baumann06/Diplomarbeit_Sicherung_Privat/Diplomarbeit/4_KiCad/Diplomarbeit/Diplomarbeit/report.txt

Aktualisiere Symbol BAT1 von "BATTERIE_AGM_Super_Cycle_100Ah:Battery_AGM_100Ah" nach "BATTERIE_AGM_Super_Cycle_100Ah:Battery_AGM_100Ah": OK
