baumann06/Diplomarbeit_Sicherung_Privat/Diplomarbeit/11_Praesentation/Energiesystem_Praesentation.pptx

☀

🔋

Energiesystem

Hybrides 12-V-PV-Energiesystem
für einen Gewächshausprototyp

Kapitel 2

Diplomarbeit · HTL Anichstraße · 5. Jahrgang

Notes: Begrüßung: Mein Name ist [Name]. Ich präsentiere Kapitel 2 meiner Diplomarbeit: das hybride 12-V-Energiesystem für unseren Gewächshausprototyp. In den nächsten 7 Minuten erkläre ich: Warum PV-Hybrid? Wie haben wir dimensioniert? Welche Komponenten und Batterietechnologien wurden gewählt? Und lohnt sich das wirtschaftlich?

## Slide 2

Systemüberblick & Energiequellenwahl

Kap. 2.1 · 2.2 · 2.2.3

Energiesystem · Kap. 2

☀ PV-Modul
180 W · 12 V

Warum PV-Hybrid?

Wärmepumpe / Biomasse / Fernwärme

Kein Strom – ungeeignet

✗

Netz-
Backup

⚡ Victron MultiPlus
12/800 (WR + Ladegerät)

MPPT

🔋 AGM Batterie
100 Ah · 12 V

~

Kleinwindanlage

Genehmigungspflichtig, standortabhängig

✗

🌿 Gewächshaus
Sensorik · Pumpen · LEDs

📡 Cerbo GX
Monitoring · MQTT

Reiner Netzbezug

Höhere Betriebskosten, keine Eigenproduktion

≈

PV-Hybridsystem ✓

Direktstrom, skalierbar, Netz-Backup im Winter

✓

Notes: Erklärung: Das System versorgt einen 0,7-m²-Gewächshausprototyp. Das PV-Modul speist über den MPPT-Laderegler in die Batterie, der MultiPlus ist Wechselrichter + Ladegerät + Netzumschalter in einem. Der Cerbo GX sammelt alle Daten via MQTT.

Warum PV-Hybrid? Alle Alternativen wurden bewertet: Wärmequellen liefern keinen Strom, Kleinwind ist genehmigungspflichtig, reiner Netzbezug ist teurer. PV erzeugt direkt Strom, ist wartungsarm und skalierbar – mit Netz-Backup für den Winter.

## Slide 3

Systemauslegung & Dimensionierung

Kap. 2.3 – Energiebedarf · PV · Batterie · Worst-Case

Energiesystem · Kap. 2

Energiebedarf

Cerbo GX + MultiPlus Standby

PV-Ertrag (saisonal)

Sommer (sonnig)

288 Wh

1350 Wh

ESP32 + Sensoren

96 Wh

Winter (sonnig)

LED-Beleuchtung (2 h)

Winter (bewölkt)

450 Wh

Heizlüfter (1 h)

120 Wh

180 Wh

Sicherheitspuffer 20 %

100 Wh

Batterie & Autonomie

1.200 Wh (100 Ah · 12 V)

176 Wh

Nennkapazität:

Gesamt: ~780 Wh/Tag (inkl. 20 % Puffer)

600 Wh

Nutzbar (50 % DoD):

~1,5 Tage (380 Wh/Tag)

Autonomie Notbetrieb:

~20 % Ladezustand (Tag 3)

Netz-Backup ab:

Notes: Der Energiebedarf von ~780 Wh/Tag inkl. 20% Puffer bildet die Dimensionierungsgrundlage.
Das 180-W-PV-Modul liefert im Sommer das 1,7-fache des Bedarfs – Batterie wird täglich vollgeladen. Im Winter (bewölkt) nur 180 Wh – Differenz aus Batterie oder Netz.
Batterie: 1.200 Wh Nennkapazität, aber max. 50% Entladetiefe → 600 Wh nutzbar. Worst-Case: 3 bewölkte Tage → Tag 3 greift Netz-Backup.

## Slide 4

Systemkomponenten & Batterietechnologien

Kap. 2.4 · 2.5 – Victron-Ökosystem · AGM vs. LiFePO₄

Energiesystem · Kap. 2

Victron-Ökosystem

MultiPlus 12/800

WR 700 W · Ladegerät 35 A · Netz-Backup

Batterietechnologie im Vergleich

⚡

Kriterium

Zyklen

AGM

500–600

Gel

700–800

LiFePO₄

≥ 4.000 ✓

MPPT 100/20

Wirkungsgrad 98 % · 30 % Mehrertrag vs. PWM

☀

Nutzb. Kap.

55 %

65 %

100 % ✓

Lebensdauer

~5 Jahre

~5 Jahre

>10 Jahre ✓

SmartShunt 500 A

SoC-Berechnung · ±0,4 % Genauigkeit

📊

Laden <0 °C

Ja ✓

Ja ✓

Nein ✗

Cerbo GX + GX Touch 50

MQTT · VRM-Portal · VE.Bus/VE.Direct

Outdoor

Ja ✓

Ja ✓

LT-Serie nötig

📡

BMS nötig

Kosten

Nein ✓

Niedrig ✓

Nein ✓

Mittel

Ja (integr.)

Hoch

Orion 12/12-9 DC/DC

Galv. Trennung · Sensorikversorgung

🔄

→ AGM gewählt: ganzjährig outdoor-tauglich, ladbar bei Frost,
hochstromfähig, kein BMS – optimal für Schaltschrank im Freien.

Notes: Alle Kernkomponenten wurden vom Projektsponsor bereitgestellt – daher Victron-Ökosystem. Alle kommunizieren über VE.Direct/VE.Bus mit dem Cerbo GX → MQTT an die App.

Batterieentscheidung: LiFePO4 wäre langfristig wirtschaftlicher (4000+ Zyklen, 100% nutzbar), aber darf unter 0°C nicht geladen werden – ohne Heizlösung nicht outdoor-tauglich. AGM funktioniert bis -20°C, ist hochstromfähig für MultiPlus-Anlauf, wartungsfrei und ohne BMS.

## Slide 5

Wirtschaftliche Analyse

Kap. 2.6 – ROI · Amortisation · Systemvergleich

Energiesystem · Kap. 2

~21,5 %

ROI
(Return on Investment)

~4,6 J.

Amortisationszeit
(Hybridsystem)

4.800 €

Investition
(2 kWp · 10 m² Dach)

1.033 €

Jährl. Einsparung
(0,25 €/kWh · 4.132 kWh)

Systemvergleich: Insellösung vs. Hybrid vs. Netzeinspeisung

Kriterium

Insellösung

Hybridsystem ✓

Netzeinspeisung

Investition

Jährl. Einsparung

4.000–5.600 €

~1.033 €

4.000–5.600 €

~1.033 €

2.000–3.600 €

250–455 €

Amortisationszeit

~4,6 Jahre

~4,6 Jahre

11–19 Jahre

Winterbetrieb

Eingeschränkt ✗

Gesichert ✓

Gesichert ✓

LCOE (Erzeugungskosten)

—

0,08–0,12 €/kWh

Einspeisung 6 ct/kWh

Notes: Fallbeispiel: 10 m² Dach, 2 kWp, Tirol.
4.800 € Investition → 4.132 kWh/Jahr → 1.033 € Einsparung bei 0,25 €/kWh → ROI 21,5 %, Amortisation 4,6 Jahre.
LCOE 0,08–0,12 €/kWh vs. 0,25 €/kWh Netzbezug – klarer Vorteil.
Hybridsystem ist optimal: gleiche Amortisation wie Insellösung, aber gesicherter Winterbetrieb. Netzeinspeisung lohnt sich kaum (6 ct/kWh Vergütung vs. 25 ct/kWh Eigenverbrauch).

## Slide 6

Elektrische Planung & Ausblick

Kap. 2.7 · 2.8 – Systemaufbau · Energiepfad · Optimierungspotenzial

Energiesystem · Kap. 2

Energiepfad & Systemstruktur

Erreichte Ziele

PV-Panel
180 W · MC4

Netz 230V AC
(Backup)

✓

Systemauslegung & Dimensionierung vollständig

✓

✓

Alle Komponenten ausgewählt & begründet

Wirtschaftlichkeitsanalyse: ROI 21,5 %, Amor. 4,6 J.

Verteilerschrank
(MultiPlus · AGM · MPPT · SmartShunt · Cerbo GX · Orion)

✓

Verteilerschrank fertiggestellt & betriebsbereit

✓

Elektrische Planung (Schaltplan mit KiCad 9.0)

Gewächshaus 12V DC
(Sensoren · Pumpen · LEDs · Heizlüfter)

MQTT
VRM-Portal

⚠ Testbetrieb nicht möglich (Lieferverzögerungen bis 14.03.2025) → Werte auf Basis von Berechnungen & Datenblättern.

Optimierungspotenzial & Ausblick

── DC/PV ╌╌ Netz/Daten

Verkabelung: 6 mm² (Hochstrom) · 1,5 mm² (230V) · Sicherung 30 A

→ Inbetriebnahme & Messung unter realen Bedingungen

→ Skalierung auf 24 V / 48 V-System bei größeren Anlagen

→ Kombination mit Kleinwind an windreichen Standorten

→ MQTT-gestützte intelligente Lastpriorisierung (App)

Notes: Systemaufbau: PV über MPPT in Schrank, Netz als Backup über MultiPlus. Cerbo GX sendet Daten per MQTT. Hochstrom: 6mm², 230V: 1,5mm², abgesichert mit 30A.

Erreichte Ziele: Planung, Auslegung, Wirtschaftlichkeit vollständig. Schaltschrank betriebsbereit. Leider kein Testbetrieb möglich – Lieferverzögerungen (Batterie beschädigt, Sponsorkomponenten verzögert).

Ausblick: Validierung unter realen Bedingungen, Skalierung, optional Kleinwind, intelligente Laststeuerung via MQTT.
