baumann06/Diplomarbeit_Sicherung_Privat/Diplomarbeit/8_Zeichnungen/Verkabelung.docx

Verbindung | Querschnitt | Von | Nach | Max. Spannung | Max. Strom
Batterie Plus → Sicherung | 16 mm² | Batterie BAT_PLUS | Hauptsicherung | 12V DC | 66A (35A MultiPlus + 20A MPPT + 11A Orion + 0,3A Cerbo)
Sicherung → Sammelschiene | 16 mm² | Hauptsicherung | Plus-Sammelschiene | 12V DC | 66A
Batterie Minus → Shunt | 16 mm² | Batterie BAT_MINUS | SmartShunt BAT_MINUS_IN | 12V DC | 66A
Shunt → Sammelschiene | 16 mm² | SmartShunt BAT_MINUS_OUT | Minus-Sammelschiene | 12V DC | 66A
Sammelschiene → MultiPlus Plus | 16 mm² | Plus-Sammelschiene | MultiPlus BAT_PLUS | 12V DC | 35A (max. Ladestrom MultiPlus 12/800)
Sammelschiene → MultiPlus Minus | 16 mm² | Minus-Sammelschiene | MultiPlus GND | 12V DC | 35A
PV-Panel → MPPT | 6 mm² | PV-Panel | MPPT PV_PLUS / PV_MINUS | 22V DC (Voc) | 9,43A (Isc)
MPPT → Sammelschiene Plus | 6 mm² | MPPT BAT_PLUS | Plus-Sammelschiene | 14,6V DC | 20A (max. Ladestrom MPPT 100/20)
MPPT → Sammelschiene Minus | 6 mm² | MPPT GND | Minus-Sammelschiene | 14,6V DC | 20A
Sammelschiene → Orion Eingang Plus | 6 mm² | Plus-Sammelschiene | Orion 12V_IN | 12V DC | 11A
Sammelschiene → Orion Eingang Minus | 6 mm² | Minus-Sammelschiene | Orion GND_IN | 12V DC | 11A
Orion Ausgang → Verbraucher | 2,5 mm² | Orion 12V_OUT | Verbraucher / ESP32 | 12V DC galv. getrennt | 9A
Sammelschiene → Cerbo Plus | 2,5 mm² | Plus-Sammelschiene | Cerbo GX 12V_IN | 12V DC | 0,3A
Sammelschiene → Cerbo Minus | 2,5 mm² | Minus-Sammelschiene | Cerbo GX GND_IN | 12V DC | 0,3A
Netz → MultiPlus AC_IN | 1,5 mm² 3-adrig | Netzanschluss | MultiPlus AC_IN | 230V AC | 16A

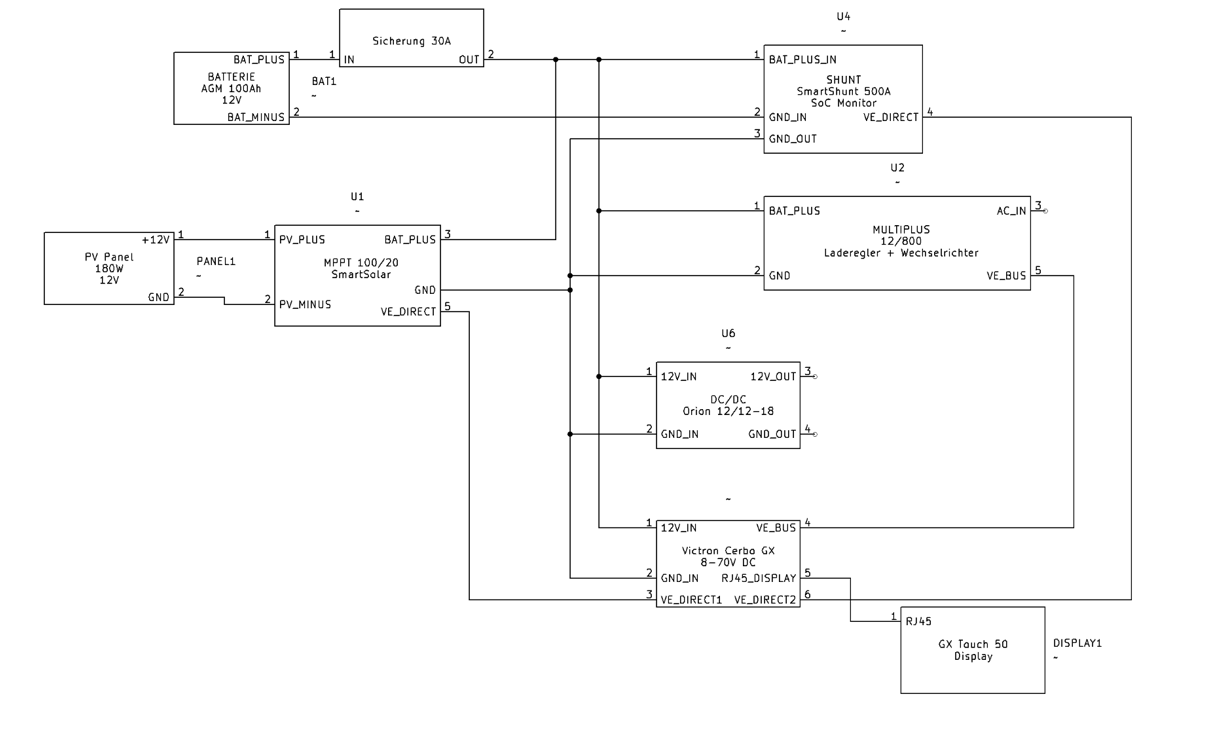
[picture p29: figure]
