baumann06/Diplomarbeit_Sicherung_Privat/Diplomarbeit/5_Schreiben/0.0.0.0.0.0_Inhaltsverzeichnis_passt_DiplomarbeitKomplett.docx

# Diplomarbeitsteil

Klima- und Bodenüberwachung, KI-Bildauswertung & Pflanzenkompatibilitätsberechnung

# Eidesstattliche Erklärung

Ich erkläre hiermit an Eides statt durch meine eigenhändige Unterschrift, dass ich die vorliegende Diplomarbeit selbständig verfasst und keine anderen als die angegebenen Quellen und Hilfsmittel verwendet habe. Alle Stellen, die wörtlich oder inhaltlich den angegebenen Quellen entnommen wurden, sind als solche kenntlich gemacht.

Die vorliegende Arbeit wurde bisher in gleicher oder ähnlicher Form noch nicht als Diplomarbeit eingereicht.

Innsbruck, am xx.xx.2026

# Gender-Erklärung

Aus Gründen der besseren Lesbarkeit wird in dieser Diplomarbeit die Sprachform des generischen Maskulinums angewandt und auf die zusätzliche Formulierung der weiblichen Form verzichtet. Es wird an dieser Stelle darauf hingewiesen, dass die ausschließliche Verwendung der männlichen Form explizit als geschlechtsunabhängig verstanden werden soll.

# Projektteam

# Betreuungspersonen

# Danksagung

An dieser Stelle möchten wir uns bei den Personen und Institutionen bedanken, ohne deren Hilfe diese Diplomarbeit nicht in dieser Zeit realisierbar gewesen wäre.

So gilt die größte Dankbarkeit unseren beiden Betreuungspersonen, …………………., welche uns stets bei offenen Fragen und Problemen hilfreich zur Seite standen. Diese Unterstützung war ein wesentlicher Erfolgsfaktor dieses Projektes. …….

# Kurzbeschreibung

# Abstract

# Inhaltsverzeichnis

# 4.1 Zielsetzung und Abgrenzung

Ziel dieser Arbeit ist der Aufbau und die Konfiguration eines Energie-Management-Systems für automatisierte Gewächshäuser. Der praktische Teil umfasst den Aufbau und die Inbetriebnahme eines 12 V Hybrid-Energiesystems zur elektrischen Versorgung eines 0,7 m² Prototyps. Die Auslegung und Integration der angeschlossenen Verbraucher liegt außerhalb des Untersuchungsumfangs.

Der entwickelte Prototyp dient als Demonstrations- und Testsystem für ein hybrides Energie-Management-Konzept im kleinen Maßstab. Er ermöglicht die Untersuchung von Energieflüssen, Speicherverhalten und Netzinteraktion unter realistischen Bedingungen. Der Prototyp ist bewusst als Hybridsystem ausgelegt, das bei Bedarf über den integrierten Netzanschluss des MultiPlus mit externer Energie versorgt werden kann. Dadurch wird eine ganzjährige Versorgungssicherheit auch bei ungünstigen Wetterbedingungen gewährleistet, während gleichzeitig das Zusammenspiel von Photovoltaik, Batterie und Netz demonstriert wird.

Parallel dazu erfolgt die Betrachtung der Skalierbarkeit des Konzepts auf größere landwirtschaftliche Anwendungen. Die Arbeit untersucht, welche Komponenten und Systemparameter bei der Übertragung auf größere Gewächshäuser angepasst werden müssen und vergleicht unterschiedliche Systemarchitekturen hinsichtlich ihrer Wirtschaftlichkeit. Die Wirtschaftsanalyse umfasst den Vergleich von Inselsystemen, Hybridsystemen und reinem Netzbezug sowie die Bewertung verschiedener Batterietechnologien über deren Lebensdauer.

Der Fokus liegt auf folgenden Bereichen:

- Dimensionierung und Auswahl der energiebezogenen Komponenten für den Prototyp
- Integration und Konfiguration eines Energie-Monitoringsystems mit hardwareseitigem Lastmanagement
- Wirtschaftsanalyse verschiedener Energieversorgungskonzepte
- Bewertung verschiedener Batterietechnologien hinsichtlich Lebensdauer und Wirtschaftlichkeit
- Betrachtung der Skalierbarkeit auf größere Anwendungen

Abgrenzung: Die Entwicklung der einzelnen Verbraucher (Sensoren, Bewässerung, Klimasteuerung) und der Aufbau des Gewächshauses sowie die Entwicklung von Benutzeroberflächen und Anwendungen sind nicht Bestandteil dieser Arbeit. Die Arbeit beschränkt sich auf die Bereitstellung elektrischer Energie sowie auf die Konfiguration des Energie-Monitorings. Der Cerbo GX erfasst energierelevante Messdaten und stellt diese über eine MQTT-Schnittstelle zur Verfügung. Die Weiterverarbeitung dieser Daten zur softwareseitigen Laststeuerung liegt außerhalb des Untersuchungsumfangs. Der Prototyp dient in erster Linie der Erprobung des Energie-Management-Konzepts und ist nicht auf vollständige energetische Autarkie aller angeschlossenen Verbraucher im Dauerbetrieb ausgelegt.

Im Vergleich zur ursprünglich eingereichten Aufgabenstellung, die eine rein autarke Insellösung vorsah, wurde im Zuge der Planung ein Hybridsystem mit Netzanschluss gewählt. Der Grund dafür war, dass eine reine Insellösung bei mehreren aufeinanderfolgenden bewölkten Tagen im Winter nicht ausreichend Energie liefern kann, wie die Worst-Case-Betrachtung in Kapitel 4.3.3 zeigt. Das Hybridsystem stellt daher keine Abkehr vom ursprünglichen Ziel dar, sondern eine sinnvolle Anpassung auf Basis der Erkenntnisse aus der Systemplanung.

## 4.1.1 Anforderungen an das Energiesystem

Das Energiesystem muss mehrere zentrale Anforderungen erfüllen, die sich aus dem Einsatzzweck und den Betriebsbedingungen ergeben.

Versorgungssicherheit: Das System muss ganzjährig zuverlässig arbeiten, auch bei schlechten Wetterbedingungen im Winter. Ein Ausfall kann zu Datenverlust, eingeschränkter Systemfunktionalität und im Extremfall zu Schäden an den Pflanzen führen. Die Versorgungssicherheit wird durch die hybride Systemarchitektur mit Netzanschluss als Backup gewährleistet.

Skalierbarkeit: Die Lösung muss vom Prototyp auf größere Anwendungen übertragbar sein. Dabei sind sowohl technische Aspekte wie Systemspannung und Komponenten als auch wirtschaftliche Faktoren zu berücksichtigen.

Hardwareseitiges Lastmanagement: Der Victron MultiPlus verfügt über ein integriertes Lastmanagement, das bei niedrigem Batteriestand nicht priorisierte Verbraucher automatisch abschaltet, während kritische Systemfunktionen weiterhin versorgt werden. Dies verhindert Tiefentladung und verlängert die Laufzeit wichtiger Systeme. Die Konfiguration der Abschaltschwellen erfolgt im Rahmen dieser Arbeit.

Monitoring und Fernüberwachung: Der Zustand des Energiesystems (Batterieladung, PV-Leistung, Verbrauch) muss jederzeit erfasst werden können. Historische Daten ermöglichen die Analyse und Optimierung des Systems.

Wirtschaftlichkeit: Die Systemarchitektur muss wirtschaftlich vertretbar sein. Dabei spielen Investitionskosten, Betriebskosten, Amortisationszeit und bei Hybridsystemen auch Einspeisevergütungen eine Rolle. Ein überdimensioniertes System ist technisch sicher, aber unwirtschaftlich.

# 4.2 Grundlagen photovoltaischer Energieversorgung

In diesem Kapitel werden die Grundlagen der photovoltaischen Energieversorgung erläutert. Der Fokus liegt dabei auf dem Betriebsverhalten von PV-Modulen sowie auf äußeren Einflüssen wie Wetter und Jahreszeit.

## 4.2.1 Kennlinien und Maximum Power Point Tracking

Hier sehen Sie ein Strom-Spannungsdiagramm und Darstellung des Solarmoduls als Diodenkennlinie

Zur Beschreibung des elektrischen Betriebsverhaltens von Photovoltaik-Modulen werden Strom-Spannungs-Kennlinien (I-U-Kennlinien) herangezogen. Sie stellen den Zusammenhang zwischen Spannung, Strom und der daraus resultierenden Leistung dar.

Abbildung 1: I-U- und P-U-Kennlinie mit Kurzschlussstrom I_(SC) , Leerlaufspannung U_(OC) und Maximum Power Point (MPP).
Grafik: Uwezi, via Wikimedia Commons, keine Änderungen, Lizenz: CC BY-SA 3.0.

Dabei zeigt sich, dass es einen optimalen Arbeitspunkt gibt, an dem die erzeugte elektrische Leistung maximal ist, wie in Abbildung 1 dargestellt. Dieser Punkt wird als Maximum Power Point (MPP) bezeichnet [1].

Der MPP verändert sich kontinuierlich in Abhängigkeit von äußeren Einflüssen wie Sonneneinstrahlung, Modultemperatur und Verschattung [1]. Ein MPPT-Regler überwacht kontinuierlich die aktuelle Modulspannung und den Modulstrom und hält den Betriebspunkt des PV-Moduls stets in der Nähe des MPP [2]. Für den entwickelten Prototyp wurde auf einen separaten MPPT-Regler verzichtet, da der Fokus auf der Demonstration des Energie-Management-Konzepts liegt und der Mehrertrag im kleinen Maßstab wirtschaftlich nicht ins Gewicht fällt. Bei einer Skalierung auf größere Anlagen wäre der Einsatz eines MPPT-Reglers jedoch klar empfehlenswert, um den Solarertrag – insbesondere in den ertragsarmen Wintermonaten – zu maximieren.

## 4.2.2 Einfluss von Wetter und Jahreszeit

Die Energieerzeugung einer Photovoltaikanlage ist stark von der Jahreszeit und den lokalen Wetterbedingungen abhängig. Im Sommer sind die Sonnenscheindauer und die Einstrahlungsintensität höher, während im Winter die Tage kürzer sind und die Sonnenstrahlung flacher auf die Module trifft. So beträgt die mittlere Globalstrahlung in Deutschland im Juni 200 kWh/m², im Dezember hingegen nur 16 kWh/m², was etwa 8 % der Sommerstrahlung entspricht [3][4]. Die Werte für Österreich sind vergleichbar und bestätigen die saisonale Schwankung.

Wetterbedingungen wirken sich zusätzlich auf die Leistung aus. Bei bedecktem Himmel sinkt die Einstrahlungsstärke erheblich. Das verwendete enjoysolar 180 W-Modul erreicht bei Standard-Testbedingungen (1.000 W/m², 25 °C) seine Nennleistung, bei geringerer Einstrahlung reduziert sich die Ausgangsleistung proportional. Unter starker Bewölkung mit etwa 200 W/m² Globalstrahlung liefert das Modul nur noch 20–40 W. Schnee auf den Modulen kann die Leistung weiter reduzieren, wobei geringe Schneemengen aufgrund der selbstreinigenden Eigenschaft der Module meist keine große Beeinträchtigung darstellen [5][6].

Ein weiterer Einflussfaktor ist die Modultemperatur. Kristalline Siliziumzellen weisen einen negativen Temperaturkoeffizienten auf. Das enjoysolar 180 W-Modul hat einen Temperaturkoeffizienten von -0,45 %/°C. Hohe Sommertemperaturen über 60 °C können die Leistung um 10–15 % gegenüber den Standard-Testbedingungen reduzieren, während kalte Wintertemperaturen die Effizienz leicht erhöhen [5][6].

Für die Auslegung einer Photovoltaikanlage ist daher insbesondere der Winter-Worst-Case entscheidend. Die Planung muss kurze Tage, geringe Einstrahlung und mehrere bewölkte Tage berücksichtigen, um eine zuverlässige Energieversorgung sicherzustellen.

# 4.3 Systemauslegung und Dimensionierung

Die Systemauslegung und Dimensionierung erfolgt auf Basis des ermittelten Energiebedarfs, der verfügbaren Solarleistung sowie der Batteriekapazität. Der Prototyp dient in erster Linie der Demonstration des Energie-Management-Konzepts und ist als Hybridsystem ausgelegt, das bei Bedarf über den integrierten Netzanschluss des MultiPlus mit externer Energie versorgt werden kann.

## 4.3.1 Ermittlung des Energiebedarfs

Die Dimensionierung des Energiesystems basiert auf der Erfassung aller angeschlossenen Verbraucher und deren Leistungsaufnahme. Da der Prototyp als Demonstrationssystem konzipiert ist, werden nicht alle Verbraucher dauerhaft betrieben. Stattdessen erfolgt eine Unterscheidung zwischen kontinuierlich aktiven Komponenten und variablen Verbrauchern, die nur zeitweise in Betrieb sind.

Kontinuierlich aktive Komponenten:

- Victron Cerbo GX mit GX Touch 50: 3–5 W [7]
- Victron SmartShunt 500 A: < 0,1 W [8]
- Victron MultiPlus Standby: 8 W [9]
- ESP32 Mikrocontroller und Sensoren: ca. 3–5 W

Der kontinuierliche Grundverbrauch beträgt somit etwa 14–18 W, was einem Tagesverbrauch von ca. 336–432 Wh entspricht.

Variable Verbraucher:

- Bewässerungspumpen: 3× ca. 0,6 W, jeweils 10–15 Minuten täglich
- Heizlüfter: 100 W, nur bei Bedarf (ca. 1–2 h/Tag im Winter)
- LEDs: 60 W, nur während aktiver Nutzung (ca. 2–4 h/Tag)
- Linearmotor (Lüftungssteuerung): 1,5 W, temperaturabhängig

Bei einem typischen Betrieb mit 2 Stunden LED-Beleuchtung und 1 Stunde Heizlüfter ergibt sich ein zusätzlicher Verbrauch von ca. 220 Wh pro Tag. Der Gesamtenergiebedarf liegt somit bei etwa 556–652 Wh/Tag.

Für die Auslegung wird mit einem Sicherheitspuffer von 20 % gerechnet, was einem Energiebedarf von ca. 780 Wh/Tag ergibt.

## 4.3.2 Berechnung der PV-Leistung und Batteriekapazität

PV-Dimensionierung:

Die Auslegung des PV-Moduls berücksichtigt insbesondere die Winterbedingungen in Innsbruck, mit einer durchschnittlichen Sonneneinstrahlung von 1–1,5 kWh/m²/Tag im Dezember. Unter Berücksichtigung des Modulwirkungsgrads von 22 % und Verlusten durch Laderegler, Kabel und suboptimale Ausrichtung werden im Winter 2–3 Volllaststunden angenommen [5].

Das 180 W enjoysolar-Modul liefert unter diesen Bedingungen:

- Sommer (beste Bedingungen): 180 W × 6 h = 1080 Wh/Tag
- Winter sonnig: 180 W × 2,5 h = 450 Wh/Tag
- Winter bewölkt: 180 W × 1 h = 180 Wh/Tag

Im Sommer wird deutlich mehr Energie produziert als verbraucht, was die Batterie vollständig lädt. Im Winter reicht die Energieerzeugung an sonnigen Tagen für den kontinuierlichen Grundverbrauch, während bei bewölktem Wetter die Differenz aus der Batterie entnommen werden muss oder über den Netzanschluss ausgeglichen wird.

Batterie-Dimensionierung:

Die 12 V AGM Super Cycle Batterie mit 100 Ah verfügt über eine Nennkapazität von 1200 Wh (100 Ah × 12 V) [10]. Zur Verlängerung der Lebensdauer wird die Entladung auf maximal 50 % begrenzt, wodurch eine nutzbare Kapazität von 600 Wh verbleibt [11]. Bei einem Tagesbedarf von 780 Wh kann die Batterie theoretisch etwa 0,75 Tage ohne PV-Ertrag überbrücken. In der Praxis greift bei kritischem Ladezustand das Lastmanagement, das nicht essenzielle Verbraucher automatisch abschaltet.

## 4.3.3 Autonomiezeit und Worst-Case-Betrachtung

Die Autonomiezeit beschreibt, wie lange das System ohne PV-Ertrag und ohne Netzanschluss weiterlaufen kann. Bei voller Batterie und reduziertem Betrieb nur der kritischen Komponenten (ca. 380 Wh/Tag) ergibt sich eine Autonomiezeit von ca. 1,5 Tagen.

Worst-Case-Szenario Winter:

Drei aufeinanderfolgende bewölkte Tage im Dezember mit je 180 Wh PV-Ertrag bei 650 Wh (ohne Sicherheitspuffer) Verbrauch führen zu einem täglichen Defizit von 470 Wh. Das Lastmanagement greift:

- Tag 1: Batterie 100 % → 60 % (normaler Betrieb)
- Tag 2: Batterie 60 % → 20 % (nur Monitoring und Steuerung)
- Tag 3: Netzanschluss erforderlich

Im reduzierten Notbetrieb übersteht das System also etwa 1,5 Tage ohne PV-Ertrag, bevor bei weiterem Entladen der Netzanschluss als Backup aktiviert wird. Mehrere aufeinanderfolgende bewölkte Tage im Winter stellen das größte Risiko für die Versorgungssicherheit dar, sind jedoch statistisch selten. Bei kritischem Ladezustand kann über den integrierten Netzanschluss des MultiPlus externe Energie zugeführt werden [9]. Dadurch bleibt die Funktionsfähigkeit auch bei ungünstigen Wetterbedingungen erhalten, während gleichzeitig das Zusammenspiel von Photovoltaik, Batterie und Netz demonstriert wird.

# 4.4 Auswahl der Systemkomponenten

Die Auswahl der Komponenten erfolgte unter Berücksichtigung von Leistungsanforderungen, Systemspannung, Zuverlässigkeit im Praxisbetrieb sowie Kompatibilität innerhalb des Victron-Ökosystems. Ziel war ein wartungsarmes Energiesystem, das den Energiebedarf des Prototyps aus der Photovoltaikanlage deckt und bei Bedarf zusätzlich über einen Netzanschluss geladen werden kann. Dadurch wird auch bei geringer Energieerzeugung, insbesondere in den Wintermonaten, eine zuverlässige Versorgung gewährleistet. Bei der Skalierung auf größere Systeme müssen Modulanzahl, Batteriekapazität, Wechselrichterleistung und Systemspannung entsprechend angepasst werden.

## 4.4.1 PV-Modul enjoysolar 180 W 12 V

Das enjoysolar 180 W Modul wurde aufgrund seines günstigen Preis-Leistungs-Verhältnisses und der Kompatibilität mit 12 V-Systemen gewählt. Mit einer Nennleistung von 180 Wp bei einer maximalen Spannung von 19,1 V und einem maximalen Strom von 9,43 A liefert es ausreichend Energie für den Prototyp [5]. Monokristalline Zellen erreichen einen Wirkungsgrad von 22 %, was eine stabile Leistung auch bei suboptimalen Bedingungen gewährleistet. Die Abmessungen von 1480 × 670 × 35 mm und ein Gewicht von 10,9 kg ermöglichen eine sichere Montage. Der Temperaturkoeffizient von −0,44 %/K zeigt eine moderate Leistungsminderung bei hohen Temperaturen [5]. Bei der Skalierung auf größere Systeme muss die Anzahl der Module entsprechend dem Energiebedarf und der verfügbaren Montagefläche angepasst werden.

## 4.4.2 AGM Super Cycle Batterie 100 Ah

Die AGM Super Cycle Batterie kombiniert wartungsfreie, lageunabhängige AGM-Technologie mit erhöhter Zyklenfestigkeit. Mit 100 Ah bei 12 V entspricht die Gesamtkapazität 1200 Wh [10]. Zur Verlängerung der Lebensdauer wird die Entladung auf maximal 50 % begrenzt, wodurch eine nutzbare Kapazität von 600 Wh verbleibt. Die Batterie verträgt mindestens 300 Zyklen bei 100 % Entladung und mindestens 700 Zyklen bei 60 % Entladung [10]. AGM-Batterien arbeiten zuverlässig bei niedrigen Temperaturen und produzieren keine Ausgasungen. Die empfohlene Ladespannung beträgt 14,2–14,6 V für Konstantspannung und 13,5–13,8 V für Ladeerhaltung [10]. Bei größeren Systemen kann die Speicherkapazität durch Parallelschaltung zusätzlicher Batterien oder durch den Einsatz von Batterien mit höherer Kapazität erweitert werden.

## 4.4.3 Victron MultiPlus 12/800

Der MultiPlus vereint Wechselrichter und Ladegerät in einem Gerät. Mit 800 VA Dauerleistung (700 W) bei 12 V deckt er die geplanten Verbraucher des Prototyps ab [9]. Bei 40 °C sinkt die kontinuierliche Ausgangsleistung auf 650 W [9]. Der integrierte Laderegler lädt die Batterie mit bis zu 35 A [9]. Die automatische Netzumschaltung ermöglicht Versorgungssicherheit bei niedriger Batterieladung. Der Standby-Verbrauch liegt bei 8–10 W [9]. Die VE.Bus-Schnittstelle erlaubt die Kommunikation mit weiteren Victron-Geräten. Der Eingangsspannungsbereich von 9,5–17 V ermöglicht einen flexiblen Betrieb auch bei schwankenden Batteriespannungen [9]. Bei der Skalierung auf größere Systeme sollte die Wechselrichterleistung an die kombinierte Last aller Verbraucher angepasst werden, wobei bei höheren Leistungen auch eine Umstellung auf 48 V-Systeme sinnvoll sein kann, um Leitungsverluste zu minimieren.

## 4.4.4 Victron SmartShunt 500 A

Der SmartShunt misst den Batteriestrom mit ±0,4 % Genauigkeit und berechnet daraus den State of Charge (SoC) [8]. Mit einer Kapazität von bis zu 500 A erfasst er alle Ströme im System zuverlässig. Der Offset liegt bei weniger als 10 mA [8]. Über Bluetooth erfolgt die Überwachung per Smartphone, über VE.Direct werden Daten an den Cerbo GX übertragen. Die kontinuierliche SoC-Berechnung ist entscheidend für das Lastmanagement, da Steuergeräte wie der ESP32 auf diese Daten zugreifen können. Der Eigenverbrauch liegt bei unter 1 mA [8]. Die Versorgungsspannung reicht von 6,5–70 VDC, wodurch der SmartShunt auch bei der Skalierung auf 48 V-Systeme einsetzbar bleibt [8].

## 4.4.5 Victron Orion 12/12-18

Der Orion ist ein DC/DC-Wandler mit galvanischer Trennung, der das Sensorsystem mit stabilen 12 V versorgt. Die galvanische Trennung verhindert Masseschleifen und elektromagnetische Störungen. Mit 18 A Ausgangsleistung bei 40 °C steht ausreichende Reserve für die Sensorik zur Verfügung [12]. Der Eingangsspannungsbereich von 8–17 V ermöglicht einen flexiblen Betrieb [12]. Der Wirkungsgrad liegt bei 87 % [12]. Bei der Skalierung auf größere Systeme bleibt diese Komponente weitgehend unverändert, da der Strombedarf der Sensorik unabhängig von der PV-Anlagenleistung ist.

## 4.4.6 Victron Cerbo GX und GX Touch 50

Der Cerbo GX ist die zentrale Überwachungs- und Steuereinheit des Systems. Er sammelt Daten von allen Victron-Komponenten über VE.Bus und VE.Direct und stellt sie im VRM-Portal bereit [7]. Externe Geräte können über Modbus TCP auf die Systemdaten zugreifen. Der Verbrauch liegt bei 2,8 W ohne Display, mit GX Touch 50 bei 3,8 W bei 12 V [7]. Die Betriebsspannung reicht von 8–70 V DC, wodurch der Cerbo GX auch bei 48 V-Systemen einsetzbar ist [7]. Das GX Touch 50 Display (5 Zoll, 800 × 480 Pixel, IP54) zeigt Batteriespannung, SoC, PV-Leistung, Verbrauch und Warnungen an [7]. Die Bedienung erfolgt über Touch, das 2 m Kabel ermöglicht flexible Montage im Schaltschrank.

## 4.4.7 Verkabelung und Absicherung

Für Hochstromverbindungen zwischen Batterie und MultiPlus werden 6 mm² Kabel verwendet, um Leitungsverluste unter 1 % zu halten. 230 V-Verkabelung erfolgt mit dreiadrigem 1,5 mm² Kabel. MC4-Stecker am PV-Anschluss gewährleisten wetterfeste Verbindungen. Blade-Sicherungen (30 A) schützen vor Kurzschlüssen. Ringkabelschuhe M8 sichern die Verschraubung an Batterie und Victron-Geräten zuverlässig. Bei größeren Systemen müssen Kabelquerschnitte entsprechend der höheren Ströme angepasst werden, um Leitungsverluste zu minimieren.

# 4.5 Batterietechnologien im Vergleich

Die Auswahl der geeigneten Batterietechnologie hängt von verschiedenen Faktoren ab, darunter Anschaffungskosten, Lebensdauer, Gewicht, Betriebstemperaturbereich und nutzbare Kapazität. Für stationäre Anwendungen wie Gewächshäuser sind insbesondere Zyklenfestigkeit, Wartungsfreiheit und Wirtschaftlichkeit über die Lebensdauer entscheidende Kriterien. Im Folgenden werden die gängigen Batterietechnologien AGM, Gel, Lithium-Ionen und LiFePO4 hinsichtlich ihrer technischen Eigenschaften und Eignung für Energiespeichersysteme verglichen.

## 4.5.1 Technische Eigenschaften der Batterietechnologien

AGM (Absorbent Glass Mat): Bei AGM-Batterien ist der Elektrolyt in einem Glasfaservlies gebunden, wodurch sie wartungsfrei, auslaufsicher und lageunabhängig betrieben werden können [13]. Sie verfügen über einen niedrigen Innenwiderstand und sind für leistungsstarke Verbraucher geeignet. Die Zyklenfestigkeit liegt bei 500–600 Zyklen, die nutzbare Kapazität beträgt etwa 55 % der Nennkapazität [13]. AGM-Batterien arbeiten zuverlässig im Temperaturbereich von -20 bis +40 °C [13]. Das Gewicht beträgt 25–35 kg pro nutzbarer Kilowattstunde [14]. AGM Super Cycle Varianten erreichen durch spezielle Bleilegierungen mindestens 300 Zyklen bei 100 % Entladetiefe und mindestens 700 Zyklen bei 60 % Entladetiefe [10].

Gel-Batterien: Bei Gel-Batterien ist der Elektrolyt durch Zugabe von Kieselerde gelartig verdickt [13]. Sie bieten eine höhere Tiefentladefestigkeit als AGM-Batterien und erreichen 700–800 Zyklen bei 65 % nutzbarer Kapazität [13]. Gel-Batterien eignen sich besonders für moderate, kontinuierliche Lasten über längere Zeiträume und zeichnen sich durch geringe Selbstentladung aus [13]. Der Betriebstemperaturbereich liegt ebenfalls bei -20 bis +40 °C [13]. Sie sind empfindlicher gegenüber hohen Ladeströmen und erfordern präzise Ladespannungen, um irreversible Schädigungen zu vermeiden.

Lithium-Ionen: Lithium-Ionen-Batterien bieten eine hohe Energiedichte und erreichen deutlich mehr Ladezyklen als Blei-Batterien. Sie sind jedoch empfindlich gegenüber Tiefentladung und Überladung, weshalb ein Battery Management System (BMS) zwingend erforderlich ist. Verschiedene chemische Zusammensetzungen innerhalb der Lithium-Technologie führen zu unterschiedlichen Sicherheitseigenschaften. Die hier betrachtete LiFePO4-Technologie ist eine spezielle Variante mit erhöhter Sicherheit.

LiFePO4 (Lithium-Eisenphosphat): LiFePO4-Batterien sind eine spezielle Form der Lithium-Technologie mit erhöhter thermischer Stabilität und Sicherheit. Im Gegensatz zu anderen Lithium-Batterien können LiFePO4-Zellen weder brennen noch explodieren [13]. Sie erreichen mindestens 4000 Zyklen bei 80 % Entladetiefe und bieten eine nahezu hundertprozentig nutzbare Kapazität [13][14]. Das Gewicht liegt bei 8–10 kg pro nutzbarer Kilowattstunde und damit bei etwa 30 % des Gewichts von Blei-Batterien [13][14]. Der Betriebstemperaturbereich reicht von -20 bis +60 °C [13]. Ein integriertes BMS überwacht Ladung, Entladung und Sicherheitsfunktionen [13]. Die Lebensdauer liegt deutlich über 10 Jahren [14].

## 4.5.2 Vergleich und Auswahlbegründung

Technischer Vergleich:

Kriterium | AGM | Gel | LiFePO4
Nutzbare Kapazität | 55 % | 65 % | 100 %
Zyklenzahl | 500-600 | 700-800 | mind. 4000 (80 % DoD)
Gewicht (kg/kWh) | 25-35 | 25-35 | 8-10
Temperaturbereich | -20 bis +40 °C | -20 bis +40 °C | -20 bis +60 °C
BMS erforderlich | Nein | Nein | Ja (integriert)
Lebensdauer | ca. 5 Jahre | ca. 5 Jahre | über 10 Jahre
Laden bei Frost (<0 °C) | Ja (-20 bis +40 °C) | Ja (-20 bis +40 °C) | Nein (max. 0 °C)
Ganzjähriger Outdoor-Betrieb ohne Heizung | Möglich | Möglich | LT-Serie erforderlich
Betrieb mit leistungsstarken Verbrauchern | Ja | Nein (verkürzt Lebensdauer) | Ja

Tabelle 1: Technischer Vergleich von AGM, Gel und LiFePO4 Batterien

[13][14]

Die AGM Super Cycle Batterie 100 Ah wurde für den Prototyp aufgrund projektspezifischer Anforderungen ausgewählt, insbesondere für den ganzjährigen Outdoor-Betrieb ohne zusätzliche Temperaturregelung. Der im Freien montierte Schaltschrank ist Temperaturschwankungen, Feuchtigkeit und Frostperioden ausgesetzt, weshalb eine robuste und wartungsfreie Batterie erforderlich ist. AGM-Batterien können zwischen −20 °C und +40 °C betrieben werden [13]. Im Gegensatz dazu dürfen LiFePO4-Batterien unter 0 °C nicht geladen werden und erfordern für niedrigere Temperaturen spezielle Low-Temperature-Serien, die zusätzliche Kosten verursachen und die Systemkomplexität erhöhen [13]. AGM-Batterien sind auslaufsicher, gasungsfrei und rüttelfest; das in einem Glasfaservlies gebundene Elektrolyt ermöglicht zudem den Betrieb in Schräglage, was besonders bei Outdoor-Installationen mit gelegentlichen Erschütterungen durch Wartungsarbeiten von Vorteil ist [13]. Die Batterien liefern kurzfristig hohe Ströme, etwa beim Einschalten des MultiPlus oder bei gleichzeitiger Nutzung mehrerer Verbraucher, während Gel-Batterien eher für kontinuierliche moderate Lasten geeignet sind und bei hohen Spitzenströmen schneller altern [13]. AGM-Batterien benötigen kein Battery Management System (BMS), wodurch die Systemintegration vereinfacht wird, und tolerieren gelegentliche Tiefentladungen besser als Standard-AGM-Batterien [10][13]. Das höhere Gewicht von 25–35 kg/kWh gegenüber 8–10 kg/kWh bei LiFePO4 spielt im stationären Schaltschrank keine Rolle, ist jedoch bei mobilen Anwendungen oder Dachlast-Beschränkungen relevant [13][14]. Für Systeme mit geplanter Betriebsdauer über 10 Jahre und täglicher Nutzung wäre LiFePO4 aufgrund höherer Zyklenfestigkeit, 100 % nutzbarer Kapazität und längerer Lebensdauer wirtschaftlich vorteilhafter [13][14]. Zusammenfassend vereint die AGM Super Cycle Batterie die erforderliche Robustheit, Kälteresistenz, Hochstromfähigkeit und Wirtschaftlichkeit, wodurch sie für den Prototyp optimal geeignet ist und gleichzeitig die Systemkomplexität reduziert.

4.6 Integration und Konfiguration des Victron-Energy-Monitoring-Systems

Für die Überwachung des hybriden 12-V-Energiesystems wurde der Cerbo GX von Victron Energy als zentrale Monitoring-Einheit gewählt. Er verbindet den SmartShunt 500 A und den MultiPlus 12/800 über gerätespezifische Schnittstellen und stellt die erfassten Messdaten lokal sowie über das Netzwerk bereit.

## 4.6.1 Systemarchitektur und Kommunikationsschnittstellen

Die Anbindung der Systemkomponenten erfolgt über zwei gerätespezifische Schnittstellen: VE.Direct und VE.Bus.

Der SmartShunt 500 A ist über VE.Direct angebunden. Über diese Punkt-zu-Punkt-Schnittstelle werden ausschließlich Batteriedaten wie Spannung, Strom und Ladezustand an den Cerbo GX übertragen [7][15]. Der Cerbo GX verfügt über drei galvanisch isolierte VE.Direct-Anschlüsse, wobei die galvanische Isolation der störungsarmen Signalübertragung dient [7].

Der MultiPlus 12/800 ist über VE.Bus angebunden. VE.Bus ist das Protokoll, über das Wechselrichter und Ladegeräte ihre AC-Ausgänge synchronisieren und mit der Monitoring-Einheit kommunizieren [15]. Im Unterschied zu VE.Direct überträgt VE.Bus keine Batterierohwerte, sondern Gerätezustände: Wechselrichter- und Ladebetrieb, Netzstatus sowie Eingangsstrombegrenzung. Der VE.Bus-Anschluss des Cerbo GX besteht aus zwei parallel geschalteten, galvanisch isolierten RJ45-Buchsen [7].

Für die externe Datenkommunikation verfügt der Cerbo GX über einen 10/100-RJ45-Ethernet-Anschluss sowie integriertes WLAN [7]. Zur Datenbereitstellung wird MQTT genutzt, da dieses Protokoll eine einfachere Integration in die vorhandene Flutter-App ermöglicht als Modbus-TCP. Der Cerbo GX unterstützt Modbus-TCP zwar ebenfalls als standardisiertes Industrieprotokoll mit definierten Registeradressen [16], jedoch wurde es für dieses System nicht aktiviert.

## 4.6.2 Cerbo GX als zentrale Monitoring-Einheit

Der Cerbo GX erfasst kontinuierlich alle energierelevanten Messgrößen des Systems: Batteriespannung, -strom, Ladezustand, PV-Leistung, Netzbezug sowie den Betriebszustand des MultiPlus. Die Versorgungsspannung liegt im Bereich von 8 bis 70 V DC, wodurch eine direkte Einspeisung aus dem 12-V-Systembus möglich ist. Die Leistungsaufnahme beträgt 2,8 W bei 12 V ohne Display, mit dem GX Touch 50 steigt sie auf 3,8 W bzw. bis zu 4,8 W bei maximaler Helligkeit [7]. Die lokale Visualisierung erfolgt über den GX Touch 50.

## 4.6.3 Hardwareseitiges Lastmanagement im MultiPlus

Das Lastmanagement wird hardwareseitig durch den MultiPlus 12/800 realisiert. Konfiguriert wurde er mit den von Victron Energy vorgesehenen Tools VictronConnect und VE.Configure. Eingestellt wurden Unterspannungsabschaltung zum Schutz der AGM-Batterie, die batteriespezifische Ladekennlinie sowie die Eingangsstrombegrenzung des Netzanschlusses. Eine externe Steuereinheit ist für diese Schutzfunktionen nicht erforderlich.

## 4.6.4 Remote-Monitoring über das VRM-Portal

Über Ethernet oder WLAN ist der Cerbo GX mit dem VRM-Portal von Victron Energy verbunden. Das Portal speichert historische Systemdaten und ermöglicht die Fernüberwachung.

# 4.7 Wirtschaftliche Analyse

In diesem Kapitel wird untersucht, ob und wie schnell sich eine Investition in ein PV-basiertes Energiesystem für Gewächshausanwendungen wirtschaftlich rechnet. Da der entwickelte Prototyp primär als Test- und Demonstrationssystem konzipiert wurde, ist er nicht auf wirtschaftliche Optimierung ausgelegt. Komponenten wurden nach Verfügbarkeit und Eignung für Testzwecke ausgewählt, nicht nach Kosteneffizienz. Zudem entspricht das Verhältnis von PV-Leistung zu Verbrauch nicht einem realen Anwendungsfall, wodurch Kennzahlen wie Amortisationszeit oder Return on Investment keine aussagekräftigen Ergebnisse liefern würden. Aus diesem Grund wird im Folgenden ein Fallbeispiel auf Basis eines praxisnahen Gewächshauses mit 10 m² Dachfläche verwendet, das realistische Investitions- und Betriebskosten abbildet.

## 4.7.1 ROI-Berechnung des PV-Systems

Grundlage der ROI-Berechnung (Return on Investment) sind die Investitionskosten für das Energie-Management-Modul, die jährliche Energieerzeugung sowie der aktuelle Endkundenpreis für Strom in Österreich. Die Berechnungen beziehen sich ausschließlich auf das Energie-Management-Modul, das Photovoltaikmodule, Batteriespeicher, Wechselrichter, Stromsensorik und Steuerungselektronik umfasst. Alle weiteren Systemkomponenten wie Klimaüberwachung, Bewässerung oder KI-gestützte Analyse werden separat bilanziert.

Gemäß aktuellen Branchenwerten werden für die Installation von 1 kWp Photovoltaikleistung rund 5 m² Dachfläche benötigt [17]. Für das Fallbeispiel wird vereinfachend eine nutzbare Dachfläche von 10 m² angenommen. Daraus ergibt sich eine installierbare Leistung von etwa 2 kWp [17]. Die Investitionskosten für PV-Anlagen inklusive Batteriespeicher liegen in Österreich im Jahr 2025 bei rund 2.000 bis 2.800 Euro/kWp [17], was für 2 kWp Gesamtkosten von 4.000 bis 5.600 Euro ergibt. Für die weitere Berechnung wird der Mittelwert von 4.800 Euro verwendet.

Für die Berechnung der Energieerzeugung werden die monatlichen Durchschnittswerte der Sonnenstunden pro Tag für Tirol herangezogen. Der Jahresdurchschnitt über alle Monate beträgt ca. 5,66 Sonnenstunden pro Tag [18]. Bei 2 kWp installierter Leistung ergibt sich damit eine tägliche Energieerzeugung von rund 11,3 kWh (2.000 W × 5,66 h), hochgerechnet auf ein Jahr eine Gesamtenergie von ca. 4.132 kWh (11,32 kWh × 365 Tage).

Allerdings schwankt die tatsächliche Tageserzeugung je nach Jahreszeit deutlich. Im Sommer (Juni bis August) stehen durchschnittlich rund 7,3 bis 8,0 Sonnenstunden pro Tag zur Verfügung, was einer täglichen Erzeugung von ca. 14,6 bis 16,0 kWh entspricht. Im Winter hingegen – insbesondere im Dezember – reduziert sich der Wert auf ca. 3 Sonnenstunden pro Tag [18], was einer täglichen Erzeugung von lediglich ca. 6,0 kWh entspricht. Diese saisonale Schwankung hat direkte Auswirkungen auf die Dimensionierung des Batteriespeichers und unterstreicht die Bedeutung eines Hybrid-Backups für den ganzjährigen Betrieb.

Der österreichische Endkundenstrompreis liegt bei rund 0,20 bis 0,30 Euro/kWh inklusive Netzkosten, Abgaben und Steuern [19]. Als Mittelwert wird für die Berechnung ein Preis von 0,25 Euro/kWh angesetzt. Dabei ist zu berücksichtigen, dass nicht die gesamte erzeugte Energie direkt eingespart wird – ein Teil des Stroms wird unmittelbar beim Entstehen verbraucht (Direktverbrauch), der Rest wird im Batteriespeicher zwischengespeichert. Laut Branchenerfahrungen liegt der direkte Eigenverbrauchsanteil bei typischen Anlagen bei rund 30 % [17]. Bei Gewächshausanwendungen ist dieser Anteil tendenziell höher, da der Stromverbrauch durch Sensoren, Pumpen und Steuerungssysteme überwiegend tagsüber anfällt und damit zeitlich gut mit der PV-Erzeugung übereinstimmt. Für die Berechnung wird vereinfachend angenommen, dass die gesamte erzeugte Energie entweder direkt verbraucht oder über den Batteriespeicher genutzt wird, was bei einem gut dimensionierten Inselsystem realistisch ist. Daraus ergibt sich eine jährliche Kosteneinsparung von rund 1.033 Euro (4.132 kWh × 0,25 Euro/kWh).

Der ROI berechnet sich aus dem Verhältnis zwischen dem jährlichen Nutzen und der Gesamtinvestition:

ROI = (jährlicher Nutzen / Investition) × 100 = (1.033 / 4.800) × 100 ≈ 21,5 %

Die durchschnittliche jährliche Kapitalrendite liegt damit bei ca. 21,5 %.

## 4.7.2 Amortisationsrechnung und Vergleich: Insellösung versus Netzanbindung

Die einfache Amortisationszeit ohne Berücksichtigung von Preissteigerungen beträgt:

Amortisationszeit = Investition / jährliche Einsparung = 4.800 Euro / 1.033 Euro ≈ 4,6 Jahre

Berücksichtigt man, dass die österreichischen Großhandelspreise für Strom laut Austrian Energy Agency im Februar 2026 gegenüber dem Vorjahr um rund 3,7 % gestiegen sind [19], ist davon auszugehen, dass auch die Endkundenpreise mittelfristig weiter steigen werden – wenn auch gedämpft durch stabile Netzgebühr- und Steueranteile. Steigende Endkundenpreise würden die jährliche Einsparung erhöhen und die effektive Amortisationszeit gegenüber dem berechneten Wert von 4,6 Jahren weiter verkürzen.

Kriterium | Insellösung | Hybridsystem | Netzeinspeisung
Investition (2 kWp) | 4.000–5.600 € | 4.000–5.600 € | 2.000–3.600 €
Jährl. Einsparung | ~1.033 € | ~1.033 € | 250–455 €
Amortisation | ~4,6 Jahre | ~4,6 Jahre | 11–19 Jahre
Versorgungssicherheit | Batterieabhängig | Hoch (Netz als Backup) | Vollständig
Netzgebühren | Keine | Reduziert | Ja
Winterbetrieb | Eingeschränkt | Gesichert | Gesichert
Vergütung | Eigenverbrauch | Eigenverbrauch | 2–11 ct/kWh [20]

Tabelle 2: Gegenüberstellung von Insellösung, Hybridsystem und Netzeinspeisung

Für die Wahl der geeigneten Systemarchitektur bieten sich grundsätzlich drei Varianten an: die reine Insellösung, das Hybridsystem mit Netzanschluss sowie die reine Netzanbindung mit Einspeisung. Die folgende Tabelle stellt die wesentlichen Merkmale gegenüber:

Die reine Insellösung bietet die höchste Unabhängigkeit vom Stromnetz und vermeidet Netzgebühren vollständig. Ihre Schwachstelle liegt im Winterbetrieb: Mit durchschnittlich nur 3 Sonnenstunden pro Tag im Dezember [18] und entsprechend geringer Energieerzeugung von ca. 6,0 kWh täglich kann ein nicht ausreichend dimensionierter Batteriespeicher rasch erschöpft sein. Bei einem kontinuierlichen Grundverbrauch durch Sensoren, Steuerung und Beleuchtung im Gewächshaus ist eine unterbrechungsfreie Versorgung ohne Netz-Backup nicht garantiert.

Das Hybridsystem – wie es im Rahmen dieser Arbeit entwickelt wurde – kombiniert die Vorteile beider Ansätze. Im Sommer wird der Energiebedarf vollständig durch PV und Batteriespeicher gedeckt, während im Winter der Netzanschluss des Victron MultiPlus als automatisches Backup aktiviert werden kann. Dadurch wird ganzjährige Versorgungssicherheit gewährleistet, ohne auf die wirtschaftlichen Vorteile des Eigenverbrauchs verzichten zu müssen. Die Amortisationszeit entspricht dabei jener der reinen Insellösung, da die Investitionskosten identisch sind und der Netzanschluss nur ergänzend genutzt wird.

Ein weiterer wirtschaftlicher Vorteil des Hybridsystems ergibt sich aus der Möglichkeit der Netzeinspeisung bei vollem Batteriespeicher. Besonders im Sommer – mit bis zu 8 Sonnenstunden pro Tag [18] – kann die erzeugte Energiemenge den unmittelbaren Verbrauch und die Speicherkapazität übersteigen. Energie, die weder direkt verbraucht noch gespeichert werden kann, würde in einem reinen Inselsystem verloren gehen. Im Hybridsystem hingegen kann dieser Überschuss ins öffentliche Netz eingespeist und vergütet werden. Zwar liegt die Einspeisevergütung mit durchschnittlich rund 6,05 Cent/kWh [20] deutlich unter dem angesetzten Eigenverbrauchswert von 0,25 Euro/kWh, dennoch stellt sie einen zusätzlichen Ertrag dar, der ohne Hybridsystem nicht realisierbar wäre. Die Grundlage der Amortisationsberechnung bleibt der Eigenverbrauch zu 0,25 Euro/kWh – die Einspeisung von Überschussenergie ist dabei nicht eingerechnet und würde die tatsächliche Amortisationszeit gegenüber dem berechneten Wert von 4,6 Jahren weiter verkürzen.

Die reine Netzanbindung mit Einspeisung ist wirtschaftlich am wenigsten attraktiv. Der ÖMAG-Einspeisetarif lag zuletzt bei rund 5,9 Cent/kWh, während private Anbieter zwischen 2,0 und 11,0 Cent/kWh vergüten – im Durchschnitt rund 6,05 Cent/kWh [20]. Das liegt deutlich unter dem Eigenverbrauchswert von 0,25 Euro/kWh [20]. Bei vollständiger Einspeisung würde die jährliche Vergütung lediglich 80 € (4.132 kWh × 0,02 Euro/kWh) bis 455 Euro betragen (4.132 kWh × 0,11 Euro/kWh), was die Amortisationszeit auf 11 bis 19 Jahre verlängern würde. Der Teil der erzeugten Energie, der nicht unmittelbar verbraucht werden kann, wird dabei lediglich zu den deutlich niedrigeren Einspeisesätzen vergütet und trägt damit wesentlich weniger zur Wirtschaftlichkeit bei als bei einem Eigenverbrauch zum vollen Endkundenpreis.

Für Gewächshausanwendungen ist das Hybridsystem daher die empfehlenswerteste Lösung: Es vereint die wirtschaftlichen Vorteile des Eigenverbrauchs mit der Versorgungssicherheit eines Netzanschlusses und ist damit sowohl für den Sommer- als auch für den Winterbetrieb optimal geeignet.

## 4.7.3 Betriebskosten und Wirtschaftlichkeitsbewertung

Die laufenden Betriebskosten des PV-Systems sind gering. Da PV-Anlagen grundsätzlich wartungsfrei sind und eine regelmäßige Reinigung in der Regel nicht erforderlich ist [17], beschränken sich die jährlichen Betriebskosten auf gelegentliche Sichtprüfungen sowie das Monitoring des Batteriezustands. Die Lebensdauer der PV-Module beträgt mindestens 25 Jahre, wobei Qualitätsmodelle nach dieser Zeit noch mindestens 85 % ihrer ursprünglichen Leistung erbringen [17]. Der Wechselrichter hat eine kürzere Lebensdauer von rund 10 bis 15 Jahren, weshalb ein einmaliger Austausch über die Systemlaufzeit einzuplanen ist.

Die Stromerzeugungskosten (Levelized Cost of Electricity, LCOE) liegen auf Basis der Investitionskosten von 4.800 Euro, einer angenommenen Systemlebensdauer von 10 bis 15 Jahren und einer jährlichen Energieerzeugung von 4.132 kWh bei rund 0,08 bis 0,12 Euro/kWh – deutlich unter dem aktuellen Endkundenpreis von 0,25 Euro/kWh [20]. Selbst unter Berücksichtigung eines Wechselrichtertauschs nach etwa 12 Jahren bleiben die LCOE weit unter dem Netzbezugspreis.

Zusammenfassend zeigt die Analyse, dass das Energie-Management-Modul für ein Gewächshaus mit 10 m² Dachfläche mit einer Investition von rund 4.800 Euro [17], einer jährlichen Einsparung von ca. 1.033 Euro und einer Amortisationszeit von etwa 4,6 Jahren eine wirtschaftlich solide Lösung darstellt. Das entwickelte Hybridsystem stellt dabei die optimale Systemarchitektur dar, da es Wirtschaftlichkeit und Versorgungssicherheit gleichermaßen gewährleistet. Der niedrige LCOE von 0,08 bis 0,12 Euro/kWh sowie die Unabhängigkeit von schwankenden Netzstrompreisen [19] sprechen langfristig klar für die gewählte Lösung.

# 4.8 Elektrische Planung

Zur elektrischen Planung wurden ein Systemschema (Abbildung 3) sowie ein Schaltplan (Abbildung 2) erstellt. Das Systemschema stellt den übergeordneten Energiefluss und die logische Systemstruktur dar, während der mit KiCad (Version 9.0) erstellte Schaltplan die elektrischen Verbindungen aller Komponenten dokumentiert.

## 4.8.1 Systemaufbau und Energiepfad

Abbildung 3 zeigt den Systemaufbau und die logische Struktur des Gesamtsystems. Das PV-Panel (enjoysolar 180 W, 12 V) speist über ein MC4-Kabel mit 9,43 A in den Verteilerschrank ein. Dieser bildet das Zentrum der Energieversorgung und enthält den Victron MultiPlus 12/800 als kombinierten Laderegler und Wechselrichter, die AGM-Batterie mit 100 Ah (600 Wh nutzbar), den SmartShunt 500 A zur Strommessung und SoC-Berechnung, den Victron Cerbo GX für Monitoring und Datenkommunikation, den Orion 12/12-18 DC/DC-Wandler mit galvanischer Trennung für die Sensorikversorgung sowie eine 30 A-Sicherung zum Schutz des Systems. Als Backup-Energiequelle ist ein Netzanschluss (230 V AC) integriert. Vom Verteilerschrank führt eine 12 V-Leitung mit 18 A zum Gewächshaus. Der Cerbo GX überträgt Energiedaten über MQTT an das Victron VRM-Portal (Internet).

## 4.8.2 Schaltplan

Abbildung 2 zeigt die elektrischen Verbindungen aller Komponenten. Die AGM-Batterie (BAT1) ist über eine 30 A-Sicherung (F2) mit dem MultiPlus 12/800 (U2) verbunden, der gleichzeitig das PV-Panel (PANEL1) und den Netzanschluss verarbeitet. Der SmartShunt 500 A (U4) ist im Batteriepfad angeordnet und überträgt Messdaten über VE.Direct an den Cerbo GX. Der MultiPlus kommuniziert mit dem Cerbo GX über VE.Bus. Der Orion DC/DC-Wandler (U6) versorgt die angeschlossenen Verbraucher mit einer galvanisch getrennten 12-V-Spannung. Das GX Touch 50 Display (DISPLAY1) ist über RJ45 direkt am Cerbo GX angeschlossen.


Schaltplan Verteilerschrank

Abbildung 2: Schaltplan des hybriden 12-V-Energiesystems (KiCad, eigene Darstellung)

Systemschema – Hybrides 12-V-Energiesystem


Abbildung 3: Systemschema des hybriden 12-V-Energiesystems (eigene Darstellung)

# 4.9 Zusammenfassung und Ausblick

Das Ziel dieses Teils der Diplomarbeit war der Aufbau und die Inbetriebnahme eines hybriden Energie-Management-Systems für ein automatisiertes Gewächshaus sowie die wirtschaftliche Bewertung des Konzepts. Im Folgenden werden die erreichten Ergebnisse bewertet und Potenziale für eine Weiterentwicklung aufgezeigt.

## 4.9.1 Erreichte Ziele und Erfahrungen

Die beiden zentralen Ziele dieses Projektteils konnten erfolgreich umgesetzt werden. Der Prototyp wurde vollständig aufgebaut und in Betrieb genommen. Das hybride Energiesystem bestehend aus einem 180 W Photovoltaikmodul, einem 12 V 100 Ah AGM-Akkusystem und dem Victron MultiPlus 12/800 arbeitet stabil und demonstriert das Zusammenspiel von PV-Energieerzeugung, Batteriespeicherung und Netz-Backup. Auch eine umfassende Wirtschaftlichkeitsanalyse wurde durchgeführt, die zeigt, dass das Konzept bei einer Skalierung auf 10 m² mit einer Amortisationszeit von rund 4,6 Jahren und einem ROI von etwa 21,5 % wirtschaftlich attraktiv ist.

Eine reale Umsetzung eines 10 m² Gewächshauses würde weitere Erkenntnisse liefern, insbesondere hinsichtlich der tatsächlichen Lastverteilung, des saisonalen Speicherverhaltens und Kombinationsmöglichkeiten mit anderen erneuerbaren Energieversorgungsarten. Zudem führten Kommunikationsmissverständnisse mit dem Projektsponsor im Verlauf der Arbeit zu Verzögerungen und einer notwendigen Neuausrichtung einzelner Anforderungen. Diese Erfahrung unterstreicht, wie wichtig eine frühzeitige und präzise Abstimmung der Erwartungen, Systemgrenzen und Fähigkeiten aller Projektbeteiligten ist – insbesondere bei technischen Projekten mit externen Partnern.

## 4.9.2 Optimierungspotenzial und Ausblick

Sollte ein solches System in einer realen Gewächshausanlage umgesetzt werden, ist die Standortanalyse ein entscheidender Planungsschritt. Die verfügbaren Energiequellen hängen stark von der geografischen Lage und den natürlichen Gegebenheiten ab. An windreichen Standorten kann eine Kleinwindanlage die saisonal geringere PV-Erzeugung im Winter sinnvoll ergänzen und damit die Schwachstelle der PV-Anlage ausgleichen. Bei Gewächshäusern in der Nähe von Bächen oder Flüssen könnte ein Kleinwasserkraftwerk als kontinuierliche Grundlastquelle geprüft werden, da Wasserkraft im Gegensatz zu PV- und Windenergie weitgehend wetterunabhängig ist. Ziel der Standortplanung sollte es sein, die vorhandenen natürlichen Ressourcen so zu kombinieren, dass eine möglichst hohe Versorgungssicherheit bei gleichzeitig niedrigen Erzeugungskosten erreicht wird.

Ein weiterer naheliegender Schritt ist die Skalierung des Konzepts auf größere Gewächshausanlagen. Die in dieser Arbeit durchgeführte Wirtschaftlichkeitsanalyse zeigt, dass größere Anlagen aufgrund niedrigerer spezifischer Kosten pro kWp tendenziell wirtschaftlicher sind. Bei einer Skalierung wäre jedoch nicht nur die Komponentendimensionierung anzupassen, sondern auch die Systemarchitektur neu zu bewerten – etwa hinsichtlich der Wahl zwischen 12 V, 24 V oder 48 V Systemspannung, der Anzahl der Batteriemodule sowie der Leistungsklasse des Wechselrichters. Zudem würde eine größere Anlage die softwareseitige Laststeuerung deutlich relevanter machen, da bei mehreren parallel betriebenen Verbrauchern eine intelligente Priorisierung auf Basis von Echtzeitdaten – etwa über die MQTT-Schnittstelle des Cerbo GX – erhebliches Einsparpotenzial bietet.

# 5.1 Motivation und Zielsetzung meines Moduls

Um ein optimales Pflanzenwachstum zu erreichen, sind vor allem Umweltfaktoren wie Temperatur, Luftfeuchtigkeit, Lichtintensität und Bodenfeuchtigkeit entscheidend. Bereits geringe Abweichungen können das Pflanzenwachstum hemmen oder Krankheiten begünstigen. Deshalb ist eine präzise Klima- und Bodenüberwachung ein essenzieller Bestandteil eines funktionierenden Gewächshauses - manuell ist das in der Praxis oft nur schwer zuverlässig möglich. Die Automatisierung durch Sensoren ermöglicht es hingegen, Umweltbedingungen kontinuierlich zu erfassen, auszuwerten und optimal zu regulieren.

Zusätzlich eröffnet künstliche Intelligenz völlig neue Möglichkeiten in der Pflanzenanalyse. Durch immer besser werdende Bildanalysemodelle kann die Gesundheit von Pflanzen automatisch bewertet und potenzielle Krankheiten frühzeitig erkannt werden. Solche Technologien können in Zukunft dazu beitragen, Ernteausfälle durch prädiktive Analysen frühzeitig zu verhindern und somit die Effizienz sowie Nachhaltigkeit im Pflanzenanbau deutlich zu steigern.

Ein weiterer Bestandteil meines Moduls ist der Pflanzenkompatibilitätsgenerator. Auf Basis einer eigenen Pflanzendatenbank werden Umweltanforderungen wie Licht-, Wasser- und Nährstoffbedarf miteinander verglichen und zu einem Kompatibilitätswert zusammengeführt, der die Symbiose der Pflanzen im Gewächshaus bewertet und zugleich als Datengrundlage für die Steuerungslogik der Hardware dient. Eine Technologie wie diese ist deshalb sinnvoll, da sich Pflanzen in ihren Umweltansprüchen stark unterscheiden und sich gegenseitig positiv oder negativ beeinflussen können.

## 5.1.1 Aufgabenstellung

Mein Modul konzentriert sich auf die Entwicklung des Hardwaresystems für ein intelligentes Gewächshaus sowie auf die Bereitstellung der Backend-Systeme für die KI-gestützte Pflanzenanalyse und den Pflanzenkompatibilitätsgenerator.

Die Hardware umfasst die Klima- und Bodenüberwachung mittels Sensoren wie DHT22 und kapazitiven Bodenfeuchtesensoren, die Steuerung der Mehrzonenbewässerung, adaptiver Beleuchtung, Heizlüfter und automatischer Belüftung. Die Sensordaten werden über MQTT ausgetauscht; ich verarbeite diese Daten ausschließlich zur Steuerung der Hardware und dokumentiere sie nicht direkt in der Diplomarbeit. Zusätzlich verarbeitet das System Nachrichten bei manuellen Eingriffen über MQTT, sodass die Hardware flexibel auf Nutzeraktionen reagieren kann.

Für die KI-gestützte Pflanzenanalyse stelle ich ein Backend bereit, das über ein GitHub-Repository funktioniert. Nutzer:innen laden Bilder der Pflanzen hoch, die dann automatisch von einem Workflow an GPT-4-Vision zur Auswertung weitergeleitet werden. Die Analyseergebnisse werden als JSON-Dateien gespeichert und stehen der App zur weiteren Nutzung zur Verfügung.

Der Pflanzenkompatibilitätsgenerator ist als API umgesetzt, die auf eine im Hintergrund laufende Pflanzendatenbank zugreift. Sie berechnet die optimalen Pflanzenkombinationen und liefert die entsprechenden Umweltparameter als Datengrundlage für die Steuerungslogik der Hardware. Durch diese Trennung zwischen Backend-Systemen und Hardware wird eine modulare, skalierbare Architektur geschaffen, die sowohl die Automatisierung des Gewächshauses als auch die datengestützte Entscheidungsfindung für Nutzer:innen ermöglicht.

# 5.2. Theoretische Grundlagen

## 5.2.1 Grundlagen der Pflanzenphysiologie

Das Pflanzenwachstum beruht auf komplexen physiologischen Prozessen, die stark von Umweltparametern beeinflusst werden.

Licht ist ein entscheidender Faktor, da es der Pflanze Energie liefert. Pflanzen wandeln in chemischen Reaktionen die Lichtenergie in Zuckern um [21]. Licht spaltet Wassermoleküle und bringt die Photosynthese in Gang. Erreicht die Pflanze zu wenig Licht, wird besonders das Wurzelwachstum beeinträchtigt, sodass nicht genügend Nährstoffe aufgenommen werden können [22].

Wasser sorgt für Zelldruck und ermöglicht das Lösen von Nährstoffen aus dem Boden sowie deren Transport innerhalb der Pflanze [21]. Die Wasseraufnahme über die Wurzeln ist für maximales Wachstum entscheidend. Durch Überwässerung wird Sauerstoff ausgespült, was zu Wurzelfäule führt [22].

Die Temperatur ist ein Schlüsselfaktor beim Wachstum und bei der Entwicklung einer Pflanze und mitausschlaggebend für die Ernteerträge. Die meisten biologischen Prozesse werden bei höheren Temperaturen beschleunigt. Ein schnelleres Wachstum gilt meist als Vorteil, jedoch führt die dabei auftretende übermäßige Pflanzenatmung dazu, dass weniger Energie für die Fruchtentwicklung zur Verfügung steht und die Früchte kleiner werden [23]. Die Temperatur hat einen großen Einfluss auf die Wachstumsgeschwindigkeit: Bei zu hohen Temperaturen über 30°C nimmt die Photosynthese ab, während zu niedrige Temperaturen Wachstum, Fruchtbildung und Blüte verlangsamen [22].

Die Luftfeuchtigkeit wirkt direkt auf die Transpiration: Niedrige Luftfeuchte erhöht den Wasserverlust über die Blätter, während hohe Luftfeuchte den Gasaustausch und damit den CO₂-Eintritt hemmt [21].

Abweichungen von den idealen Bedingungen führen zu reduziertem Wachstum, eingeschränkter Photosynthese, gestörtem Wasser- und Nährstofftransport oder Stressreaktionen wie der Bildung von Hitzeschockproteinen. Durch kontinuierliche Messung und gezielte Anpassung dieser Faktoren lassen sich Ertragsverluste vermeiden, Wasser- und Energieverbrauch effizient steuern und stabile Wachstumsbedingungen sicherstellen. Insbesondere in geschlossenen Anbausystemen ermöglicht die Überwachung dieser Parameter ein gleichmäßiges, gesundes Wachstum der Pflanzen unter reproduzierbaren Bedingungen.

## 5.2.2 Verwendete Sensoren

- DHT22 [24]:
  - zuverlässiger Sensor zur Ermittlung von Temperatur und Luftfeuchtigkeit
  - Temperaturbereich: -40 ℃ + 80 ℃
  - Luftfeuchtigkeitsmessbereich: 0 – 99 % RH
- BH1750 FVI [25]:
  - hochpräzise Beleuchtungsmessungen (Messbereich: 1–65535 Lux)
  - kommuniziert über eine I²C-Schnittstelle
- Kapazitives Bodenfeuchtigkeitssensor V1.2 [26]:
  - misst die Bodenfeuchtigkeit über Änderungen der elektrischen Kapazität

## 5.2.3 Aktorik in Gewächshaussystemen

- Linearmotor [27]:
  - Hub 100 mm – 15 mm/s – 50 N
  - Treiber: Motor Drive Controller Board L298N (Umpolen der Spannung zum Aus- und Einfahren)
- Heizlüfter [28]:
  - 12 V, 100 W
  - Konstantes Heizungselement mit integriertem Lüfter
- Pflanzenwachstums-LEDs [29]:
  - 12 V, 5 A
  - Rot : Blau = 5 : 1
  - Wellenlängen: Rot (625 – 660 nm), Blau (440 – 460 nm)
- 5V Tauchpumpe [30]:
  - Durchfluss: 80-120 l/h
  - Leistung: 0,4-1,5 W

## 5.2.4 Grundlagen der KI-Bildanalyse

Moderne KI-Sprachmodelle beschränken sich längst nicht mehr auf die Verarbeitung von Text. Sogenannte multimodale Modelle sind in der Lage, gleichzeitig Bild- und Textinformationen zu verarbeiten und daraus inhaltliche Schlüsse zu ziehen. Das Modell GPT-4o von OpenAI ist ein solches multimodales System: Es nimmt sowohl Text als auch Bilder als Eingabe entgegen und erzeugt darauf basierend eine textuelle Antwort. [31] [32]

Die Bildverarbeitung erfolgt dabei durch visuelle Kodierung: Das Eingabebild wird in interne Merkmalsbeschreibungen (sogenannte Feature Embeddings) überführt, die Objekte, Farben, Strukturen und räumliche Beziehungen im Bild erfassen. Diese Bildrepräsentation wird gemeinsam mit dem Textprompt in das Sprachmodell eingespeist, das anschließend eine kontextbezogene Antwort generiert. [33]

Für die Analyse von Pflanzenbildern bietet dieser Ansatz entscheidende Vorteile gegenüber klassischen Computer-Vision-Systemen: Während spezialisierte Bildklassifikationsmodelle auf das Erkennen vorab definierter Kategorien beschränkt sind und für jede neue Krankheit oder Pflanzenart eigens trainiert werden müssen, kann ein multimodales Sprachmodell flexibel auf eine breite Vielfalt an Erscheinungsbildern reagieren – ohne zusätzliches Training. Es kann Symptome wie Verfärbungen, Fleckenbildung oder Turgordruck visuell bewerten und diese Beobachtungen in strukturierte, lesbare Diagnosen übersetzen. [31]

KI-gestützte Pflanzenanalyse ist kein rein akademisches Konzept mehr. In der Praxis werden Sprachmodelle wie ChatGPT bereits eingesetzt, um Gärtnern und Hobbypflanzenhaltern Diagnosen zu Pflanzenzustand, Schädlingsbefall oder Pflegebedarf zu liefern – basierend auf einem einfachen Foto und einer kurzen Beschreibung der Situation. [31]

Ein wesentlicher praktischer Vorteil der Implementierung über die OpenAI API liegt in der serverlosen Architektur: Es muss keine eigene Modell-Infrastruktur betrieben und keine dauerhafte Rechenkapazität vorgehalten werden. Stattdessen wird pro Anfrage eine tokenbasierte Abrechnung vorgenommen, was die Lösung für ein Schulprojekt wie dieses sowohl kostengünstig als auch wartungsarm macht. [32]

Da Bilder vor der Übertragung an die API tokenisiert werden – das heißt, in diskrete Einheiten zerlegt, die das Modell verarbeiten kann – beeinflusst die Bildgröße direkt die Verarbeitungskosten und -dauer. Aus diesem Grund werden die Pflanzenbilder im System vor dem API-Aufruf auf eine maximale Auflösung von 1280 × 1280 Pixel skaliert und mit 85 % JPEG-Qualität komprimiert, um die Übertragungszeit gering zu halten, ohne dabei wesentliche visuelle Information zu verlieren. [32]

## 5.2.5 Pflanzenkompatibilität

Die Pflanzenkompatibilität beschreibt die Fähigkeit verschiedener Arten, gemeinsam in einem Anbausystem zu wachsen, ohne sich gegenseitig in Wachstum oder Vitalität zu beeinträchtigen. Sie basiert auf ähnlichen physiologischen Anforderungen sowie auf bekannten Wechselwirkungen zwischen Pflanzen.

Unterschiedliche Lichtansprüche sind problematisch, da die Lichtintensität in einem Gewächshaus meist einheitlich geregelt wird. Ein auf lichtliebende Pflanzen abgestimmtes Beleuchtungsniveau kann lichtempfindliche Arten stressen, während zu wenig Licht das Wachstum lichtbedürftiger Pflanzen einschränkt.

Auch beim Wasserbedarf kommt es zu Konkurrenz: Pflanzen mit hohem Bedarf können andere benachteiligen, während empfindliche Arten bei zu hoher Bodenfeuchte Wurzelschäden erleiden.
Abweichende Temperaturansprüche führen dazu, dass nicht alle Pflanzen gleichzeitig optimale Stoffwechselbedingungen vorfinden, was sich negativ auf Wachstum und Ertrag auswirkt.
Die Luftfeuchtigkeit beeinflusst Transpiration und Gasaustausch; ungeeignete Werte erhöhen den Wasserverlust oder hemmen die CO₂-Aufnahme.

Neben diesen physiologischen Faktoren existieren auch positive Wechselwirkungen zwischen Pflanzen. So kann Basilikum Tomaten oder Paprika vor Schädlingen schützen und deren Aroma beeinflussen, während stickstoffbindende Pflanzen wie Buschbohnen das Wachstum benachbarter Kulturen fördern. Die systematische Berücksichtigung solcher Beziehungen ermöglicht die Bildung kompatibler Pflanzengruppen, die Ressourcen effizient nutzen und stabile Erträge erzielen. In Smart-Gardening-Systemen lassen sich diese Zusammenhänge in Datenbanken abbilden und für automatisierte Pflanzempfehlungen nutzen.

# 5.3 Systemkonzept und Architektur

## 5.3.1 Hardwarearchitektur meines Moduls

Das Hardwaresystem besteht aus zwei eigenständig arbeitenden ESP32-Mikrocontrollern, die über MQTT miteinander kommunizieren. Diese Aufteilung wurde bewusst gewählt, um die Komplexität der Steuerlogik auf zwei spezialisierte Einheiten zu verteilen und gleichzeitig die Ausfallsicherheit zu erhöhen: Fällt eine Komponente aus, arbeitet die andere weiter.

ESP32 #1 – Klimasteuerung

Der erste Mikrocontroller übernimmt die Regelung der Klimaparameter Temperatur, Luftfeuchtigkeit und Licht. Er liest den DHT22-Sensor alle 30 Sekunden aus und vergleicht die Messwerte mit den hinterlegten Sollbereichen. Die Regelausgaben steuern den Linearmotor (über L298N H-Brücke, GPIO 18/19/23), den Heizlüfter (Relais, GPIO 25/26) sowie die Wachstums-LEDs (Relais, GPIO 27). Zusätzlich liest er den BH1750FVI-Lichtsensor über I²C aus (SDA/SCL).

ESP32 #2 – Bewässerungssteuerung

Der zweite Mikrocontroller ist für die Mehrzonenbewässerung zuständig. Er liest alle zehn Minuten drei kapazitive Bodenfeuchtigkeitssensoren aus (ADC-Eingänge GPIO 35/32/33) und aktiviert bei Bedarf die entsprechende Tauchpumpe (GPIO 25/26/27) für jeweils 10 Sekunden.

Beide ESP32-Einheiten sind über WLAN mit einem lokalen MQTT-Broker verbunden.

Über den Topic greenhouse/commands können manuelle Steuerbefehle aus der App (z. B. pump1, pump2, pump3) empfangen werden. Parameter wie Feuchtigkeitsgrenzen werden über greenhouse/parameters/irrigation aktualisiert. Die gemessenen Sensorwerte werden über greenhouse/sensors/... publiziert und stehen der App in Echtzeit zur Verfügung.

Die folgende Tabelle zeigt die GPIO-Zuordnung des Klimasteuerungs-ESP32:

GPIO | Bauteil | Funktion
GPIO 4 | DHT22 | Temperatur & Luftfeuchtigkeit
GPIO 18/19/23 | L298N H-Brücke | Linearmotor (Fenster)
GPIO 25 | Relais | Heizlüfter – Lüfter
GPIO 26 | Relais | Heizlüfter – Heizelement
GPIO 27 | Relais | Wachstums-LEDs
SDA/SCL | BH1750FVI | Lichtsensor (I²C)

Tabelle 3: GPIO-Zuordnung Klimasteuerung

Die folgende Tabelle zeigt die GPIO-Zuordnung des Bewässerungs-ESP32:

GPIO | Bauteil | Funktion
GPIO 35 | Bodenfeuchte-Sensor 1 | Zone 1 – Messung
GPIO 32 | Bodenfeuchte-Sensor 2 | Zone 2 – Messung
GPIO 33 | Bodenfeuchte-Sensor 3 | Zone 3 – Messung
GPIO 25 | Tauchpumpe 1 | Zone 1 – Bewässerung
GPIO 26 | Tauchpumpe 2 | Zone 2 – Bewässerung
GPIO 27 | Tauchpumpe 3 | Zone 3 – Bewässerung

Tabelle 4: GPIO-Zuordnung Bewässerungssystem

5.3.2 KI-Analysearchitektur (Cloud-basiert)

Die KI-Bildanalyse ist als vollständig cloudbasierte, serverlose Lösung umgesetzt. Sie läuft nicht auf dem ESP32 oder einem lokalen Server, sondern wird durch GitHub Actions getriggert und nutzt die OpenAI API zur eigentlichen Analyse.

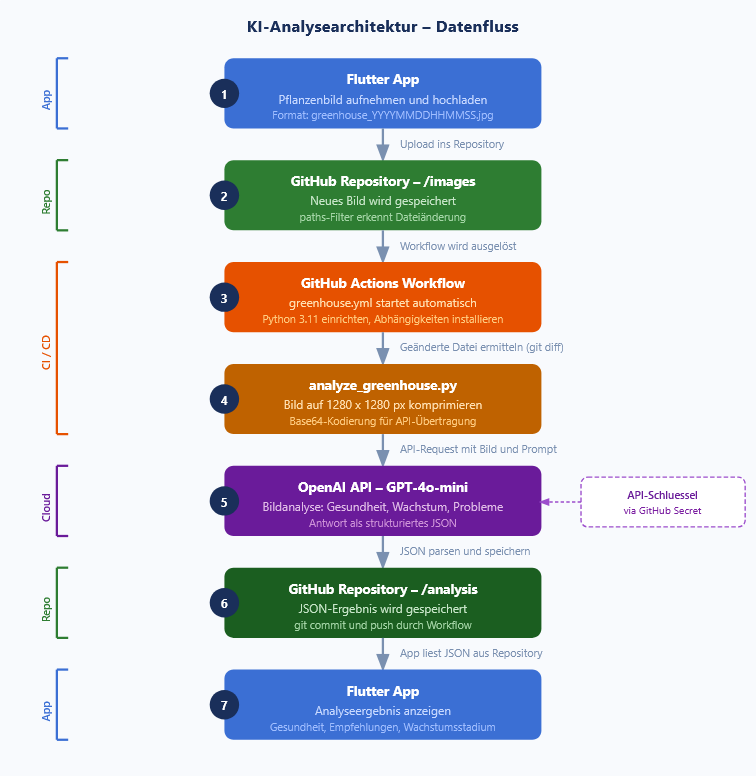
[picture p35: figure]

Abbildung 4: Datenfluss der KI-Analysearchitektur

Der Datenfluss gliedert sich in vier Schritte:

1. Die Flutter-App fotografiert eine Pflanze und lädt das Bild im Format greenhouse_YYYYMMDDHHMMSS.jpg in das GitHub-Repository (Verzeichnis /images) hoch.
2. Der GitHub Actions Workflow erkennt das neue Bild über einen paths-Filter und startet automatisch einen Runner auf Ubuntu.
3. Das Python-Skript analyze_greenhouse.py liest das Bild, komprimiert es, kodiert es Base64 und sendet es gemeinsam mit einem strukturierten Analyseauftrag an die OpenAI API (GPT-4o-mini).
4. Die Antwort der API wird als JSON-Datei (greenhouse_YYYYMMDDHHMMSS_analysis.json) im Verzeichnis /analysis gespeichert und automatisch in das Repository committed. Die App liest dieses JSON aus und zeigt die Ergebnisse an.

Der OpenAI API-Schlüssel wird ausschließlich als GitHub Secret gespeichert und ist zu keinem Zeitpunkt im Code oder im Repository sichtbar.

5.3.3 Architektur Pflanzenkompatibilitätsgenerator

Der Pflanzenkompatibilitätsgenerator ist als REST-API implementiert, die lokal auf einem Python-Backend (FastAPI) läuft und von der Flutter-App aufgerufen wird.

Die Architektur besteht aus drei Schichten:

- Datenbankschicht:

Eine SQLite-Datenbank enthält 47 Pflanzeneinträge mit ihren jeweiligen Umweltanforderungen (Temperaturbereich, Luftfeuchtigkeit, Bodenfeuchtigkeit, Lichtbedarf) sowie eine zweite Tabelle plant_compatibility, die bekannte Wechselwirkungen zwischen Pflanzenpaaren hinterlegt.

- Berechnungsschicht:

Der Kompatibilitäts-Algorithmus läuft im Backend. Er empfängt eine Liste von Pflanzen-IDs, berechnet die Überlappungsbereiche aller Umweltparameter und gibt einen gewichteten Gesamtscore samt Einzelbewertungen und konkreten Empfehlungswerten zurück.

- API-Schicht:

Die FastAPI-Endpunkte /plants (GET, liefert alle verfügbaren Pflanzen) und /analyze (POST, berechnet Kompatibilität) stellen die Schnittstelle zur Flutter-App dar.

Die berechneten Umweltparameter aus der Kompatibilitätsanalyse dienen gleichzeitig als Sollwerte für die Hardware-Steuerung: Der empfohlene Temperaturbereich, die Soll-Luftfeuchtigkeit und der Bewässerungsbereich werden über MQTT an die ESP32-Einheiten übermittelt und dort als Regelparameter verwendet.

# 5.4 Umsetzung

## 5.4.1 Hardware & Steuerung

5.4.1.1 Aufbau und Verkabelung

5.4.1.2 Stromversorgung und Relaissteuerung

5.4.1.3 MQTT-Kommunikation und Datenübertragung

## 5.4.2 KI-Analyse

#### 5.4.2.1 Grundkonzept

Die KI-gestützte Pflanzenanalyse ermöglicht eine automatisierte Bewertung des Pflanzenzustands durch visuelle Auswertung. Im Gegensatz zur rein sensorbasierten Überwachung erlaubt die Bildanalyse die direkte Beurteilung von Pflanzengesundheit, Wachstumsstadium und potenziellen Krankheiten.

Die Implementierung erfolgt vollständig serverless über GitHub Actions, wodurch keine eigene Server-Infrastruktur erforderlich ist. Das System nutzt OpenAI GPT-4o-mini – ein multimodales Sprachmodell, das sowohl Bild- als auch Textinformationen verarbeiten kann.

#### 5.4.2.2 GitHub-Workflow und Trigger

Der Analyseprozess wird durch einen GitHub Workflow (analyze_greenhouse.yml) gesteuert, der automatisch bei neuen Bilddateien im Verzeichnis /images mit dem Muster greenhouse_*.jpg ausgelöst wird.

Zeitstempel-basierte Zuordnung:

Die Flutter-App lädt Bilder im Format greenhouse_YYYYMMDDHHMMSS.jpg hoch. Der im Dateinamen eingebettete Zeitstempel dient als zentrale Verknüpfung zwischen Originalbild und Analyseergebnis. Diese Konvention ermöglicht sowohl das automatische Triggern des Workflows als auch die spätere eindeutige Zuordnung durch die App.

Ablauf:

1. Die Flutter-App lädt Pflanzenbilder direkt in das Repository-Verzeichnis „/images“ hoch (Format: greenhouse_YYYYMMDDHHMMSS.jpg)
2. Der Workflow startet automatisch durch den paths-Filter
3. Repository-Checkout mit den letzten zwei Commits (fetch-depth: 2)
4. Einrichtung der Python 3.11-Umgebung und Installation der Abhängigkeiten
5. Git-Diff-Vergleich identifiziert die neu hochgeladene Datei
6. Der OpenAI API-Schlüssel wird über GitHub Secrets bereitgestellt
7. Ausführung des Python-Skripts „analyze_greenhouse.py“

#### 5.4.2.3 OpenAI GPT-4 Vision-Analyse

Das Python-Skript „analyze_greenhouse.py“ führt die Bildanalyse durch. Um die API-Limits, wird das Bild vor der Übertragung komprimiert. Die OpenAI API akzeptiert nur Bilder bis zu einer bestimmten maximalen Dateigröße pro Request. Zur Prävention werden die Bilder deshalb auf eine maximale Auflösung von 1280×1280 Pixel skaliert und mit 85% JPEG-Qualität komprimiert. Das komprimierte Bild wird Base64-kodiert und direkt im API-Request eingebettet.

Die Promptstruktur fordert das Modell auf, drei Hauptkategorien zu bewerten:

- Pflanzenidentifikation: Für jede erkannte Pflanze werden Typ, Wachstumsstadium (0-100%), Position im Bild sowie individuelle Gesundheitsbewertungen erfasst.
- Gesundheitszustand: Eine Gesamtbewertung mit numerischem Score (0-100), kategorischer Einstufung (gut/mäßig/schlecht) sowie Listen identifizierter Probleme und konkreter Handlungsempfehlungen.
- Umgebungsbedingungen: Einschätzungen zu Bewässerungszustand, Lichtverhältnissen und weiteren visuell erkennbaren Faktoren.

Der Prompt spezifiziert explizit das erwartete JSON-Ausgabeformat, wodurch eine maschinelle Weiterverarbeitung ohne aufwändiges Parsing ermöglicht wird.

#### 5.4.2.4 Datenspeicherung

Die API-Antwort wird zunächst von etwaigen Markdown-Formatierungen bereinigt und als JSON geparst. Das Analyseergebnis wird um Metadaten ergänzt: Quellbildpfad, Analysezeitpunkt, verwendetes Modell und Token-Verbrauch. Der Zeitstempel wird aus dem Dateinamen des analysierten Bildes extrahiert, um eine präzise zeitliche Zuordnung zu gewährleisten.

Das Skript extrahiert den Zeitstempel aus dem Originaldateinamen und übernimmt ihn in das JSON-Analyseergebnis. Die JSON-Datei wird im Verzeichnis /analysis mit identischem Zeitstempel gespeichert: greenhouse_YYYYMMDDHHMMSS_analysis.json. Durch diese konsistente Namenskonvention sind Bild und Analyseergebnis jederzeit über den Zeitstempel eindeutig zuordenbar. Der Workflow committed die generierten JSON-Dateien automatisch zurück ins Repository, sodass sie persistent verfügbar und versioniert sind.

## 5.4.3 Pflanzenkompatibilitätsgenerator

### 5.4.3.1 Datenbankstruktur

Zur Auswahl der Attribute wurde auf die im System eingesetzten Sensoren und Aktoren Bezug genommen, da diese direkt steuerbar sind. Auf die Einbindung externer APIs wurde bewusst verzichtet, da derzeit keine Schnittstelle existiert, die alle benötigten Parameter zuverlässig bereitstellt. Es wäre grundsätzlich möglich gewesen, mehrere APIs miteinander zu kombinieren, dies hätte jedoch den Entwicklungsaufwand sowie die potenzielle Fehleranfälligkeit deutlich erhöht.

Die Nutzung einer eigenen Datenbank bietet zudem entscheidende Vorteile: Die Datenstruktur kann flexibel angepasst und um Werte jederzeit hinzugefügt bzw. geändert werden. Aktuell sind in der Datenbank 47 verschiedene Pflanzen gepflegt.

Zusätzlich wurde eine Tabelle plant_compability eingefügt, die insbesondere die Beziehungen zwischen den einzelnen Pflanzen abbildet und für die Berechnungen verwendet.

Die Informationen zu den Pflanzen wurden anfangs von ChatGPT generiert und im weiteren Verlauf des Projekts kontrolliert und, wenn nötig, adaptiert.

### 5.4.3.2 Algorithmus zur Kompatibilitätsbewertung

Die Kompatibilitätsberechnung basiert auf einer Überlappungsanalyse der Umweltbereiche aller ausgewählten Pflanzen. Das System ermittelt den gemeinsamen Bereich, in dem alle Pflanzen gleichzeitig ihre optimalen Wachstumsbedingungen vorfinden. Die Größe dieser Überlappung dient als Maß für die Kompatibilität der Pflanzenkombination.

Im Gegensatz zu punktbasierten Vergleichsmethoden berücksichtigt dieser Ansatz die Tatsache, dass Pflanzen Temperaturbereiche haben und nicht auf einen einzelnen Optimalwert festgelegt sind. Beispielsweise haben Tomaten einen Temperaturbereich von 18-25°C und Basilikum von 20-25°C. Der gemeinsame Überlappungsbereich von 20-25°C (5°C) zeigt eine hohe Kompatibilität an.

#### 5.4.3.2.1 Berechnungsmethodik

Schritt 1: Überlappungsbereich ermitteln

- Für jeden Umweltfaktor (Temperatur, Luftfeuchtigkeit, Bodenfeuchtigkeit) wird der gemeinsame Bereich berechnet:
- Höchste Untergrenze = Maximum aller Minimalwerte der Pflanzen
- Niedrigste Obergrenze = Minimum aller Maximalwerte der Pflanzen
- Überlappung = Niedrigste Obergrenze - Höchste Untergrenze

Beispiel mit 3 Pflanzen:

- Tomate (18-25 °C)
- Basilikum (20-25 °C)
- Paprika (22-28 °C)

Berechnung: max(18, 20, 22) = 22 °C und min(25, 25, 28) = 25 °C

→ Überlappung = 3 °C (gemeinsamer Bereich: 22-25 °C)

Schritt 2: Fallunterscheidung

Das System unterscheidet drei Fälle:

Fall A: Positive Überlappung (Überlappung > 0) – Dies ist der Idealfall mit einem gemeinsamen Bereich. Die Bewertung erfolgt basierend auf dem Verhältnis der Überlappung zur durchschnittlichen individuellen Spanne der Pflanzen.

Fall B: Punktüberlappung (Überlappung = 0) – Die Bereiche berühren sich exakt an einem Punkt. Dies wird mit einem Grundscore von 2.0 als ungünstig bewertet, da kein Spielraum für Schwankungen besteht.

Fall C: Keine Überlappung (Überlappung < 0) – Die Bereiche überlappen nicht. Der Score wird basierend auf der Lückengröße berechnet: Score = max(0.0, 5.0 - (Lücke / Durchschnittsspanne) × 5).

Schritt 3: Bewertung der Überlappung

Bei positiver Überlappung wird das Überlappungsverhältnis berechnet: Durchschnittliche Spanne = Mittelwert aller individuellen Spannen (Max - Min), Überlappungsverhältnis = Überlappung / Durchschnittliche Spanne, Grundscore = min(10.0, Überlappungsverhältnis × 12). Ein Bonus von 15% wird gewährt, wenn die Überlappung mindestens 50% der durchschnittlichen Spanne beträgt.

Schritt 4: Sigmoid-Transformation

Zur natürlicheren Bewertung wird eine S-Kurven-Transformation angewendet: Score = 10 / (1 + exp(-0.8 × (Grundscore - 6))). Diese Transformation macht kleine Unterschiede bei guten Werten weniger dramatisch, während große Probleme stärker bestraft werden.

Gesamtscore-Berechnung

Die einzelnen Umweltfaktoren werden gewichtet zusammengeführt: Temperatur 35% (wichtigster Faktor), Bodenfeuchtigkeit 30% (zweitwichtigster Faktor), Luftfeuchtigkeit 20%, Licht 15% (kategorisch: identisch = 10 Punkte, Unterschiede führen zu Abzügen).

Berechnungsformel: Gesamtscore = Temperatur×0.35 + Luftfeuchtigkeit×0.20 + Bodenfeuchtigkeit×0.30 + Licht×0.15.

Falls in der Datenbank spezifische Kompatibilitätsregeln zwischen Pflanzenpaaren existieren (z.B. Tomate + Basilikum), werden diese als sanfter Modifikator von maximal ±1 Punkt auf den Basisscore angewendet: Modifikator = Spezial-Score × 0.2.

#### 5.4.3.2.2 Score - Interpretation

- 9.0-10.0: Ausgezeichnete Kompatibilität
- 8.0-8.9: Sehr gute Kompatibilität
- 7.0-7.9: Gute Kompatibilität
- 6.0-6.9: Mäßige Kompatibilität (Kompromisse nötig)
- 4.0-5.9: Schwache Kompatibilität (problematisch)
- 0.0-3.9: Schlechte Kompatibilität (nicht empfohlen)

#### 5.4.3.2.3 Empfehlungsgenerierung

Das System generiert nach der Berechnung automatisch eine Liste konkreter Empfehlungen, die direkt in der App angezeigt werden. Dabei werden nicht nur die optimalen Sollwerte ausgegeben, sondern auch Warnungen, Qualitätsbewertungen und Hinweise zu bekannten Pflanzenwechselwirkungen.

Für jeden Umweltparameter wird abhängig vom Ergebnis der Überlappungsanalyse eine passende Meldung erzeugt – zum Beispiel "Temperatur: 22–25 °C" bei vorhandener Überlappung, oder "Warnung: Keine Temperaturüberlappung – Kompromiss bei 21.5 °C" wenn kein gemeinsamer Bereich existiert. Ergänzend dazu werden qualitative Bewertungen wie "Sehr gute Temperaturkompatibilität" (bei Überlappung ≥ 5 °C) oder "Warnung: Enge Temperaturtoleranzen" (bei Überlappung < 3 °C) hinzugefügt.

Darüber hinaus enthält die Ausgabe weitere Hinweise, die über die reine Temperaturbetrachtung hinausgehen: Die optimalen Werte für Luftfeuchtigkeit, Bodenfeuchtigkeit und Bewässerung werden als konkrete Zielwerte ausgegeben, bei problematischen Kombinationen werden zusätzliche issues als eigene Liste mitgeliefert. Wenn in der Datenbank eine bekannte Sonderbeziehung zwischen zwei Pflanzen hinterlegt ist – etwa Tomate und Basilikum – erscheint dazu eine spezifische Meldung mit dem Grund der Wechselwirkung. Die gesamte Empfehlungsliste fließt am Ende der API-Antwort als recommendations-Array zurück an die Flutter-App, die sie direkt darstellt.

# 5.5 Tests und Validierung

## 5.5.1 Hardwaretests

## 5.5.2 Funktionstest Pflanzenanalyse

## 5.5.3 Validierung des Kompatibilitätsgenerators

# 5.6 Marktanalyse bestehender Smart-Gardening-Systeme

Um das entwickelte System wirtschaftlich einzuordnen, analysiert dieses Kapitel den globalen Markt für Smart-Indoor-Gardening, die relevanten Zielgruppen sowie drei repräsentative Wettbewerber. Abschließend wird das System anhand seines Funktionsumfangs in die marktüblichen Preissegmente eingeordnet.

## 5.6.1 Marktgröße & Wachstum

Der globale Markt für Smart-Indoor-Gardening wuchs von ca. 2,21 Milliarden USD im Jahr 2024 auf geschätzte 2,33 Milliarden USD im Jahr 2025 [34], wobei diese Angaben je nach Quelle leicht variieren. Konservativere Prognosen gehen von einem Wachstum auf rund 7,3 Milliarden USD bis 2034 aus. Angetrieben wird dieser Wachstum durch zunehmende Urbanisierung, schrumpfende Außenflächen und ein wachsendes Bewusstsein für gesunde Ernährung und Selbstversorgung [35].

Europa hält dabei einen Marktanteil von rund 26 % und war 2025 mit ca. 698 Millionen USD bewertet. Bis 2034 wird ein Anstieg auf über 1,2 Milliarden USD erwartet, vor allem durch Nachhaltigkeitsregulierungen und ein steigendes Umweltbewusstsein der Konsumenten [36]. Für den deutschsprachigen Raum, in dem dieses Projekt verortet ist, ist der Markt damit besonders relevant.

Wesentliche Wachstumstreiber

Die Nachfrage nach Smart-Indoor-Gärten ist besonders unter Millennials und der Generation Z gestiegen, die nach wartungsarmen, technologiegestützten Möglichkeiten suchen, um Kräuter, Gemüse und Zierpflanzen in der Wohnung anzubauen .

Daneben spielen drei weitere Trends eine essenzielle Rolle:

Ein wesentlicher Treiber ist die Integration von IoT-Technologien, die eine Echtzeitüberwachung sowie eine komfortable Fernsteuerung ermöglichen. Gleichzeitig wächst bei vielen Konsumentinnen und Konsumenten der Wunsch nach pestizidfreien Lebensmitteln aus eigenem Anbau. Außerdem trägt die Einbindung von KI-gestützter Pflanzenüberwachung dazu bei, den Markt technologisch weiterzuentwickeln und zusätzliche Mehrwerte zu schaffen.

Der Einbau von Sensoren in Indoor-Gartengeräten stieg zwischen 2021 und 2025 von 46 % auf 71 %, was zeigt, wie schnell sich technologische Lösungen in diesem Segment durchsetzen und integrieren [36].

## 5.6.2 Zielgruppen

Der Markt lässt sich in vier Segmente unterteilen [35]:

Haushalte, Gastronomie & Hotellerie, Bildungseinrichtungen sowie Unternehmen & Büroumgebungen. Das primäre Zielsegment für das entwickelte System ist dabei das Haushaltssegment.

Das Haushaltssegment hält mit rund 58 % den größten Marktanteil, dominiert von Stadtbewohnern, Wohnungsnutzern und gesundheitsbewussten Konsumenten [35]. Besonders beliebt sind dabei „Plug-and-Play"-Systeme, die minimalen Einrichtungsaufwand erfordern und garantierte Wachstumsergebnisse liefern [35]. Innerhalb dieses Segments zeigen besonders Millennials ein überdurchschnittliches Interesse – rund 64 % gaben an, Interesse an Indoor-Lebensmittelproduktionssystemen zu haben, und knapp 37 % investierten zwischen 2023 und 2024 in entsprechende Geräte [36].

## 5.6.3 Marktführer

Click & Grow – Marktführer im Einstiegssegment

Click & Grow ist eines der bekanntesten Indoor-Gardening-Systeme weltweit und richtet sich vor allem an Privatkunden ohne gärtnerische Vorkenntnisse. Die Produktlinie Smart Garden 3, 9 und 27 bietet einfache Plug-and-Play-Lösungen für den Heimbereich. Der Fokus liegt auf Benutzerfreundlichkeit und ansprechendem Design, nicht auf technischer Tiefe. Das System verfügt weder über echte Sensorik noch über eine App-gesteuerte Überwachung; die Bewässerung erfolgt passiv über einen Wassertank, die Beleuchtung wird über einen einfachen Timer gesteuert [37].

Merkmal | Click & Grow | Unser System
Konzept | Passives Indoor-Gardening, Plug & Play | Modulares Gewächshaus, ESP32-Steuerung, Solar + Akku
Sensorik | Keine – nur optionaler Wassertankanzeige | Temperatur, Luftfeuchtigkeit, Bodenfeuchte, Licht
Aktoren | LED-Wachstumslicht (Timer), passiver Wassertank | Heizlüfter, Belüftung, Mehrzonenbewässerung, LED
KI | Keine KI-Integration | GPT-4 Vision Bildanalyse + Kompatibilitätsgenerator
Energie | Netzstrom (Steckdose) | Autark: Solar + Akku (kein Netzstrom nötig)
Preisniveau | 100 - 250 € | Noch nicht festgelegt (Prototyp)

Tabelle 5: Systemvergleich zwischen Click & Grow und dem entwickelten Gewächshaussystem

Gardyn – Technologisch fortgeschrittenes Mittelsegment

Gardyn positioniert sich als KI-gestütztes Hydroponik-System für technikaffine Stadtbewohner. Das vertikale Anbausystem fasst bis zu 30 Pflanzkapseln und ist mit Kameras sowie Cloud-KI (dem sogenannten "Kelby"-Assistenten) ausgestattet, die Bewässerung und Beleuchtung anhand von Sensordaten und Bildanalyse automatisch anpasst. Trotz dieser technologischen Stärken fehlen Klimareglung sowie eine Steuerung von Temperatur und Luftfeuchtigkeit. Das System ist ausschließlich für Hydroponik ausgelegt und benötigt dauerhaft Netzstrom. [38]

Merkmal | Gardyn | Unser System
Konzept | vertikales Hydroponik-Turmkonzept | Modulares Gewächshaus, ESP32-Steuerung, Solar + Akku
Sensorik | Kameras, Wasserstand, Licht | Temperatur, Luftfeuchtigkeit, Bodenfeuchte, Licht
Aktoren | LED-Beleuchtung, Pumpensteuerung | Heizlüfter, Belüftung, Mehrzonenbewässerung, LED
KI | Cloudbasierte Bildanalyse (Kelby-Assistent) | GPT-4 Vision Bildanalyse + Kompatibilitätsgenerator
Energie | Netzstrom (Steckdose) | Autark: Solar + Akku (kein Netzstrom nötig)
Preisniveau | 500 - 1000 € | Noch nicht festgelegt (Prototyp)

Tabelle 6: Systemvergleich zwischen Gardyn und dem entwickelten Gewächshaussystem

Vivosun – Semi-Profi-Segment

Vivosun richtet sich an erfahrene Anwenderinnen und Anwender im Semi-Profi- und Hobbybereich. Das System ist als offene Growbox-Plattform konzipiert, bei der Nutzer Lüfter, Lampen und Pumpen manuell oder per App steuern. Obwohl einzelne Sensoren für Temperatur, Luftfeuchtigkeit und CO₂ optional integrierbar sind, fehlt eine automatisierte Steuerlogik, die auf diese Messwerte reagiert. Eine KI-Integration ist nicht vorhanden. Das System ist modular aufgebaut, aber komplex in der Einrichtung. [39]

Merkmal | Vivosun | Unser System
Konzept | Offene Growbox-Plattform für Semi-Profis | Modulares Gewächshaus, ESP32-Steuerung, Solar + Akku
Sensorik | Temperatur, Luftfeuchte, CO₂ (optional) | Temperatur, Luftfeuchtigkeit, Bodenfeuchte, Licht
Aktoren | Lüfter, Lampen, Pumpen (manuell/App) | Heizlüfter, Belüftung, Mehrzonenbewässerung, LED
KI | Keine KI – manuell oder App-gesteuert | GPT-4 Vision Bildanalyse + Kompatibilitätsgenerator
Energie | Netzstrom (Steckdose) | Autark: Solar + Akku (kein Netzstrom nötig)
Preisniveau | 200 - 1200 € | Noch nicht festgelegt (Prototyp)

Tabelle 7: Systemvergleich zwischen Vivosun und dem entwickelten Gewächshaussystem

## 5.6.4 Markttrends & Positionierung

Der Markt für Smart-Indoor-Gardening befindet sich aktuell in einer Phase starken technologischen Wandels. Neue Entwicklungen im Bereich IoT, künstliche Intelligenz und eingebettete Systeme ermöglichen immer intelligentere und stärker automatisierte Lösungen [35]. Für das entwickelte System ergeben sich daraus zentrale Trends, die direkt in der Diplomarbeit aufgegriffen werden.

IoT-Integration und Echtzeitüberwachung:
Immer mehr Indoor-Gartengeräte sind mit Sensoren ausgestattet – laut Marktdaten stieg die Sensor-Durchdringungsrate von 46 % im Jahr 2021 auf 71 % im Jahr 2025 [36]. Genau hier setzt das entwickelte System an: Es erfasst vier zentrale Umweltparameter in Echtzeit und nutzt diese Daten für eine automatisierte Steuerung der Bewässerung und Klimaregulierung.

KI-gestützte Pflanzenanalyse:
Die Kombination aus Bildverarbeitung und KI entwickelt sich zunehmend zu einem wichtigen Unterscheidungsmerkmal im Markt [34]. Das System nutzt GPT-4 Vision zur Erkennung von Pflanzenkrankheiten und ermöglicht damit eine frühzeitige Diagnose. Selbst das technologisch weit entwickelte System von Gardyn bietet vergleichbare Funktionen bislang nur eingeschränkt.

Nachhaltige und energieautarke Lösungen:
Mit steigendem Umweltbewusstsein und höheren Energiepreisen wächst die Nachfrage nach netzunabhängigen Systemen [36]. Die Integration von Solarpanel und Akku verschafft dem entwickelten System hier einen klaren Vorteil gegenüber den analysierten Wettbewerbern.

Regulatorischer Rückenwind:
Auch politisch erhält der Markt Unterstützung. Im Rahmen des European Green Deal fördert die sogenannte Farm-to-Fork-Strategie nachhaltige, lokale Lebensmittelsysteme und eine Reduktion von Pestiziden [40]. Lösungen im Bereich Controlled Environment Agriculture profitieren somit zusätzlich von regulatorischen Anreizen.

Preissegment-Analyse

Da sich das System noch in der Prototyp-Phase befindet, ist ein endgültiger Verkaufspreis noch nicht festgelegt. Auf Basis der Wettbewerbsanalyse und des Funktionsumfangs lässt sich jedoch eine fundierte Einordnung in die marktüblichen Preissegmente vornehmen:

Preissegment | Preisspanne | Typische Produkte | Merkmale | Unser System?
Einstieg | 20–100 € | Click & Grow S3/S9 | Keine Sensorik, passiv, Design-Fokus | Nicht Zielsegment

Mittelklasse

150–500 €

AeroGarden Farm [41], Gardyn Kit [38]

App-Steuerung, einfache Sensorik, Hydroponik

Funktional überlegen

Premium

500–1.000 €

Gardyn 3.0 [38], Vivosun Growbox [39]

KI, vollständige Sensorik, Cloud-Integration

Angestrebte Positionierung

Profi

1.000 € +

Freight Farms [42]

Großflächig, industriell, komplex

Nicht Zielsegment

Tabelle 8: Preissegmente im Smart-Garden-Markt und Einordnung des eigenen Systems

Das entwickelte System verfügt mit vollständiger Multiparameter-Sensorik, aktiver Klimareglung, KI-Bildanalyse und Pflanzenkompatibilitätsgenerator über ein Funktionsprofil, das es klar im Premium-Segment (500–1.000 €) positioniert.

Im Gegensatz zu bestehenden Premium-Produkten wie Gardyn [38] bietet es darüber hinaus eine aktive Temperatur- und Luftfeuchtigkeitsreglung sowie eine vollständig autarke Energieversorgung über Solar und Akku – Funktionen, die in dieser Preisklasse bislang kein Wettbewerber vereint.

Für eine kommerzielle Weiterentwicklung wäre eine Positionierung im Premiumbereich daher nicht nur realistisch, sondern durch den erweiterten Funktionsumfang klar gerechtfertigt.

# 5.7 Zusammenfassung und Ausblick

## 5.7.1 Zusammenfassung der Ergebnisse

Das Ziel dieses Projekts war die Entwicklung eines vollautomatisierten, sensorgestützten Gewächshaussystems, das Klimaparameter und Bodenfeuchtigkeit eigenständig überwacht und regelt. Dieses Ziel wurde im Rahmen der Diplomarbeit erfolgreich umgesetzt.

Zwei spezialisierte ESP32-Mikrocontroller übernehmen dabei die jeweiligen Aufgabenbereiche: Der erste regelt Temperatur, Luftfeuchtigkeit und Beleuchtung über DHT22-Sensor, Heizlüfter, Wachstums-LEDs und einen Linearmotor zur automatischen Fenstersteuerung. Der zweite steuert die Mehrzonenbewässerung auf Basis von drei kapazitiven Bodenfeuchtigkeitssensoren und aktiviert bei Bedarf die zugehörigen Tauchpumpen. Beide Einheiten sind über MQTT miteinander und mit der App verbunden, was eine nahtlose Kommunikation in Echtzeit ermöglicht.

Ergänzend zur Hardware wurde eine cloudbasierte KI-Bildanalyse über GitHub Actions und die OpenAI API (GPT-4o) realisiert. Nutzerinnen und Nutzer können Pflanzenfotos hochladen, die automatisch analysiert und als strukturierter JSON-Bericht zurückgegeben werden.

Der Pflanzenkompatibilitätsgenerator mit FastAPI-Backend und SQLite-Datenbank für 47 Pflanzenarten rundet das System ab und liefert gleichzeitig die Sollwerte für die Hardwaresteuerung. Alle wesentlichen Funktionen wurden in Hardware- und Softwaretests erfolgreich validiert.

## 5.7.2 Ausblick

Das aktuelle System ist als funktionierender Prototyp ausgelegt – bei einer Weiterentwicklung in Richtung eines größeren oder kommerziell vertriebenen Systems würden sich einige grundlegende Dinge ändern.

Die größte Herausforderung dabei wäre die Skalierung der KI-Bildanalyse. Die aktuelle Lösung über GitHub Actions ist für den Prototyp pragmatisch und funktioniert zuverlässig, sie setzt jedoch voraus, dass jede Installation über ein eigenes GitHub-Repository mit konfiguriertem API-Schlüssel verfügt. In einem Produkt, das an viele Nutzerinnen und Nutzer ausgeliefert wird, ist das kein tragfähiger Ansatz. Hier würde man stattdessen auf eine eigene Backend-Infrastruktur setzen – etwa einen zentralen API-Server, der Bildanfragen entgegennimmt und die Kommunikation mit der OpenAI API zentral verwaltet. Das ermöglicht außerdem Nutzerverwaltung, Zugriffskontrolle und eine saubere Kostenkontrolle über den API-Verbrauch.

Auch die MQTT-Architektur würde sich bei mehr Gewächshäusern und mehreren gleichzeitigen Nutzern anders gestalten: Statt eines lokalen Brokers pro Installation käme ein zentraler Cloud-Broker zum Einsatz, über den mehrere Anlagen parallel verwaltet werden können. Die Flutter-App könnte sich dadurch zu einer echten Mehranlagen-Verwaltung entwickeln, mit Verlaufsdiagrammen, Push-Benachrichtigungen bei Grenzwertüberschreitungen und der Möglichkeit, Sollwerte für mehrere Standorte gleichzeitig anzupassen.

Der Pflanzenkompatibilitätsgenerator und die dahinterliegende Datenbank wären ebenfalls ausbaufähig: Mit realen Betriebsdaten aus dem laufenden Betrieb ließen sich die Kompatibilitätswerte durch maschinelles Lernen kontinuierlich verbessern, anstatt ausschließlich auf manuell gepflegte Steckbriefdaten zu setzen. Das System hätte damit das Potenzial, sich mit jeder installierten Einheit weiter zu optimieren.

# 6.1 Theoretische Grundlagen

Neben der technischen Umsetzung spielt auch die wirtschaftliche und effizienzorientierte Betrachtung dieses Systems eine wesentliche Rolle. Besonders Bereiche wie die Flexibilität und Skalierbarkeit, die Wirtschaftlichkeit durch energieeffiziente, sensordatenbasierte Steuerung und die SWOT-Analyse wurden hier näher bearbeitet:

## 6.1.1 Flexibilität und Skalierbarkeit

Ein wesentlicher Vorteil des entwickelten Systems liegt in der hohen Flexibilität und Skalierbarkeit. Aufgrund des durchdachten Aufbaus einer zentralen Steuerungs-App, mehrerer Mikrocontroller und einer cloudbasierten Datenübertragung, kann das System sowohl technisch als auch funktional leicht erweitert werden. Die App wurde so konzipiert, dass sie nicht an eine feste Anzahl von Sensoren gebunden ist, wodurch weitere Komponenten in nur kürzester Zeit auch softwarebasiert ins System eingebunden wären.

Das Framework Flutter, welches speziell für die Entwicklung von Apps auf unterschiedlichen Betriebssystemen konzipiert wurde, bietet durch eine große Auswahl an vorgefertigten Komponenten viele Vorteile und ist besonders aufgrund der einfachen Erweiterbarkeit auf mehrere Geräte bzw. Betriebssysteme verbreitet. Beispielsweise konnte die im Rahmen dieser Diplomarbeit entwickelte App auf einem Android-Emulator (virtuelles Android-Gerät) simuliert und getestet werden, lässt sich jedoch ohne Änderungen am Quellcode auch auf ein iOS-Gerät übertragen. Dies stellt einen wichtigen Aspekt hinsichtlich der Flexibilität dar, da ein Umschreiben der über 10 000 Codezeilen nicht realisierbar wäre. Auch die Skalierbarkeit wird dadurch verbessert, da die App im Falle einer Weiterentwicklung zu einem realen Projekt ohne größeren Aufwand im Google Play Store (Android) bzw. im App Store (iOS) veröffentlicht werden könnte. [43]

Auch die gewählte Cloudlösung trägt entscheidend zur Skalierbarkeit bei. Über den gewählten Anbieter HiveMQ sind in der kostenlosen Version bis zu 100 Sessions gleichzeitig möglich, was jedoch bei Bedarf ohne Umstände erweitert werden könnte. So könnte ein Benutzer in späteren Ausbaustufen mehrere Einheiten gleichzeitig steuern und Daten empfangen. Praktisch ist zudem, dass nur ein Schnittpunkt zwischen der App und dem Gewächshaus liegt, wodurch auch hier eine unkomplizierte Erweiterung keine Probleme mit sich ziehen würde. [44]

Abschließend lässt sich festhalten, dass die hohe Flexibilität und Skalierbarkeit nicht nur technische, sondern auch wirtschaftliche Vorteile bietet: geringere Anpassungskosten, Wiederverwendbarkeit der Softwarekomponenten und die Möglichkeit, das System in Zukunft an veränderte Anforderungen anzupassen oder auf neue Märkte auszuweiten.

## 6.1.2 Wirtschaftlichkeit durch energieeffiziente, sensordatenbasierte Steuerung

Die wirtschaftliche Relevanz des Projekts ergibt sich insbesondere aus der intelligenten, sensordatenbasierten Steuerung der klimatischen Bedingungen im Gewächshaus. Im Gegensatz zu herkömmlichen Gewächshaussteuerungen, die häufig mit fest definierten Sollwerten und Zeitintervallen arbeiten, verwendet dieses System auf Wunsch des Benutzers in der App einen sogenannten automatischen Modus. Dabei werden auf Basis eines Vergleichs zwischen den gemessenen Sensordaten, wie beispielsweise Temperatur und Luftfeuchtigkeit, und den im Pflanzen-Kompatibilitäts-Rechner (siehe Kapitel 7.5) hinterlegten Standardwerten automatisiert Befehle ausgeführt. Dadurch wird der Benutzer entlastet, da das Gewächshaus nicht ständig überwacht werden muss, und gleichzeitig kann Energie eingespart werden, was letztlich zu geringeren Betriebskosten führt.

Zudem wurde eine Integration eines Energiesparmodus in Anbetracht gezogen, jedoch stellte sich bereits nach kurzer Zeit heraus, dass dieser nicht realitätsnah und vorteilbringend umsetzbar gewesen wäre, wodurch in der Folge die Idee dazu verworfen wurde und dementsprechend mehr Wert auf die Entwicklung und Ausarbeitung des automatischen Modus gelegt wurde.

Aus wirtschaftlicher Sicht sind diese Optimierungen besonders relevant, da sie die Betriebskosten langfristig senken. Obwohl die Anschaffung der Sensoren und der Steuerungstechnik zunächst etwas kostet, gleichen sich die Ausgaben im Laufe der Zeit durch Einsparungen bei Energie und Wasser wieder aus. Zudem ermöglicht die kontinuierliche Datenerfassung eine Analyse des Energieverbrauchs, wodurch ineffiziente Prozesse erkannt und ausgebessert werden können.

Ein weiterer Aspekt ist die potenzielle Erweiterung des Systems für größere Anlagen oder gewerbliche Nutzung. In der professionellen Landwirtschaft ist Energieeffizienz ein entscheidender Kostenfaktor. Durch die Integration smarter Mechanismen könnten sich ähnliche Systeme zu einem wirtschaftlich interessanten Produkt entwickeln – etwa als Steuerungslösung für kleinere Betriebe, die nachhaltige Technologien erproben möchten.

Nicht zuletzt unterstützt das System ökologische Nachhaltigkeitsziele. Der reduzierte Energieverbrauch durch diverse Automatismen und die Nutzung erneuerbarer Energien tragen nicht nur zur Kostensenkung, sondern auch zur ökologischen Verantwortung bei. Vor allem in der jetzigen Zeit, welche von einem permanenten Anstieg der Energiepreise geprägt ist, hilft das System enorm, um Kosten einzusparen, und schafft zunehmend auch einen wirtschaftlichen Wettbewerbsvorteil.

## 6.1.3 SWOT-Analyse

Eine strategische Betrachtung des Projekts kann unter anderem mithilfe der SWOT-Analyse erfolgen. Sie dient grundsätzlich dazu, interne Stärken und Schwächen sowie externe Chancen und Risiken zu identifizieren und deren wirtschaftliche Auswirkungen zu bewerten.

S – Stärken (Strengths) • Hohe Automatisierung • Benutzerfreundliche App • Energieeffiziente Steuerung • Ortsunabhängiger Zugriff • Einfache Erweiterbarkeit | O – Chancen (Opportunities) • Wachsender Markt für Smart-Home & Agrar • Nachhaltigkeitstrend • Einsatz als Lernplattform • Steigende Digitalisierung in der Landwirtschaft
W – Schwächen (Weaknesses) • Abhängigkeit von Internetverbindung • Datenschutz-/Sicherheitsrisiken • Wartungsaufwand für Sensoren/Aktoren • Begrenzte Redundanz | T – Risiken (Threats) • Abhängigkeit von Drittanbietern (HiveMQ) • Cyberangriffe / Datenverluste • Schneller technologischer Fortschritt im IoT-Bereich

Abbildung 5: SWOT-Analyse des smarten Gewächshaus-Systems

### 6.1.3.1 Stärken (Strengths)

Das System überzeugt durch seine hohe Automatisierung, Benutzerfreundlichkeit und Energieeffizienz. Die App bietet eine gut strukturierte und übersichtliche Oberfläche, welche durch Automatisierungen der Prozesse und einer simplen Bedienung eine vollständige Steuerung des Gewächshauses für jeden bietet, egal ob geübter oder unerfahrener Benutzer. Die Integration von Cloud-Diensten erlaubt zudem einen ortsunabhängigen Zugriff auf aktuelle Sensordaten und Steuerungsfunktionen. Darüber hinaus ist das System so aufgebaut, dass es ohne größere strukturelle Änderungen angepasst und erweitert werden kann. Eine zusätzliche Stärke ist auch der gut durchdachte automatische Modus, welcher permanent darauf achtet, ob sich die gemessenen Sensorwerte in einem vom Benutzer im Pflanzen-Kompatibilitäts-Rechner festgelegten Bereich befinden. Falls dies nicht der Fall ist, werden automatisch Aktionen wie das Öffnen der Klappe ausgeführt.

### 6.1.3.2 Schwächen (Weaknesses)

Eine zentrale Schwäche liegt in der Abhängigkeit von einer stabilen Internetverbindung, da die Cloudkommunikation über MQTT nur bei vorhandener Netzverbindung funktioniert. Zudem könnten Datenschutz- und Sicherheitsprobleme im Zusammenhang mit der Cloudlösung auftreten, wobei jedoch HiveMQ großen Wert auf eine gute Datensicherheit legt. Auch der Wartungsaufwand für Sensoren und Aktoren kann die Betriebskosten erhöhen. Außerdem bietet dieses System im Vergleich zu größeren industriellen Lösungen aktuell nur begrenzte Redundanz und Fehlertoleranz. [45]

### 6.1.3.3 Chancen (Opportunities)

Die wachsende Relevanz von Nachhaltigkeit, Energieeffizienz und Smart-Home-Technologien bietet zahlreiche Marktchancen. Das System könnte als Perspektivlösung auch als Lern- oder Demonstrationsplattform für Schulen, Forschungseinrichtungen oder Start-ups im Agrarbereich genutzt werden. Mit zunehmender Digitalisierung in der Landwirtschaft steigen zudem die Nachfrage und das Interesse an simplen, effektiven, kostengünstigen und flexiblen Steuerungssystemen – ein Umfeld, in dem sich das hier beschriebene System gut positionieren könnte.

### 6.1.3.4 Risiken (Threats)

Mögliche Risiken liegen in technologischen Abhängigkeiten von Drittanbietern wie etwa die Cloudplattform HiveMQ und diversen Softwarebibliotheken. Zudem besteht ein gewisses Risiko durch Cyberangriffe oder Datenverluste, weshalb Sicherheitsmechanismen wie Zugriffskontrollen essenziell sind. Auch der schnelle technologische Fortschritt im IoT-Bereich kann bestehende Systeme rasch veralten lassen, wenn keine kontinuierliche Weiterentwicklung erfolgt.

### 6.1.3.5 Analyse

Aus der SWOT-Analyse lassen sich konkrete strategische Maßnahmen ableiten, um das System wirtschaftlich und technologisch weiterzuentwickeln.

6.1.3.5.1 SO-Strategien (Stärken nutzen, um Chancen auszuschöpfen)
Die hohe Automatisierung, Energieeffizienz und Benutzerfreundlichkeit ermöglichen eine Positionierung im wachsenden Smart-Home- und Agrartechnikmarkt. Besonders im Bildungsbereich kann das System als Lern- und Demonstrationsplattform eingesetzt werden. Der Nachhaltigkeitstrend kann zusätzlich genutzt werden, indem die energieeffiziente Steuerung und das PV-Modul als wirtschaftlicher Mehrwert hervorgehoben werden.

6.1.3.5.2 WO-Strategien (Schwächen minimieren durch Chancen)
Die Abhängigkeit von einer Internetverbindung könnte durch einen lokalen Notfall- oder Offline-Modus reduziert werden. Datenschutzbedenken lassen sich durch verschlüsselte Datenübertragung und transparente Informationspolitik verringern. Kooperationen mit Bildungseinrichtungen oder Technologiepartnern könnten die Weiterentwicklung unterstützen.

6.1.3.5.3 ST-Strategien (Stärken einsetzen gegen Risiken)
Durch die modulare Architektur kann flexibel auf technologische Veränderungen oder einen Wechsel des Cloudanbieters reagiert werden. Regelmäßige Updates erhöhen zudem die Systemsicherheit und reduzieren Cyberrisiken.

6.1.3.5.4 WT-Strategien (Schwächen und Risiken gleichzeitig reduzieren)
Zur Minimierung von Ausfall- und Sicherheitsrisiken sollten Sicherheitsmechanismen wie Zugriffskontrollen und regelmäßige Wartung der Hardware eingeplant werden. Eine kontinuierliche Weiterentwicklung verhindert technologische Überalterung.

6.1.3.5.5 Fazit

Abschließend zeigt die strategische Betrachtung, dass das System bei gezielter Weiterentwicklung wirtschaftlich tragfähig und zukunftsorientiert positioniert werden kann.

# 6.2 Technische Grundlage

Für die Realisierung der Steuerungs-App werden mehrere moderne Technologien eingesetzt, die in Kombination eine effiziente und stabile Kommunikationsstruktur zwischen Benutzer, App und den eingebundenen Mikrocontrollern ermöglichen.

## 6.2.1 Flutter

Flutter ist ein plattformübergreifendes Open-Source-Framework von Google, dessen Vorteil das Entwickeln von mobilen, webbasierten und desktopbasierten Anwendungen aus einer einzigen Codebasis ist. Als Programmiersprache dient dabei Dart, welches sich unter anderem durch eine hohe Ausführungsgeschwindigkeit und eine gute Performance auszeichnet, was speziell im Rahmen der App, durch die hohen Datenmengen, sehr vorteilhaft ist. [46]

## 6.2.2 MQTT-Protokoll

Für die Kommunikation zwischen der App und dem ESP-Mikrocontroller wird das Protokoll MQTT (Message Queuing Telemetry Transport) verwendet. Es basiert auf dem sogenannten Publish/Subscribe-Prinzip und zeichnet sich durch eine einfache Struktur sowie eine geringe Datenlast aus. Dadurch eignet es sich besonders gut für Steuerungsanwendungen wie die vorliegende. Als MQTT-Broker, der als Vermittler zwischen App und Mikrocontroller fungiert, kommt HiveMQ zum Einsatz. [47]

## 6.2.3 ESP-Mikrocontroller

Bei den eingesetzten Mikrocontrollern handelt es sich um ESP32-Modelle, welche sich durch ihre integrierte WLAN-Funktionalität und einfache Programmierbarkeit auszeichnen. Sie dienen im Projekt als Schnittstelle zwischen Sensorik, Aktorik und der Cloud. Um diese Kommunikation zu ermöglichen, muss eine permanente Internetverbindung vorhanden sein.

## 6.2.4 Sensoren und Aktoren

Für eine korrekte Funktionsweise des automatischen Modus sowie eine vollständige Übersicht des Benutzers über das Gewächshaus sind verschiedene Sensoren und Aktoren verbaut:

Typ | Komponente | Funktion
Sensor | Bodenfeuchtigkeitssensor (3×) | Bewässerungssteuerung pro Zone
Sensor | Luftfeuchtigkeitssensor | Lüftungssteuerung (Klappe)
Sensor | Temperatursensor | Heizungssteuerung
Sensor | Spannungsmessung | Energiemonitoring / Akkustand
Aktor | Heizlüfter | Erwärmung des Innenraumes
Aktor | Linearaktuator (Klappe) | Lüftung bei hoher Luftfeuchtigkeit
Aktor | Bewässerungspumpen (3×) | Zonenbewässerung
Aktor | LED-Beleuchtung | Wachstumsförderndes Licht

Tabelle 9: Übersicht der verbauten Sensoren und Aktoren

# 6.3 Anforderungen

Die Entwicklung der App für das smarte Gewächshaus erfordert sowohl funktionale als auch nicht-funktionale Anforderungen. Zusätzlich werden die Rahmenbedingungen für die technische Umsetzung beschrieben, um die Entwicklungs- und Testumgebung klar abzustecken.

Kriterium | Kategorie | Beschreibung
Performance | Nicht-funktional | Echtzeitverarbeitung, minimale MQTT-Latenz
Benutzerfreundlichkeit | Nicht-funktional | Übersichtliches UI, alle Funktionen in wenigen Klicks
Erweiterbarkeit | Nicht-funktional | Modularer Aufbau, klare Trennung von UI und Logik
Steuerung | Funktional | Heizung, Klappe, Bewässerung, Beleuchtung
Sensordaten | Funktional | Echtzeitzanzeige: Temperatur, Luftfeuchtigkeit, Batterie, Leistung
Automatischer Modus | Funktional | Automatische Aktionen bei Grenzwertüberschreitung

Tabelle 10: Übersicht der funktionalen und nicht-funktionalen Anforderungen

## 6.3.1 Funktionale Anforderungen

Die funktionalen Anforderungen beschreiben, welche Aufgaben und Funktionen die App erfüllen soll. Die App ermöglicht die Steuerung der wichtigsten Komponenten im Gewächshaus, nämlich:

- Heizung: Aktivierung bzw. Deaktivierung der Heizung, um auch bei kalter Umgebung den optimalen Bereich der Temperatur zu erreichen.
- Klappe: Öffnen und Schließen der Klappe durch einen Linearaktuator, um bei zu hoher Luftfeuchtigkeit entgegenwirken zu können.
- Bewässerung: Start und Stopp der Wasserzufuhr von drei unterschiedlichen Pumpen, um bei zu niedriger Boden- bzw. Luftfeuchtigkeit Maßnahmen zu ergreifen.
- Beleuchtung: Ein- und Ausschalten der künstlichen, wachstumsfördernden Beleuchtung.

Darüber hinaus stellt die App Sensordaten in Echtzeit dar, wie etwa:

- Temperatur, Luftfeuchtigkeit und Bodenfeuchtigkeit (pro Zone) im Gewächshaus,
- aktuelle elektrische Leistung,
- Batteriestatus (in Prozent).

Die Anwendung bietet verschiedene Betriebsmodi und Optionen, die – falls aktiviert – folgende Funktionen bereitstellen:

- Automatischer Modus: Führt basierend auf dem Vergleich zwischen gemessenen Sensordaten und den im Pflanzen-Kompatibilitäts-Rechner als Standard festgelegten Werten selbstständig Aktionen aus, etwa das Öffnen einer Klappe bei Überschreiten einer bestimmten Luftfeuchtigkeit oder das Aktivieren der Heizung bei Unterschreiten einer definierten Temperatur.
- Dunkelmodus (umgangssprachlich Dark Mode): Ändert das Farbschema der App auf dunklere Töne.
- In-App-Benachrichtigungen: Erzeugen ein visuelles Feedback für durchgeführte Aktionen.
- Shortcuts: Zwei frei belegbare Schnellaktionen, die eine komfortablere Bedienung ermöglichen.

All diese Funktionen ermöglichen dem Benutzer eine ortsunabhängige, nahezu vollständige Kontrolle des Gewächshauses.

## 6.3.2 Nicht-funktionale Anforderungen

Neben den funktionalen Aspekten spielen auch nicht-funktionale Anforderungen eine wichtige Rolle für die Benutzerfreundlichkeit der App.

- Performance: Die App soll Befehle und Sensordaten nahezu in Echtzeit verarbeiten und weiterleiten bzw. empfangen können. Die Kommunikation über MQTT darf dabei nur minimale Verzögerungen aufweisen, um eine direkte Rückmeldung bei Steueraktionen zu ermöglichen.
- Benutzerfreundlichkeit: Das Benutzerinterface soll übersichtlich, intuitiv und leicht verständlich sein. Alle Hauptfunktionen müssen mit wenigen Klicks erreichbar sein. Eine klare Symbolik und ein konsistentes Design tragen zur positiven Nutzererfahrung bei.
- Erweiterbarkeit und Wartbarkeit: Die App soll modular aufgebaut sein, damit zukünftige Erweiterungen – beispielsweise zusätzliche Sensoren oder neue Steuerfunktionen – ohne große strukturelle Änderungen integriert werden können. Eine klare Trennung von Benutzeroberfläche, Logik und Datenkommunikation erleichtert zudem die Wartung.

## 6.3.3 Sonstige Anforderungen

Die Rahmenbedingungen definieren die technischen und organisatorischen Voraussetzungen, unter denen die App entwickelt und getestet wird.

- Entwicklungsumgebung: Die Programmierung erfolgt in IntelliJ IDEA, einer leistungsfähigen Entwicklungsumgebung für Flutter-Projekte. Als Flutter SDK wird die aktuelle stabile Version verwendet. Zum Testen dient der integrierte Android-Emulator sowie ein physisches Smartphone, um reale Bedienvorgänge nachvollziehen zu können. [48]
- Hardwareumgebung: Das Gewächshaus verfügt über mehrere ESP-Mikrocontroller, die mit Sensoren (Temperatur, Luftfeuchtigkeit, Spannungsmessung) und Aktoren (Heizung, Beleuchtung, Klappenmotor, Bewässerungspumpe) verbunden sind. Die Kommunikation erfolgt über ein lokales WLAN-Netzwerk mit Internetzugang, sodass sowohl Steuerbefehle als auch Messdaten über den HiveMQ-Cloudserver übertragen werden können.
- Netzwerk und Cloudanbindung: Da das System ortsunabhängig bedienbar sein soll, ist eine stabile Internetverbindung erforderlich. MQTT sorgt dafür, dass auch bei kurzzeitigen Unterbrechungen die Verbindung automatisch wiederhergestellt wird. Eine Datenbank wird derzeit nicht verwendet, könnte jedoch bei zukünftigen Erweiterungen – insbesondere bei der Speicherung von Sensordaten mit Zeitstempel – ergänzt werden. [49]

# 6.4 Architektur der Gesamtlösung

Für das smarte Gewächshaus wurde eine verteilte Systemarchitektur gewählt, bei der mehrere Komponenten zusammenarbeiten. Die mobile App übernimmt die Benutzerinteraktion, während Mikrocontroller die physische Steuerung und Datenerfassung im Gewächshaus durchführen. Die Kommunikation zwischen diesen Komponenten erfolgt über eine Cloud-basierte Vermittlungsstelle.

Durch diese Aufteilung entsteht ein flexibles System, das ortsunabhängig gesteuert werden kann und sich später leicht erweitern lässt. Gleichzeitig wird verhindert, dass die App direkt mit den Geräten im lokalen Netzwerk kommunizieren muss, wodurch Konfigurationsaufwand und Netzwerkprobleme reduziert werden.

## 6.4.1 Systemübersicht

Das Gesamtsystem besteht aus drei Hauptbestandteilen:

📱 Mobile App | ☁️ Cloud-Broker (HiveMQ) | 🔧 ESP-Mikrocontroller
Flutter / Dart Benutzeroberfläche | MQTT-Broker Nachrichtenverteiler | ESP32 Sensorik & Aktorik
Steuerbefehle senden Sensordaten anzeigen | Publish / Subscribe kein direkter Kontakt | Heizung, Klappe Bewässerung, Licht

Tabelle 11: Systemarchitektur – Übersicht der drei Hauptkomponenten

- Mobile App: Die App dient als Benutzeroberfläche zur Steuerung und Überwachung des Gewächshauses. Hier werden Befehle ausgelöst, Sensordaten angezeigt und Einstellungen gespeichert.
- Cloud-Broker (MQTT-Server): Der Broker fungiert als Vermittler zwischen App und Mikrocontrollern. Er verteilt Nachrichten an alle Teilnehmer, ohne dass diese direkt miteinander verbunden sein müssen.
- ESP-Mikrocontroller im Gewächshaus: Die Mikrocontroller steuern Aktoren (Heizung, Beleuchtung, Klappe, Bewässerung) an und erfassen Sensordaten (Temperatur, Luftfeuchtigkeit, Energiezustand).

Die Komponenten sind so aufgebaut, dass jedes Gerät unabhängig arbeiten kann. Fällt beispielsweise die App aus, läuft die Automatiklogik im Gewächshaus weiterhin auf den Mikrocontrollern.

## 6.4.2 Datenfluss und Kommunikationswege

Die Datenübertragung erfolgt in drei Richtungen, die jeweils unterschiedliche Aufgaben erfüllen.

Richtung | Von → Nach | Inhalt
App → ESP | App → HiveMQ → ESP | Steuerbefehle (Heizung, Klappe, Bewässerung, Licht)
ESP → App | ESP → HiveMQ → App | Sensordaten: Temperatur, Luftfeuchtigkeit, Bodenfeuchtigkeit, Batterie, Leistung
App → App (Cloud) | App → HiveMQ → App | Einstellungen: Dark Mode, Shortcuts, Benachrichtigungen (Topics: general, sonstige)
App → App (lokal) | Direkte Übergabe beim Laden | Dark Mode (sofortige Verfügbarkeit beim Laden der Seite)

Tabelle 12: Datenfluss - Kommunikationswege zwischen App, Cloud und ESP

### 6.4.2.1 App → ESP (Steuerbefehle)

Wenn der Benutzer eine Aktion ausführt, sendet die App einen Steuerbefehl über den MQTT-Broker. Der Mikrocontroller empfängt die Nachricht und führt die entsprechende Aktion aus, beispielsweise das Aktivieren der Bewässerung oder das Einschalten der Heizung. Diese Richtung dient ausschließlich der aktiven Steuerung des Systems durch den Benutzer.

### 6.4.2.2 ESP → App (Sensordaten)

Die Mikrocontroller senden regelmäßig Messwerte an den Broker. Die App ist auf diese Daten abonniert und zeigt sie in Echtzeit an. Dazu zählen unter anderem:

- Temperatur
- Luftfeuchtigkeit
- Batteriestatus
- Leistungsdaten

Diese Datenübertragung ermöglicht dem Benutzer, den Zustand des Gewächshauses jederzeit zu überwachen.

### 6.4.2.3 App → App (lokale Daten)

Nachrichten, welche von der App für die App gesendet werden, bestehen hauptsächlich aus Design-Elementen wie Dark Mode, Shortcuts und In-App-Benachrichtigungen. Hier wird erneut zwischen zwei Formen der Übertragung unterschieden.

### 6.4.2.3.1 Cloud-Übertragung

Die Daten werden – gleich wie bei der Kommunikation mit den ESPs – über die Cloud gesendet, jedoch nur mit dem Ziel, sie beim nächsten Seitenaufruf in der App wieder einzulesen. Für diese Nachrichten bietet sich eine Cloud-Kommunikation an, da es nicht nur deutlich schneller, sondern auch leistungsschonender und unkomplizierter ist.

### 6.4.2.3.2 Direkte Übergabe beim Laden der Seite

Daten, welche direkt beim Laden einer Seite verfügbar sein müssen, werden lokal beim Aufruf übergeben. Dazu zählt im Falle dieser App der Dunkelmodus, da er, anders als alle anderen Daten, sofort verfügbar sein muss, um den Ladebildschirm zum Einlesen der restlichen Daten bereits im richtigen Schema darstellen zu können.

onTap: () {
Navigator.push(
context,
MaterialPageRoute(builder: (context) => LightingPage(darkMode: _darkMode)),
);
}

Alle Daten lokal zu übergeben, würde nicht nur die Komplexität unnötig erhöhen, sondern auch der ortsunabhängigen Verfügbarkeit der Daten widersprechen, wodurch es für diese App nicht in Frage käme.

## 6.4.3 Auswahl und Begründung der Cloudlösung

Für die Vermittlung der Nachrichten wurde eine Cloud-basierte MQTT-Lösung gewählt. Der Hauptgrund dafür ist die einfache Implementierung und die gute Verständlichkeit der Kommunikationsstruktur. Im Vergleich zu einer direkten Netzwerkverbindung bietet die Cloudlösung mehrere Vorteile:

- Zugriff von überall ohne Portfreigaben im Router
- Keine feste IP-Adresse notwendig
- Einfache Erweiterung um weitere Geräte
- Geringerer Wartungsaufwand

Eine klassische Datenbank wurde zunächst nicht verwendet, da für die Grundfunktion der Echtzeitsteuerung keine dauerhafte Speicherung erforderlich ist. Die Cloud fungiert daher primär als Nachrichtenverteiler und nicht als Datenspeicher.

## 6.4.4 Sicherheitsaspekte der Architektur

Da das System über das Internet erreichbar ist, müssen grundlegende Sicherheitsmaßnahmen berücksichtigt werden. Die Kommunikation erfolgt über eine authentifizierte Verbindung zum Broker. Dadurch wird verhindert, dass fremde Geräte unberechtigt Befehle senden oder Daten empfangen können. Zusätzlich können Topics getrennt werden, sodass jedes Gerät nur auf die vorgesehenen Daten zugreifen darf.

Ein weiterer Sicherheitsaspekt ist die Systemstabilität: Selbst bei einem Verbindungsverlust bleibt die lokale Steuerlogik im Gewächshaus aktiv. Kritische Funktionen wie Temperaturregelung oder Frostschutz sind somit nicht von der App abhängig.

## 6.4.5 Zusammenfassung der Systemarchitektur

Die gewählte Architektur trennt Benutzeroberfläche, Kommunikation und Hardwaresteuerung klar voneinander. Dadurch entsteht ein stabiles und erweiterbares System. Die App dient ausschließlich der Bedienung und Visualisierung, während die Mikrocontroller die eigentliche Steuerung übernehmen. Die Cloud vermittelt lediglich die Nachrichten zwischen beiden Seiten. Diese Aufteilung erhöht die Zuverlässigkeit, erleichtert Wartung und erlaubt zukünftige Erweiterungen, ohne die bestehende Struktur grundlegend verändern zu müssen.

# 6.5 Planung und Konzeption der App

Die Planung und Konzeption der App bildet die Grundlage für eine strukturierte und benutzerfreundliche Umsetzung der Steuerungsfunktionen des Gewächshauses.

## 6.5.1 Definition der Hauptfunktionen und des App-Designs

Die App ermöglicht eine direkte Steuerung und Überwachung des Gewächshauses. Dazu zählen die Steuerung der Heizung, der Bewässerung, der Klappe und der Beleuchtung. Ergänzend zu den Kernfunktionen gibt es mehrere Zusatzfunktionen, die die Bedienung komfortabler und effizienter gestalten. Dazu gehören der automatische Modus sowie zwei Shortcuts. Für eine genauere Beschreibung der Haupt- und Zusatzfunktionen, siehe Kapitel 3.1.

Erste Designüberlegungen beziehen sich auf die Benutzerfreundlichkeit und Übersichtlichkeit. Layout, Bedienlogik und Navigation sollen so gestaltet werden, dass die Hauptfunktionen schnell erreichbar sind, die App auf verschiedenen Geräten konsistent dargestellt wird und der Anwender direkt erkennt, welche Aktionen verfügbar sind.

# 6.6 Technische Umsetzung

Die technische Umsetzung der App umfasst die Programmierung der Benutzeroberfläche, die Implementierung der Steuerungsfunktionen, die Anzeige der Sensordaten, die Speicherung von App-Daten sowie die Kommunikation zwischen App und ESP-Mikrocontrollern über die Cloud.

## 6.6.1 Projektstruktur der App

Die App wurde in mehrere logische Bereiche aufgeteilt, um Wartbarkeit und Erweiterbarkeit zu verbessern.

- pages/ – einzelne Seiten der App (Start, Steuerung, Sensordaten, Einstellungen)
- services/ – Kommunikation mit MQTT und Datenverarbeitung
- backend/ – Backend für den Pflanzen-Kompatibilitäts-Rechner
- backup/ – Reichlich Backups vieler Seiten

Durch diese Trennung wird verhindert, dass Benutzeroberfläche und Logik vermischt werden. Dadurch kann die App später leichter erweitert werden.

## 6.6.2 Implementierung der Benutzeroberfläche

Beim Entwickeln der Benutzeroberfläche wurde speziell auf Übersicht, Benutzerfreundlichkeit und schnelle Erreichbarkeit der Befehle und Daten Wert gelegt.

### 6.6.2.1 Aufbau der Screens

Die App besteht aus mehreren Hauptansichten:

- Startseite – Übersicht aller Seiten und der Shortcuts
- Steuerungsseiten – Seiten wie Klappe und Bewässerung, in denen Aktionen ausgeführt werden können und die jeweils relevanten Sensordaten angezeigt werden
- Pflanze – KI-Analyse eines beliebigen Bildes und Pflanzen-Kompatibilitäts-Rechner
- Sensordaten & Stromgewinnung – Auflistung aller Sensorwerte und Anzeige der aktuellen Energiedaten wie Leistung und Akkustand
- Einstellungen – Einstellungen wie Dark Mode, automatischer Modus und In-App-Benachrichtigungen

Die Navigation erfolgt über eine Bottom-Navigation-Bar, wodurch alle Hauptfunktionen schnell erreichbar sind.

### 6.6.2.2 Sensordatenanzeige

Die Daten, die in der App angezeigt werden sollen, werden in regelmäßigen Intervallen gemessen und anschließend mit einem Zeitstempel vom ESP32 an die Cloud übertragen. Die Sensordaten werden dann in den verschiedenen Bereichen der App, wie beispielsweise der Bewässerung oder der Klappe, dargestellt. Zusätzlich wird darunter zum Vergleich der im Pflanzen-Kompatibilitäts-Rechner als Standard hinterlegte Wert angezeigt. Auf diese Weise kann unmittelbar erkannt werden, ob beispielsweise eine Bewässerung erforderlich ist.

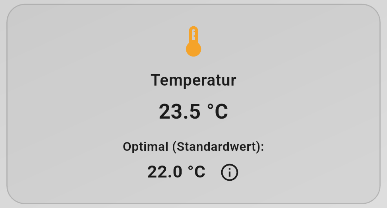
[picture p36: figure]

Abbildung 6: Beispielansicht einer Kachel mit Sensordaten und dem Standardwert aus dem Pflanzen-Kompatibilitäts-Rechner

### 6.6.2.3 Wiederverwendbare Widgets

Das Framework Flutter stellt für eine unkompliziertere Programmierung vordefinierte Programmabschnitte, also sogenannte Widgets, vor, welche mit beliebigem Inhalt befüllt werden können. Dies sind einige der vielen Widgets:

- ElevatedButton: Einheitliches Design für Buttons (klickbare Flächen in der App) möglich.
- Icon: Vorlage für Icons jeglicher Größe und Art.
- SingleChildScrollView: Eine Art Box, in welcher ein einzelnes Widget (Container, Text, Image, Row, …) durch Scrollen verschiebbar angezeigt werden kann.
- Image: Vorlage für Bilder jeglicher Größe und Art.
- Row / Column: Row und Column können mehrere Kinder anordnen: Row horizontal nebeneinander, Column vertikal untereinander.
- Expanded: Ermöglicht es einem Kind-Widget, den verbleibenden freien Platz in einer Row, Column oder Flex automatisch auszufüllen.

Diese Komponenten können mehrfach verwendet werden und sorgen für ein einheitliches Design. Außerdem reduziert dies den Programmcode erheblich. [50]

## 6.6.3 Kommunikation über die Cloud

Beim Entwickeln der Benutzeroberfläche wurde speziell auf Übersicht, Benutzerfreundlichkeit und schnelle Erreichbarkeit der Befehle und Daten Wert gelegt.

### 6.6.3.1 Senden der Daten

Das Senden an die Cloud benötigt in der Regel folgende Schritte:

1. Erstellen des Clients
2. Herstellen der Verbindung zu MQTT
3. Senden der Nachricht
4. Abwarten, bis die Daten gesendet wurden
5. Trennung des Clients

Dabei ist eine Nachricht an die Cloud im Code folgendermaßen aufgebaut:

final generalMessage = StringBuffer('');
final sonstigeMessage = StringBuffer('');

……

sonstigeMessage.write(_darkMode ? ' DM: ein;' : ' DM: aus;');
generalMessage.write(_isFlapOpen ? ' K: auf;' : ' K: zu;');

……

try {
await mqtt.connectAndSendBatch([
{'topic': 'greenhouse/commands/flap', 'message': _isFlapOpen ? "true" : "false"},
{'topic': 'general', 'message': generalMessage.toString()},
{'topic': 'sonstige', 'message': sonstigeMessage.toString()},
]);
}

catch (e)
{
print('Fehler beim Senden: $e');
}

Im Code oben ist gut zu erkennen, wie die Daten gestaffelt an die Cloud gesendet werden, obwohl unterschiedliche Topics verwendet werden, um lediglich einen Client erstellen zu müssen. Die Nachrichten für die Topics general und sonstige werden direkt in der Senden-Methode mit den aus dem Auslesen gewonnenen Daten (siehe Kapitel 6.3.2) erstellt und befüllt, unabhängig davon, ob diese verändert wurden oder nicht. Die Variablen aller weiteren Topics – in diesem Beispiel die Klappensteuerung – werden in den jeweils zuständigen Methoden angepasst; andernfalls wird auch hier automatisch der vorherige Zustand verwendet.

Dies ließe sich durch eine If-Abfrage vor den Topics erweitern, da auf bestimmten Seiten beispielsweise ausgeschlossen werden kann, dass sich ein Wert des Topics sonstige verändert. Dadurch würde nicht nur die Ladezeit reduziert, sondern auch der verfügbare Speicherplatz in der Cloud weniger belastet.

### 6.6.3.2 Empfangen der Daten

Das Empfangen der Daten aus der Cloud benötigt in der Regel folgende Schritte:

1. Erstellen des Clients
2. Herstellen der Verbindung zu MQTT
3. Empfangen der Nachricht
4. Abwarten, bis alle Daten empfangen wurden
5. Trennung des Clients

Das Auslesen einer Nachricht aus der Cloud ist dabei im Code folgendermaßen aufgebaut:

final generalMsg = await mqtt.connectAndListenLastMessage('general');

if (generalMsg != null)
{
setState(()
{
_isFlapOpen = generalMsg.contains('Klappe: offen');
});
}

Im Code oben wurde zugunsten der Lesbarkeit nur das Auslesen vom Status der Klappe dargestellt.

### 6.6.3.3 Topic (in Bezug zu MQTT)

Topics sind sogenannte Kapitel, welche differenziert voneinander aufgelistet werden können und in erster Linie der Lesbarkeit dienen. Es wurde sich hier bewusst gegen eine Auftrennung der Daten in einzelne Topics entschieden, da sonst pro Datensatz ein neuer Client eröffnet werden hätte müssen und ansonsten das Auslesen der Daten deutlich komplizierter geworden wäre.
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
