baumann06/Diplomarbeit_Sicherung_Privat/Diplomarbeit/8_Zeichnungen/Verteilerschrank.docx

Bauteil | Abmessungen (L * T * H) in mm
12V AGM Super Cycle Batterie | 330 * 171 * 220
Victron MultiPlus 12/800 | 214 * 110 * 375
Victron Orion 12/12-18 | 186 * 70 * 130
Victron SmartShunt 500A | 120 * 54 * 46
Victron Cerbo GX | 154 * 48 * 78
Victron GX Touch | 128 * 12,4 * 87

Abstände zur Kühlung, Kabelzugang und einfachen Montage
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
