baumann06/Diplomarbeit_Sicherung_Privat/Diplomarbeit/3_Einkaufslisten_Komponenntenlisten/Komponentenliste.xlsx

Energieversorgung
Name | Verwendung | benötigte Menge | Abmessungen (H-B-T) |  | Lieferant | Anmerkung
Hauptkomponenten
enjoysolar 180W 12V Solar Panel (https://www.amazon.de/-/en/gp/product/B08LGJVMCC/ref=ox_sc_act_title_7?th=1) | Hauptenergiequelle | 1 | 127*76,5*3,5 cm |  | Amazon | bestellt
12V AGM Super Cycle Batterie – 100Ah (M6) | Energiespeicher | 1 | 220 * 171 * 330 mm |  | Amazon
Victron MultiPlus 12/800 | Ladecontroller + Wechselrichter (230V) + PV/Netz-Umschaltung | 1 | 375 * 214 * 110 mm |  | Raiffeisen Regenerative GmbH
Victron Orion 12/12-18 | isolierter 12V→12V Converter für Sensorsystem (bis 18A) | 1 | 130 * 186 * 70 mm |  | Raiffeisen Regenerative GmbH
Victron SmartShunt 500A | Präzisions-Stromsensor für genaue SoC-Berechnung und Monitoring (max. 500A) | 1 | 46 * 120 * 54 mm |  | Raiffeisen Regenerative GmbH
Voltage Converter 12V 24V to 5V 20A 100W | DC/DC Wandler 12V -> 5V | 1 | 75 * 73 * 33 mm |  | Amazon | bestellt
Sicherungen
Sicherung 30A (https://www.amazon.de/Holder-Standard-Dragon-Universal-Quantity-red/dp/B08JLPZYFQ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) | Haupt-Absicherung Akku (1x + Reserve) | 2 |  |  | Raiffeisen Regenerative GmbH
Sicherungshalter | Halter für 30A Blade-Sicherung | 1 |  |  | Raiffeisen Regenerative GmbH
Verkabelung
Kabel 6mm² Rot und Schwarz (https://www.amazon.de/-/en/QWORK%C2%AE-10AWG-Silicone-Electronic-Cable/dp/B0F66FV737) | Hochstrom 12V+ (Akku↔Victron) | 3m |  |  | Erich Huber
Kabel 1.5mm² dreiadrig (https://www.amazon.de/-/en/NYM-J-Sheathed-Cable-Installation-Copper/dp/B0FJRGHCD4) | 230V Verkabelung Netzzugang für MultiPlus | 2m |  |  | Erich Huber
Ring-Kabelschuhe 6mm² M8 (https://www.amazon.de/Kalitec-Connector-According-Germany-silver/dp/B0C66DPSM4?sp_csd=d2lkZ2V0TmFtZT1zcF9hdGY) | Akku- und Victron-Anschlüsse (~6 Stück) | 6 |  |  | Erich Huber
SOLARTRONICS Extension Cable 6 mm² (https://www.amazon.de/-/en/SOLARTRONICS-Extension-Cable-Solar-Plug-Red-black/dp/B0CKW9P2C2) | 6mm² mit MC4-Enden | 4m |  |  | Erich Huber
Victron RJ45 UTP Kabel | Shunt ↔ MultiPlus | 1m |  |  | Raiffeisen Regenerative GmbH
Aderendhülsen 1.5mm² (https://www.amazon.de/Wire-Ferrules-Insulated-Partially-Black/dp/B0CXH1RWQW?sp_csd=d2lkZ2V0TmFtZT1zcF9hdGY) | Alle 230V und Steuer-Leitungen |  |  |  | Erich Huber
Kabelbinder (https://www.amazon.de/Amazon-Basics-Black-Adjustable-Organizer/dp/B0BFWJZ4KW?sp_csd=d2lkZ2V0TmFtZT1zcF9hdGY) |  |  |  |  | Erich Huber
Energie-Management-System
Stäubli MC4 Original 6 Paar (https://www.amazon.de/-/en/gp/product/B08PFQM84M/ref=sw_img_1?smid=A1JXRLD5PXO0OA&th=1) | Solar-Panel Steckverbindungen | 2 Paar |  |  | Erich Huber
Victron Cerbo GX | 8-70V DC |  | 78 * 154 * 48 mm | Zentrale Überwachungs- und Steuereinheit, VE.Bus/VE.Direct Anschlüsse | Raiffeisen Regenerative GmbH
Victron GX Touch 50 | über Cerbo GX |  | 87 * 128 * 12,4 mm | Display 800x480, IP54, 2m Kabel | Raiffeisen Regenerative GmbH
