baumann06/Diplomarbeit_Sicherung_Privat/Diplomarbeit/3_Einkaufslisten_Komponenntenlisten/Einkaufsliste.xlsx

Energieversorgung
Name | Verwendung | benötigte Menge | Preis
Hauptkomponenten
enjoysolar 150W Solar Panel (https://www.amazon.de/-/en/gp/product/B08LGL2NHR/ref=ox_sc_act_title_7?smid=A27HW34Y4BM3JK&th=1) | Hauptenergiequelle, 18V/8.34A | 1 | €65.50
NuaSol Panel Halterung | Montage Solar-Panel, 15-30° einstellbar | 1 | €17.94
KEPWORTH 12V 100Ah LiFePO4 Akku (https://www.amazon.de/-/en/gp/product/B0FFTBKK17/ref=ox_sc_act_title_9?smid=A3P0VNCIO079PA&th=1) | Energiespeicher 1280Wh | 1 | €152.57
Victron MultiPlus 12/800 | Ladecontroller + Wechselrichter (230V) + PV/Netz-Umschaltung | 1
Victron Orion 12/12-16 | DC/DC Wandler 12V -> 5V | 1
Victron SmartShunt 500A | Präzisions-Stromsensor für genaue SoC-Berechnung und Monitoring (max. 500A) | 1
Sicherungen
Blade Sicherung 30A (https://www.amazon.de/Holder-Standard-Dragon-Universal-Quantity-red/dp/B08JLPZYFQ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) | Haupt-Absicherung Akku (1x + Reserve) | 2 | €12.10
Inline Blade Sicherungshalter | Halter für 30A Blade-Sicherung | 1 | €0.00
Verkabelung
Kabel 6mm² Rot und Schwarz (https://www.amazon.de/-/en/QWORK%C2%AE-10AWG-Silicone-Electronic-Cable/dp/B0F66FV737) | Hochstrom 12V+ (Akku↔Victron) | 2m | €21.17
Kabel 1.5mm² dreiadrig (https://www.amazon.de/-/en/NYM-J-Sheathed-Cable-Installation-Copper/dp/B0FJRGHCD4) | 230V Verkabelung Netzzugang für MultiPlus | 2m | €12.00
Ring-Kabelschuhe 6mm² M8 (https://www.amazon.de/Kalitec-Connector-According-Germany-silver/dp/B0C66DPSM4?sp_csd=d2lkZ2V0TmFtZT1zcF9hdGY) | Akku- und Victron-Anschlüsse (~6 Stück) | 6 | €9.59
SOLARTRONICS Extension Cable 6 mm² (https://www.amazon.de/-/en/SOLARTRONICS-Extension-Cable-Solar-Plug-Red-black/dp/B0CKW9P2C2) | 6mm² mit MC4-Enden | 4m | €15.08
Victron RJ45 UTP Kabel | Shunt ↔ MultiPlus | 1m
Aderendhülsen 1.5mm² (https://www.amazon.de/Wire-Ferrules-Insulated-Partially-Black/dp/B0CXH1RWQW?sp_csd=d2lkZ2V0TmFtZT1zcF9hdGY) | Alle 230V und Steuer-Leitungen |  | €5.87
Schrumpfschlauch Set (https://www.amazon.de/Eventronic-ET1001-Heat-Shrink-Tubing/dp/B071D7LJ31?sp_csd=d2lkZ2V0TmFtZT1zcF9hdGY) | Isolation aller Verbindungen | 1 Set | €8.66
Kabelbinder (https://www.amazon.de/Amazon-Basics-Black-Adjustable-Organizer/dp/B0BFWJZ4KW?sp_csd=d2lkZ2V0TmFtZT1zcF9hdGY) |  |  | €6.04
Energie-Management-System
ESP32 DevKit C V4 | Zentrale Steuerung, Lastmanagement, IoT | 1 | €0.00
Sparkleiot Development Board 2.8 Inch TFT Touch Display (https://www.amazon.de/-/en/gp/product/B0DJ35DDQF/ref=ox_sc_act_title_5?smid=A32D99AU4SRD9G&psc=1) | Touch-Bedienung und Status-Anzeige (Spannung, Lasten) | 1 | €22.18
Dupont Jumper Kabel Set (https://www.amazon.de/-/en/GTIWUNG-Breadboard-Bridges-Arduino-Raspberry/dp/B0CFXZDBVY) | Verbindungen ESP32↔Sensoren/Display (M-M, M-F, F-F) | 1 Set | €10.07
Stäubli MC4 Original 6 Paar (https://www.amazon.de/-/en/gp/product/B08PFQM84M/ref=sw_img_1?smid=A1JXRLD5PXO0OA&th=1) | Solar-Panel Steckverbindungen | 2 Paar | €7.16
Gehäuse | BOXEXPERT St. Pauli Serie - 600×800×300mm | 1
 |  |  | €365.93
