baumann06/Diplomarbeit_Sicherung_Privat/Diplomarbeit/Zeiterfassung/TimeTracker/build/build_app/warn-build_app.txt

This file lists modules PyInstaller was not able to find. This does not
necessarily mean this module is required for running your program. Python and
Python 3rd-party packages include a lot of conditional or optional modules. For
example the module 'ntpath' only exists on Windows, whereas the module
'posixpath' only exists on Posix systems.

Types if import:
* top-level: imported at the top-level - look at these first
* conditional: imported within an if-statement
* delayed: imported within a function
* optional: imported within a try-except-statement

IMPORTANT: Do NOT post this list to the issue-tracker. Use it as a basis for
            tracking down the missing module yourself. Thanks!

missing module named pyimod02_importers - imported by C:\HTL\HTL 5\Diplomarbeit\Zeiterfassung\TimeTracker\.venv\Lib\site-packages\PyInstaller\hooks\rthooks\pyi_rth_pkgutil.py (delayed), C:\HTL\HTL 5\Diplomarbeit\Zeiterfassung\TimeTracker\.venv\Lib\site-packages\PyInstaller\hooks\rthooks\pyi_rth_pkgres.py (delayed)
missing module named pwd - imported by posixpath (delayed, conditional, optional), shutil (delayed, optional), tarfile (optional), pathlib._local (optional), subprocess (delayed, conditional, optional), http.server (delayed, optional), netrc (delayed, conditional), getpass (delayed, optional), setuptools._distutils.util (delayed, conditional, optional), setuptools._vendor.backports.tarfile (optional), setuptools._distutils.archive_util (optional), _pytest._py.path (delayed)
missing module named grp - imported by shutil (delayed, optional), tarfile (optional), pathlib._local (optional), subprocess (delayed, conditional, optional), setuptools._vendor.backports.tarfile (optional), setuptools._distutils.archive_util (optional), _pytest._py.path (delayed)
missing module named _posixsubprocess - imported by subprocess (conditional), multiprocessing.util (delayed)
missing module named fcntl - imported by subprocess (optional), _pyrepl.unix_console (top-level)
missing module named posix - imported by posixpath (optional), shutil (conditional), importlib._bootstrap_external (conditional), os (conditional, optional), _pyrepl.unix_console (delayed, optional)
missing module named resource - imported by posix (top-level)
missing module named _manylinux - imported by packaging._manylinux (delayed, optional), setuptools._vendor.packaging._manylinux (delayed, optional), setuptools._vendor.wheel.vendored.packaging._manylinux (delayed, optional)
missing module named _frozen_importlib_external - imported by importlib._bootstrap (delayed), importlib (optional), importlib.abc (optional), zipimport (top-level)
missing module named _posixshmem - imported by multiprocessing.resource_tracker (conditional), multiprocessing.shared_memory (conditional)
missing module named multiprocessing.set_start_method - imported by multiprocessing (top-level), multiprocessing.spawn (top-level)
missing module named multiprocessing.get_start_method - imported by multiprocessing (top-level), multiprocessing.spawn (top-level)
missing module named multiprocessing.get_context - imported by multiprocessing (top-level), multiprocessing.pool (top-level), multiprocessing.managers (top-level), multiprocessing.sharedctypes (top-level)
missing module named multiprocessing.TimeoutError - imported by multiprocessing (top-level), multiprocessing.pool (top-level)
missing module named _scproxy - imported by urllib.request (conditional)
missing module named termios - imported by tty (top-level), _pyrepl.pager (delayed, optional), getpass (optional), _pyrepl.unix_console (top-level), _pyrepl.fancy_termios (top-level), _pyrepl.unix_eventqueue (top-level)
missing module named multiprocessing.BufferTooShort - imported by multiprocessing (top-level), multiprocessing.connection (top-level)
missing module named multiprocessing.AuthenticationError - imported by multiprocessing (top-level), multiprocessing.connection (top-level)
missing module named asyncio.DefaultEventLoopPolicy - imported by asyncio (delayed, conditional), asyncio.events (delayed, conditional)
missing module named usercustomize - imported by site (delayed, optional)
missing module named sitecustomize - imported by site (delayed, optional)
missing module named _curses - imported by curses (top-level), curses.has_key (top-level), _pyrepl.curses (optional)
missing module named readline - imported by cmd (delayed, conditional, optional), code (delayed, conditional, optional), rlcompleter (optional), pdb (delayed, optional), _pytest.capture (delayed, optional), site (delayed, optional), sqlite3.__main__ (delayed, conditional, optional)
missing module named trove_classifiers - imported by setuptools.config._validate_pyproject.formats (optional)
missing module named typing_extensions.Buffer - imported by setuptools._vendor.typing_extensions (top-level), setuptools._vendor.wheel.wheelfile (conditional)
missing module named typing_extensions.Literal - imported by setuptools._vendor.typing_extensions (top-level), setuptools.config._validate_pyproject.formats (conditional)
missing module named typing_extensions.Self - imported by setuptools._vendor.typing_extensions (top-level), setuptools.config.expand (conditional), setuptools.config.pyprojecttoml (conditional), setuptools.config._validate_pyproject.error_reporting (conditional)
missing module named typing_extensions.deprecated - imported by setuptools._vendor.typing_extensions (top-level), setuptools._distutils.sysconfig (conditional), setuptools._distutils.command.bdist (conditional)
missing module named typing_extensions.TypeAlias - imported by setuptools._vendor.typing_extensions (top-level), setuptools._distutils.compilers.C.base (conditional), setuptools._reqs (conditional), setuptools.warnings (conditional), setuptools._path (conditional), setuptools._distutils.dist (conditional), setuptools.config.setupcfg (conditional), setuptools.config._apply_pyprojecttoml (conditional), setuptools.dist (conditional), setuptools.command.bdist_egg (conditional), setuptools.compat.py311 (conditional)
missing module named typing_extensions.Unpack - imported by setuptools._vendor.typing_extensions (top-level), setuptools._distutils.util (conditional), setuptools._distutils.compilers.C.base (conditional), setuptools._distutils.cmd (conditional)
missing module named typing_extensions.TypeVarTuple - imported by setuptools._vendor.typing_extensions (top-level), setuptools._distutils.util (conditional), setuptools._distutils.compilers.C.base (conditional), setuptools._distutils.cmd (conditional)
missing module named '_typeshed.importlib' - imported by pkg_resources (conditional)
missing module named _typeshed - imported by numpy.random.bit_generator (top-level), setuptools._distutils.dist (conditional), setuptools.glob (conditional), setuptools.compat.py311 (conditional), pkg_resources (conditional)
missing module named jnius - imported by setuptools._vendor.platformdirs.android (delayed, conditional, optional)
missing module named android - imported by setuptools._vendor.platformdirs.android (delayed, conditional, optional)
missing module named importlib_resources - imported by setuptools._vendor.jaraco.text (optional)
missing module named 'collections.abc' - imported by traceback (top-level), typing (top-level), inspect (top-level), logging (top-level), importlib.resources.readers (top-level), selectors (top-level), tracemalloc (top-level), sqlite3.dbapi2 (top-level), PIL.Image (top-level), PIL._typing (top-level), numpy._typing._array_like (top-level), numpy._typing._nested_sequence (conditional), numpy._typing._shape (top-level), numpy._typing._dtype_like (top-level), asyncio.base_events (top-level), http.client (top-level), asyncio.coroutines (top-level), numpy.lib._function_base_impl (top-level), numpy.lib._npyio_impl (top-level), numpy.random._common (top-level), numpy.random._generator (top-level), numpy.random.bit_generator (top-level), setuptools (top-level), setuptools._distutils.filelist (top-level), setuptools._distutils.util (top-level), setuptools._vendor.jaraco.functools (top-level), setuptools._vendor.more_itertools.more (top-level), setuptools._vendor.more_itertools.recipes (top-level), setuptools._distutils._modified (top-level), setuptools._distutils.compat (top-level), setuptools._distutils.spawn (top-level), setuptools._distutils.compilers.C.base (top-level), setuptools._distutils.fancy_getopt (top-level), setuptools._reqs (top-level), setuptools.discovery (top-level), setuptools.dist (top-level), setuptools._distutils.command.bdist (top-level), setuptools._distutils.core (top-level), setuptools._distutils.cmd (top-level), setuptools._distutils.dist (top-level), configparser (top-level), setuptools._distutils.extension (top-level), setuptools.config.setupcfg (top-level), setuptools.config.expand (top-level), setuptools.config.pyprojecttoml (top-level), setuptools.config._apply_pyprojecttoml (top-level), tomllib._parser (top-level), setuptools._vendor.tomli._parser (top-level), setuptools.command.egg_info (top-level), setuptools._distutils.command.build (top-level), setuptools._distutils.command.sdist (top-level), setuptools.glob (top-level), setuptools.command._requirestxt (top-level), setuptools.command.bdist_wheel (top-level), setuptools._vendor.wheel.cli.convert (top-level), setuptools._vendor.wheel.cli.tags (top-level), setuptools._vendor.typing_extensions (top-level), numpy.random.mtrand (top-level), numpy.polynomial._polybase (top-level), xml.etree.ElementTree (top-level), PIL.TiffImagePlugin (top-level), PIL.ImageOps (top-level), PIL.ImagePalette (top-level), PIL.ImageFilter (top-level), PIL.PngImagePlugin (top-level), pandas._typing (top-level), pytz.lazy (optional), pandas.util._exceptions (conditional), pandas._config.config (conditional), pandas.util.version (top-level), pandas.core.dtypes.inference (conditional), pandas.util._validators (top-level), pandas.core.construction (top-level), pandas.core.common (top-level), pandas.util._decorators (conditional), pandas.core.frame (top-level), pandas.core.dtypes.concat (conditional), pandas.core.sorting (conditional), pandas.core.indexes.category (conditional), pandas.core.arrays._arrow_string_mixins (conditional), pandas.core.arrays.masked (conditional), pandas.core.apply (conditional), pandas.core.base (conditional), pandas.core.indexing (conditional), pandas.core.internals.blocks (conditional), pandas.core.arrays.numeric (conditional), pandas.core.arrays.timedeltas (conditional), pandas.io.formats.format (top-level), pandas.core.indexes.range (top-level), pandas.core.tools.timedeltas (conditional), pandas.core.indexes.datetimelike (conditional), pandas.core.reshape.concat (conditional), pandas.io.common (top-level), pandas.io.formats.printing (top-level), pandas.core.indexes.multi (top-level), pandas.io.formats.html (conditional), pandas.io.formats.string (conditional), pandas.io.formats.csvs (top-level), pandas.io.formats.style_render (top-level), pandas.core.interchange.dataframe_protocol (conditional), pandas.core.window.rolling (conditional), pandas.core.series (top-level), pandas.core.arrays.sparse.array (conditional), pandas.core.arrays.sparse.scipy_sparse (conditional), pandas.core.methods.selectn (top-level), pandas.core.strings.accessor (conditional), pandas.core.tools.datetimes (conditional), pandas.io.formats.info (conditional), pandas.plotting._core (conditional), matplotlib (top-level), matplotlib.cbook (top-level), matplotlib._path (top-level), matplotlib.colors (top-level), pyparsing.core (top-level), pyparsing.results (top-level), cycler (top-level), matplotlib.cm (top-level), matplotlib.markers (top-level), matplotlib._mathtext (conditional), matplotlib.axes._base (top-level), matplotlib.spines (top-level), matplotlib.pyplot (conditional), matplotlib.typing (top-level), pandas.plotting._misc (conditional), pandas.core.groupby.grouper (conditional), pandas.core.groupby.ops (conditional), pandas.io._util (conditional), pandas.io.json._normalize (conditional), pandas.io.parsers.base_parser (conditional), pandas.io.parsers.c_parser_wrapper (conditional), pandas.io.parsers.python_parser (top-level), pandas.io.parsers.readers (conditional), pandas.io.json._json (conditional), pandas.io.stata (conditional), pandas.io.formats.style (conditional), pandas.io.formats.excel (top-level), pandas.io.formats.css (conditional), pandas.io.excel._base (top-level), pandas.io.excel._util (top-level), pandas.core.arrays.interval (conditional), pandas.core.indexes.interval (conditional), pandas.core.arrays.period (conditional), pandas.core.indexes.period (conditional), pandas.core.internals.managers (top-level), pandas.core.internals.ops (conditional), pandas.core.internals.array_manager (conditional), pandas.core.internals.construction (conditional), pandas.core.methods.describe (conditional), pandas.core.generic (conditional), pandas.core.computation.parsing (conditional), pandas.compat.pickle_compat (conditional), pandas.core.computation.ops (conditional), pandas.core.computation.align (conditional), pandas.io.pytables (conditional), pandas.io.sql (conditional), pandas.core.groupby.groupby (top-level), pandas.core.strings.base (conditional), pandas.core.strings.object_array (conditional), pandas.core.arrays.string_arrow (conditional), pandas.core.groupby.base (conditional), pandas.core.groupby.indexing (top-level), pandas.core.resample (conditional), pandas.core.groupby.generic (conditional), pandas.core.reshape.merge (top-level), pandas.core.arrays.arrow.array (conditional), pandas.core.arrays.datetimelike (conditional), pandas.core.arrays.datetimes (conditional), pandas.core.indexes.datetimes (conditional), pandas.core.arrays._mixins (conditional), pandas.core.arrays.categorical (conditional), pandas.core.reshape.melt (conditional), pandas.core.interchange.dataframe (conditional), pandas.io.feather_format (conditional), pandas.io.xml (conditional), pandas.core.reshape.pivot (top-level), pandas.core.arrays.base (conditional), pandas.core.internals.concat (conditional), pandas.core.indexes.base (conditional), pandas.core.arrays.numpy_ (conditional), pandas.core.dtypes.cast (conditional), pandas.core.arrays.arrow.accessors (conditional), pandas.core.dtypes.dtypes (conditional), pandas.core.util.hashing (conditional), pandas.core.reshape.encoding (top-level), pandas._config.localization (conditional), pandas._testing.contexts (conditional), _pytest._code.code (top-level), pluggy._hooks (top-level), pluggy._manager (top-level), pluggy._tracing (top-level), pluggy._callers (top-level), _pytest._code.source (top-level), _pytest._io.terminalwriter (top-level), _pytest.compat (top-level), _pytest._py.error (top-level), _pytest._py.path (top-level), _pytest.outcomes (top-level), _pytest.config (top-level), _pytest.config.compat (top-level), _pytest.config.findpaths (top-level), _pytest.pathlib (top-level), _pytest.config.argparsing (top-level), _pytest.hookspec (top-level), _pytest.fixtures (top-level), _pytest.nodes (top-level), _pytest.mark (top-level), _pytest.mark.expression (top-level), _pytest.mark.structures (top-level), _pytest.raises (conditional), _pytest.assertion (top-level), _pytest.assertion.rewrite (top-level), _pytest.assertion.util (top-level), _pytest._io.pprint (top-level), _pytest.python_api (top-level), _pytest.main (top-level), _pytest.reports (top-level), _pytest.runner (top-level), _pytest.terminal (top-level), _pytest.warnings (top-level), _pytest.python (top-level), _pytest.cacheprovider (top-level), _pytest.helpconfig (top-level), _pytest.capture (top-level), _pytest.debugging (top-level), _pytest.doctest (top-level), _pytest.freeze_support (top-level), _pytest.monkeypatch (top-level), pkg_resources (top-level), setuptools._vendor.platformdirs.windows (conditional), _pytest.pytester (top-level), _pytest.tmpdir (top-level), _pytest.pytester_assertions (top-level), _pytest.unraisableexception (top-level), _pytest.logging (top-level), _pytest.recwarn (top-level), pandas._testing._warnings (conditional), pandas.io.html (conditional), pandas.io.sas.sasreader (conditional), pandas.io.spss (conditional), narwhals._compliant.dataframe (top-level), narwhals._compliant.typing (top-level), narwhals._compliant.expr (top-level), narwhals._utils (top-level), narwhals.exceptions (conditional), narwhals._translate (top-level), narwhals._expression_parsing (conditional), narwhals.expr (top-level), narwhals.dtypes (top-level), narwhals.typing (conditional), narwhals.series (top-level), narwhals._compliant.namespace (conditional), narwhals._compliant.selectors (conditional), narwhals._compliant.when_then (conditional), narwhals._compliant.window (conditional), narwhals.schema (conditional), narwhals._compliant.series (conditional), narwhals._arrow.utils (conditional), narwhals._arrow.expr (conditional), narwhals._arrow.dataframe (top-level), narwhals._arrow.group_by (conditional), narwhals._compliant.group_by (conditional), narwhals._arrow.namespace (conditional), narwhals._duckdb.expr_dt (conditional), narwhals._duckdb.expr (conditional), narwhals._duckdb.namespace (conditional), narwhals._duckdb.dataframe (conditional), narwhals._duckdb.group_by (conditional), narwhals.functions (top-level), narwhals.selectors (conditional), narwhals.stable.v1 (conditional), narwhals._pandas_like.dataframe (top-level), narwhals._pandas_like.utils (top-level), narwhals._pandas_like.group_by (conditional), narwhals._pandas_like.expr (conditional), narwhals._pandas_like.namespace (conditional), narwhals._pandas_like.series (conditional), narwhals._polars.dataframe (top-level), narwhals._polars.utils (conditional), narwhals._polars.series (conditional), narwhals._polars.expr (conditional), narwhals._polars.namespace (conditional), narwhals._polars.group_by (conditional), narwhals._dask.utils (conditional), narwhals._dask.expr (conditional), narwhals._dask.dataframe (conditional), narwhals._dask.group_by (conditional), narwhals._arrow.series_dt (conditional), narwhals._arrow.series (conditional), narwhals._dask.namespace (conditional), narwhals.dataframe (conditional), narwhals.group_by (conditional), narwhals._ibis.utils (conditional), narwhals._ibis.expr (conditional), narwhals._ibis.dataframe (conditional), narwhals._ibis.group_by (conditional), narwhals._ibis.namespace (conditional), narwhals._spark_like.expr_dt (conditional), narwhals._spark_like.expr (conditional), narwhals._spark_like.namespace (conditional), narwhals._spark_like.dataframe (conditional), narwhals._spark_like.group_by (conditional), plotly.figure_factory.utils (top-level), _pytest.faulthandler (top-level), _pytest.junitxml (top-level), _pytest.setuponly (top-level), _pytest.skipping (top-level), _pytest.threadexception (top-level), _pytest.unittest (top-level), pandas.plotting._matplotlib.core (top-level), pandas.plotting._matplotlib.tools (conditional), pandas.plotting._matplotlib.converter (conditional), pandas.plotting._matplotlib.style (top-level), pandas.plotting._matplotlib.misc (conditional), pandas.plotting._matplotlib.groupby (conditional), pandas.plotting._matplotlib.boxplot (conditional), PIL.Jpeg2KImagePlugin (top-level), PIL.IptcImagePlugin (top-level), PIL.ImageDraw (top-level), setuptools._distutils.command.build_ext (top-level), _pyrepl.types (top-level), _pyrepl.readline (top-level), setuptools._distutils.compilers.C.msvc (top-level)
excluded module named _frozen_importlib - imported by importlib (optional), importlib.abc (optional), zipimport (top-level)
missing module named vms_lib - imported by platform (delayed, optional)
missing module named 'java.lang' - imported by platform (delayed, optional)
missing module named java - imported by platform (delayed)
missing module named 'plotly.version' - imported by plotly (conditional)
missing module named pyarrow - imported by pandas.core.arrays._arrow_string_mixins (conditional), pandas.core.arrays.masked (delayed), pandas.core.arrays.boolean (delayed, conditional), pandas.core.arrays.numeric (delayed, conditional), pandas.core.arrays.arrow._arrow_utils (top-level), pandas.core.interchange.utils (delayed, conditional), pandas.core.strings.accessor (delayed, conditional), pandas.io._util (conditional), pandas.io.parsers.base_parser (delayed, conditional), pandas.core.arrays.interval (delayed), pandas.core.arrays.arrow.extension_types (top-level), pandas.core.arrays.period (delayed), pandas.core.methods.describe (delayed, conditional), pandas.io.sql (delayed, conditional), pandas.core.arrays.string_arrow (conditional), pandas.core.reshape.merge (delayed, conditional), pandas.core.arrays.arrow.array (conditional), pandas.core.interchange.buffer (conditional), pandas.io.feather_format (delayed), pandas.core.indexes.base (delayed, conditional), pandas.core.dtypes.cast (delayed, conditional), pandas.core.arrays.string_ (delayed, conditional), pandas.core.arrays.arrow.accessors (conditional), pandas.core.dtypes.dtypes (delayed, conditional), pandas.compat.pyarrow (optional), pandas.core.reshape.encoding (delayed, conditional), pandas._testing (conditional), narwhals.dependencies (conditional), narwhals._utils (delayed, conditional), narwhals._translate (conditional), narwhals.schema (delayed, conditional), narwhals._arrow.utils (top-level), narwhals._compliant.series (conditional), narwhals._arrow.series (top-level), narwhals._arrow.series_cat (top-level), narwhals._arrow.typing (conditional), narwhals._arrow.dataframe (top-level), narwhals._arrow.group_by (top-level), narwhals._arrow.namespace (top-level), narwhals._duckdb.dataframe (delayed, conditional), narwhals.functions (delayed, conditional), narwhals.stable.v1.dependencies (conditional), narwhals._pandas_like.utils (delayed, conditional, optional), narwhals._pandas_like.series (delayed, conditional), narwhals._pandas_like.dataframe (delayed, conditional), narwhals._polars.series (conditional), narwhals._polars.dataframe (delayed, conditional), narwhals._dask.dataframe (delayed, conditional), narwhals._arrow.series_dt (top-level), narwhals._arrow.series_list (top-level), narwhals._arrow.series_str (top-level), narwhals._interchange.dataframe (conditional), narwhals.series (delayed, conditional, optional), narwhals.dataframe (delayed, conditional, optional), narwhals._compliant.dataframe (conditional), narwhals._namespace (conditional), narwhals._ibis.dataframe (delayed, conditional), narwhals._spark_like.dataframe (delayed, conditional), plotly.express._core (delayed, conditional)
missing module named numpy.VisibleDeprecationWarning - imported by numpy (optional), matplotlib.cbook (optional)
missing module named _dummy_thread - imported by numpy._core.arrayprint (optional)
missing module named 'numpy_distutils.cpuinfo' - imported by numpy.f2py.diagnose (delayed, conditional, optional)
missing module named 'numpy_distutils.fcompiler' - imported by numpy.f2py.diagnose (delayed, conditional, optional)
missing module named 'numpy_distutils.command' - imported by numpy.f2py.diagnose (delayed, conditional, optional)
missing module named numpy_distutils - imported by numpy.f2py.diagnose (delayed, optional)
missing module named charset_normalizer - imported by numpy.f2py.crackfortran (optional)
missing module named psutil - imported by numpy.testing._private.utils (delayed, optional)
missing module named win32pdh - imported by numpy.testing._private.utils (delayed, conditional)
missing module named numpy.random.RandomState - imported by numpy.random (top-level), numpy.random._generator (top-level)
missing module named threadpoolctl - imported by numpy.lib._utils_impl (delayed, optional)
missing module named numpy._core.zeros - imported by numpy._core (top-level), numpy.linalg._linalg (top-level), numpy (conditional)
missing module named numpy._core.vstack - imported by numpy._core (top-level), numpy.lib._shape_base_impl (top-level), numpy (conditional)
missing module named numpy._core.void - imported by numpy._core (conditional), numpy (conditional)
missing module named numpy._core.vecmat - imported by numpy._core (conditional), numpy (conditional)
missing module named numpy._core.vecdot - imported by numpy._core (top-level), numpy.linalg._linalg (top-level), numpy (conditional)
missing module named numpy._core.ushort - imported by numpy._core (conditional), numpy (conditional)
missing module named numpy._core.unsignedinteger - imported by numpy._core (conditional), numpy (conditional)
missing module named numpy._core.ulonglong - imported by numpy._core (conditional), numpy (conditional)
missing module named numpy._core.ulong - imported by numpy._core (conditional), numpy (conditional)
missing module named numpy._core.uintp - imported by numpy._core (conditional), numpy (conditional)
missing module named numpy._core.uintc - imported by numpy._core (conditional), numpy (conditional)
missing module named numpy._core.uint64 - imported by numpy._core (conditional), numpy (conditional), numpy._array_api_info (top-level)
missing module named numpy._core.uint32 - imported by numpy._core (conditional), numpy (conditional), numpy._array_api_info (top-level)
missing module named numpy._core.uint16 - imported by numpy._core (conditional), numpy (conditional), numpy._array_api_info (top-level)
missing module named numpy._core.uint - imported by numpy._core (conditional), numpy (conditional)
missing module named numpy._core.ubyte - imported by numpy._core (conditional), numpy (conditional)
missing module named numpy._core.trunc - imported by numpy._core (conditional), numpy (conditional)
missing module named numpy._core.true_divide - imported by numpy._core (conditional), numpy (conditional)
missing module named numpy._core.transpose - imported by numpy._core (top-level), numpy.linalg._linalg (top-level), numpy.lib._function_base_impl (top-level), numpy (conditional)
missing module named numpy._core.trace - imported by numpy._core (top-level), numpy.linalg._linalg (top-level), numpy (conditional)
missing module named numpy._core.timedelta64 - imported by numpy._core (conditional), numpy (conditional)
missing module named numpy._core.tensordot - imported by numpy._core (top-level), numpy.linalg._linalg (top-level), numpy (conditional)
missing module named numpy._core.tanh - imported by numpy._core (conditional), numpy (conditional)
missing module named numpy._core.tan - imported by numpy._core (conditional), numpy (conditional)
missing module named numpy._core.swapaxes - imported by numpy._core (top-level), numpy.linalg._linalg (top-level), numpy (conditional)
missing module named numpy._core.sum - imported by numpy._core (top-level), numpy.linalg._linalg (top-level), numpy (conditional)
missing module named numpy._core.subtract - imported by numpy._core (conditional), numpy (conditional)
missing module named numpy._core.str_ - imported by numpy._core (conditional), numpy (conditional)
missing module named numpy._core.square - imported by numpy._core (conditional), numpy (conditional)
missing module named numpy._core.sqrt - imported by numpy._core (top-level), numpy.linalg._linalg (top-level), numpy (conditional), numpy.fft._pocketfft (top-level)
missing module named numpy._core.spacing - imported by numpy._core (conditional), numpy (conditional)
missing module named numpy._core.sort - imported by numpy._core (top-level), numpy.linalg._linalg (top-level), numpy (conditional)
missing module named numpy._core.sinh - imported by numpy._core (conditional), numpy (conditional)
missing module named numpy._core.single - imported by numpy._core (top-level), numpy.linalg._linalg (top-level), numpy (conditional)
missing module named numpy._core.signedinteger - imported by numpy._core (conditional), numpy (conditional)
missing module named numpy._core.signbit - imported by numpy._core (delayed), numpy.testing._private.utils (delayed), numpy (conditional)
missing module named numpy._core.sign - imported by numpy._core (top-level), numpy.linalg._linalg (top-level), numpy (conditional)
missing module named numpy._core.short - imported by numpy._core (conditional), numpy (conditional)
missing module named numpy._core.rint - imported by numpy._core (conditional), numpy (conditional)
missing module named numpy._core.right_shift - imported by numpy._core (conditional), numpy (conditional)
missing module named numpy._core.result_type - imported by numpy._core (delayed), numpy.testing._private.utils (delayed), numpy (conditional), numpy.fft._pocketfft (top-level)
missing module named numpy._core.remainder - imported by numpy._core (conditional), numpy (conditional)
missing module named numpy._core.reciprocal - imported by numpy._core (top-level), numpy.linalg._linalg (top-level), numpy (conditional), numpy.fft._pocketfft (top-level)
missing module named numpy._core.radians - imported by numpy._core (conditional), numpy (conditional)
missing module named numpy._core.rad2deg - imported by numpy._core (conditional), numpy (conditional)
missing module named numpy._core.prod - imported by numpy._core (top-level), numpy.linalg._linalg (top-level), numpy (conditional)
missing module named numpy._core.power - imported by numpy._core (conditional), numpy (conditional)
missing module named numpy._core.positive - imported by numpy._core (conditional), numpy (conditional)
missing module named numpy._core.pi - imported by numpy._core (conditional), numpy (conditional)
missing module named numpy._core.outer - imported by numpy._core (top-level), numpy.linalg._linalg (top-level), numpy (conditional)
missing module named numpy._core.ones - imported by numpy._core (top-level), numpy.lib._polynomial_impl (top-level), numpy (conditional)
missing module named numpy._core.object_ - imported by numpy._core (top-level), numpy.linalg._linalg (top-level), numpy.testing._private.utils (delayed), numpy (conditional)
missing module named numpy._core.number - imported by numpy._core (delayed), numpy.testing._private.utils (delayed), numpy (conditional)
missing module named numpy._core.not_equal - imported by numpy._core (conditional), numpy (conditional)
missing module named numpy._core.newaxis - imported by numpy._core (top-level), numpy.linalg._linalg (top-level), numpy (conditional)
missing module named numpy._core.negative - imported by numpy._core (conditional), numpy (conditional)
missing module named numpy._core.ndarray - imported by numpy._core (top-level), numpy.testing._private.utils (top-level), numpy.lib._utils_impl (top-level), numpy (conditional)
missing module named numpy._core.multiply - imported by numpy._core (top-level), numpy.linalg._linalg (top-level), numpy (conditional)
missing module named numpy._core.moveaxis - imported by numpy._core (top-level), numpy.linalg._linalg (top-level), numpy (conditional)
missing module named numpy._core.modf - imported by numpy._core (conditional), numpy (conditional)
missing module named numpy._core.mod - imported by numpy._core (conditional), numpy (conditional)
missing module named numpy._core.minimum - imported by numpy._core (conditional), numpy (conditional)
missing module named numpy._core.maximum - imported by numpy._core (conditional), numpy (conditional)
missing module named numpy._core.max - imported by numpy._core (delayed), numpy.testing._private.utils (delayed), numpy (conditional)
missing module named numpy._core.matvec - imported by numpy._core (conditional), numpy (conditional)
missing module named numpy._core.matrix_transpose - imported by numpy._core (top-level), numpy.linalg._linalg (top-level), numpy (conditional)
missing module named numpy._core.matmul - imported by numpy._core (top-level), numpy.linalg._linalg (top-level), numpy (conditional)
missing module named numpy._core.longlong - imported by numpy._core (conditional), numpy (conditional)
missing module named numpy._core.longdouble - imported by numpy._core (conditional), numpy (conditional)
missing module named numpy._core.long - imported by numpy._core (conditional), numpy (conditional)
missing module named numpy._core.logical_xor - imported by numpy._core (conditional), numpy (conditional)
missing module named numpy._core.logical_or - imported by numpy._core (conditional), numpy (conditional)
missing module named numpy._core.logical_not - imported by numpy._core (conditional), numpy (conditional)
missing module named numpy._core.logical_and - imported by numpy._core (conditional), numpy (conditional)
missing module named numpy._core.logaddexp2 - imported by numpy._core (conditional), numpy (conditional)
missing module named numpy._core.logaddexp - imported by numpy._core (conditional), numpy (conditional)
missing module named numpy._core.log2 - imported by numpy._core (conditional), numpy (conditional)
missing module named numpy._core.log1p - imported by numpy._core (conditional), numpy (conditional)
missing module named numpy._core.log - imported by numpy._core (conditional), numpy (conditional)
missing module named numpy._core.linspace - imported by numpy._core (top-level), numpy.lib._index_tricks_impl (top-level), numpy (conditional)
missing module named numpy._core.less_equal - imported by numpy._core (conditional), numpy (conditional)
missing module named numpy._core.less - imported by numpy._core (conditional), numpy (conditional)
missing module named numpy._core.left_shift - imported by numpy._core (conditional), numpy (conditional)
missing module named numpy._core.ldexp - imported by numpy._core (conditional), numpy (conditional)
missing module named numpy._core.lcm - imported by numpy._core (conditional), numpy (conditional)
missing module named numpy._core.isscalar - imported by numpy._core (delayed), numpy.testing._private.utils (delayed), numpy.lib._polynomial_impl (top-level), numpy (conditional)
missing module named numpy._core.isnat - imported by numpy._core (top-level), numpy.testing._private.utils (top-level), numpy (conditional)
missing module named numpy._core.isnan - imported by numpy._core (top-level), numpy.linalg._linalg (top-level), numpy.testing._private.utils (delayed), numpy (conditional)
missing module named numpy._core.isfinite - imported by numpy._core (top-level), numpy.linalg._linalg (top-level), numpy (conditional)
missing module named numpy._core.intp - imported by numpy._core (top-level), numpy.linalg._linalg (top-level), numpy.testing._private.utils (top-level), numpy (conditional), numpy._array_api_info (top-level)
missing module named numpy._core.integer - imported by numpy._core (conditional), numpy (conditional), numpy.fft._helper (top-level)
missing module named numpy._core.intc - imported by numpy._core (top-level), numpy.linalg._linalg (top-level), numpy (conditional)
missing module named numpy._core.int64 - imported by numpy._core (conditional), numpy (conditional), numpy._array_api_info (top-level)
missing module named numpy._core.int32 - imported by numpy._core (conditional), numpy (conditional), numpy._array_api_info (top-level)
missing module named numpy._core.int16 - imported by numpy._core (conditional), numpy (conditional), numpy._array_api_info (top-level)
missing module named numpy._core.int8 - imported by numpy._core (conditional), numpy (conditional), numpy._array_api_info (top-level)
missing module named numpy._core.inf - imported by numpy._core (top-level), numpy.linalg._linalg (top-level), numpy.testing._private.utils (delayed), numpy (conditional)
missing module named numpy._core.inexact - imported by numpy._core (top-level), numpy.linalg._linalg (top-level), numpy (conditional)
missing module named numpy._core.iinfo - imported by numpy._core (top-level), numpy.lib._twodim_base_impl (top-level), numpy (conditional)
missing module named numpy._core.hypot - imported by numpy._core (conditional), numpy (conditional)
missing module named numpy._core.hstack - imported by numpy._core (top-level), numpy.lib._polynomial_impl (top-level), numpy (conditional)
missing module named numpy._core.heaviside - imported by numpy._core (conditional), numpy (conditional)
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
missing module named numpy._core.count_nonzero - imported by numpy._core (top-level), numpy.linalg._linalg (top-level), numpy (conditional)
missing module named numpy._core.cosh - imported by numpy._core (conditional), numpy (conditional)
missing module named numpy._core.cos - imported by numpy._core (conditional), numpy (conditional)
missing module named numpy._core.copysign - imported by numpy._core (conditional), numpy (conditional)
missing module named numpy._core.conjugate - imported by numpy._core (conditional), numpy (conditional), numpy.fft._pocketfft (top-level)
missing module named numpy._core.conj - imported by numpy._core (conditional), numpy (conditional)
missing module named numpy._core.complexfloating - imported by numpy._core (top-level), numpy.linalg._linalg (top-level), numpy (conditional)
missing module named numpy._core.complex64 - imported by numpy._core (conditional), numpy (conditional), numpy._array_api_info (top-level)
missing module named numpy._core.clongdouble - imported by numpy._core (conditional), numpy (conditional)
missing module named numpy._core.character - imported by numpy._core (conditional), numpy (conditional)
missing module named numpy._core.ceil - imported by numpy._core (conditional), numpy (conditional)
missing module named numpy._core.cdouble - imported by numpy._core (top-level), numpy.linalg._linalg (top-level), numpy (conditional)
missing module named numpy._core.cbrt - imported by numpy._core (conditional), numpy (conditional)
missing module named numpy._core.bytes_ - imported by numpy._core (conditional), numpy (conditional)
missing module named numpy._core.byte - imported by numpy._core (conditional), numpy (conditional)
missing module named numpy._core.bool_ - imported by numpy._core (conditional), numpy (conditional)
missing module named numpy._core.bitwise_xor - imported by numpy._core (conditional), numpy (conditional)
missing module named numpy._core.bitwise_or - imported by numpy._core (conditional), numpy (conditional)
missing module named numpy._core.bitwise_count - imported by numpy._core (conditional), numpy (conditional)
missing module named numpy._core.bitwise_and - imported by numpy._core (conditional), numpy (conditional)
missing module named numpy._core.atleast_3d - imported by numpy._core (top-level), numpy.lib._shape_base_impl (top-level), numpy (conditional)
missing module named numpy._core.atleast_2d - imported by numpy._core (top-level), numpy.linalg._linalg (top-level), numpy (conditional)
missing module named numpy._core.atleast_1d - imported by numpy._core (top-level), numpy.lib._polynomial_impl (top-level), numpy (conditional)
missing module named numpy._core.asarray - imported by numpy._core (top-level), numpy.linalg._linalg (top-level), numpy.lib._array_utils_impl (top-level), numpy (conditional), numpy.fft._helper (top-level), numpy.fft._pocketfft (top-level)
missing module named numpy._core.asanyarray - imported by numpy._core (top-level), numpy.linalg._linalg (top-level), numpy (conditional)
missing module named numpy._core.array_repr - imported by numpy._core (top-level), numpy.testing._private.utils (top-level), numpy (conditional)
missing module named numpy._core.array2string - imported by numpy._core (delayed), numpy.testing._private.utils (delayed), numpy (conditional)
missing module named numpy._core.array - imported by numpy._core (top-level), numpy.linalg._linalg (top-level), numpy.testing._private.utils (top-level), numpy.lib._polynomial_impl (top-level), numpy (conditional)
missing module named numpy._core.argsort - imported by numpy._core (top-level), numpy.linalg._linalg (top-level), numpy (conditional)
missing module named numpy._core.arctanh - imported by numpy._core (conditional), numpy (conditional)
missing module named numpy._core.arctan2 - imported by numpy._core (conditional), numpy (conditional)
missing module named numpy._core.arctan - imported by numpy._core (conditional), numpy (conditional)
missing module named numpy._core.arcsinh - imported by numpy._core (conditional), numpy (conditional)
missing module named numpy._core.arcsin - imported by numpy._core (conditional), numpy (conditional)
missing module named numpy._core.arccosh - imported by numpy._core (conditional), numpy (conditional)
missing module named numpy._core.arccos - imported by numpy._core (conditional), numpy (conditional)
missing module named numpy._core.arange - imported by numpy._core (top-level), numpy.testing._private.utils (top-level), numpy (conditional), numpy.fft._helper (top-level)
missing module named numpy._core.amin - imported by numpy._core (top-level), numpy.linalg._linalg (top-level), numpy (conditional)
missing module named numpy._core.amax - imported by numpy._core (top-level), numpy.linalg._linalg (top-level), numpy (conditional)
missing module named numpy._core.all - imported by numpy._core (top-level), numpy.linalg._linalg (top-level), numpy.testing._private.utils (delayed), numpy (conditional)
missing module named numpy._core.add - imported by numpy._core (top-level), numpy.linalg._linalg (top-level), numpy (conditional)
missing module named yaml - imported by numpy.__config__ (delayed)
missing module named numpy._distributor_init_local - imported by numpy (optional), numpy._distributor_init (optional)
missing module named polars - imported by narwhals.dependencies (conditional), narwhals._utils (conditional), narwhals.schema (delayed, conditional), narwhals._compliant.series (conditional), narwhals._arrow.dataframe (delayed, conditional), narwhals.stable.v1.dependencies (conditional), narwhals._pandas_like.series (delayed, conditional), narwhals._pandas_like.dataframe (delayed, conditional), narwhals._polars.dataframe (top-level), narwhals._polars.namespace (top-level), narwhals._polars.expr (top-level), narwhals._polars.utils (top-level), narwhals._polars.series (top-level), narwhals._dask.dataframe (delayed, conditional), narwhals._duckdb.dataframe (delayed, conditional), narwhals._arrow.series (delayed, conditional), narwhals.series (conditional), narwhals.dataframe (conditional), narwhals._compliant.dataframe (conditional), narwhals._namespace (conditional), narwhals._ibis.dataframe (delayed, conditional), narwhals._spark_like.dataframe (delayed, conditional)
missing module named 'pyarrow.interchange' - imported by narwhals._interchange.dataframe (delayed)
missing module named dask_expr - imported by narwhals._dask.utils (conditional, optional), narwhals._dask.group_by (conditional, optional)
missing module named 'pyarrow.types' - imported by narwhals._arrow.utils (conditional)
missing module named 'pyarrow.csv' - imported by narwhals._arrow.dataframe (delayed)
missing module named 'pyarrow.parquet' - imported by pandas.io.parquet (delayed), narwhals.functions (delayed, conditional), narwhals._arrow.dataframe (delayed)
missing module named cupy - imported by narwhals._pandas_like.series (delayed, conditional), narwhals._pandas_like.dataframe (delayed, conditional)
missing module named 'modin.pandas' - imported by narwhals.stable.v1.dependencies (conditional), narwhals._pandas_like.dataframe (delayed, conditional)
missing module named dask - imported by narwhals.dependencies (conditional), narwhals._polars.dataframe (delayed, conditional), narwhals._pandas_like.dataframe (delayed, conditional), narwhals._arrow.dataframe (delayed, conditional), narwhals._utils (delayed, conditional)
missing module named 'polars.lazyframe' - imported by narwhals._polars.group_by (conditional)
missing module named 'polars.dataframe' - imported by narwhals._polars.group_by (conditional)
missing module named 'duckdb.typing' - imported by narwhals._duckdb.utils (conditional), narwhals._duckdb.expr (top-level), narwhals._duckdb.namespace (top-level), narwhals._duckdb.dataframe (conditional)
missing module named duckdb - imported by narwhals.dependencies (conditional), narwhals._arrow.dataframe (delayed, conditional), narwhals._duckdb.dataframe (top-level), narwhals._duckdb.utils (top-level), narwhals._duckdb.expr (top-level), narwhals._duckdb.expr_dt (top-level), narwhals._duckdb.expr_list (top-level), narwhals._duckdb.expr_str (top-level), narwhals._duckdb.expr_struct (top-level), narwhals._duckdb.namespace (top-level), narwhals._duckdb.selectors (conditional), narwhals._duckdb.group_by (conditional), narwhals._duckdb.series (conditional), narwhals._polars.dataframe (delayed, conditional), narwhals._pandas_like.dataframe (delayed, conditional), narwhals._namespace (conditional)
missing module named 'pyarrow._stubs_typing' - imported by narwhals._arrow.typing (conditional)
missing module named 'pyarrow.__lib_pxi' - imported by narwhals._arrow.typing (conditional)
missing module named 'pyarrow.compute' - imported by pandas.core.arrays._arrow_string_mixins (conditional), pandas.core.arrays.string_arrow (conditional), pandas.core.reshape.merge (delayed, conditional), pandas.core.arrays.arrow.array (conditional), pandas.core.arrays.arrow.accessors (conditional), narwhals._arrow.utils (top-level), narwhals._arrow.series (top-level), narwhals._arrow.expr (top-level), narwhals._arrow.dataframe (top-level), narwhals._arrow.group_by (top-level), narwhals._arrow.namespace (top-level), narwhals._pandas_like.series_dt (delayed, conditional), narwhals._pandas_like.series (delayed, conditional), narwhals._arrow.series_dt (top-level), narwhals._arrow.series_list (top-level), narwhals._arrow.series_str (top-level), narwhals._arrow.series_struct (top-level)
missing module named numexpr - imported by pandas.core.computation.expressions (conditional), pandas.core.computation.engines (delayed)
missing module named traitlets - imported by pandas.io.formats.printing (delayed, conditional), plotly.basewidget (top-level)
missing module named 'IPython.core' - imported by pandas.io.formats.printing (delayed, conditional)
missing module named IPython - imported by pandas.io.formats.printing (delayed)
missing module named jinja2 - imported by pyparsing.diagram (top-level), pandas.io.formats.style (top-level)
missing module named xlsxwriter - imported by pandas.io.excel._xlsxwriter (delayed)
missing module named 'openpyxl.cell' - imported by pandas.io.excel._openpyxl (delayed)
missing module named 'openpyxl.styles' - imported by pandas.io.excel._openpyxl (delayed)
missing module named 'openpyxl.workbook' - imported by pandas.io.excel._openpyxl (delayed)
missing module named 'openpyxl.descriptors' - imported by pandas.io.excel._openpyxl (conditional)
missing module named openpyxl - imported by pandas.io.excel._openpyxl (delayed, conditional)
missing module named 'odf.config' - imported by pandas.io.excel._odswriter (delayed)
missing module named 'odf.style' - imported by pandas.io.excel._odswriter (delayed)
missing module named 'odf.text' - imported by pandas.io.excel._odfreader (delayed), pandas.io.excel._odswriter (delayed)
missing module named 'odf.table' - imported by pandas.io.excel._odfreader (delayed), pandas.io.excel._odswriter (delayed)
missing module named 'odf.opendocument' - imported by pandas.io.excel._odfreader (delayed), pandas.io.excel._odswriter (delayed)
missing module named xlrd - imported by pandas.io.excel._xlrd (delayed, conditional), pandas.io.excel._base (delayed, conditional)
missing module named pyxlsb - imported by pandas.io.excel._pyxlsb (delayed, conditional)
missing module named 'odf.office' - imported by pandas.io.excel._odfreader (delayed)
missing module named 'odf.element' - imported by pandas.io.excel._odfreader (delayed)
missing module named 'odf.namespaces' - imported by pandas.io.excel._odfreader (delayed)
missing module named odf - imported by pandas.io.excel._odfreader (conditional)
missing module named python_calamine - imported by pandas.io.excel._calamine (delayed, conditional)
missing module named scipy - imported by pandas.core.dtypes.common (delayed, conditional, optional), pandas.core.missing (delayed)
missing module named botocore - imported by pandas.io.common (delayed, conditional, optional)
missing module named railroad - imported by pyparsing.diagram (top-level)
missing module named pyparsing.Word - imported by pyparsing (delayed), pyparsing.unicode (delayed)
missing module named six.moves.range - imported by six.moves (top-level), dateutil.rrule (top-level)
runtime module named six.moves - imported by dateutil.tz.tz (top-level), dateutil.tz._factories (top-level), dateutil.tz.win (top-level), dateutil.rrule (top-level)
missing module named StringIO - imported by six (conditional)
missing module named dateutil.tz.tzfile - imported by dateutil.tz (top-level), dateutil.zoneinfo (top-level)
missing module named 'tornado.template' - imported by matplotlib.backends.backend_webagg (delayed)
missing module named 'tornado.websocket' - imported by matplotlib.backends.backend_webagg (top-level)
missing module named 'tornado.ioloop' - imported by matplotlib.backends.backend_webagg (top-level)
missing module named 'tornado.web' - imported by matplotlib.backends.backend_webagg (top-level)
missing module named tornado - imported by matplotlib.backends.backend_webagg (optional), matplotlib.backends.backend_webagg_core (delayed)
missing module named gi - imported by matplotlib.cbook (delayed, conditional)
missing module named certifi - imported by matplotlib (delayed, optional)
missing module named setuptools_scm - imported by matplotlib (delayed, conditional, optional)
missing module named markupsafe - imported by pandas.io.formats.style_render (top-level)
missing module named numba - imported by pandas.core._numba.executor (delayed, conditional), pandas.core.util.numba_ (delayed, conditional), pandas.core.window.numba_ (delayed, conditional), pandas.core.window.online (delayed, conditional), pandas.core._numba.kernels.mean_ (top-level), pandas.core._numba.kernels.shared (top-level), pandas.core._numba.kernels.sum_ (top-level), pandas.core._numba.kernels.min_max_ (top-level), pandas.core._numba.kernels.var_ (top-level), pandas.core.groupby.numba_ (delayed, conditional), pandas.core._numba.extensions (top-level)
missing module named google - imported by pandas.io.gbq (conditional)
missing module named Foundation - imported by pandas.io.clipboard (delayed, conditional, optional)
missing module named AppKit - imported by pandas.io.clipboard (delayed, conditional, optional)
missing module named PyQt4 - imported by pandas.io.clipboard (delayed, conditional, optional)
missing module named qtpy - imported by pandas.io.clipboard (delayed, conditional, optional)
missing module named 'sqlalchemy.engine' - imported by pandas.io.sql (delayed)
missing module named 'sqlalchemy.types' - imported by pandas.io.sql (delayed, conditional)
missing module named 'sqlalchemy.schema' - imported by pandas.io.sql (delayed)
missing module named 'sqlalchemy.sql' - imported by pandas.io.sql (conditional)
missing module named sqlalchemy - imported by pandas.io.sql (delayed, conditional)
missing module named pandas.core.internals.Block - imported by pandas.core.internals (conditional), pandas.io.pytables (conditional)
missing module named tables - imported by pandas.io.pytables (delayed, conditional)
missing module named 'scipy.stats' - imported by pandas.core.nanops (delayed, conditional), pandas.plotting._matplotlib.misc (delayed, conditional), pandas.plotting._matplotlib.hist (delayed)
missing module named sets - imported by pytz.tzinfo (optional)
missing module named collections.Mapping - imported by collections (optional), pytz.lazy (optional)
missing module named UserDict - imported by pytz.lazy (optional)
missing module named 'numba.extending' - imported by pandas.core._numba.kernels.sum_ (top-level)
missing module named 'numba.typed' - imported by pandas.core._numba.extensions (delayed)
missing module named 'numba.core' - imported by pandas.core._numba.extensions (top-level)
missing module named 'scipy.sparse' - imported by pandas.core.arrays.sparse.array (conditional), pandas.core.arrays.sparse.scipy_sparse (delayed, conditional), pandas.core.arrays.sparse.accessor (delayed)
missing module named 'lxml.etree' - imported by pandas.io.xml (delayed), pandas.io.formats.xml (delayed), pandas.io.html (delayed)
missing module named lxml - imported by pandas.io.xml (conditional)
missing module named 'pyarrow.fs' - imported by pandas.io.orc (conditional)
missing module named fsspec - imported by pandas.io.orc (conditional)
missing module named 'dask.array' - imported by narwhals._dask.expr (delayed)
missing module named 'dask.dataframe' - imported by narwhals._dask.namespace (top-level), narwhals.stable.v1.dependencies (conditional), narwhals._polars.dataframe (delayed, conditional), narwhals._dask.dataframe (top-level), narwhals._dask.utils (conditional, optional), narwhals._dask.expr_dt (conditional), narwhals._dask.expr_str (top-level), narwhals._dask.expr (conditional), narwhals._dask.group_by (top-level), narwhals._pandas_like.dataframe (delayed, conditional), narwhals._arrow.dataframe (delayed, conditional), narwhals._dask.selectors (conditional)
missing module named 'sqlframe.base' - imported by narwhals._spark_like.utils (delayed, conditional), narwhals._spark_like.expr_dt (conditional), narwhals._spark_like.expr_str (conditional), narwhals._spark_like.expr_struct (conditional), narwhals._spark_like.expr (delayed, conditional), narwhals._spark_like.selectors (conditional), narwhals._spark_like.namespace (delayed, conditional), narwhals._spark_like.dataframe (delayed, conditional), narwhals._spark_like.group_by (conditional), narwhals.dependencies (delayed, conditional)
missing module named 'ibis.common' - imported by narwhals._ibis.utils (conditional)
missing module named 'ibis.selectors' - imported by narwhals._ibis.dataframe (delayed)
missing module named 'ibis.expr' - imported by narwhals._ibis.namespace (top-level), narwhals._ibis.dataframe (top-level), narwhals._ibis.utils (top-level), narwhals._ibis.expr_dt (conditional), narwhals._ibis.expr_str (top-level), narwhals._ibis.expr_struct (conditional), narwhals._ibis.expr (conditional), narwhals._ibis.group_by (conditional), narwhals._ibis.selectors (conditional)
missing module named ibis - imported by narwhals.dependencies (conditional), narwhals.stable.v1.dependencies (conditional), narwhals._ibis.namespace (top-level), narwhals._ibis.dataframe (top-level), narwhals._ibis.utils (top-level), narwhals._ibis.expr (top-level), narwhals._ibis.expr_str (top-level)
missing module named 'pyspark.sql' - imported by narwhals.dependencies (delayed, conditional, optional), narwhals._namespace (conditional), narwhals._spark_like.utils (delayed, conditional)
missing module named cudf - imported by narwhals.dependencies (conditional), narwhals.stable.v1.dependencies (conditional)
missing module named pyspark - imported by narwhals.dependencies (conditional), narwhals._utils (delayed, conditional)
missing module named modin - imported by narwhals.dependencies (conditional)
missing module named sqlframe - imported by narwhals._utils (delayed, conditional)
missing module named BaseHTTPServer - imported by plotly.io._base_renderers (optional)
missing module named anywidget - imported by plotly.basewidget (top-level)
missing module named ipywidgets - imported by plotly.graph_objects (delayed, conditional, optional), plotly.graph_objs (delayed, conditional, optional)
missing module named 'google.colab' - imported by plotly.io._renderers (conditional, optional)
missing module named requests - imported by plotly.io._orca (delayed)
missing module named choreographer - imported by plotly.io._kaleido (delayed, conditional)
missing module named 'kaleido.errors' - imported by plotly.io._kaleido (delayed, conditional)
missing module named 'kaleido.scopes' - imported by plotly.io._kaleido (conditional, optional)
missing module named kaleido - imported by plotly.io._kaleido (delayed, conditional, optional)
missing module named 'statsmodels.api' - imported by plotly.express.trendline_functions (delayed)
missing module named statsmodels - imported by plotly.express.trendline_functions (delayed)
missing module named plotly.colors.sequential - imported by plotly.colors (top-level), plotly.express._core (top-level)
missing module named plotly.colors.qualitative - imported by plotly.colors (top-level), plotly.express._core (top-level)
missing module named skimage - imported by plotly.figure_factory._ternary_contour (top-level)
missing module named 'lxml.html' - imported by pandas.io.html (delayed)
missing module named bs4 - imported by pandas.io.html (delayed)
missing module named exceptiongroup - imported by _pytest.raises (conditional), _pytest.runner (conditional), _pytest.fixtures (conditional), _pytest._code.code (conditional), _pytest.unraisableexception (conditional), _pytest.threadexception (conditional), _pytest.unittest (conditional)
missing module named 'twisted.python' - imported by _pytest.unittest (delayed, conditional)
missing module named zope - imported by _pytest.unittest (delayed, conditional)
missing module named 'twisted.trial' - imported by _pytest.unittest (delayed, conditional)
missing module named twisted - imported by _pytest.unittest (conditional)
missing module named pygments.lexers.PrologLexer - imported by pygments.lexers (top-level), pygments.lexers.cplint (top-level)
missing module named chardet - imported by pygments.lexer (delayed, conditional, optional)
missing module named _winreg - imported by pygments.formatters.img (optional)
missing module named ctags - imported by pygments.formatters.html (optional)
missing module named argcomplete - imported by _pytest._argcomplete (conditional, optional)
missing module named pexpect - imported by _pytest.pytester (conditional), _pytest.legacypath (conditional)
missing module named xarray - imported by plotly.express._imshow (optional)
missing module named olefile - imported by PIL.FpxImagePlugin (top-level), PIL.MicImagePlugin (top-level)
missing module named PIL._avif - imported by PIL (optional), PIL.AvifImagePlugin (optional)
missing module named defusedxml - imported by PIL.Image (optional)
