baumann06/Diplomarbeit_Sicherung_Privat/Diplomarbeit/Zeiterfassung/TimeTracker/build/build_app/xref-build_app.html

# modulegraph cross reference for pyi_rth__tkinter.py, pyi_rth_inspect.py, pyi_rth_mplconfig.py, pyi_rth_multiprocessing.py, pyi_rth_pkgres.py, pyi_rth_pkgutil.py, pyi_rth_setuptools.py, time_tracker_working.py

pyi_rth__tkinter.py Script

imports: os • sys

imported by: time_tracker_working.py

pyi_rth_inspect.py Script

imports: inspect • os • sys • zipfile

imported by: time_tracker_working.py

pyi_rth_mplconfig.py Script

imports: _pyi_rth_utils.tempfile • atexit • os • shutil

imported by: time_tracker_working.py

pyi_rth_multiprocessing.py Script

imports: multiprocessing • multiprocessing.spawn • subprocess • sys

imported by: time_tracker_working.py

pyi_rth_pkgres.py Script

imports: os • pathlib • pkg_resources • pyimod02_importers • sys • warnings

imported by: time_tracker_working.py

pyi_rth_pkgutil.py Script

imports: pkgutil • pyimod02_importers

imported by: time_tracker_working.py

pyi_rth_setuptools.py Script

imports: _distutils_hack • os • setuptools

imported by: time_tracker_working.py

time_tracker_working.py Script

imports: PIL • PIL.Image • PIL.ImageTk • PIL._tkinter_finder • _collections_abc • _weakrefset • abc • codecs • collections • copyreg • csv • datetime • encodings • encodings.aliases • encodings.ascii • encodings.base64_codec • encodings.big5 • encodings.big5hkscs • encodings.bz2_codec • encodings.charmap • encodings.cp037 • encodings.cp1006 • encodings.cp1026 • encodings.cp1125 • encodings.cp1140 • encodings.cp1250 • encodings.cp1251 • encodings.cp1252 • encodings.cp1253 • encodings.cp1254 • encodings.cp1255 • encodings.cp1256 • encodings.cp1257 • encodings.cp1258 • encodings.cp273 • encodings.cp424 • encodings.cp437 • encodings.cp500 • encodings.cp720 • encodings.cp737 • encodings.cp775 • encodings.cp850 • encodings.cp852 • encodings.cp855 • encodings.cp856 • encodings.cp857 • encodings.cp858 • encodings.cp860 • encodings.cp861 • encodings.cp862 • encodings.cp863 • encodings.cp864 • encodings.cp865 • encodings.cp866 • encodings.cp869 • encodings.cp874 • encodings.cp875 • encodings.cp932 • encodings.cp949 • encodings.cp950 • encodings.euc_jis_2004 • encodings.euc_jisx0213 • encodings.euc_jp • encodings.euc_kr • encodings.gb18030 • encodings.gb2312 • encodings.gbk • encodings.hex_codec • encodings.hp_roman8 • encodings.hz • encodings.idna • encodings.iso2022_jp • encodings.iso2022_jp_1 • encodings.iso2022_jp_2 • encodings.iso2022_jp_2004 • encodings.iso2022_jp_3 • encodings.iso2022_jp_ext • encodings.iso2022_kr • encodings.iso8859_1 • encodings.iso8859_10 • encodings.iso8859_11 • encodings.iso8859_13 • encodings.iso8859_14 • encodings.iso8859_15 • encodings.iso8859_16 • encodings.iso8859_2 • encodings.iso8859_3 • encodings.iso8859_4 • encodings.iso8859_5 • encodings.iso8859_6 • encodings.iso8859_7 • encodings.iso8859_8 • encodings.iso8859_9 • encodings.johab • encodings.koi8_r • encodings.koi8_t • encodings.koi8_u • encodings.kz1048 • encodings.latin_1 • encodings.mac_arabic • encodings.mac_croatian • encodings.mac_cyrillic • encodings.mac_farsi • encodings.mac_greek • encodings.mac_iceland • encodings.mac_latin2 • encodings.mac_roman • encodings.mac_romanian • encodings.mac_turkish • encodings.mbcs • encodings.oem • encodings.palmos • encodings.ptcp154 • encodings.punycode • encodings.quopri_codec • encodings.raw_unicode_escape • encodings.rot_13 • encodings.shift_jis • encodings.shift_jis_2004 • encodings.shift_jisx0213 • encodings.tis_620 • encodings.undefined • encodings.unicode_escape • encodings.utf_16 • encodings.utf_16_be • encodings.utf_16_le • encodings.utf_32 • encodings.utf_32_be • encodings.utf_32_le • encodings.utf_7 • encodings.utf_8 • encodings.utf_8_sig • encodings.uu_codec • encodings.zlib_codec • enum • functools • genericpath • heapq • io • json • keyword • linecache • locale • ntpath • operator • os • pandas • plotly • plotly.express • plotly.offline • posixpath • pyi_rth__tkinter.py • pyi_rth_inspect.py • pyi_rth_mplconfig.py • pyi_rth_multiprocessing.py • pyi_rth_pkgres.py • pyi_rth_pkgutil.py • pyi_rth_setuptools.py • re • re._casefix • re._compiler • re._constants • re._parser • reprlib • sqlite3 • sre_compile • sre_constants • sre_parse • stat • threading • time • tkinter • tkinter.filedialog • tkinter.messagebox • tkinter.ttk • traceback • types • warnings • weakref

'IPython.core' MissingModule

imported by: pandas.io.formats.printing

'_typeshed.importlib' MissingModule

imported by: pkg_resources

'collections.abc' MissingModule

imported by: PIL.Image • PIL.ImageDraw • PIL.ImageFilter • PIL.ImageOps • PIL.ImagePalette • PIL.IptcImagePlugin • PIL.Jpeg2KImagePlugin • PIL.PngImagePlugin • PIL.TiffImagePlugin • PIL._typing • _pyrepl.readline • _pyrepl.types • _pytest._code.code • _pytest._code.source • _pytest._io.pprint • _pytest._io.terminalwriter • _pytest._py.error • _pytest._py.path • _pytest.assertion • _pytest.assertion.rewrite • _pytest.assertion.util • _pytest.cacheprovider • _pytest.capture • _pytest.compat • _pytest.config • _pytest.config.argparsing • _pytest.config.compat • _pytest.config.findpaths • _pytest.debugging • _pytest.doctest • _pytest.faulthandler • _pytest.fixtures • _pytest.freeze_support • _pytest.helpconfig • _pytest.hookspec • _pytest.junitxml • _pytest.logging • _pytest.main • _pytest.mark • _pytest.mark.expression • _pytest.mark.structures • _pytest.monkeypatch • _pytest.nodes • _pytest.outcomes • _pytest.pathlib • _pytest.pytester • _pytest.pytester_assertions • _pytest.python • _pytest.python_api • _pytest.raises • _pytest.recwarn • _pytest.reports • _pytest.runner • _pytest.setuponly • _pytest.skipping • _pytest.terminal • _pytest.threadexception • _pytest.tmpdir • _pytest.unittest • _pytest.unraisableexception • _pytest.warnings • asyncio.base_events • asyncio.coroutines • configparser • cycler • http.client • importlib.resources.readers • inspect • logging • matplotlib • matplotlib._mathtext • matplotlib._path • matplotlib.axes._base • matplotlib.cbook • matplotlib.cm • matplotlib.colors • matplotlib.markers • matplotlib.pyplot • matplotlib.spines • matplotlib.typing • narwhals._arrow.dataframe • narwhals._arrow.expr • narwhals._arrow.group_by • narwhals._arrow.namespace • narwhals._arrow.series • narwhals._arrow.series_dt • narwhals._arrow.utils • narwhals._compliant.dataframe • narwhals._compliant.expr • narwhals._compliant.group_by • narwhals._compliant.namespace • narwhals._compliant.selectors • narwhals._compliant.series • narwhals._compliant.typing • narwhals._compliant.when_then • narwhals._compliant.window • narwhals._dask.dataframe • narwhals._dask.expr • narwhals._dask.group_by • narwhals._dask.namespace • narwhals._dask.utils • narwhals._duckdb.dataframe • narwhals._duckdb.expr • narwhals._duckdb.expr_dt • narwhals._duckdb.group_by • narwhals._duckdb.namespace • narwhals._expression_parsing • narwhals._ibis.dataframe • narwhals._ibis.expr • narwhals._ibis.group_by • narwhals._ibis.namespace • narwhals._ibis.utils • narwhals._pandas_like.dataframe • narwhals._pandas_like.expr • narwhals._pandas_like.group_by • narwhals._pandas_like.namespace • narwhals._pandas_like.series • narwhals._pandas_like.utils • narwhals._polars.dataframe • narwhals._polars.expr • narwhals._polars.group_by • narwhals._polars.namespace • narwhals._polars.series • narwhals._polars.utils • narwhals._spark_like.dataframe • narwhals._spark_like.expr • narwhals._spark_like.expr_dt • narwhals._spark_like.group_by • narwhals._spark_like.namespace • narwhals._translate • narwhals._utils • narwhals.dataframe • narwhals.dtypes • narwhals.exceptions • narwhals.expr • narwhals.functions • narwhals.group_by • narwhals.schema • narwhals.selectors • narwhals.series • narwhals.stable.v1 • narwhals.typing • numpy._typing._array_like • numpy._typing._dtype_like • numpy._typing._nested_sequence • numpy._typing._shape • numpy.lib._function_base_impl • numpy.lib._npyio_impl • numpy.polynomial._polybase • numpy.random._common • numpy.random._generator • numpy.random.bit_generator • numpy.random.mtrand • pandas._config.config • pandas._config.localization • pandas._testing._warnings • pandas._testing.contexts • pandas._typing • pandas.compat.pickle_compat • pandas.core.apply • pandas.core.arrays._arrow_string_mixins • pandas.core.arrays._mixins • pandas.core.arrays.arrow.accessors • pandas.core.arrays.arrow.array • pandas.core.arrays.base • pandas.core.arrays.categorical • pandas.core.arrays.datetimelike • pandas.core.arrays.datetimes • pandas.core.arrays.interval • pandas.core.arrays.masked • pandas.core.arrays.numeric • pandas.core.arrays.numpy_ • pandas.core.arrays.period • pandas.core.arrays.sparse.array • pandas.core.arrays.sparse.scipy_sparse • pandas.core.arrays.string_arrow • pandas.core.arrays.timedeltas • pandas.core.base • pandas.core.common • pandas.core.computation.align • pandas.core.computation.ops • pandas.core.computation.parsing • pandas.core.construction • pandas.core.dtypes.cast • pandas.core.dtypes.concat • pandas.core.dtypes.dtypes • pandas.core.dtypes.inference • pandas.core.frame • pandas.core.generic • pandas.core.groupby.base • pandas.core.groupby.generic • pandas.core.groupby.groupby • pandas.core.groupby.grouper • pandas.core.groupby.indexing • pandas.core.groupby.ops • pandas.core.indexes.base • pandas.core.indexes.category • pandas.core.indexes.datetimelike • pandas.core.indexes.datetimes • pandas.core.indexes.interval • pandas.core.indexes.multi • pandas.core.indexes.period • pandas.core.indexes.range • pandas.core.indexing • pandas.core.interchange.dataframe • pandas.core.interchange.dataframe_protocol • pandas.core.internals.array_manager • pandas.core.internals.blocks • pandas.core.internals.concat • pandas.core.internals.construction • pandas.core.internals.managers • pandas.core.internals.ops • pandas.core.methods.describe • pandas.core.methods.selectn • pandas.core.resample • pandas.core.reshape.concat • pandas.core.reshape.encoding • pandas.core.reshape.melt • pandas.core.reshape.merge • pandas.core.reshape.pivot • pandas.core.series • pandas.core.sorting • pandas.core.strings.accessor • pandas.core.strings.base • pandas.core.strings.object_array • pandas.core.tools.datetimes • pandas.core.tools.timedeltas • pandas.core.util.hashing • pandas.core.window.rolling • pandas.io._util • pandas.io.common • pandas.io.excel._base • pandas.io.excel._util • pandas.io.feather_format • pandas.io.formats.css • pandas.io.formats.csvs • pandas.io.formats.excel • pandas.io.formats.format • pandas.io.formats.html • pandas.io.formats.info • pandas.io.formats.printing • pandas.io.formats.string • pandas.io.formats.style • pandas.io.formats.style_render • pandas.io.html • pandas.io.json._json • pandas.io.json._normalize • pandas.io.parsers.base_parser • pandas.io.parsers.c_parser_wrapper • pandas.io.parsers.python_parser • pandas.io.parsers.readers • pandas.io.pytables • pandas.io.sas.sasreader • pandas.io.spss • pandas.io.sql • pandas.io.stata • pandas.io.xml • pandas.plotting._core • pandas.plotting._matplotlib.boxplot • pandas.plotting._matplotlib.converter • pandas.plotting._matplotlib.core • pandas.plotting._matplotlib.groupby • pandas.plotting._matplotlib.misc • pandas.plotting._matplotlib.style • pandas.plotting._matplotlib.tools • pandas.plotting._misc • pandas.util._decorators • pandas.util._exceptions • pandas.util._validators • pandas.util.version • pkg_resources • plotly.figure_factory.utils • pluggy._callers • pluggy._hooks • pluggy._manager • pluggy._tracing • pyparsing.core • pyparsing.results • pytz.lazy • selectors • setuptools • setuptools._distutils._modified • setuptools._distutils.cmd • setuptools._distutils.command.bdist • setuptools._distutils.command.build • setuptools._distutils.command.build_ext • setuptools._distutils.command.sdist • setuptools._distutils.compat • setuptools._distutils.compilers.C.base • setuptools._distutils.compilers.C.msvc • setuptools._distutils.core • setuptools._distutils.dist • setuptools._distutils.extension • setuptools._distutils.fancy_getopt • setuptools._distutils.filelist • setuptools._distutils.spawn • setuptools._distutils.util • setuptools._reqs • setuptools._vendor.jaraco.functools • setuptools._vendor.more_itertools.more • setuptools._vendor.more_itertools.recipes • setuptools._vendor.platformdirs.windows • setuptools._vendor.tomli._parser • setuptools._vendor.typing_extensions • setuptools._vendor.wheel.cli.convert • setuptools._vendor.wheel.cli.tags • setuptools.command._requirestxt • setuptools.command.bdist_wheel • setuptools.command.egg_info • setuptools.config._apply_pyprojecttoml • setuptools.config.expand • setuptools.config.pyprojecttoml • setuptools.config.setupcfg • setuptools.discovery • setuptools.dist • setuptools.glob • sqlite3.dbapi2 • tomllib._parser • traceback • tracemalloc • typing • xml.etree.ElementTree

'dask.array' MissingModule

imported by: narwhals._dask.expr

'dask.dataframe' MissingModule

imported by: narwhals._arrow.dataframe • narwhals._dask.dataframe • narwhals._dask.expr • narwhals._dask.expr_dt • narwhals._dask.expr_str • narwhals._dask.group_by • narwhals._dask.namespace • narwhals._dask.selectors • narwhals._dask.utils • narwhals._pandas_like.dataframe • narwhals._polars.dataframe • narwhals.stable.v1.dependencies

'duckdb.typing' MissingModule

imported by: narwhals._duckdb.dataframe • narwhals._duckdb.expr • narwhals._duckdb.namespace • narwhals._duckdb.utils

'google.colab' MissingModule

imported by: plotly.io._renderers

'ibis.common' MissingModule

imported by: narwhals._ibis.utils

'ibis.expr' MissingModule

imported by: narwhals._ibis.dataframe • narwhals._ibis.expr • narwhals._ibis.expr_dt • narwhals._ibis.expr_str • narwhals._ibis.expr_struct • narwhals._ibis.group_by • narwhals._ibis.namespace • narwhals._ibis.selectors • narwhals._ibis.utils

'ibis.selectors' MissingModule

imported by: narwhals._ibis.dataframe

'java.lang' MissingModule

imported by: platform

'kaleido.errors' MissingModule

imported by: plotly.io._kaleido

'kaleido.scopes' MissingModule

imported by: plotly.io._kaleido

'lxml.etree' MissingModule

imported by: pandas.io.formats.xml • pandas.io.html • pandas.io.xml

'lxml.html' MissingModule

imported by: pandas.io.html

'modin.pandas' MissingModule

imported by: narwhals._pandas_like.dataframe • narwhals.stable.v1.dependencies

'numba.core' MissingModule

imported by: pandas.core._numba.extensions

'numba.extending' MissingModule

imported by: pandas.core._numba.kernels.sum_

'numba.typed' MissingModule

imported by: pandas.core._numba.extensions

'numpy_distutils.command' MissingModule

imported by: numpy.f2py.diagnose

'numpy_distutils.cpuinfo' MissingModule

imported by: numpy.f2py.diagnose

'numpy_distutils.fcompiler' MissingModule

imported by: numpy.f2py.diagnose

'odf.config' MissingModule

imported by: pandas.io.excel._odswriter

'odf.element' MissingModule

imported by: pandas.io.excel._odfreader

'odf.namespaces' MissingModule

imported by: pandas.io.excel._odfreader

'odf.office' MissingModule

imported by: pandas.io.excel._odfreader

'odf.opendocument' MissingModule

imported by: pandas.io.excel._odfreader • pandas.io.excel._odswriter

'odf.style' MissingModule

imported by: pandas.io.excel._odswriter

'odf.table' MissingModule

imported by: pandas.io.excel._odfreader • pandas.io.excel._odswriter

'odf.text' MissingModule

imported by: pandas.io.excel._odfreader • pandas.io.excel._odswriter

'openpyxl.cell' MissingModule

imported by: pandas.io.excel._openpyxl

'openpyxl.descriptors' MissingModule

imported by: pandas.io.excel._openpyxl

'openpyxl.styles' MissingModule

imported by: pandas.io.excel._openpyxl

'openpyxl.workbook' MissingModule

imported by: pandas.io.excel._openpyxl

'plotly.version' MissingModule

imported by: plotly

'polars.dataframe' MissingModule

imported by: narwhals._polars.group_by

'polars.lazyframe' MissingModule

imported by: narwhals._polars.group_by

'pyarrow.__lib_pxi' MissingModule

imported by: narwhals._arrow.typing

'pyarrow._stubs_typing' MissingModule

imported by: narwhals._arrow.typing

'pyarrow.compute' MissingModule

imported by: narwhals._arrow.dataframe • narwhals._arrow.expr • narwhals._arrow.group_by • narwhals._arrow.namespace • narwhals._arrow.series • narwhals._arrow.series_dt • narwhals._arrow.series_list • narwhals._arrow.series_str • narwhals._arrow.series_struct • narwhals._arrow.utils • narwhals._pandas_like.series • narwhals._pandas_like.series_dt • pandas.core.arrays._arrow_string_mixins • pandas.core.arrays.arrow.accessors • pandas.core.arrays.arrow.array • pandas.core.arrays.string_arrow • pandas.core.reshape.merge

'pyarrow.csv' MissingModule

imported by: narwhals._arrow.dataframe

'pyarrow.fs' MissingModule

imported by: pandas.io.orc

'pyarrow.interchange' MissingModule

imported by: narwhals._interchange.dataframe

'pyarrow.parquet' MissingModule

imported by: narwhals._arrow.dataframe • narwhals.functions • pandas.io.parquet

'pyarrow.types' MissingModule

imported by: narwhals._arrow.utils

'pyspark.sql' MissingModule

imported by: narwhals._namespace • narwhals._spark_like.utils • narwhals.dependencies

'scipy.sparse' MissingModule

imported by: pandas.core.arrays.sparse.accessor • pandas.core.arrays.sparse.array • pandas.core.arrays.sparse.scipy_sparse

'scipy.stats' MissingModule

imported by: pandas.core.nanops • pandas.plotting._matplotlib.hist • pandas.plotting._matplotlib.misc

'sqlalchemy.engine' MissingModule

imported by: pandas.io.sql

'sqlalchemy.schema' MissingModule

imported by: pandas.io.sql

'sqlalchemy.sql' MissingModule

imported by: pandas.io.sql

'sqlalchemy.types' MissingModule

imported by: pandas.io.sql

'sqlframe.base' MissingModule

imported by: narwhals._spark_like.dataframe • narwhals._spark_like.expr • narwhals._spark_like.expr_dt • narwhals._spark_like.expr_str • narwhals._spark_like.expr_struct • narwhals._spark_like.group_by • narwhals._spark_like.namespace • narwhals._spark_like.selectors • narwhals._spark_like.utils • narwhals.dependencies

'statsmodels.api' MissingModule

imported by: plotly.express.trendline_functions

'tornado.ioloop' MissingModule

imported by: matplotlib.backends.backend_webagg

'tornado.template' MissingModule

imported by: matplotlib.backends.backend_webagg

'tornado.web' MissingModule

imported by: matplotlib.backends.backend_webagg

'tornado.websocket' MissingModule

imported by: matplotlib.backends.backend_webagg

'twisted.python' MissingModule

imported by: _pytest.unittest

'twisted.trial' MissingModule

imported by: _pytest.unittest

AppKit MissingModule

imported by: pandas.io.clipboard

BaseHTTPServer MissingModule

imported by: plotly.io._base_renderers

Foundation MissingModule

imported by: pandas.io.clipboard

IPython MissingModule

imported by: pandas.io.formats.printing

PIL Package

imports: PIL • PIL.BmpImagePlugin • PIL.ExifTags • PIL.GifImagePlugin • PIL.GimpGradientFile • PIL.GimpPaletteFile • PIL.Image • PIL.ImageChops • PIL.ImageCms • PIL.ImageColor • PIL.ImageDraw • PIL.ImageDraw2 • PIL.ImageFile • PIL.ImageFilter • PIL.ImageFont • PIL.ImageMath • PIL.ImageMode • PIL.ImageOps • PIL.ImagePalette • PIL.ImagePath • PIL.ImageQt • PIL.ImageSequence • PIL.ImageShow • PIL.ImageTk • PIL.ImageWin • PIL.Jpeg2KImagePlugin • PIL.JpegImagePlugin • PIL.PaletteFile • PIL.PdfParser • PIL.PngImagePlugin • PIL.PpmImagePlugin • PIL.TiffImagePlugin • PIL.TiffTags • PIL._avif • PIL._imaging • PIL._imagingcms • PIL._imagingmath • PIL._imagingtk • PIL._version • PIL._webp • PIL.features • __future__

imported by: PIL • PIL.AvifImagePlugin • PIL.BlpImagePlugin • PIL.BmpImagePlugin • PIL.BufrStubImagePlugin • PIL.CurImagePlugin • PIL.DcxImagePlugin • PIL.DdsImagePlugin • PIL.EpsImagePlugin • PIL.ExifTags • PIL.FitsImagePlugin • PIL.FliImagePlugin • PIL.FpxImagePlugin • PIL.FtexImagePlugin • PIL.GbrImagePlugin • PIL.GifImagePlugin • PIL.GimpGradientFile • PIL.GimpPaletteFile • PIL.GribStubImagePlugin • PIL.Hdf5StubImagePlugin • PIL.IcnsImagePlugin • PIL.IcoImagePlugin • PIL.ImImagePlugin • PIL.Image • PIL.ImageChops • PIL.ImageCms • PIL.ImageColor • PIL.ImageDraw • PIL.ImageDraw2 • PIL.ImageFile • PIL.ImageFilter • PIL.ImageFont • PIL.ImageMath • PIL.ImageMode • PIL.ImageOps • PIL.ImagePalette • PIL.ImagePath • PIL.ImageQt • PIL.ImageSequence • PIL.ImageShow • PIL.ImageTk • PIL.ImageWin • PIL.ImtImagePlugin • PIL.IptcImagePlugin • PIL.Jpeg2KImagePlugin • PIL.JpegImagePlugin • PIL.JpegPresets • PIL.McIdasImagePlugin • PIL.MicImagePlugin • PIL.MpegImagePlugin • PIL.MpoImagePlugin • PIL.MspImagePlugin • PIL.PaletteFile • PIL.PalmImagePlugin • PIL.PcdImagePlugin • PIL.PcxImagePlugin • PIL.PdfImagePlugin • PIL.PdfParser • PIL.PixarImagePlugin • PIL.PngImagePlugin • PIL.PpmImagePlugin • PIL.PsdImagePlugin • PIL.QoiImagePlugin • PIL.SgiImagePlugin • PIL.SpiderImagePlugin • PIL.SunImagePlugin • PIL.TgaImagePlugin • PIL.TiffImagePlugin • PIL.TiffTags • PIL.WebPImagePlugin • PIL.WmfImagePlugin • PIL.XVThumbImagePlugin • PIL.XbmImagePlugin • PIL.XpmImagePlugin • PIL._binary • PIL._deprecate • PIL._imaging • PIL._imagingcms • PIL._imagingft • PIL._imagingmath • PIL._imagingtk • PIL._tkinter_finder • PIL._typing • PIL._util • PIL._version • PIL._webp • PIL.features • _plotly_utils.data_utils • matplotlib.backends._backend_tk • matplotlib.backends.backend_webagg_core • matplotlib.colors • pygments.formatters.img • time_tracker_working.py

PIL.AvifImagePlugin SourceModule

imports: PIL • PIL.ExifTags • PIL.Image • PIL.ImageFile • PIL._avif • __future__ • io • os • typing

imported by: PIL.Image

PIL.BlpImagePlugin SourceModule

imports: PIL • PIL.Image • PIL.ImageFile • PIL.JpegImagePlugin • __future__ • abc • enum • io • os • struct • typing

imported by: PIL.Image

PIL.BmpImagePlugin SourceModule

imports: PIL • PIL.Image • PIL.ImageFile • PIL.ImagePalette • PIL._binary • __future__ • os • typing

imported by: PIL • PIL.CurImagePlugin • PIL.IcoImagePlugin • PIL.Image

PIL.BufrStubImagePlugin SourceModule

imports: PIL • PIL.Image • PIL.ImageFile • __future__ • os • typing

imported by: PIL.Image

PIL.CurImagePlugin SourceModule

imports: PIL • PIL.BmpImagePlugin • PIL.Image • PIL.ImageFile • PIL._binary • __future__

imported by: PIL.Image

PIL.DcxImagePlugin SourceModule

imports: PIL • PIL.Image • PIL.PcxImagePlugin • PIL._binary • PIL._util • __future__

imported by: PIL.Image

PIL.DdsImagePlugin SourceModule

imports: PIL • PIL.Image • PIL.ImageFile • PIL.ImagePalette • PIL._binary • __future__ • enum • io • struct • sys • typing

imported by: PIL.Image

PIL.EpsImagePlugin SourceModule

imports: PIL • PIL.Image • PIL.ImageFile • PIL._binary • __future__ • io • os • re • shutil • subprocess • sys • tempfile • typing

imported by: PIL.Image

PIL.ExifTags SourceModule

imports: PIL • __future__ • enum

imported by: PIL • PIL.AvifImagePlugin • PIL.Image • PIL.ImageFile • PIL.ImageOps • PIL.TiffImagePlugin

PIL.FitsImagePlugin SourceModule

imports: PIL • PIL.Image • PIL.ImageFile • __future__ • gzip • math

imported by: PIL.Image

PIL.FliImagePlugin SourceModule

imports: PIL • PIL.Image • PIL.ImageFile • PIL.ImagePalette • PIL._binary • PIL._util • __future__ • os

imported by: PIL.Image

PIL.FpxImagePlugin SourceModule

imports: PIL • PIL.Image • PIL.ImageFile • PIL._binary • __future__ • olefile

imported by: PIL.Image

PIL.FtexImagePlugin SourceModule

imports: PIL • PIL.Image • PIL.ImageFile • __future__ • enum • io • struct

imported by: PIL.Image

PIL.GbrImagePlugin SourceModule

imports: PIL • PIL.Image • PIL.ImageFile • PIL._binary • __future__

imported by: PIL.Image

PIL.GifImagePlugin SourceModule

imports: PIL • PIL.Image • PIL.ImageChops • PIL.ImageFile • PIL.ImageMath • PIL.ImageOps • PIL.ImagePalette • PIL.ImageSequence • PIL._binary • PIL._imaging • PIL._typing • PIL._util • __future__ • copy • enum • functools • io • itertools • math • os • subprocess • typing

imported by: PIL • PIL.Image

PIL.GimpGradientFile SourceModule

imports: PIL • PIL._binary • __future__ • math • typing

imported by: PIL • PIL.ImagePalette

PIL.GimpPaletteFile SourceModule

imports: PIL • __future__ • io • re • typing

imported by: PIL • PIL.ImagePalette

PIL.GribStubImagePlugin SourceModule

imports: PIL • PIL.Image • PIL.ImageFile • __future__ • os • typing

imported by: PIL.Image

PIL.Hdf5StubImagePlugin SourceModule

imports: PIL • PIL.Image • PIL.ImageFile • __future__ • os • typing

imported by: PIL.Image

PIL.IcnsImagePlugin SourceModule

imports: PIL • PIL.Image • PIL.ImageFile • PIL.Jpeg2KImagePlugin • PIL.PngImagePlugin • PIL._deprecate • PIL.features • __future__ • io • os • struct • sys • typing

imported by: PIL.Image

PIL.IcoImagePlugin SourceModule

imports: PIL • PIL.BmpImagePlugin • PIL.Image • PIL.ImageFile • PIL.PngImagePlugin • PIL._binary • __future__ • io • math • typing • warnings

imported by: PIL.Image

PIL.ImImagePlugin SourceModule

imports: PIL • PIL.Image • PIL.ImageFile • PIL.ImagePalette • PIL._util • __future__ • os • re • typing

imported by: PIL.Image

PIL.Image SourceModule

imports: 'collections.abc' • PIL • PIL.AvifImagePlugin • PIL.BlpImagePlugin • PIL.BmpImagePlugin • PIL.BufrStubImagePlugin • PIL.CurImagePlugin • PIL.DcxImagePlugin • PIL.DdsImagePlugin • PIL.EpsImagePlugin • PIL.ExifTags • PIL.FitsImagePlugin • PIL.FliImagePlugin • PIL.FpxImagePlugin • PIL.FtexImagePlugin • PIL.GbrImagePlugin • PIL.GifImagePlugin • PIL.GribStubImagePlugin • PIL.Hdf5StubImagePlugin • PIL.IcnsImagePlugin • PIL.IcoImagePlugin • PIL.ImImagePlugin • PIL.ImageCms • PIL.ImageColor • PIL.ImageFile • PIL.ImageFilter • PIL.ImageMode • PIL.ImagePalette • PIL.ImageQt • PIL.ImageShow • PIL.ImtImagePlugin • PIL.IptcImagePlugin • PIL.Jpeg2KImagePlugin • PIL.JpegImagePlugin • PIL.McIdasImagePlugin • PIL.MicImagePlugin • PIL.MpegImagePlugin • PIL.MpoImagePlugin • PIL.MspImagePlugin • PIL.PalmImagePlugin • PIL.PcdImagePlugin • PIL.PcxImagePlugin • PIL.PdfImagePlugin • PIL.PixarImagePlugin • PIL.PngImagePlugin • PIL.PpmImagePlugin • PIL.PsdImagePlugin • PIL.QoiImagePlugin • PIL.SgiImagePlugin • PIL.SpiderImagePlugin • PIL.SunImagePlugin • PIL.TgaImagePlugin • PIL.TiffImagePlugin • PIL.TiffTags • PIL.WebPImagePlugin • PIL.WmfImagePlugin • PIL.XVThumbImagePlugin • PIL.XbmImagePlugin • PIL.XpmImagePlugin • PIL._binary • PIL._deprecate • PIL._imaging • PIL._typing • PIL._util • __future__ • abc • atexit • builtins • defusedxml • enum • io • logging • math • mmap • os • re • struct • sys • tempfile • types • typing • warnings • xml.etree.ElementTree

imported by: PIL • PIL.AvifImagePlugin • PIL.BlpImagePlugin • PIL.BmpImagePlugin • PIL.BufrStubImagePlugin • PIL.CurImagePlugin • PIL.DcxImagePlugin • PIL.DdsImagePlugin • PIL.EpsImagePlugin • PIL.FitsImagePlugin • PIL.FliImagePlugin • PIL.FpxImagePlugin • PIL.FtexImagePlugin • PIL.GbrImagePlugin • PIL.GifImagePlugin • PIL.GribStubImagePlugin • PIL.Hdf5StubImagePlugin • PIL.IcnsImagePlugin • PIL.IcoImagePlugin • PIL.ImImagePlugin • PIL.ImageChops • PIL.ImageCms • PIL.ImageColor • PIL.ImageDraw • PIL.ImageDraw2 • PIL.ImageFile • PIL.ImageFilter • PIL.ImageFont • PIL.ImageMath • PIL.ImageOps • PIL.ImagePalette • PIL.ImagePath • PIL.ImageQt • PIL.ImageSequence • PIL.ImageShow • PIL.ImageTk • PIL.ImageWin • PIL.ImtImagePlugin • PIL.IptcImagePlugin • PIL.Jpeg2KImagePlugin • PIL.JpegImagePlugin • PIL.McIdasImagePlugin • PIL.MicImagePlugin • PIL.MpegImagePlugin • PIL.MpoImagePlugin • PIL.MspImagePlugin • PIL.PalmImagePlugin • PIL.PcdImagePlugin • PIL.PcxImagePlugin • PIL.PdfImagePlugin • PIL.PixarImagePlugin • PIL.PngImagePlugin • PIL.PpmImagePlugin • PIL.PsdImagePlugin • PIL.QoiImagePlugin • PIL.SgiImagePlugin • PIL.SpiderImagePlugin • PIL.SunImagePlugin • PIL.TgaImagePlugin • PIL.TiffImagePlugin • PIL.WebPImagePlugin • PIL.WmfImagePlugin • PIL.XVThumbImagePlugin • PIL.XbmImagePlugin • PIL.XpmImagePlugin • PIL.features • _plotly_utils.data_utils • matplotlib.backends._backend_tk • matplotlib.backends.backend_webagg_core • matplotlib.colors • matplotlib.image • matplotlib.pyplot • pygments.formatters.img • time_tracker_working.py

PIL.ImageChops SourceModule

imports: PIL • PIL.Image • __future__

imported by: PIL • PIL.GifImagePlugin • PIL.PngImagePlugin

PIL.ImageCms SourceModule

imports: PIL • PIL.Image • PIL.ImageWin • PIL._deprecate • PIL._imagingcms • PIL._typing • PIL._util • __future__ • enum • functools • operator • sys • typing

imported by: PIL • PIL.Image

PIL.ImageColor SourceModule

imports: PIL • PIL.Image • __future__ • colorsys • functools • re

imported by: PIL • PIL.Image • PIL.ImageDraw • PIL.ImageDraw2 • PIL.ImageOps • PIL.ImagePalette

PIL.ImageDraw SourceModule

imports: 'collections.abc' • PIL • PIL.Image • PIL.ImageColor • PIL.ImageDraw2 • PIL.ImageFont • PIL._deprecate • PIL._typing • __future__ • math • struct • types • typing

imported by: PIL • PIL.ImageDraw2 • pygments.formatters.img

PIL.ImageDraw2 SourceModule

imports: PIL • PIL.Image • PIL.ImageColor • PIL.ImageDraw • PIL.ImageFont • PIL.ImagePath • PIL._typing • __future__ • typing

imported by: PIL • PIL.ImageDraw

PIL.ImageFile SourceModule

imports: PIL • PIL.ExifTags • PIL.Image • PIL.TiffImagePlugin • PIL._deprecate • PIL._typing • PIL._util • __future__ • abc • io • itertools • logging • mmap • os • struct • typing

imported by: PIL • PIL.AvifImagePlugin • PIL.BlpImagePlugin • PIL.BmpImagePlugin • PIL.BufrStubImagePlugin • PIL.CurImagePlugin • PIL.DdsImagePlugin • PIL.EpsImagePlugin • PIL.FitsImagePlugin • PIL.FliImagePlugin • PIL.FpxImagePlugin • PIL.FtexImagePlugin • PIL.GbrImagePlugin • PIL.GifImagePlugin • PIL.GribStubImagePlugin • PIL.Hdf5StubImagePlugin • PIL.IcnsImagePlugin • PIL.IcoImagePlugin • PIL.ImImagePlugin • PIL.Image • PIL.ImageFont • PIL.ImageQt • PIL.ImageTk • PIL.ImtImagePlugin • PIL.IptcImagePlugin • PIL.Jpeg2KImagePlugin • PIL.JpegImagePlugin • PIL.McIdasImagePlugin • PIL.MpegImagePlugin • PIL.MpoImagePlugin • PIL.MspImagePlugin • PIL.PalmImagePlugin • PIL.PcdImagePlugin • PIL.PcxImagePlugin • PIL.PdfImagePlugin • PIL.PixarImagePlugin • PIL.PngImagePlugin • PIL.PpmImagePlugin • PIL.PsdImagePlugin • PIL.QoiImagePlugin • PIL.SgiImagePlugin • PIL.SpiderImagePlugin • PIL.SunImagePlugin • PIL.TgaImagePlugin • PIL.TiffImagePlugin • PIL.WebPImagePlugin • PIL.WmfImagePlugin • PIL.XVThumbImagePlugin • PIL.XbmImagePlugin • PIL.XpmImagePlugin

PIL.ImageFilter SourceModule

imports: 'collections.abc' • PIL • PIL.Image • PIL._imaging • PIL._typing • __future__ • abc • functools • types • typing

imported by: PIL • PIL.Image

PIL.ImageFont SourceModule

imports: PIL • PIL.Image • PIL.ImageFile • PIL._imaging • PIL._imagingft • PIL._typing • PIL._util • PIL.features • __future__ • base64 • enum • io • os • packaging.version • sys • types • typing • warnings

imported by: PIL • PIL.ImageDraw • PIL.ImageDraw2 • PIL._imagingft • pygments.formatters.img

PIL.ImageMath SourceModule

imports: PIL • PIL.Image • PIL._deprecate • PIL._imagingmath • __future__ • builtins • types • typing

imported by: PIL • PIL.GifImagePlugin

PIL.ImageMode SourceModule

imports: PIL • PIL._deprecate • __future__ • functools • sys • typing

imported by: PIL • PIL.Image

PIL.ImageOps SourceModule

imports: 'collections.abc' • PIL • PIL.ExifTags • PIL.Image • PIL.ImageColor • PIL.ImagePalette • __future__ • functools • operator • re • typing

imported by: PIL • PIL.GifImagePlugin • PIL.TiffImagePlugin

PIL.ImagePalette SourceModule

imports: 'collections.abc' • PIL • PIL.GimpGradientFile • PIL.GimpPaletteFile • PIL.Image • PIL.ImageColor • PIL.PaletteFile • __future__ • array • random • typing

imported by: PIL • PIL.BmpImagePlugin • PIL.DdsImagePlugin • PIL.FliImagePlugin • PIL.GifImagePlugin • PIL.ImImagePlugin • PIL.Image • PIL.ImageOps • PIL.Jpeg2KImagePlugin • PIL.PcxImagePlugin • PIL.PngImagePlugin • PIL.PsdImagePlugin • PIL.SunImagePlugin • PIL.TgaImagePlugin • PIL.TiffImagePlugin • PIL.XVThumbImagePlugin • PIL.XpmImagePlugin

PIL.ImagePath SourceModule

imports: PIL • PIL.Image • __future__

imported by: PIL • PIL.ImageDraw2

PIL.ImageQt SourceModule

imports: PIL • PIL.Image • PIL.ImageFile • PIL._util • __future__ • io • sys • typing

imported by: PIL • PIL.Image

PIL.ImageSequence SourceModule

imports: PIL • PIL.Image • __future__ • typing

imported by: PIL • PIL.GifImagePlugin • PIL.MpoImagePlugin • PIL.PdfImagePlugin • PIL.PngImagePlugin

PIL.ImageShow SourceModule

imports: PIL • PIL.Image • __future__ • abc • os • shlex • shutil • subprocess • sys • typing

imported by: PIL • PIL.Image

PIL.ImageTk SourceModule

imports: PIL • PIL.Image • PIL.ImageFile • PIL._imagingtk • PIL._typing • __future__ • io • typing

imported by: PIL • PIL.SpiderImagePlugin • matplotlib.backends._backend_tk • time_tracker_working.py

PIL.ImageWin SourceModule

imports: PIL • PIL.Image • __future__

imported by: PIL • PIL.ImageCms

PIL.ImtImagePlugin SourceModule

imports: PIL • PIL.Image • PIL.ImageFile • __future__ • re

imported by: PIL.Image

PIL.IptcImagePlugin SourceModule

imports: 'collections.abc' • PIL • PIL.Image • PIL.ImageFile • PIL.JpegImagePlugin • PIL.TiffImagePlugin • PIL._binary • PIL._deprecate • __future__ • io • typing

imported by: PIL.Image

PIL.Jpeg2KImagePlugin SourceModule

imports: 'collections.abc' • PIL • PIL.Image • PIL.ImageFile • PIL.ImagePalette • PIL._binary • __future__ • io • os • struct • typing

imported by: PIL • PIL.IcnsImagePlugin • PIL.Image

PIL.JpegImagePlugin SourceModule

imports: PIL • PIL.Image • PIL.ImageFile • PIL.JpegPresets • PIL.MpoImagePlugin • PIL.TiffImagePlugin • PIL._binary • PIL._deprecate • __future__ • array • io • math • os • struct • subprocess • sys • tempfile • typing • warnings

imported by: PIL • PIL.BlpImagePlugin • PIL.Image • PIL.IptcImagePlugin • PIL.MpoImagePlugin

PIL.JpegPresets SourceModule

imports: PIL • __future__

imported by: PIL.JpegImagePlugin

PIL.McIdasImagePlugin SourceModule

imports: PIL • PIL.Image • PIL.ImageFile • __future__ • struct

imported by: PIL.Image

PIL.MicImagePlugin SourceModule

imports: PIL • PIL.Image • PIL.TiffImagePlugin • __future__ • olefile

imported by: PIL.Image

PIL.MpegImagePlugin SourceModule

imports: PIL • PIL.Image • PIL.ImageFile • PIL._binary • PIL._typing • __future__

imported by: PIL.Image

PIL.MpoImagePlugin SourceModule

imports: PIL • PIL.Image • PIL.ImageFile • PIL.ImageSequence • PIL.JpegImagePlugin • PIL.TiffImagePlugin • PIL._binary • PIL._util • __future__ • itertools • os • struct • typing

imported by: PIL.Image • PIL.JpegImagePlugin

PIL.MspImagePlugin SourceModule

imports: PIL • PIL.Image • PIL.ImageFile • PIL._binary • __future__ • io • struct • typing

imported by: PIL.Image

PIL.PaletteFile SourceModule

imports: PIL • PIL._binary • __future__ • typing

imported by: PIL • PIL.ImagePalette

PIL.PalmImagePlugin SourceModule

imports: PIL • PIL.Image • PIL.ImageFile • PIL._binary • __future__ • typing

imported by: PIL.Image

PIL.PcdImagePlugin SourceModule

imports: PIL • PIL.Image • PIL.ImageFile • __future__

imported by: PIL.Image

PIL.PcxImagePlugin SourceModule

imports: PIL • PIL.Image • PIL.ImageFile • PIL.ImagePalette • PIL._binary • __future__ • io • logging • typing

imported by: PIL.DcxImagePlugin • PIL.Image

PIL.PdfImagePlugin SourceModule

imports: PIL • PIL.Image • PIL.ImageFile • PIL.ImageSequence • PIL.PdfParser • PIL.features • __future__ • io • math • os • time • typing

imported by: PIL.Image

PIL.PdfParser SourceModule

imports: PIL • __future__ • calendar • codecs • collections • mmap • os • re • time • typing • zlib

imported by: PIL • PIL.PdfImagePlugin

PIL.PixarImagePlugin SourceModule

imports: PIL • PIL.Image • PIL.ImageFile • PIL._binary • __future__

imported by: PIL.Image

PIL.PngImagePlugin SourceModule

imports: 'collections.abc' • PIL • PIL.Image • PIL.ImageChops • PIL.ImageFile • PIL.ImagePalette • PIL.ImageSequence • PIL._binary • PIL._imaging • PIL._util • __future__ • enum • io • itertools • logging • re • struct • typing • warnings • zlib

imported by: PIL • PIL.IcnsImagePlugin • PIL.IcoImagePlugin • PIL.Image • matplotlib.colors • matplotlib.image

PIL.PpmImagePlugin SourceModule

imports: PIL • PIL.Image • PIL.ImageFile • PIL._binary • __future__ • math • typing

imported by: PIL • PIL.Image

PIL.PsdImagePlugin SourceModule

imports: PIL • PIL.Image • PIL.ImageFile • PIL.ImagePalette • PIL._binary • PIL._util • __future__ • functools • io • typing

imported by: PIL.Image

PIL.QoiImagePlugin SourceModule

imports: PIL • PIL.Image • PIL.ImageFile • PIL._binary • __future__ • os

imported by: PIL.Image

PIL.SgiImagePlugin SourceModule

imports: PIL • PIL.Image • PIL.ImageFile • PIL._binary • __future__ • os • struct • typing

imported by: PIL.Image

PIL.SpiderImagePlugin SourceModule

imports: PIL • PIL.Image • PIL.ImageFile • PIL.ImageTk • PIL._util • __future__ • os • struct • sys • typing

imported by: PIL.Image

PIL.SunImagePlugin SourceModule

imports: PIL • PIL.Image • PIL.ImageFile • PIL.ImagePalette • PIL._binary • __future__

imported by: PIL.Image

PIL.TgaImagePlugin SourceModule

imports: PIL • PIL.Image • PIL.ImageFile • PIL.ImagePalette • PIL._binary • __future__ • typing • warnings

imported by: PIL.Image

PIL.TiffImagePlugin SourceModule

imports: 'collections.abc' • PIL • PIL.ExifTags • PIL.Image • PIL.ImageFile • PIL.ImageOps • PIL.ImagePalette • PIL.TiffTags • PIL._binary • PIL._deprecate • PIL._typing • PIL._util • __future__ • fractions • io • itertools • logging • math • numbers • os • struct • typing • warnings

imported by: PIL • PIL.Image • PIL.ImageFile • PIL.IptcImagePlugin • PIL.JpegImagePlugin • PIL.MicImagePlugin • PIL.MpoImagePlugin

PIL.TiffTags SourceModule

imports: PIL • __future__ • typing

imported by: PIL • PIL.Image • PIL.TiffImagePlugin

PIL.WebPImagePlugin SourceModule

imports: PIL • PIL.Image • PIL.ImageFile • PIL._webp • __future__ • io • typing

imported by: PIL.Image

PIL.WmfImagePlugin SourceModule

imports: PIL • PIL.Image • PIL.ImageFile • PIL._binary • __future__ • typing

imported by: PIL.Image

PIL.XVThumbImagePlugin SourceModule

imports: PIL • PIL.Image • PIL.ImageFile • PIL.ImagePalette • PIL._binary • __future__

imported by: PIL.Image

PIL.XbmImagePlugin SourceModule

imports: PIL • PIL.Image • PIL.ImageFile • __future__ • re • typing

imported by: PIL.Image

PIL.XpmImagePlugin SourceModule

imports: PIL • PIL.Image • PIL.ImageFile • PIL.ImagePalette • PIL._binary • __future__ • re

imported by: PIL.Image

PIL._avif MissingModule

imported by: PIL • PIL.AvifImagePlugin

PIL._binary SourceModule

imports: PIL • __future__ • struct

imported by: PIL.BmpImagePlugin • PIL.CurImagePlugin • PIL.DcxImagePlugin • PIL.DdsImagePlugin • PIL.EpsImagePlugin • PIL.FliImagePlugin • PIL.FpxImagePlugin • PIL.GbrImagePlugin • PIL.GifImagePlugin • PIL.GimpGradientFile • PIL.IcoImagePlugin • PIL.Image • PIL.IptcImagePlugin • PIL.Jpeg2KImagePlugin • PIL.JpegImagePlugin • PIL.MpegImagePlugin • PIL.MpoImagePlugin • PIL.MspImagePlugin • PIL.PaletteFile • PIL.PalmImagePlugin • PIL.PcxImagePlugin • PIL.PixarImagePlugin • PIL.PngImagePlugin • PIL.PpmImagePlugin • PIL.PsdImagePlugin • PIL.QoiImagePlugin • PIL.SgiImagePlugin • PIL.SunImagePlugin • PIL.TgaImagePlugin • PIL.TiffImagePlugin • PIL.WmfImagePlugin • PIL.XVThumbImagePlugin • PIL.XpmImagePlugin

PIL._deprecate SourceModule

imports: PIL • __future__ • warnings

imported by: PIL.IcnsImagePlugin • PIL.Image • PIL.ImageCms • PIL.ImageDraw • PIL.ImageFile • PIL.ImageMath • PIL.ImageMode • PIL.IptcImagePlugin • PIL.JpegImagePlugin • PIL.TiffImagePlugin • PIL.features

PIL._imaging C:\HTL\HTL 5\Diplomarbeit\Zeiterfassung\TimeTracker\.venv\Lib\site-packages\PIL\_imaging.cp313-win_amd64.pyd

imports: PIL • typing

imported by: PIL • PIL.GifImagePlugin • PIL.Image • PIL.ImageFilter • PIL.ImageFont • PIL.PngImagePlugin • PIL._imagingft

PIL._imagingcms C:\HTL\HTL 5\Diplomarbeit\Zeiterfassung\TimeTracker\.venv\Lib\site-packages\PIL\_imagingcms.cp313-win_amd64.pyd

imports: PIL • PIL._typing • datetime • sys • typing

imported by: PIL • PIL.ImageCms

PIL._imagingft C:\HTL\HTL 5\Diplomarbeit\Zeiterfassung\TimeTracker\.venv\Lib\site-packages\PIL\_imagingft.cp313-win_amd64.pyd

imports: PIL • PIL.ImageFont • PIL._imaging • typing

imported by: PIL.ImageFont

PIL._imagingmath C:\HTL\HTL 5\Diplomarbeit\Zeiterfassung\TimeTracker\.venv\Lib\site-packages\PIL\_imagingmath.cp313-win_amd64.pyd

imports: PIL • typing

imported by: PIL • PIL.ImageMath

PIL._imagingtk C:\HTL\HTL 5\Diplomarbeit\Zeiterfassung\TimeTracker\.venv\Lib\site-packages\PIL\_imagingtk.cp313-win_amd64.pyd

imports: PIL • typing

imported by: PIL • PIL.ImageTk

PIL._tkinter_finder SourceModule

imports: PIL • __future__ • sys

imported by: time_tracker_working.py

PIL._typing SourceModule

imports: 'collections.abc' • PIL • __future__ • numbers • numpy.typing • os • sys • types • typing • typing_extensions

imported by: PIL.GifImagePlugin • PIL.Image • PIL.ImageCms • PIL.ImageDraw • PIL.ImageDraw2 • PIL.ImageFile • PIL.ImageFilter • PIL.ImageFont • PIL.ImageTk • PIL.MpegImagePlugin • PIL.TiffImagePlugin • PIL._imagingcms • PIL._util

PIL._util SourceModule

imports: PIL • PIL._typing • __future__ • os • typing

imported by: PIL.DcxImagePlugin • PIL.FliImagePlugin • PIL.GifImagePlugin • PIL.ImImagePlugin • PIL.Image • PIL.ImageCms • PIL.ImageFile • PIL.ImageFont • PIL.ImageQt • PIL.MpoImagePlugin • PIL.PngImagePlugin • PIL.PsdImagePlugin • PIL.SpiderImagePlugin • PIL.TiffImagePlugin

PIL._version SourceModule

imports: PIL • __future__

imported by: PIL

PIL._webp C:\HTL\HTL 5\Diplomarbeit\Zeiterfassung\TimeTracker\.venv\Lib\site-packages\PIL\_webp.cp313-win_amd64.pyd

imports: PIL • typing

imported by: PIL • PIL.WebPImagePlugin

PIL.features SourceModule

imports: PIL • PIL.Image • PIL._deprecate • __future__ • collections • os • sys • typing • warnings

imported by: PIL • PIL.IcnsImagePlugin • PIL.ImageFont • PIL.PdfImagePlugin

PyQt4 MissingModule

imported by: pandas.io.clipboard

StringIO MissingModule

imported by: six

UserDict MissingModule

imported by: pytz.lazy

__future__ SourceModule

imported by: PIL • PIL.AvifImagePlugin • PIL.BlpImagePlugin • PIL.BmpImagePlugin • PIL.BufrStubImagePlugin • PIL.CurImagePlugin • PIL.DcxImagePlugin • PIL.DdsImagePlugin • PIL.EpsImagePlugin • PIL.ExifTags • PIL.FitsImagePlugin • PIL.FliImagePlugin • PIL.FpxImagePlugin • PIL.FtexImagePlugin • PIL.GbrImagePlugin • PIL.GifImagePlugin • PIL.GimpGradientFile • PIL.GimpPaletteFile • PIL.GribStubImagePlugin • PIL.Hdf5StubImagePlugin • PIL.IcnsImagePlugin • PIL.IcoImagePlugin • PIL.ImImagePlugin • PIL.Image • PIL.ImageChops • PIL.ImageCms • PIL.ImageColor • PIL.ImageDraw • PIL.ImageDraw2 • PIL.ImageFile • PIL.ImageFilter • PIL.ImageFont • PIL.ImageMath • PIL.ImageMode • PIL.ImageOps • PIL.ImagePalette • PIL.ImagePath • PIL.ImageQt • PIL.ImageSequence • PIL.ImageShow • PIL.ImageTk • PIL.ImageWin • PIL.ImtImagePlugin • PIL.IptcImagePlugin • PIL.Jpeg2KImagePlugin • PIL.JpegImagePlugin • PIL.JpegPresets • PIL.McIdasImagePlugin • PIL.MicImagePlugin • PIL.MpegImagePlugin • PIL.MpoImagePlugin • PIL.MspImagePlugin • PIL.PaletteFile • PIL.PalmImagePlugin • PIL.PcdImagePlugin • PIL.PcxImagePlugin • PIL.PdfImagePlugin • PIL.PdfParser • PIL.PixarImagePlugin • PIL.PngImagePlugin • PIL.PpmImagePlugin • PIL.PsdImagePlugin • PIL.QoiImagePlugin • PIL.SgiImagePlugin • PIL.SpiderImagePlugin • PIL.SunImagePlugin • PIL.TgaImagePlugin • PIL.TiffImagePlugin • PIL.TiffTags • PIL.WebPImagePlugin • PIL.WmfImagePlugin • PIL.XVThumbImagePlugin • PIL.XbmImagePlugin • PIL.XpmImagePlugin • PIL._binary • PIL._deprecate • PIL._tkinter_finder • PIL._typing • PIL._util • PIL._version • PIL.features • _colorize • _pyrepl._threading_handler • _pyrepl.commands • _pyrepl.completing_reader • _pyrepl.console • _pyrepl.historical_reader • _pyrepl.input • _pyrepl.pager • _pyrepl.reader • _pyrepl.readline • _pyrepl.simple_interact • _pyrepl.trace • _pyrepl.unix_console • _pyrepl.windows_console • _pytest • _pytest._argcomplete • _pytest._code • _pytest._code.code • _pytest._code.source • _pytest._io • _pytest._io.pprint • _pytest._io.saferepr • _pytest._io.terminalwriter • _pytest._io.wcwidth • _pytest._py.error • _pytest._py.path • _pytest.assertion • _pytest.assertion.rewrite • _pytest.assertion.truncate • _pytest.assertion.util • _pytest.cacheprovider • _pytest.capture • _pytest.compat • _pytest.config • _pytest.config.argparsing • _pytest.config.compat • _pytest.config.exceptions • _pytest.config.findpaths • _pytest.debugging • _pytest.deprecated • _pytest.doctest • _pytest.faulthandler • _pytest.fixtures • _pytest.freeze_support • _pytest.helpconfig • _pytest.hookspec • _pytest.junitxml • _pytest.legacypath • _pytest.logging • _pytest.main • _pytest.mark • _pytest.mark.expression • _pytest.mark.structures • _pytest.monkeypatch • _pytest.nodes • _pytest.outcomes • _pytest.pastebin • _pytest.pathlib • _pytest.pytester • _pytest.pytester_assertions • _pytest.python • _pytest.python_api • _pytest.raises • _pytest.recwarn • _pytest.reports • _pytest.runner • _pytest.scope • _pytest.setuponly • _pytest.setupplan • _pytest.skipping • _pytest.stash • _pytest.stepwise • _pytest.terminal • _pytest.threadexception • _pytest.timing • _pytest.tmpdir • _pytest.tracemalloc • _pytest.unittest • _pytest.unraisableexception • _pytest.warning_types • _pytest.warnings • codeop • contourpy • contourpy.array • contourpy.chunk • contourpy.convert • contourpy.dechunk • contourpy.enum_util • contourpy.typecheck • contourpy.types • cycler • dateutil.parser._parser • doctest • importlib.metadata • importlib.metadata._meta • importlib.resources.readers • iniconfig • iniconfig._parse • iniconfig.exceptions • matplotlib._mathtext • matplotlib._mathtext_data • matplotlib._text_helpers • matplotlib.font_manager • matplotlib.pyplot • narwhals • narwhals._arrow.dataframe • narwhals._arrow.expr • narwhals._arrow.group_by • narwhals._arrow.namespace • narwhals._arrow.selectors • narwhals._arrow.series • narwhals._arrow.series_cat • narwhals._arrow.series_dt • narwhals._arrow.series_list • narwhals._arrow.series_str • narwhals._arrow.series_struct • narwhals._arrow.typing • narwhals._arrow.utils • narwhals._compliant • narwhals._compliant.any_namespace • narwhals._compliant.dataframe • narwhals._compliant.expr • narwhals._compliant.group_by • narwhals._compliant.namespace • narwhals._compliant.selectors • narwhals._compliant.series • narwhals._compliant.typing • narwhals._compliant.when_then • narwhals._compliant.window • narwhals._dask.dataframe • narwhals._dask.expr • narwhals._dask.expr_dt • narwhals._dask.expr_str • narwhals._dask.group_by • narwhals._dask.namespace • narwhals._dask.selectors • narwhals._dask.utils • narwhals._duckdb.dataframe • narwhals._duckdb.expr • narwhals._duckdb.expr_dt • narwhals._duckdb.expr_list • narwhals._duckdb.expr_str • narwhals._duckdb.expr_struct • narwhals._duckdb.group_by • narwhals._duckdb.namespace • narwhals._duckdb.selectors • narwhals._duckdb.series • narwhals._duckdb.utils • narwhals._duration • narwhals._enum • narwhals._expression_parsing • narwhals._ibis.dataframe • narwhals._ibis.expr • narwhals._ibis.expr_dt • narwhals._ibis.expr_list • narwhals._ibis.expr_str • narwhals._ibis.expr_struct • narwhals._ibis.group_by • narwhals._ibis.namespace • narwhals._ibis.selectors • narwhals._ibis.series • narwhals._ibis.utils • narwhals._interchange.dataframe • narwhals._interchange.series • narwhals._namespace • narwhals._pandas_like.dataframe • narwhals._pandas_like.expr • narwhals._pandas_like.group_by • narwhals._pandas_like.namespace • narwhals._pandas_like.selectors • narwhals._pandas_like.series • narwhals._pandas_like.series_cat • narwhals._pandas_like.series_dt • narwhals._pandas_like.series_list • narwhals._pandas_like.series_str • narwhals._pandas_like.series_struct • narwhals._pandas_like.typing • narwhals._pandas_like.utils • narwhals._polars.dataframe • narwhals._polars.expr • narwhals._polars.group_by • narwhals._polars.namespace • narwhals._polars.series • narwhals._polars.typing • narwhals._polars.utils • narwhals._spark_like.dataframe • narwhals._spark_like.expr • narwhals._spark_like.expr_dt • narwhals._spark_like.expr_list • narwhals._spark_like.expr_str • narwhals._spark_like.expr_struct • narwhals._spark_like.group_by • narwhals._spark_like.namespace • narwhals._spark_like.selectors • narwhals._spark_like.utils • narwhals._translate • narwhals._typing_compat • narwhals._utils • narwhals.dataframe • narwhals.dependencies • narwhals.dtypes • narwhals.exceptions • narwhals.expr • narwhals.expr_cat • narwhals.expr_dt • narwhals.expr_list • narwhals.expr_name • narwhals.expr_str • narwhals.expr_struct • narwhals.functions • narwhals.group_by • narwhals.schema • narwhals.selectors • narwhals.series • narwhals.series_cat • narwhals.series_dt • narwhals.series_list • narwhals.series_str • narwhals.series_struct • narwhals.stable • narwhals.stable.v1 • narwhals.stable.v1._dtypes • narwhals.stable.v1._namespace • narwhals.stable.v1.dependencies • narwhals.stable.v1.dtypes • narwhals.stable.v1.selectors • narwhals.translate • narwhals.typing • narwhals.utils • packaging._elffile • packaging._manylinux • packaging._musllinux • packaging._parser • packaging._tokenizer • packaging.licenses • packaging.licenses._spdx • packaging.markers • packaging.metadata • packaging.requirements • packaging.specifiers • packaging.tags • packaging.utils • packaging.version • pandas • pandas._config.config • pandas._config.dates • pandas._config.display • pandas._config.localization • pandas._testing • pandas._testing._io • pandas._testing._warnings • pandas._testing.asserters • pandas._testing.compat • pandas._testing.contexts • pandas._typing • pandas.compat • pandas.compat._constants • pandas.compat._optional • pandas.compat.compressors • pandas.compat.numpy.function • pandas.compat.pickle_compat • pandas.compat.pyarrow • pandas.core._numba.executor • pandas.core._numba.extensions • pandas.core._numba.kernels.mean_ • pandas.core._numba.kernels.min_max_ • pandas.core._numba.kernels.shared • pandas.core._numba.kernels.sum_ • pandas.core._numba.kernels.var_ • pandas.core.accessor • pandas.core.algorithms • pandas.core.apply • pandas.core.array_algos.datetimelike_accumulations • pandas.core.array_algos.masked_accumulations • pandas.core.array_algos.masked_reductions • pandas.core.array_algos.putmask • pandas.core.array_algos.quantile • pandas.core.array_algos.replace • pandas.core.array_algos.take • pandas.core.array_algos.transforms • pandas.core.arraylike • pandas.core.arrays._arrow_string_mixins • pandas.core.arrays._mixins • pandas.core.arrays._ranges • pandas.core.arrays._utils • pandas.core.arrays.arrow._arrow_utils • pandas.core.arrays.arrow.accessors • pandas.core.arrays.arrow.array • pandas.core.arrays.arrow.extension_types • pandas.core.arrays.base • pandas.core.arrays.boolean • pandas.core.arrays.categorical • pandas.core.arrays.datetimelike • pandas.core.arrays.datetimes • pandas.core.arrays.floating • pandas.core.arrays.integer • pandas.core.arrays.interval • pandas.core.arrays.masked • pandas.core.arrays.numeric • pandas.core.arrays.numpy_ • pandas.core.arrays.period • pandas.core.arrays.sparse.accessor • pandas.core.arrays.sparse.array • pandas.core.arrays.sparse.scipy_sparse • pandas.core.arrays.string_ • pandas.core.arrays.string_arrow • pandas.core.arrays.timedeltas • pandas.core.base • pandas.core.common • pandas.core.computation.align • pandas.core.computation.check • pandas.core.computation.common • pandas.core.computation.engines • pandas.core.computation.eval • pandas.core.computation.expr • pandas.core.computation.expressions • pandas.core.computation.ops • pandas.core.computation.parsing • pandas.core.computation.pytables • pandas.core.computation.scope • pandas.core.config_init • pandas.core.construction • pandas.core.dtypes.astype • pandas.core.dtypes.base • pandas.core.dtypes.cast • pandas.core.dtypes.common • pandas.core.dtypes.concat • pandas.core.dtypes.dtypes • pandas.core.dtypes.generic • pandas.core.dtypes.inference • pandas.core.dtypes.missing • pandas.core.flags • pandas.core.frame • pandas.core.generic • pandas.core.groupby.base • pandas.core.groupby.categorical • pandas.core.groupby.generic • pandas.core.groupby.groupby • pandas.core.groupby.grouper • pandas.core.groupby.indexing • pandas.core.groupby.numba_ • pandas.core.groupby.ops • pandas.core.indexers.objects • pandas.core.indexers.utils • pandas.core.indexes.accessors • pandas.core.indexes.api • pandas.core.indexes.base • pandas.core.indexes.category • pandas.core.indexes.datetimelike • pandas.core.indexes.datetimes • pandas.core.indexes.extension • pandas.core.indexes.frozen • pandas.core.indexes.interval • pandas.core.indexes.multi • pandas.core.indexes.period • pandas.core.indexes.range • pandas.core.indexes.timedeltas • pandas.core.indexing • pandas.core.interchange.buffer • pandas.core.interchange.column • pandas.core.interchange.dataframe • pandas.core.interchange.dataframe_protocol • pandas.core.interchange.from_dataframe • pandas.core.interchange.utils • pandas.core.internals.api • pandas.core.internals.array_manager • pandas.core.internals.base • pandas.core.internals.blocks • pandas.core.internals.concat • pandas.core.internals.construction • pandas.core.internals.managers • pandas.core.internals.ops • pandas.core.methods.describe • pandas.core.methods.selectn • pandas.core.methods.to_dict • pandas.core.missing • pandas.core.nanops • pandas.core.ops • pandas.core.ops.array_ops • pandas.core.ops.common • pandas.core.ops.dispatch • pandas.core.ops.docstrings • pandas.core.ops.invalid • pandas.core.ops.mask_ops • pandas.core.ops.missing • pandas.core.resample • pandas.core.reshape.concat • pandas.core.reshape.encoding • pandas.core.reshape.melt • pandas.core.reshape.merge • pandas.core.reshape.pivot • pandas.core.reshape.reshape • pandas.core.reshape.tile • pandas.core.reshape.util • pandas.core.roperator • pandas.core.sample • pandas.core.series • pandas.core.shared_docs • pandas.core.sorting • pandas.core.strings.accessor • pandas.core.strings.base • pandas.core.strings.object_array • pandas.core.tools.datetimes • pandas.core.tools.numeric • pandas.core.tools.timedeltas • pandas.core.tools.times • pandas.core.util.hashing • pandas.core.util.numba_ • pandas.core.window.common • pandas.core.window.doc • pandas.core.window.ewm • pandas.core.window.expanding • pandas.core.window.numba_ • pandas.core.window.online • pandas.core.window.rolling • pandas.errors • pandas.io._util • pandas.io.clipboards • pandas.io.common • pandas.io.excel._base • pandas.io.excel._calamine • pandas.io.excel._odfreader • pandas.io.excel._odswriter • pandas.io.excel._openpyxl • pandas.io.excel._pyxlsb • pandas.io.excel._util • pandas.io.excel._xlrd • pandas.io.excel._xlsxwriter • pandas.io.feather_format • pandas.io.formats._color_data • pandas.io.formats.console • pandas.io.formats.css • pandas.io.formats.csvs • pandas.io.formats.excel • pandas.io.formats.format • pandas.io.formats.html • pandas.io.formats.info • pandas.io.formats.printing • pandas.io.formats.string • pandas.io.formats.style • pandas.io.formats.style_render • pandas.io.formats.xml • pandas.io.gbq • pandas.io.html • pandas.io.json._json • pandas.io.json._normalize • pandas.io.json._table_schema • pandas.io.orc • pandas.io.parquet • pandas.io.parsers.arrow_parser_wrapper • pandas.io.parsers.base_parser • pandas.io.parsers.c_parser_wrapper • pandas.io.parsers.python_parser • pandas.io.parsers.readers • pandas.io.pickle • pandas.io.pytables • pandas.io.sas.sas7bdat • pandas.io.sas.sas_constants • pandas.io.sas.sas_xport • pandas.io.sas.sasreader • pandas.io.spss • pandas.io.sql • pandas.io.stata • pandas.io.xml • pandas.plotting._core • pandas.plotting._matplotlib • pandas.plotting._matplotlib.boxplot • pandas.plotting._matplotlib.converter • pandas.plotting._matplotlib.core • pandas.plotting._matplotlib.groupby • pandas.plotting._matplotlib.hist • pandas.plotting._matplotlib.misc • pandas.plotting._matplotlib.style • pandas.plotting._matplotlib.timeseries • pandas.plotting._matplotlib.tools • pandas.plotting._misc • pandas.tseries.frequencies • pandas.tseries.holiday • pandas.tseries.offsets • pandas.util._decorators • pandas.util._exceptions • pandas.util._print_versions • pandas.util._tester • pandas.util._validators • pandas.util.version • pkg_resources • pluggy._callers • pluggy._hooks • pluggy._manager • pluggy._result • pluggy._tracing • py • pydoc • pyparsing.actions • pyparsing.core • pyparsing.diagram • pyparsing.exceptions • pyparsing.results • pytest • setuptools • setuptools._core_metadata • setuptools._distutils._modified • setuptools._distutils.archive_util • setuptools._distutils.cmd • setuptools._distutils.command.bdist • setuptools._distutils.command.build • setuptools._distutils.command.build_ext • setuptools._distutils.command.sdist • setuptools._distutils.compat • setuptools._distutils.compilers.C.base • setuptools._distutils.compilers.C.msvc • setuptools._distutils.core • setuptools._distutils.dist • setuptools._distutils.extension • setuptools._distutils.fancy_getopt • setuptools._distutils.filelist • setuptools._distutils.spawn • setuptools._distutils.sysconfig • setuptools._distutils.util • setuptools._path • setuptools._reqs • setuptools._vendor.importlib_metadata • setuptools._vendor.importlib_metadata._meta • setuptools._vendor.jaraco.context • setuptools._vendor.packaging._elffile • setuptools._vendor.packaging._manylinux • setuptools._vendor.packaging._musllinux • setuptools._vendor.packaging._parser • setuptools._vendor.packaging._tokenizer • setuptools._vendor.packaging.markers • setuptools._vendor.packaging.requirements • setuptools._vendor.packaging.specifiers • setuptools._vendor.packaging.tags • setuptools._vendor.packaging.utils • setuptools._vendor.packaging.version • setuptools._vendor.platformdirs • setuptools._vendor.platformdirs.android • setuptools._vendor.platformdirs.api • setuptools._vendor.platformdirs.macos • setuptools._vendor.platformdirs.unix • setuptools._vendor.platformdirs.windows • setuptools._vendor.tomli._parser • setuptools._vendor.tomli._re • setuptools._vendor.wheel • setuptools._vendor.wheel.cli • setuptools._vendor.wheel.cli.convert • setuptools._vendor.wheel.cli.pack • setuptools._vendor.wheel.cli.tags • setuptools._vendor.wheel.cli.unpack • setuptools._vendor.wheel.macosx_libfile • setuptools._vendor.wheel.metadata • setuptools._vendor.wheel.util • setuptools._vendor.wheel.wheelfile • setuptools.command._requirestxt • setuptools.command.bdist_egg • setuptools.command.bdist_wheel • setuptools.command.build • setuptools.command.sdist • setuptools.compat.py311 • setuptools.config._apply_pyprojecttoml • setuptools.config.expand • setuptools.config.pyprojecttoml • setuptools.config.setupcfg • setuptools.depends • setuptools.discovery • setuptools.dist • setuptools.errors • setuptools.extension • setuptools.glob • setuptools.installer • setuptools.monkey • setuptools.msvc • setuptools.warnings • six • tomllib._parser • tomllib._re

_abc (builtin module)

imported by: abc

_aix_support SourceModule

imports: contextlib • os • subprocess • sys • sysconfig

imported by: sysconfig

_ast (builtin module)

imported by: ast

_asyncio C:\Program Files\Python313\DLLs\_asyncio.pyd

imported by: asyncio.events • asyncio.futures • asyncio.tasks

_bisect (builtin module)

imported by: bisect

_blake2 (builtin module)

imported by: hashlib

_bz2 C:\Program Files\Python313\DLLs\_bz2.pyd

imported by: bz2

_codecs (builtin module)

imported by: codecs

_codecs_cn (builtin module)

imported by: encodings.gb18030 • encodings.gb2312 • encodings.gbk • encodings.hz

_codecs_hk (builtin module)

imported by: encodings.big5hkscs

_codecs_iso2022 (builtin module)

imported by: encodings.iso2022_jp • encodings.iso2022_jp_1 • encodings.iso2022_jp_2 • encodings.iso2022_jp_2004 • encodings.iso2022_jp_3 • encodings.iso2022_jp_ext • encodings.iso2022_kr

_codecs_jp (builtin module)

imported by: encodings.cp932 • encodings.euc_jis_2004 • encodings.euc_jisx0213 • encodings.euc_jp • encodings.shift_jis • encodings.shift_jis_2004 • encodings.shift_jisx0213

_codecs_kr (builtin module)

imported by: encodings.cp949 • encodings.euc_kr • encodings.johab

_codecs_tw (builtin module)

imported by: encodings.big5 • encodings.cp950

_collections (builtin module)

imported by: collections • threading

_collections_abc SourceModule

imports: abc • sys • warnings

imported by: collections • contextlib • locale • os • pathlib._local • random • time_tracker_working.py • types • weakref

_colorize SourceModule

imports: __future__ • io • nt • os • sys • typing

imported by: _pyrepl.console • _pyrepl.reader • doctest • pdb • traceback

_compat_pickle SourceModule

imported by: _pickle • pickle

_compression SourceModule

imports: io • sys

imported by: bz2 • gzip • lzma

_contextvars (builtin module)

imported by: contextvars

_csv (builtin module)

imported by: csv

_ctypes C:\Program Files\Python313\DLLs\_ctypes.pyd

imported by: ctypes • ctypes.macholib.dyld • numpy._core._dtype_ctypes

_curses MissingModule

imports: curses

imported by: _pyrepl.curses • curses • curses.has_key

_datetime (builtin module)

imports: _strptime • time

imported by: datetime

_decimal C:\Program Files\Python313\DLLs\_decimal.pyd

imported by: decimal

_distutils_hack Package

imports: importlib • importlib.abc • importlib.util • os • sys • traceback • warnings

imported by: _distutils_hack.override • pyi_rth_setuptools.py

_distutils_hack.override SourceModule

imports: _distutils_hack

imported by: setuptools • setuptools.discovery

_dummy_thread MissingModule

imported by: numpy._core.arrayprint

_elementtree C:\Program Files\Python313\DLLs\_elementtree.pyd

imports: pyexpat • xml.etree.ElementInclude • xml.etree.ElementPath • xml.etree.ElementTree • xml.etree.cElementTree

imported by: xml.etree.ElementTree

_frozen_importlib ExcludedModule

imported by: importlib • importlib.abc • zipimport

_frozen_importlib_external MissingModule

imported by: importlib • importlib._bootstrap • importlib.abc • zipimport

_functools (builtin module)

imported by: functools

_hashlib C:\Program Files\Python313\DLLs\_hashlib.pyd

imported by: hashlib • hmac

_heapq (builtin module)

imported by: heapq

_imp (builtin module)

imported by: importlib • importlib._bootstrap_external • importlib.util • pkg_resources • setuptools._distutils.compat.py39 • zipimport

_io (builtin module)

imported by: importlib._bootstrap_external • io • unittest.mock • zipimport

_ios_support SourceModule

imports: ctypes • ctypes.util • sys

imported by: platform • webbrowser

_json (builtin module)

imports: json.decoder

imported by: json.decoder • json.encoder • json.scanner

_locale (builtin module)

imported by: locale

_lzma C:\Program Files\Python313\DLLs\_lzma.pyd

imported by: lzma

_manylinux MissingModule

imported by: packaging._manylinux • setuptools._vendor.packaging._manylinux • setuptools._vendor.wheel.vendored.packaging._manylinux

_md5 (builtin module)

imported by: hashlib

_multibytecodec (builtin module)

imported by: encodings.big5 • encodings.big5hkscs • encodings.cp932 • encodings.cp949 • encodings.cp950 • encodings.euc_jis_2004 • encodings.euc_jisx0213 • encodings.euc_jp • encodings.euc_kr • encodings.gb18030 • encodings.gb2312 • encodings.gbk • encodings.hz • encodings.iso2022_jp • encodings.iso2022_jp_1 • encodings.iso2022_jp_2 • encodings.iso2022_jp_2004 • encodings.iso2022_jp_3 • encodings.iso2022_jp_ext • encodings.iso2022_kr • encodings.johab • encodings.shift_jis • encodings.shift_jis_2004 • encodings.shift_jisx0213

_multiprocessing C:\Program Files\Python313\DLLs\_multiprocessing.pyd

imported by: multiprocessing.connection • multiprocessing.resource_tracker • multiprocessing.synchronize

_opcode (builtin module)

imported by: dis • opcode

_opcode_metadata SourceModule

imported by: opcode

_operator (builtin module)

imported by: hmac • operator

_overlapped C:\Program Files\Python313\DLLs\_overlapped.pyd

imported by: asyncio.windows_events

_pickle (builtin module)

imports: _compat_pickle • codecs • copyreg

imported by: pickle

_plotly_utils Package

imports: _plotly_utils.exceptions

imported by: _plotly_utils.basevalidators • _plotly_utils.colors • _plotly_utils.data_utils • _plotly_utils.exceptions • _plotly_utils.files • _plotly_utils.importers • _plotly_utils.optional_imports • _plotly_utils.png • _plotly_utils.utils

_plotly_utils.basevalidators SourceModule

imports: _plotly_utils • _plotly_utils.optional_imports • base64 • copy • importlib • inspect • io • itertools • narwhals.stable.v1 • numbers • plotly • plotly.basedatatypes • plotly.colors • plotly.graph_objs • plotly.io • re • sys • textwrap • uuid

imported by: _plotly_utils.colors • _plotly_utils.utils • plotly.animation • plotly.basedatatypes • plotly.express._core • plotly.express._imshow • plotly.io._json • plotly.io._templates • plotly.validator_cache

_plotly_utils.colors Package

imports: _plotly_utils • _plotly_utils.basevalidators • _plotly_utils.colors • _plotly_utils.colors.carto • _plotly_utils.colors.cmocean • _plotly_utils.colors.colorbrewer • _plotly_utils.colors.cyclical • _plotly_utils.colors.diverging • _plotly_utils.colors.plotlyjs • _plotly_utils.colors.qualitative • _plotly_utils.colors.sequential • _plotly_utils.exceptions • bisect • decimal • numbers

imported by: _plotly_utils.colors • _plotly_utils.colors._swatches • _plotly_utils.colors.carto • _plotly_utils.colors.cmocean • _plotly_utils.colors.colorbrewer • _plotly_utils.colors.cyclical • _plotly_utils.colors.diverging • _plotly_utils.colors.plotlyjs • _plotly_utils.colors.qualitative • _plotly_utils.colors.sequential • plotly.colors

_plotly_utils.colors._swatches SourceModule

imports: _plotly_utils.colors • plotly.express._core • plotly.graph_objects • plotly.graph_objs • plotly.subplots

imported by: _plotly_utils.colors.carto • _plotly_utils.colors.cmocean • _plotly_utils.colors.colorbrewer • _plotly_utils.colors.cyclical • _plotly_utils.colors.diverging • _plotly_utils.colors.qualitative • _plotly_utils.colors.sequential

_plotly_utils.colors.carto SourceModule

imports: _plotly_utils.colors • _plotly_utils.colors._swatches

imported by: _plotly_utils.colors • _plotly_utils.colors.diverging • _plotly_utils.colors.qualitative • _plotly_utils.colors.sequential

_plotly_utils.colors.cmocean SourceModule

imports: _plotly_utils.colors • _plotly_utils.colors._swatches

imported by: _plotly_utils.colors • _plotly_utils.colors.diverging • _plotly_utils.colors.sequential

_plotly_utils.colors.colorbrewer SourceModule

imports: _plotly_utils.colors • _plotly_utils.colors._swatches

imported by: _plotly_utils.colors • _plotly_utils.colors.diverging • _plotly_utils.colors.qualitative • _plotly_utils.colors.sequential

_plotly_utils.colors.cyclical SourceModule

imports: _plotly_utils.colors • _plotly_utils.colors._swatches

imported by: _plotly_utils.colors

_plotly_utils.colors.diverging SourceModule

imports: _plotly_utils.colors • _plotly_utils.colors._swatches • _plotly_utils.colors.carto • _plotly_utils.colors.cmocean • _plotly_utils.colors.colorbrewer • _plotly_utils.colors.plotlyjs

imported by: _plotly_utils.colors

_plotly_utils.colors.plotlyjs SourceModule

imports: _plotly_utils.colors

imported by: _plotly_utils.colors • _plotly_utils.colors.diverging • _plotly_utils.colors.sequential

_plotly_utils.colors.qualitative SourceModule

imports: _plotly_utils.colors • _plotly_utils.colors._swatches • _plotly_utils.colors.carto • _plotly_utils.colors.colorbrewer

imported by: _plotly_utils.colors

_plotly_utils.colors.sequential SourceModule

imports: _plotly_utils.colors • _plotly_utils.colors._swatches • _plotly_utils.colors.carto • _plotly_utils.colors.cmocean • _plotly_utils.colors.colorbrewer • _plotly_utils.colors.plotlyjs

imported by: _plotly_utils.colors

_plotly_utils.data_utils SourceModule

imports: PIL • PIL.Image • _plotly_utils • _plotly_utils.png • base64 • io

imported by: plotly.utils

_plotly_utils.exceptions SourceModule

imports: _plotly_utils

imported by: _plotly_utils • _plotly_utils.colors • plotly.basedatatypes • plotly.exceptions

_plotly_utils.files SourceModule

imports: _plotly_utils • os

imported by: plotly.files

_plotly_utils.importers SourceModule

imports: _plotly_utils • importlib

imported by: plotly • plotly.graph_objects • plotly.graph_objs • plotly.graph_objs.bar • plotly.graph_objs.bar.hoverlabel • plotly.graph_objs.bar.legendgrouptitle • plotly.graph_objs.bar.marker • plotly.graph_objs.bar.marker.colorbar • plotly.graph_objs.bar.marker.colorbar.title • plotly.graph_objs.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

_plotly_utils.optional_imports SourceModule

imports: _plotly_utils • importlib • logging • sys

imported by: _plotly_utils.basevalidators • _plotly_utils.utils • plotly.io._html • plotly.io._json • plotly.optional_imports

_plotly_utils.png SourceModule

imports: _plotly_utils • array • collections • io • itertools • math • msvcrt • operator • os • re • struct • sys • warnings • zlib

imported by: _plotly_utils.data_utils

_plotly_utils.utils SourceModule

imports: _plotly_utils • _plotly_utils.basevalidators • _plotly_utils.optional_imports • base64 • decimal • functools • json • re • sys

imported by: plotly.basedatatypes • plotly.io._json • plotly.utils

_posixshmem MissingModule

imported by: multiprocessing.resource_tracker • multiprocessing.shared_memory

_posixsubprocess MissingModule

imports: gc

imported by: multiprocessing.util • subprocess

_py_abc SourceModule

imports: _weakrefset

imported by: abc

_pydatetime SourceModule

imports: _strptime • math • operator • sys • time • warnings

imported by: datetime

_pydecimal SourceModule

imports: collections • contextvars • itertools • locale • math • numbers • re • sys

imported by: decimal

_pyi_rth_utils Package

imports: _pyi_rth_utils • _pyi_rth_utils._win32 • os • sys

imported by: _pyi_rth_utils • _pyi_rth_utils._win32 • _pyi_rth_utils.tempfile

_pyi_rth_utils._win32 SourceModule

imports: _pyi_rth_utils • ctypes • ctypes.wintypes

imported by: _pyi_rth_utils • _pyi_rth_utils.tempfile

_pyi_rth_utils.tempfile SourceModule

imports: _pyi_rth_utils • _pyi_rth_utils._win32 • errno • os • sys • tempfile

imported by: pyi_rth_mplconfig.py

_pyrepl Package

imports: _pyrepl • _pyrepl._minimal_curses • _pyrepl.commands • _pyrepl.console • _pyrepl.curses • _pyrepl.input

imported by: _pyrepl • _pyrepl._minimal_curses • _pyrepl._threading_handler • _pyrepl.base_eventqueue • _pyrepl.commands • _pyrepl.completing_reader • _pyrepl.console • _pyrepl.curses • _pyrepl.fancy_termios • _pyrepl.historical_reader • _pyrepl.input • _pyrepl.keymap • _pyrepl.main • _pyrepl.pager • _pyrepl.reader • _pyrepl.readline • _pyrepl.simple_interact • _pyrepl.trace • _pyrepl.types • _pyrepl.unix_console • _pyrepl.unix_eventqueue • _pyrepl.utils • _pyrepl.windows_console • _pyrepl.windows_eventqueue

_pyrepl._minimal_curses SourceModule

imports: _pyrepl • ctypes • ctypes.util

imported by: _pyrepl • _pyrepl.curses

_pyrepl._threading_handler SourceModule

imports: __future__ • _pyrepl • _pyrepl.reader • dataclasses • threading • traceback • types • typing

imported by: _pyrepl.reader

_pyrepl.base_eventqueue SourceModule

imports: _pyrepl • _pyrepl.console • _pyrepl.keymap • _pyrepl.trace • collections

imported by: _pyrepl.unix_eventqueue • _pyrepl.windows_eventqueue

_pyrepl.commands SourceModule

imports: __future__ • _pyrepl • _pyrepl.historical_reader • _pyrepl.pager • _sitebuiltins • os • signal • site

imported by: _pyrepl • _pyrepl.completing_reader • _pyrepl.historical_reader • _pyrepl.reader • _pyrepl.readline

_pyrepl.completing_reader SourceModule

imports: __future__ • _pyrepl • _pyrepl.commands • _pyrepl.console • _pyrepl.reader • _pyrepl.types • dataclasses • re

imported by: _pyrepl.readline

_pyrepl.console SourceModule

imports: __future__ • _colorize • _pyrepl • abc • ast • code • dataclasses • linecache • os.path • sys • traceback • typing

imported by: _pyrepl • _pyrepl.base_eventqueue • _pyrepl.completing_reader • _pyrepl.main • _pyrepl.reader • _pyrepl.readline • _pyrepl.unix_console • _pyrepl.windows_console

_pyrepl.curses SourceModule

imports: _curses • _pyrepl • _pyrepl._minimal_curses • curses

imported by: _pyrepl • _pyrepl.unix_console • _pyrepl.unix_eventqueue

_pyrepl.fancy_termios SourceModule

imports: _pyrepl • termios

imported by: _pyrepl.unix_console

_pyrepl.historical_reader SourceModule

imports: __future__ • _pyrepl • _pyrepl.commands • _pyrepl.input • _pyrepl.reader • _pyrepl.types • contextlib • dataclasses

imported by: _pyrepl.commands • _pyrepl.readline

_pyrepl.input SourceModule

imports: __future__ • _pyrepl • _pyrepl.keymap • _pyrepl.types • abc • collections • unicodedata

imported by: _pyrepl • _pyrepl.historical_reader • _pyrepl.reader

_pyrepl.keymap SourceModule

imports: _pyrepl

imported by: _pyrepl.base_eventqueue • _pyrepl.input

_pyrepl.main SourceModule

imports: _pyrepl • _pyrepl.console • _pyrepl.simple_interact • _pyrepl.trace • errno • os • sys • tokenize

imported by: site

_pyrepl.pager SourceModule

imports: __future__ • _pyrepl • io • os • re • subprocess • sys • tempfile • termios • tty • typing

imported by: _pyrepl.commands • pydoc

_pyrepl.reader SourceModule

imports: __future__ • _colorize • _pyrepl • _pyrepl._threading_handler • _pyrepl.commands • _pyrepl.console • _pyrepl.input • _pyrepl.trace • _pyrepl.types • _pyrepl.utils • contextlib • dataclasses • sys

imported by: _pyrepl._threading_handler • _pyrepl.completing_reader • _pyrepl.historical_reader

_pyrepl.readline SourceModule

imports: 'collections.abc' • __future__ • _pyrepl • _pyrepl.commands • _pyrepl.completing_reader • _pyrepl.console • _pyrepl.historical_reader • _pyrepl.types • _pyrepl.unix_console • _pyrepl.windows_console • builtins • dataclasses • os • rlcompleter • site • sys • typing • warnings

imported by: _pyrepl.simple_interact • site

_pyrepl.simple_interact SourceModule

imports: __future__ • _pyrepl • _pyrepl.readline • _pyrepl.unix_console • _pyrepl.windows_console • _sitebuiltins • code • functools • os • sys • typing

imported by: _pyrepl.main

_pyrepl.trace SourceModule

imports: __future__ • _pyrepl • os • typing

imported by: _pyrepl.base_eventqueue • _pyrepl.main • _pyrepl.reader • _pyrepl.unix_console • _pyrepl.unix_eventqueue • _pyrepl.utils • _pyrepl.windows_console

_pyrepl.types SourceModule

imports: 'collections.abc' • _pyrepl

imported by: _pyrepl.completing_reader • _pyrepl.historical_reader • _pyrepl.input • _pyrepl.reader • _pyrepl.readline • _pyrepl.utils

_pyrepl.unix_console SourceModule

imports: __future__ • _pyrepl • _pyrepl.console • _pyrepl.curses • _pyrepl.fancy_termios • _pyrepl.trace • _pyrepl.unix_eventqueue • _pyrepl.utils • errno • fcntl • os • platform • posix • re • select • signal • struct • termios • time • typing

imported by: _pyrepl.readline • _pyrepl.simple_interact • site

_pyrepl.unix_eventqueue SourceModule

imports: _pyrepl • _pyrepl.base_eventqueue • _pyrepl.curses • _pyrepl.trace • os • termios

imported by: _pyrepl.unix_console

_pyrepl.utils SourceModule

imports: _pyrepl • _pyrepl.trace • _pyrepl.types • functools • re • unicodedata

imported by: _pyrepl.reader • _pyrepl.unix_console • _pyrepl.windows_console

_pyrepl.windows_console SourceModule

imports: __future__ • _pyrepl • _pyrepl.console • _pyrepl.trace • _pyrepl.utils • _pyrepl.windows_eventqueue • collections • ctypes • ctypes.wintypes • io • msvcrt • nt • os • sys • time • typing

imported by: _pyrepl.readline • _pyrepl.simple_interact • site

_pyrepl.windows_eventqueue SourceModule

imports: _pyrepl • _pyrepl.base_eventqueue

imported by: _pyrepl.windows_console

_pytest Package

imports: __future__ • _pytest._version • _pytest.nodes • _pytest.timing

imported by: _pytest._argcomplete • _pytest._code • _pytest._code.code • _pytest._io • _pytest._py • _pytest._version • _pytest.assertion • _pytest.assertion.util • _pytest.cacheprovider • _pytest.capture • _pytest.compat • _pytest.config • _pytest.debugging • _pytest.deprecated • _pytest.doctest • _pytest.faulthandler • _pytest.fixtures • _pytest.freeze_support • _pytest.helpconfig • _pytest.hookspec • _pytest.junitxml • _pytest.legacypath • _pytest.logging • _pytest.main • _pytest.mark • _pytest.monkeypatch • _pytest.nodes • _pytest.outcomes • _pytest.pastebin • _pytest.pathlib • _pytest.pytester • _pytest.pytester_assertions • _pytest.python • _pytest.python_api • _pytest.raises • _pytest.recwarn • _pytest.reports • _pytest.runner • _pytest.scope • _pytest.setuponly • _pytest.setupplan • _pytest.skipping • _pytest.stash • _pytest.stepwise • _pytest.terminal • _pytest.threadexception • _pytest.timing • _pytest.tmpdir • _pytest.tracemalloc • _pytest.unittest • _pytest.unraisableexception • _pytest.warning_types • _pytest.warnings • pytest

_pytest._argcomplete SourceModule

imports: __future__ • _pytest • argcomplete • argparse • glob • os • sys • typing

imported by: _pytest.config.argparsing • pytest

_pytest._code Package

imports: __future__ • _pytest • _pytest._code.code • _pytest._code.source

imported by: _pytest._code.code • _pytest._code.source • _pytest.assertion.util • _pytest.config • _pytest.debugging • _pytest.fixtures • _pytest.main • _pytest.mark.structures • _pytest.nodes • _pytest.pytester • _pytest.python • _pytest.raises • _pytest.terminal • _pytest.unittest • pytest

_pytest._code.code SourceModule

imports: 'collections.abc' • __future__ • _pytest • _pytest._code • _pytest._code.source • _pytest._io • _pytest._io.saferepr • _pytest.compat • _pytest.deprecated • _pytest.pathlib • ast • dataclasses • exceptiongroup • inspect • io • os • pathlib • pluggy • re • sys • traceback • types • typing • typing_extensions

imported by: _pytest._code • _pytest.config • _pytest.doctest • _pytest.fixtures • _pytest.hookspec • _pytest.junitxml • _pytest.nodes • _pytest.python • _pytest.raises • _pytest.reports • _pytest.runner • _pytest.terminal • pytest

_pytest._code.source SourceModule

imports: 'collections.abc' • __future__ • _pytest._code • ast • bisect • inspect • textwrap • tokenize • types • typing • warnings

imported by: _pytest._code • _pytest._code.code • _pytest._py.path • pytest

_pytest._io Package

imports: __future__ • _pytest • _pytest._io.terminalwriter

imported by: _pytest._code.code • _pytest._io.pprint • _pytest._io.saferepr • _pytest._io.terminalwriter • _pytest._io.wcwidth • _pytest.cacheprovider • _pytest.config • _pytest.config.argparsing • _pytest.doctest • _pytest.fixtures • _pytest.logging • _pytest.reports • _pytest.terminal

_pytest._io.pprint SourceModule

imports: 'collections.abc' • __future__ • _pytest._io • collections • dataclasses • io • re • types • typing

imported by: _pytest.assertion.util • pytest

_pytest._io.saferepr SourceModule

imports: __future__ • _pytest._io • pprint • reprlib

imported by: _pytest._code.code • _pytest.assertion.rewrite • _pytest.assertion.util • _pytest.python • _pytest.setuponly • pytest

_pytest._io.terminalwriter SourceModule

imports: 'collections.abc' • __future__ • _pytest._io • _pytest._io.wcwidth • _pytest.compat • _pytest.config.exceptions • colorama • os • pygments • pygments.formatters.terminal • pygments.lexer • pygments.lexers.diff • pygments.lexers.python • shutil • sys • typing

imported by: _pytest._io • pytest

_pytest._io.wcwidth SourceModule

imports: __future__ • _pytest._io • functools • unicodedata

imported by: _pytest._io.terminalwriter • _pytest.terminal • pytest

_pytest._py Package

imports: _pytest • _pytest._py

imported by: _pytest._py • _pytest._py.error • _pytest._py.path

_pytest._py.error SourceModule

imports: 'collections.abc' • __future__ • _pytest._py • errno • os • sys • typing • typing_extensions

imported by: _pytest._py.path • py • pytest

_pytest._py.path SourceModule

imports: 'collections.abc' • __future__ • _pytest._code.source • _pytest._py • _pytest._py.error • atexit • contextlib • fnmatch • grp • hashlib • importlib.util • io • os • os.path • pickle • posixpath • pwd • shutil • stat • subprocess • sys • tempfile • types • typing • uuid • warnings

imported by: py • pytest

_pytest._version SourceModule

imports: _pytest • typing

imported by: _pytest • _pytest.assertion.rewrite • _pytest.terminal • pytest

_pytest.assertion Package

imports: 'collections.abc' • __future__ • _pytest • _pytest.assertion • _pytest.assertion.rewrite • _pytest.assertion.truncate • _pytest.assertion.util • _pytest.config • _pytest.config.argparsing • _pytest.main • _pytest.nodes • sys • typing

imported by: _pytest.assertion • _pytest.assertion.rewrite • _pytest.assertion.truncate • _pytest.assertion.util • _pytest.config • pytest

_pytest.assertion.rewrite SourceModule

imports: 'collections.abc' • __future__ • _pytest._io.saferepr • _pytest._version • _pytest.assertion • _pytest.assertion.util • _pytest.config • _pytest.fixtures • _pytest.main • _pytest.pathlib • _pytest.stash • _pytest.warning_types • ast • collections • errno • functools • importlib.abc • importlib.machinery • importlib.readers • importlib.resources.abc • importlib.resources.readers • importlib.util • io • itertools • marshal • os • pathlib • struct • sys • tokenize • types • typing • warnings

imported by: _pytest.assertion • _pytest.config • pytest

_pytest.assertion.truncate SourceModule

imports: __future__ • _pytest.assertion • _pytest.assertion.util • _pytest.config • _pytest.nodes

imported by: _pytest.assertion • pytest

_pytest.assertion.util SourceModule

imports: 'collections.abc' • __future__ • _pytest • _pytest._code • _pytest._io.pprint • _pytest._io.saferepr • _pytest.assertion • _pytest.config • _pytest.outcomes • _pytest.python_api • dataclasses • difflib • os • pprint • typing • unicodedata

imported by: _pytest.assertion • _pytest.assertion.rewrite • _pytest.assertion.truncate • _pytest.raises • _pytest.terminal • pytest

_pytest.cacheprovider SourceModule

imports: 'collections.abc' • __future__ • _pytest • _pytest._io • _pytest.config • _pytest.config.argparsing • _pytest.deprecated • _pytest.fixtures • _pytest.main • _pytest.nodes • _pytest.pathlib • _pytest.reports • _pytest.warning_types • dataclasses • errno • json • os • pathlib • pprint • tempfile • typing • warnings

imported by: _pytest.config • _pytest.legacypath • _pytest.stepwise • pytest

_pytest.capture SourceModule

imports: 'collections.abc' • __future__ • _pytest • _pytest.config • _pytest.config.argparsing • _pytest.deprecated • _pytest.fixtures • _pytest.nodes • _pytest.reports • abc • collections • colorama • contextlib • io • os • readline • sys • tempfile • types • typing • typing_extensions

imported by: _pytest.debugging • _pytest.logging • _pytest.pytester • pytest

_pytest.compat SourceModule

imports: 'collections.abc' • __future__ • _pytest • _pytest.outcomes • enum • functools • inspect • os • pathlib • py • sys • typing

imported by: _pytest._code.code • _pytest._io.terminalwriter • _pytest.config.compat • _pytest.doctest • _pytest.fixtures • _pytest.hookspec • _pytest.legacypath • _pytest.mark.structures • _pytest.nodes • _pytest.pathlib • _pytest.pytester • _pytest.python • _pytest.terminal • _pytest.tmpdir • _pytest.unittest • pytest

_pytest.config Package

imports: 'collections.abc' • __future__ • _pytest • _pytest._code • _pytest._code.code • _pytest._io • _pytest.assertion • _pytest.assertion.rewrite • _pytest.cacheprovider • _pytest.config.argparsing • _pytest.config.compat • _pytest.config.exceptions • _pytest.config.findpaths • _pytest.deprecated • _pytest.helpconfig • _pytest.hookspec • _pytest.outcomes • _pytest.pathlib • _pytest.stash • _pytest.terminal • _pytest.warning_types • argparse • builtins • contextlib • copy • dataclasses • enum • functools • glob • importlib.metadata • inspect • os • packaging.requirements • packaging.version • pathlib • pluggy • pytest • re • shlex • sys • textwrap • types • typing • warnings

imported by: _pytest.assertion • _pytest.assertion.rewrite • _pytest.assertion.truncate • _pytest.assertion.util • _pytest.cacheprovider • _pytest.capture • _pytest.config.argparsing • _pytest.config.compat • _pytest.config.exceptions • _pytest.config.findpaths • _pytest.debugging • _pytest.doctest • _pytest.faulthandler • _pytest.fixtures • _pytest.helpconfig • _pytest.hookspec • _pytest.junitxml • _pytest.legacypath • _pytest.logging • _pytest.main • _pytest.mark • _pytest.mark.structures • _pytest.nodes • _pytest.pastebin • _pytest.pytester • _pytest.python • _pytest.reports • _pytest.setuponly • _pytest.setupplan • _pytest.skipping • _pytest.stepwise • _pytest.terminal • _pytest.threadexception • _pytest.tmpdir • _pytest.unittest • _pytest.unraisableexception • _pytest.warnings • pytest

_pytest.config.argparsing SourceModule

imports: 'collections.abc' • __future__ • _pytest._argcomplete • _pytest._io • _pytest.config • _pytest.config.exceptions • _pytest.deprecated • argparse • os • textwrap • typing

imported by: _pytest.assertion • _pytest.cacheprovider • _pytest.capture • _pytest.config • _pytest.debugging • _pytest.doctest • _pytest.faulthandler • _pytest.fixtures • _pytest.helpconfig • _pytest.hookspec • _pytest.junitxml • _pytest.logging • _pytest.main • _pytest.mark • _pytest.pastebin • _pytest.pytester • _pytest.python • _pytest.runner • _pytest.setuponly • _pytest.setupplan • _pytest.skipping • _pytest.stepwise • _pytest.terminal • _pytest.tmpdir • pytest

_pytest.config.compat SourceModule

imports: 'collections.abc' • __future__ • _pytest.compat • _pytest.config • _pytest.deprecated • functools • pathlib • pluggy • typing • warnings

imported by: _pytest.config • _pytest.main • _pytest.nodes • pytest

_pytest.config.exceptions SourceModule

imports: __future__ • _pytest.config • typing

imported by: _pytest._io.terminalwriter • _pytest.config • _pytest.config.argparsing • _pytest.config.findpaths • _pytest.debugging • pytest

_pytest.config.findpaths SourceModule

imports: 'collections.abc' • __future__ • _pytest.config • _pytest.config.exceptions • _pytest.outcomes • _pytest.pathlib • iniconfig • os • pathlib • sys • tomli • tomllib • typing • typing_extensions

imported by: _pytest.config • pytest

_pytest.debugging SourceModule

imports: 'collections.abc' • __future__ • _pytest • _pytest._code • _pytest.capture • _pytest.config • _pytest.config.argparsing • _pytest.config.exceptions • _pytest.nodes • _pytest.outcomes • _pytest.reports • _pytest.runner • argparse • doctest • functools • pdb • sys • types • typing • unittest

imported by: _pytest.unittest • pytest

_pytest.deprecated SourceModule

imports: __future__ • _pytest • _pytest.warning_types • warnings

imported by: _pytest._code.code • _pytest.cacheprovider • _pytest.capture • _pytest.config • _pytest.config.argparsing • _pytest.config.compat • _pytest.fixtures • _pytest.hookspec • _pytest.legacypath • _pytest.logging • _pytest.mark.structures • _pytest.nodes • _pytest.pytester • _pytest.python • _pytest.recwarn • _pytest.runner • _pytest.tmpdir • pytest

_pytest.doctest SourceModule

imports: 'collections.abc' • __future__ • _pytest • _pytest._code.code • _pytest._io • _pytest.compat • _pytest.config • _pytest.config.argparsing • _pytest.fixtures • _pytest.nodes • _pytest.outcomes • _pytest.pathlib • _pytest.python • _pytest.python_api • _pytest.warning_types • bdb • contextlib • doctest • functools • inspect • os • pathlib • platform • re • sys • traceback • types • typing • typing_extensions • warnings

imported by: pytest

_pytest.faulthandler SourceModule

imports: 'collections.abc' • __future__ • _pytest • _pytest.config • _pytest.config.argparsing • _pytest.nodes • _pytest.stash • faulthandler • os • pytest • sys

imported by: pytest

_pytest.fixtures SourceModule

imports: 'collections.abc' • __future__ • _pytest • _pytest._code • _pytest._code.code • _pytest._io • _pytest.compat • _pytest.config • _pytest.config.argparsing • _pytest.deprecated • _pytest.main • _pytest.mark • _pytest.mark.structures • _pytest.nodes • _pytest.outcomes • _pytest.pathlib • _pytest.python • _pytest.scope • _pytest.warning_types • abc • collections • dataclasses • exceptiongroup • functools • inspect • os • pathlib • sys • types • typing • warnings

imported by: _pytest.assertion.rewrite • _pytest.cacheprovider • _pytest.capture • _pytest.doctest • _pytest.hookspec • _pytest.junitxml • _pytest.legacypath • _pytest.logging • _pytest.main • _pytest.mark.structures • _pytest.monkeypatch • _pytest.nodes • _pytest.pytester • _pytest.python • _pytest.recwarn • _pytest.setuponly • _pytest.setupplan • _pytest.tmpdir • _pytest.unittest • pytest

_pytest.freeze_support SourceModule

imports: 'collections.abc' • __future__ • _pytest • os • pkgutil • types

imported by: pytest

_pytest.helpconfig SourceModule

imports: 'collections.abc' • __future__ • _pytest • _pytest.config • _pytest.config.argparsing • _pytest.terminal • argparse • os • pytest • sys • textwrap

imported by: _pytest.config • pytest

_pytest.hookspec SourceModule

imports: 'collections.abc' • __future__ • _pytest • _pytest._code.code • _pytest.compat • _pytest.config • _pytest.config.argparsing • _pytest.deprecated • _pytest.fixtures • _pytest.main • _pytest.nodes • _pytest.outcomes • _pytest.python • _pytest.reports • _pytest.runner • _pytest.terminal • pathlib • pdb • pluggy • typing • warnings

imported by: _pytest.config • pytest

_pytest.junitxml SourceModule

imports: 'collections.abc' • __future__ • _pytest • _pytest._code.code • _pytest.config • _pytest.config.argparsing • _pytest.fixtures • _pytest.nodes • _pytest.reports • _pytest.stash • _pytest.terminal • _pytest.timing • _pytest.warning_types • functools • os • platform • pytest • re • xml.etree.ElementTree

imported by: pytest

_pytest.legacypath SourceModule

imports: __future__ • _pytest • _pytest.cacheprovider • _pytest.compat • _pytest.config • _pytest.deprecated • _pytest.fixtures • _pytest.main • _pytest.monkeypatch • _pytest.nodes • _pytest.pytester • _pytest.terminal • _pytest.tmpdir • dataclasses • iniconfig • pathlib • pexpect • shlex • subprocess • typing

imported by: pytest

_pytest.logging SourceModule

imports: 'collections.abc' • __future__ • _pytest • _pytest._io • _pytest.capture • _pytest.config • _pytest.config.argparsing • _pytest.deprecated • _pytest.fixtures • _pytest.main • _pytest.nodes • _pytest.stash • _pytest.terminal • contextlib • datetime • io • logging • os • pathlib • re • types • typing

imported by: pytest

_pytest.main SourceModule

imports: 'collections.abc' • __future__ • _pytest • _pytest._code • _pytest.config • _pytest.config.argparsing • _pytest.config.compat • _pytest.fixtures • _pytest.nodes • _pytest.outcomes • _pytest.pathlib • _pytest.reports • _pytest.runner • _pytest.warning_types • argparse • dataclasses • fnmatch • functools • importlib • importlib.util • os • pathlib • pluggy • sys • typing • typing_extensions • warnings

imported by: _pytest.assertion • _pytest.assertion.rewrite • _pytest.cacheprovider • _pytest.fixtures • _pytest.hookspec • _pytest.legacypath • _pytest.logging • _pytest.nodes • _pytest.pytester • _pytest.python • _pytest.runner • _pytest.stepwise • _pytest.terminal • _pytest.warnings • pytest

_pytest.mark Package

imports: 'collections.abc' • __future__ • _pytest • _pytest.config • _pytest.config.argparsing • _pytest.mark.expression • _pytest.mark.structures • _pytest.nodes • _pytest.stash • collections • dataclasses • pytest • typing

imported by: _pytest.fixtures • _pytest.mark.expression • _pytest.mark.structures • _pytest.nodes • _pytest.python • pytest

_pytest.mark.expression SourceModule

imports: 'collections.abc' • __future__ • _pytest.mark • ast • dataclasses • enum • keyword • re • types • typing

imported by: _pytest.mark • pytest

_pytest.mark.structures SourceModule

imports: 'collections.abc' • __future__ • _pytest._code • _pytest.compat • _pytest.config • _pytest.deprecated • _pytest.fixtures • _pytest.mark • _pytest.nodes • _pytest.outcomes • _pytest.raises • _pytest.scope • _pytest.warning_types • dataclasses • enum • inspect • typing • warnings

imported by: _pytest.fixtures • _pytest.mark • _pytest.nodes • _pytest.python • _pytest.skipping • pytest

_pytest.monkeypatch SourceModule

imports: 'collections.abc' • __future__ • _pytest • _pytest.fixtures • _pytest.warning_types • contextlib • importlib • inspect • os • pkg_resources • re • sys • typing • warnings

imported by: _pytest.legacypath • _pytest.pytester • _pytest.tmpdir • _pytest.unittest • pytest

_pytest.nodes SourceModule

imports: 'collections.abc' • __future__ • _pytest • _pytest._code • _pytest._code.code • _pytest.compat • _pytest.config • _pytest.config.compat • _pytest.deprecated • _pytest.fixtures • _pytest.main • _pytest.mark • _pytest.mark.structures • _pytest.outcomes • _pytest.pathlib • _pytest.stash • _pytest.warning_types • abc • functools • inspect • os • pathlib • pluggy • typing • typing_extensions • warnings

imported by: _pytest • _pytest.assertion • _pytest.assertion.truncate • _pytest.cacheprovider • _pytest.capture • _pytest.debugging • _pytest.doctest • _pytest.faulthandler • _pytest.fixtures • _pytest.hookspec • _pytest.junitxml • _pytest.legacypath • _pytest.logging • _pytest.main • _pytest.mark • _pytest.mark.structures • _pytest.pytester • _pytest.python • _pytest.reports • _pytest.runner • _pytest.skipping • _pytest.stepwise • _pytest.terminal • _pytest.threadexception • _pytest.tmpdir • _pytest.unittest • _pytest.unraisableexception • _pytest.warnings • pytest

_pytest.outcomes SourceModule

imports: 'collections.abc' • __future__ • _pytest • _pytest.warning_types • packaging.version • sys • typing • warnings

imported by: _pytest.assertion.util • _pytest.compat • _pytest.config • _pytest.config.findpaths • _pytest.debugging • _pytest.doctest • _pytest.fixtures • _pytest.hookspec • _pytest.main • _pytest.mark.structures • _pytest.nodes • _pytest.pathlib • _pytest.pytester • _pytest.python • _pytest.raises • _pytest.recwarn • _pytest.reports • _pytest.runner • _pytest.scope • _pytest.skipping • _pytest.unittest • pytest

_pytest.pastebin SourceModule

imports: __future__ • _pytest • _pytest.config • _pytest.config.argparsing • _pytest.stash • _pytest.terminal • io • pytest • re • tempfile • typing • urllib.error • urllib.parse • urllib.request

imported by: pytest

_pytest.pathlib SourceModule

imports: 'collections.abc' • __future__ • _pytest • _pytest.compat • _pytest.outcomes • _pytest.warning_types • atexit • contextlib • enum • errno • fnmatch • functools • importlib._bootstrap_external • importlib.machinery • importlib.util • itertools • os • os.path • pathlib • posixpath • shutil • stat • sys • types • typing • uuid • warnings

imported by: _pytest._code.code • _pytest.assertion.rewrite • _pytest.cacheprovider • _pytest.config • _pytest.config.findpaths • _pytest.doctest • _pytest.fixtures • _pytest.main • _pytest.nodes • _pytest.pytester • _pytest.python • _pytest.terminal • _pytest.tmpdir • pytest

_pytest.pytester SourceModule

imports: 'collections.abc' • __future__ • _pytest • _pytest._code • _pytest.capture • _pytest.compat • _pytest.config • _pytest.config.argparsing • _pytest.deprecated • _pytest.fixtures • _pytest.main • _pytest.monkeypatch • _pytest.nodes • _pytest.outcomes • _pytest.pathlib • _pytest.pytester_assertions • _pytest.reports • _pytest.timing • _pytest.tmpdir • _pytest.unraisableexception • _pytest.warning_types • contextlib • fnmatch • gc • importlib • iniconfig • io • locale • os • pathlib • pexpect • platform • re • shutil • subprocess • sys • traceback • typing • weakref

imported by: _pytest.legacypath • pytest

_pytest.pytester_assertions SourceModule

imports: 'collections.abc' • __future__ • _pytest • _pytest.reports

imported by: _pytest.pytester • pytest

_pytest.python SourceModule

imports: 'collections.abc' • __future__ • _pytest • _pytest._code • _pytest._code.code • _pytest._io.saferepr • _pytest.compat • _pytest.config • _pytest.config.argparsing • _pytest.deprecated • _pytest.fixtures • _pytest.main • _pytest.mark • _pytest.mark.structures • _pytest.nodes • _pytest.outcomes • _pytest.pathlib • _pytest.scope • _pytest.stash • _pytest.warning_types • abc • collections • dataclasses • enum • fnmatch • functools • inspect • itertools • os • pathlib • re • types • typing • typing_extensions • warnings

imported by: _pytest.doctest • _pytest.fixtures • _pytest.hookspec • _pytest.unittest • pytest

_pytest.python_api SourceModule

imports: 'collections.abc' • __future__ • _pytest • decimal • itertools • math • numbers • numpy • pprint • sys • typing

imported by: _pytest.assertion.util • _pytest.doctest • pytest

_pytest.raises SourceModule

imports: 'collections.abc' • __future__ • _pytest • _pytest._code • _pytest._code.code • _pytest.assertion.util • _pytest.outcomes • _pytest.warning_types • abc • exceptiongroup • re • sys • textwrap • types • typing • typing_extensions • warnings

imported by: _pytest.mark.structures • _pytest.skipping • pytest

_pytest.recwarn SourceModule

imports: 'collections.abc' • __future__ • _pytest • _pytest.deprecated • _pytest.fixtures • _pytest.outcomes • pprint • re • types • typing • typing_extensions • warnings

imported by: pytest

_pytest.reports SourceModule

imports: 'collections.abc' • __future__ • _pytest • _pytest._code.code • _pytest._io • _pytest.config • _pytest.nodes • _pytest.outcomes • _pytest.runner • dataclasses • io • os • pprint • typing • typing_extensions

imported by: _pytest.cacheprovider • _pytest.capture • _pytest.debugging • _pytest.hookspec • _pytest.junitxml • _pytest.main • _pytest.pytester • _pytest.pytester_assertions • _pytest.runner • _pytest.skipping • _pytest.stepwise • _pytest.terminal • _pytest.tmpdir • pytest

_pytest.runner SourceModule

imports: 'collections.abc' • __future__ • _pytest • _pytest._code.code • _pytest.config.argparsing • _pytest.deprecated • _pytest.main • _pytest.nodes • _pytest.outcomes • _pytest.reports • _pytest.terminal • _pytest.timing • bdb • dataclasses • exceptiongroup • os • sys • types • typing

imported by: _pytest.debugging • _pytest.hookspec • _pytest.main • _pytest.reports • _pytest.skipping • _pytest.unittest • pytest

_pytest.scope SourceModule

imports: __future__ • _pytest • _pytest.outcomes • enum • functools • typing

imported by: _pytest.fixtures • _pytest.mark.structures • _pytest.python • _pytest.setuponly • pytest

_pytest.setuponly SourceModule

imports: 'collections.abc' • __future__ • _pytest • _pytest._io.saferepr • _pytest.config • _pytest.config.argparsing • _pytest.fixtures • _pytest.scope • pytest

imported by: pytest

_pytest.setupplan SourceModule

imports: __future__ • _pytest • _pytest.config • _pytest.config.argparsing • _pytest.fixtures • pytest

imported by: pytest

_pytest.skipping SourceModule

imports: 'collections.abc' • __future__ • _pytest • _pytest.config • _pytest.config.argparsing • _pytest.mark.structures • _pytest.nodes • _pytest.outcomes • _pytest.raises • _pytest.reports • _pytest.runner • _pytest.stash • dataclasses • os • platform • pytest • sys • traceback • typing

imported by: pytest

_pytest.stash SourceModule

imports: __future__ • _pytest • typing

imported by: _pytest.assertion.rewrite • _pytest.config • _pytest.faulthandler • _pytest.junitxml • _pytest.logging • _pytest.mark • _pytest.nodes • _pytest.pastebin • _pytest.python • _pytest.skipping • _pytest.threadexception • _pytest.tmpdir • _pytest.unraisableexception • pytest

_pytest.stepwise SourceModule

imports: __future__ • _pytest • _pytest.cacheprovider • _pytest.config • _pytest.config.argparsing • _pytest.main • _pytest.nodes • _pytest.reports • dataclasses • datetime • typing • typing_extensions

imported by: pytest

_pytest.terminal SourceModule

imports: 'collections.abc' • __future__ • _pytest • _pytest._code • _pytest._code.code • _pytest._io • _pytest._io.wcwidth • _pytest._version • _pytest.assertion.util • _pytest.compat • _pytest.config • _pytest.config.argparsing • _pytest.main • _pytest.nodes • _pytest.pathlib • _pytest.reports • _pytest.timing • _pytest.warnings • argparse • collections • dataclasses • datetime • functools • inspect • pathlib • platform • pluggy • sys • textwrap • typing • warnings

imported by: _pytest.config • _pytest.helpconfig • _pytest.hookspec • _pytest.junitxml • _pytest.legacypath • _pytest.logging • _pytest.pastebin • _pytest.runner • _pytest.warnings • pytest

_pytest.threadexception SourceModule

imports: 'collections.abc' • __future__ • _pytest • _pytest.config • _pytest.nodes • _pytest.stash • _pytest.tracemalloc • collections • exceptiongroup • functools • pytest • sys • threading • traceback • typing • warnings

imported by: pytest

_pytest.timing SourceModule

imports: __future__ • _pytest • _pytest.timing • dataclasses • datetime • pytest • time • typing

imported by: _pytest • _pytest.junitxml • _pytest.pytester • _pytest.runner • _pytest.terminal • _pytest.timing • pytest

_pytest.tmpdir SourceModule

imports: 'collections.abc' • __future__ • _pytest • _pytest.compat • _pytest.config • _pytest.config.argparsing • _pytest.deprecated • _pytest.fixtures • _pytest.monkeypatch • _pytest.nodes • _pytest.pathlib • _pytest.reports • _pytest.stash • dataclasses • getpass • os • pathlib • re • shutil • tempfile • typing

imported by: _pytest.legacypath • _pytest.pytester • pytest

_pytest.tracemalloc SourceModule

imports: __future__ • _pytest • tracemalloc

imported by: _pytest.threadexception • _pytest.unraisableexception • _pytest.warnings • pytest

_pytest.unittest SourceModule

imports: 'collections.abc' • 'twisted.python' • 'twisted.trial' • __future__ • _pytest • _pytest._code • _pytest.compat • _pytest.config • _pytest.debugging • _pytest.fixtures • _pytest.monkeypatch • _pytest.nodes • _pytest.outcomes • _pytest.python • _pytest.runner • enum • exceptiongroup • importlib.metadata • inspect • packaging.version • pytest • sys • traceback • twisted • types • typing • unittest • zope

imported by: pytest

_pytest.unraisableexception SourceModule

imports: 'collections.abc' • __future__ • _pytest • _pytest.config • _pytest.nodes • _pytest.stash • _pytest.tracemalloc • collections • exceptiongroup • functools • gc • pytest • sys • traceback • typing • warnings

imported by: _pytest.pytester • pytest

_pytest.warning_types SourceModule

imports: __future__ • _pytest • dataclasses • inspect • types • typing • warnings

imported by: _pytest.assertion.rewrite • _pytest.cacheprovider • _pytest.config • _pytest.deprecated • _pytest.doctest • _pytest.fixtures • _pytest.junitxml • _pytest.main • _pytest.mark.structures • _pytest.monkeypatch • _pytest.nodes • _pytest.outcomes • _pytest.pathlib • _pytest.pytester • _pytest.python • _pytest.raises • pytest

_pytest.warnings SourceModule

imports: 'collections.abc' • __future__ • _pytest • _pytest.config • _pytest.main • _pytest.nodes • _pytest.terminal • _pytest.tracemalloc • contextlib • pytest • sys • typing • warnings

imported by: _pytest.terminal • pytest

_queue C:\Program Files\Python313\DLLs\_queue.pyd

imported by: queue

_random (builtin module)

imported by: random

_scproxy MissingModule

imported by: urllib.request

_sha1 (builtin module)

imported by: hashlib

_sha2 (builtin module)

imported by: hashlib • random

_sha3 (builtin module)

imported by: hashlib

_signal (builtin module)

imported by: signal

_sitebuiltins SourceModule

imports: os • pydoc • sys

imported by: _pyrepl.commands • _pyrepl.simple_interact • site

_socket C:\Program Files\Python313\DLLs\_socket.pyd

imported by: setuptools._vendor.typing_extensions • socket • types

_sqlite3 C:\Program Files\Python313\DLLs\_sqlite3.pyd

imported by: sqlite3.dbapi2

_sre (builtin module)

imports: copy • re

imported by: re • re._compiler • re._constants

_ssl C:\Program Files\Python313\DLLs\_ssl.pyd

imports: socket

imported by: ssl

_stat (builtin module)

imported by: stat

_statistics (builtin module)

imported by: statistics

_string (builtin module)

imported by: string

_strptime SourceModule

imports: _thread • calendar • datetime • locale • os • re • time • warnings

imported by: _datetime • _pydatetime • time

_struct (builtin module)

imported by: struct

_suggestions (builtin module)

imported by: traceback

_sysconfig (builtin module)

imported by: sysconfig

_thread (builtin module)

imported by: _strptime • functools • numpy._core.arrayprint • reprlib • six.moves._thread • tempfile • threading

_threading_local SourceModule

imports: contextlib • threading • weakref

imported by: threading

_tkinter C:\Program Files\Python313\DLLs\_tkinter.pyd

imported by: tkinter

_tokenize (builtin module)

imported by: tokenize

_tracemalloc (builtin module)

imported by: tracemalloc

_typeshed MissingModule

imported by: numpy.random.bit_generator • pkg_resources • setuptools._distutils.dist • setuptools.compat.py311 • setuptools.glob

_typing (builtin module)

imported by: typing

_uuid C:\Program Files\Python313\DLLs\_uuid.pyd

imported by: uuid

_warnings (builtin module)

imported by: importlib._bootstrap_external • warnings • zipimport

_weakref (builtin module)

imported by: _weakrefset • collections • weakref • xml.sax.expatreader

_weakrefset SourceModule

imports: _weakref • types

imported by: _py_abc • multiprocessing.process • threading • time_tracker_working.py • weakref

_winapi (builtin module)

imported by: asyncio.windows_events • asyncio.windows_utils • encodings • mimetypes • multiprocessing.connection • multiprocessing.heap • multiprocessing.popen_spawn_win32 • multiprocessing.reduction • multiprocessing.shared_memory • multiprocessing.spawn • ntpath • shutil • subprocess • sysconfig

_winreg MissingModule

imported by: pygments.formatters.img

_wmi C:\Program Files\Python313\DLLs\_wmi.pyd

imported by: platform

abc SourceModule

imports: _abc • _py_abc

imported by: PIL.BlpImagePlugin • PIL.Image • PIL.ImageFile • PIL.ImageFilter • PIL.ImageShow • _collections_abc • _pyrepl.console • _pyrepl.input • _pytest.capture • _pytest.fixtures • _pytest.nodes • _pytest.python • _pytest.raises • contextlib • dataclasses • email._policybase • functools • importlib._abc • importlib.abc • importlib.metadata • importlib.resources.abc • inspect • io • matplotlib._mathtext • multiprocessing.reduction • narwhals.dataframe • numbers • numpy.f2py._backends._backend • numpy.polynomial._polybase • numpy.random.bit_generator • os • packaging.specifiers • pandas.core.apply • pandas.core.arrays.arrow.accessors • pandas.core.computation.engines • pandas.core.indexes.datetimelike • pandas.core.interchange.dataframe_protocol • pandas.core.methods.describe • pandas.core.strings.base • pandas.io.common • pandas.io.formats.info • pandas.io.json._json • pandas.io.sas.sasreader • pandas.io.sql • pandas.plotting._matplotlib.core • pyparsing.core • selectors • setuptools • setuptools._distutils.cmd • setuptools._vendor.importlib_metadata • setuptools._vendor.packaging.specifiers • setuptools._vendor.platformdirs.api • setuptools._vendor.typing_extensions • setuptools._vendor.wheel.cli.convert • setuptools._vendor.wheel.vendored.packaging.specifiers • time_tracker_working.py • typing

android MissingModule

imported by: setuptools._vendor.platformdirs.android

anywidget MissingModule

imported by: plotly.basewidget

argcomplete MissingModule

imported by: _pytest._argcomplete

argparse SourceModule

imports: copy • gettext • os • re • shutil • sys • textwrap • warnings

imported by: _pytest._argcomplete • _pytest.config • _pytest.config.argparsing • _pytest.debugging • _pytest.helpconfig • _pytest.main • _pytest.terminal • ast • calendar • code • dis • doctest • gzip • http.server • inspect • matplotlib.dviread • numpy.f2py.f2py2e • pdb • pickletools • py_compile • random • setuptools._vendor.backports.tarfile • setuptools._vendor.wheel.cli • sqlite3.__main__ • tarfile • tokenize • unittest.main • uuid • webbrowser • zipfile

array (builtin module)

imported by: PIL.ImagePalette • PIL.JpegImagePlugin • _plotly_utils.png • multiprocessing.dummy • multiprocessing.managers • multiprocessing.reduction • socket

ast SourceModule

imports: _ast • argparse • collections • contextlib • enum • inspect • re • sys • warnings

imported by: _pyrepl.console • _pytest._code.code • _pytest._code.source • _pytest.assertion.rewrite • _pytest.mark.expression • inspect • matplotlib.rcsetup • numpy._core._internal • numpy.lib._format_impl • numpy.lib._utils_impl • numpy.matrixlib.defmatrix • packaging._parser • pandas.core.computation.expr • pandas.core.computation.pytables • pydoc • pygments.lexers.special • setuptools._vendor.packaging._parser • setuptools._vendor.wheel.vendored.packaging._parser • setuptools.config.expand • traceback

asyncio Package

imports: asyncio • asyncio.DefaultEventLoopPolicy • asyncio.base_events • asyncio.base_futures • asyncio.base_subprocess • asyncio.base_tasks • asyncio.constants • asyncio.coroutines • asyncio.events • asyncio.exceptions • asyncio.format_helpers • asyncio.futures • asyncio.locks • asyncio.mixins • asyncio.proactor_events • asyncio.protocols • asyncio.queues • asyncio.runners • asyncio.selector_events • asyncio.sslproto • asyncio.staggered • asyncio.streams • asyncio.subprocess • asyncio.taskgroups • asyncio.tasks • asyncio.threads • asyncio.timeouts • asyncio.transports • asyncio.trsock • asyncio.unix_events • asyncio.windows_events • asyncio.windows_utils • sys

imported by: asyncio • asyncio.base_events • asyncio.base_futures • asyncio.base_subprocess • asyncio.base_tasks • asyncio.constants • asyncio.coroutines • asyncio.events • asyncio.exceptions • asyncio.format_helpers • asyncio.futures • asyncio.locks • asyncio.log • asyncio.mixins • asyncio.proactor_events • asyncio.protocols • asyncio.queues • asyncio.runners • asyncio.selector_events • asyncio.sslproto • asyncio.staggered • asyncio.streams • asyncio.subprocess • asyncio.taskgroups • asyncio.tasks • asyncio.threads • asyncio.timeouts • asyncio.transports • asyncio.trsock • asyncio.unix_events • asyncio.windows_events • asyncio.windows_utils • matplotlib.backends.backend_webagg • matplotlib.backends.backend_webagg_core • unittest.async_case • unittest.mock

asyncio.DefaultEventLoopPolicy MissingModule

imported by: asyncio • asyncio.events

asyncio.base_events SourceModule

imports: 'collections.abc' • asyncio • asyncio.constants • asyncio.coroutines • asyncio.events • asyncio.exceptions • asyncio.futures • asyncio.log • asyncio.protocols • asyncio.sslproto • asyncio.staggered • asyncio.tasks • asyncio.timeouts • asyncio.transports • asyncio.trsock • collections • concurrent.futures • errno • heapq • itertools • os • socket • ssl • stat • subprocess • sys • threading • time • traceback • warnings • weakref

imported by: asyncio • asyncio.proactor_events • asyncio.selector_events • asyncio.unix_events

asyncio.base_futures SourceModule

imports: asyncio • asyncio.format_helpers • reprlib

imported by: asyncio • asyncio.base_tasks • asyncio.futures

asyncio.base_subprocess SourceModule

imports: asyncio • asyncio.log • asyncio.protocols • asyncio.transports • collections • os • signal • subprocess • sys • warnings

imported by: asyncio • asyncio.unix_events • asyncio.windows_events

asyncio.base_tasks SourceModule

imports: asyncio • asyncio.base_futures • asyncio.coroutines • linecache • reprlib • traceback

imported by: asyncio • asyncio.tasks

asyncio.constants SourceModule

imports: asyncio • enum

imported by: asyncio • asyncio.base_events • asyncio.format_helpers • asyncio.proactor_events • asyncio.runners • asyncio.selector_events • asyncio.sslproto • asyncio.unix_events

asyncio.coroutines SourceModule

imports: 'collections.abc' • asyncio • inspect • os • sys • types

imported by: asyncio • asyncio.base_events • asyncio.base_tasks • asyncio.runners • asyncio.streams • asyncio.tasks • asyncio.unix_events

asyncio.events SourceModule

imports: _asyncio • asyncio • asyncio.DefaultEventLoopPolicy • asyncio.format_helpers • contextvars • os • signal • socket • subprocess • sys • threading • warnings

imported by: asyncio • asyncio.base_events • asyncio.futures • asyncio.mixins • asyncio.runners • asyncio.selector_events • asyncio.staggered • asyncio.streams • asyncio.subprocess • asyncio.taskgroups • asyncio.tasks • asyncio.threads • asyncio.timeouts • asyncio.unix_events • asyncio.windows_events

asyncio.exceptions SourceModule

imports: asyncio

imported by: asyncio • asyncio.base_events • asyncio.futures • asyncio.locks • asyncio.proactor_events • asyncio.runners • asyncio.sslproto • asyncio.staggered • asyncio.streams • asyncio.taskgroups • asyncio.tasks • asyncio.timeouts • asyncio.unix_events • asyncio.windows_events

asyncio.format_helpers SourceModule

imports: asyncio • asyncio.constants • functools • inspect • reprlib • sys • traceback

imported by: asyncio • asyncio.base_futures • asyncio.events • asyncio.futures • asyncio.streams

asyncio.futures SourceModule

imports: _asyncio • asyncio • asyncio.base_futures • asyncio.events • asyncio.exceptions • asyncio.format_helpers • concurrent.futures • contextvars • logging • sys • types

imported by: asyncio • asyncio.base_events • asyncio.proactor_events • asyncio.selector_events • asyncio.tasks • asyncio.unix_events • asyncio.windows_events

asyncio.locks SourceModule

imports: asyncio • asyncio.exceptions • asyncio.mixins • collections • enum

imported by: asyncio • asyncio.queues • asyncio.staggered

asyncio.log SourceModule

imports: asyncio • logging

imported by: asyncio.base_events • asyncio.base_subprocess • asyncio.proactor_events • asyncio.selector_events • asyncio.sslproto • asyncio.streams • asyncio.subprocess • asyncio.unix_events • asyncio.windows_events

asyncio.mixins SourceModule

imports: asyncio • asyncio.events • threading

imported by: asyncio • asyncio.locks • asyncio.queues

asyncio.proactor_events SourceModule

imports: asyncio • asyncio.base_events • asyncio.constants • asyncio.exceptions • asyncio.futures • asyncio.log • asyncio.protocols • asyncio.sslproto • asyncio.transports • asyncio.trsock • collections • io • os • signal • socket • threading • warnings

imported by: asyncio • asyncio.windows_events

asyncio.protocols SourceModule

imports: asyncio

imported by: asyncio • asyncio.base_events • asyncio.base_subprocess • asyncio.proactor_events • asyncio.selector_events • asyncio.sslproto • asyncio.streams • asyncio.subprocess

asyncio.queues SourceModule

imports: asyncio • asyncio.locks • asyncio.mixins • collections • heapq • types

imported by: asyncio • asyncio.tasks

asyncio.runners SourceModule

imports: asyncio • asyncio.constants • asyncio.coroutines • asyncio.events • asyncio.exceptions • asyncio.tasks • contextvars • enum • functools • signal • threading

imported by: asyncio

asyncio.selector_events SourceModule

imports: asyncio • asyncio.base_events • asyncio.constants • asyncio.events • asyncio.futures • asyncio.log • asyncio.protocols • asyncio.sslproto • asyncio.transports • asyncio.trsock • collections • errno • functools • itertools • os • selectors • socket • ssl • warnings • weakref

imported by: asyncio • asyncio.unix_events • asyncio.windows_events

asyncio.sslproto SourceModule

imports: asyncio • asyncio.constants • asyncio.exceptions • asyncio.log • asyncio.protocols • asyncio.transports • collections • enum • ssl • warnings

imported by: asyncio • asyncio.base_events • asyncio.proactor_events • asyncio.selector_events

asyncio.staggered SourceModule

imports: asyncio • asyncio.events • asyncio.exceptions • asyncio.locks • asyncio.tasks • contextlib

imported by: asyncio • asyncio.base_events

asyncio.streams SourceModule

imports: asyncio • asyncio.coroutines • asyncio.events • asyncio.exceptions • asyncio.format_helpers • asyncio.log • asyncio.protocols • asyncio.tasks • collections • socket • sys • warnings • weakref

imported by: asyncio • asyncio.subprocess

asyncio.subprocess SourceModule

imports: asyncio • asyncio.events • asyncio.log • asyncio.protocols • asyncio.streams • asyncio.tasks • subprocess

imported by: asyncio

asyncio.taskgroups SourceModule

imports: asyncio • asyncio.events • asyncio.exceptions • asyncio.tasks

imported by: asyncio

asyncio.tasks SourceModule

imports: _asyncio • asyncio • asyncio.base_tasks • asyncio.coroutines • asyncio.events • asyncio.exceptions • asyncio.futures • asyncio.queues • asyncio.timeouts • concurrent.futures • contextvars • functools • inspect • itertools • math • types • weakref

imported by: asyncio • asyncio.base_events • asyncio.runners • asyncio.staggered • asyncio.streams • asyncio.subprocess • asyncio.taskgroups • asyncio.timeouts • asyncio.unix_events • asyncio.windows_events

asyncio.threads SourceModule

imports: asyncio • asyncio.events • contextvars • functools

imported by: asyncio

asyncio.timeouts SourceModule

imports: asyncio • asyncio.events • asyncio.exceptions • asyncio.tasks • enum • types • typing

imported by: asyncio • asyncio.base_events • asyncio.tasks

asyncio.transports SourceModule

imports: asyncio

imported by: asyncio • asyncio.base_events • asyncio.base_subprocess • asyncio.proactor_events • asyncio.selector_events • asyncio.sslproto • asyncio.unix_events

asyncio.trsock SourceModule

imports: asyncio • socket

imported by: asyncio • asyncio.base_events • asyncio.proactor_events • asyncio.selector_events

asyncio.unix_events SourceModule

imports: asyncio • asyncio.base_events • asyncio.base_subprocess • asyncio.constants • asyncio.coroutines • asyncio.events • asyncio.exceptions • asyncio.futures • asyncio.log • asyncio.selector_events • asyncio.tasks • asyncio.transports • errno • io • itertools • os • selectors • signal • socket • stat • subprocess • sys • threading • warnings

imported by: asyncio

asyncio.windows_events SourceModule

imports: _overlapped • _winapi • asyncio • asyncio.base_subprocess • asyncio.events • asyncio.exceptions • asyncio.futures • asyncio.log • asyncio.proactor_events • asyncio.selector_events • asyncio.tasks • asyncio.windows_utils • errno • functools • math • msvcrt • socket • struct • sys • time • weakref

imported by: asyncio

asyncio.windows_utils SourceModule

imports: _winapi • asyncio • itertools • msvcrt • os • subprocess • sys • tempfile • warnings

imported by: asyncio • asyncio.windows_events

atexit (builtin module)

imported by: PIL.Image • _pytest._py.path • _pytest.pathlib • colorama.initialise • logging • matplotlib • matplotlib._pylab_helpers • multiprocessing.forkserver • multiprocessing.popen_fork • multiprocessing.util • plotly.io._orca • pyi_rth_mplconfig.py • rlcompleter • site • weakref

backports Package

imports: backports.tarfile • pkgutil

imported by: backports.tarfile • setuptools._vendor.jaraco.context

backports.tarfile AliasNode

imports: backports • setuptools._vendor.backports.tarfile

imported by: backports • setuptools._vendor.jaraco.context

base64 SourceModule

imports: binascii • getopt • re • struct • sys

imported by: PIL.ImageFont • _plotly_utils.basevalidators • _plotly_utils.data_utils • _plotly_utils.utils • email._encoded_words • email.base64mime • email.encoders • encodings.base64_codec • http.server • matplotlib.colors • matplotlib.font_manager • plotly.io._base_renderers • plotly.io._html • secrets • setuptools._vendor.wheel.util • ssl • urllib.request • xmlrpc.client

bdb SourceModule

imports: contextlib • fnmatch • inspect • linecache • os • reprlib • sys

imported by: _pytest.doctest • _pytest.runner • pdb

binascii (builtin module)

imported by: base64 • email._encoded_words • email.base64mime • email.contentmanager • email.header • email.message • encodings.hex_codec • encodings.uu_codec • http.server • plistlib • quopri • zipfile

bisect SourceModule

imports: _bisect

imported by: _plotly_utils.colors • _pytest._code.source • dateutil.tz.tz • multiprocessing.heap • pygments.lexers.textedit • pytz.tzinfo • random • statistics • urllib.request

botocore MissingModule

imported by: pandas.io.common

bs4 MissingModule

imported by: pandas.io.html

builtins (builtin module)

imported by: PIL.Image • PIL.ImageMath • _pyrepl.readline • _pytest.config • bz2 • code • codecs • doctest • enum • gettext • gzip • inspect • locale • lzma • matplotlib.axes._axes • numpy._core.numeric • numpy._core.numerictypes • numpy.lib._function_base_impl • numpy.ma.core • numpy.random.mtrand • operator • pandas.core.common • pydoc • reprlib • rlcompleter • setuptools._vendor.backports.tarfile • setuptools.config._validate_pyproject.formats • site • subprocess • tarfile • tokenize • unittest.mock • warnings

bz2 SourceModule

imports: _bz2 • _compression • builtins • io • os

imported by: encodings.bz2_codec • fileinput • matplotlib.cbook • numpy.lib._datasource • pandas.compat.compressors • pygments.formatters.other • pygments.lexers.special • setuptools._vendor.backports.tarfile • shutil • tarfile • zipfile

calendar SourceModule

imports: argparse • datetime • enum • itertools • locale • sys • warnings

imported by: PIL.PdfParser • _strptime • dateutil.parser._parser • dateutil.parser.isoparser • dateutil.relativedelta • dateutil.rrule • email._parseaddr • http.cookiejar • ssl

certifi MissingModule

imported by: matplotlib

chardet MissingModule

imported by: pygments.lexer

charset_normalizer MissingModule

imported by: numpy.f2py.crackfortran

choreographer MissingModule

imported by: plotly.io._kaleido

cmath (builtin module)

imported by: pandas • plotly

cmd SourceModule

imports: inspect • readline • string • sys

imported by: pdb

code SourceModule

imports: argparse • builtins • codeop • readline • sys • traceback

imported by: _pyrepl.console • _pyrepl.simple_interact • pdb • sqlite3.__main__

codecs SourceModule

imports: _codecs • builtins • encodings • sys

imported by: PIL.PdfParser • _pickle • encodings • encodings.ascii • encodings.base64_codec • encodings.big5 • encodings.big5hkscs • encodings.bz2_codec • encodings.charmap • encodings.cp037 • encodings.cp1006 • encodings.cp1026 • encodings.cp1125 • encodings.cp1140 • encodings.cp1250 • encodings.cp1251 • encodings.cp1252 • encodings.cp1253 • encodings.cp1254 • encodings.cp1255 • encodings.cp1256 • encodings.cp1257 • encodings.cp1258 • encodings.cp273 • encodings.cp424 • encodings.cp437 • encodings.cp500 • encodings.cp720 • encodings.cp737 • encodings.cp775 • encodings.cp850 • encodings.cp852 • encodings.cp855 • encodings.cp856 • encodings.cp857 • encodings.cp858 • encodings.cp860 • encodings.cp861 • encodings.cp862 • encodings.cp863 • encodings.cp864 • encodings.cp865 • encodings.cp866 • encodings.cp869 • encodings.cp874 • encodings.cp875 • encodings.cp932 • encodings.cp949 • encodings.cp950 • encodings.euc_jis_2004 • encodings.euc_jisx0213 • encodings.euc_jp • encodings.euc_kr • encodings.gb18030 • encodings.gb2312 • encodings.gbk • encodings.hex_codec • encodings.hp_roman8 • encodings.hz • encodings.idna • encodings.iso2022_jp • encodings.iso2022_jp_1 • encodings.iso2022_jp_2 • encodings.iso2022_jp_2004 • encodings.iso2022_jp_3 • encodings.iso2022_jp_ext • encodings.iso2022_kr • encodings.iso8859_1 • encodings.iso8859_10 • encodings.iso8859_11 • encodings.iso8859_13 • encodings.iso8859_14 • encodings.iso8859_15 • encodings.iso8859_16 • encodings.iso8859_2 • encodings.iso8859_3 • encodings.iso8859_4 • encodings.iso8859_5 • encodings.iso8859_6 • encodings.iso8859_7 • encodings.iso8859_8 • encodings.iso8859_9 • encodings.johab • encodings.koi8_r • encodings.koi8_t • encodings.koi8_u • encodings.kz1048 • encodings.latin_1 • encodings.mac_arabic • encodings.mac_croatian • encodings.mac_cyrillic • encodings.mac_farsi • encodings.mac_greek • encodings.mac_iceland • encodings.mac_latin2 • encodings.mac_roman • encodings.mac_romanian • encodings.mac_turkish • encodings.mbcs • encodings.oem • encodings.palmos • encodings.ptcp154 • encodings.punycode • encodings.quopri_codec • encodings.raw_unicode_escape • encodings.rot_13 • encodings.shift_jis • encodings.shift_jis_2004 • encodings.shift_jisx0213 • encodings.tis_620 • encodings.undefined • encodings.unicode_escape • encodings.utf_16 • encodings.utf_16_be • encodings.utf_16_le • encodings.utf_32 • encodings.utf_32_be • encodings.utf_32_le • encodings.utf_7 • encodings.utf_8 • encodings.utf_8_sig • encodings.uu_codec • encodings.zlib_codec • json • numpy.f2py.crackfortran • pandas.core.strings.accessor • pandas.io.common • pandas.io.formats.xml • pandas.util._print_versions • pickle • pickletools • plistlib • pygments.formatter • time_tracker_working.py • tokenize • xml.sax.saxutils

codeop SourceModule

imports: __future__ • warnings

imported by: code • pdb

collections Package

imports: _collections • _collections_abc • _weakref • collections.Mapping • copy • heapq • itertools • keyword • operator • reprlib • sys

imported by: PIL.PdfParser • PIL.features • _plotly_utils.png • _pydecimal • _pyrepl.base_eventqueue • _pyrepl.input • _pyrepl.windows_console • _pytest._io.pprint • _pytest.assertion.rewrite • _pytest.capture • _pytest.fixtures • _pytest.mark • _pytest.python • _pytest.terminal • _pytest.threadexception • _pytest.unraisableexception • ast • asyncio.base_events • asyncio.base_subprocess • asyncio.locks • asyncio.proactor_events • asyncio.queues • asyncio.selector_events • asyncio.sslproto • asyncio.streams • concurrent.futures._base • configparser • contextlib • dateutil.tz._factories • dateutil.tz.tz • difflib • dis • doctest • email.feedparser • functools • importlib.metadata • importlib.metadata._collections • importlib.resources.readers • inspect • matplotlib • matplotlib._afm • matplotlib._pylab_helpers • matplotlib.artist • matplotlib.backend_bases • matplotlib.category • matplotlib.cbook • matplotlib.dviread • matplotlib.patches • matplotlib.textpath • mpl_toolkits.mplot3d.axes3d • multiprocessing.heap • multiprocessing.pool • multiprocessing.queues • narwhals._arrow.group_by • narwhals._pandas_like.group_by • narwhals._pandas_like.utils • narwhals._utils • narwhals.dtypes • narwhals.schema • numpy._core.overrides • numpy._core.records • packaging._manylinux • pandas.core.apply • pandas.core.arrays.sparse.array • pandas.core.common • pandas.core.computation.scope • pandas.core.dtypes.inference • pandas.core.frame • pandas.core.generic • pandas.core.groupby.generic • pandas.core.groupby.ops • pandas.core.indexes.base • pandas.core.interchange.dataframe • pandas.core.internals.construction • pandas.core.reshape.concat • pandas.core.reshape.encoding • pandas.core.sorting • pandas.core.tools.datetimes • pandas.core.window.common • pandas.io.common • pandas.io.excel._odswriter • pandas.io.formats.style_render • pandas.io.html • pandas.io.json._json • pandas.io.json._normalize • pandas.io.parsers.base_parser • pandas.io.parsers.c_parser_wrapper • pandas.io.parsers.python_parser • pandas.io.parsers.readers • pandas.io.sas.sas7bdat • pandas.io.sas.sas_xport • pandas.io.stata • pandas.util.version • pkg_resources • pkgutil • platform • plotly._subplots • plotly.basedatatypes • plotly.express._core • plotly.figure_factory._dendrogram • pprint • pydoc • pygments.formatters.rtf • pygments.lexers.sql • pyparsing.core • pyparsing.results • pytz.lazy • queue • selectors • setuptools._vendor.importlib_metadata • setuptools._vendor.importlib_metadata._collections • setuptools._vendor.more_itertools.more • setuptools._vendor.more_itertools.recipes • setuptools._vendor.packaging._manylinux • setuptools._vendor.typing_extensions • setuptools._vendor.wheel.cli.convert • setuptools._vendor.wheel.vendored.packaging._manylinux • setuptools.command._requirestxt • setuptools.config.setupcfg • shlex • shutil • ssl • statistics • string • threading • time_tracker_working.py • tkinter • tokenize • typing • unittest._log • unittest.case • unittest.util • urllib.parse • xml.etree.ElementTree

collections.Mapping MissingModule

imported by: collections • pytz.lazy

colorama Package

imports: colorama • colorama.ansi • colorama.ansitowin32 • colorama.initialise • colorama.win32

imported by: _pytest._io.terminalwriter • _pytest.capture • colorama • colorama.ansi • colorama.ansitowin32 • colorama.initialise • colorama.win32 • colorama.winterm

colorama.ansi SourceModule

imports: colorama

imported by: colorama • colorama.ansitowin32

colorama.ansitowin32 SourceModule

imports: colorama • colorama.ansi • colorama.win32 • colorama.winterm • os • re • sys

imported by: colorama • colorama.initialise

colorama.initialise SourceModule

imports: atexit • colorama • colorama.ansitowin32 • contextlib • sys

imported by: colorama

colorama.win32 SourceModule

imports: colorama • ctypes • ctypes.wintypes

imported by: colorama • colorama.ansitowin32 • colorama.winterm

colorama.winterm SourceModule

imports: colorama • colorama.win32 • msvcrt

imported by: colorama.ansitowin32

colorsys SourceModule

imported by: PIL.ImageColor

concurrent Package

imported by: concurrent.futures

concurrent.futures Package

imports: concurrent • concurrent.futures._base • concurrent.futures.process • concurrent.futures.thread

imported by: asyncio.base_events • asyncio.futures • asyncio.tasks • concurrent.futures._base • concurrent.futures.process • concurrent.futures.thread • numpy.testing._private.utils • setuptools._distutils.command.build_ext

concurrent.futures._base SourceModule

imports: collections • concurrent.futures • logging • threading • time • types

imported by: concurrent.futures • concurrent.futures.process • concurrent.futures.thread

concurrent.futures.process SourceModule

imports: concurrent.futures • concurrent.futures._base • functools • itertools • multiprocessing • multiprocessing.connection • multiprocessing.queues • multiprocessing.synchronize • os • queue • sys • threading • traceback • weakref

imported by: concurrent.futures

concurrent.futures.thread SourceModule

imports: concurrent.futures • concurrent.futures._base • itertools • os • queue • threading • types • weakref

imported by: concurrent.futures

configparser SourceModule

imports: 'collections.abc' • collections • contextlib • functools • io • itertools • os • re • sys • types

imported by: setuptools._distutils.dist • setuptools._vendor.platformdirs.unix • setuptools.command.setopt • setuptools.config.expand • setuptools.dist • setuptools.unicode_utils

contextlib SourceModule

imports: _collections_abc • abc • collections • functools • os • sys • types

imported by: _aix_support • _pyrepl.historical_reader • _pyrepl.reader • _pytest._py.path • _pytest.capture • _pytest.config • _pytest.doctest • _pytest.logging • _pytest.monkeypatch • _pytest.pathlib • _pytest.pytester • _pytest.warnings • _threading_local • ast • asyncio.staggered • bdb • colorama.initialise • configparser • dateutil.tz.tz • getpass • glob • http.server • importlib.metadata • importlib.resources._adapters • importlib.resources._common • importlib.resources.readers • matplotlib • matplotlib._api.deprecation • matplotlib.artist • matplotlib.axes._base • matplotlib.backend_bases • matplotlib.backends._backend_tk • matplotlib.backends.backend_agg • matplotlib.backends.backend_webagg • matplotlib.cbook • matplotlib.contour • matplotlib.figure • matplotlib.layout_engine • matplotlib.pyplot • matplotlib.style.core • matplotlib.widgets • mpl_toolkits.mplot3d.art3d • narwhals._duckdb.dataframe • narwhals._duckdb.expr • narwhals._pandas_like.utils • narwhals.translate • numpy._core._methods • numpy._core.arrayprint • numpy._core.memmap • numpy._core.records • numpy.lib._histograms_impl • numpy.lib._npyio_impl • numpy.testing._private.utils • packaging._manylinux • packaging._tokenizer • pandas._config.config • pandas._config.localization • pandas._testing._warnings • pandas._testing.contexts • pandas.compat.pickle_compat • pandas.core._numba.extensions • pandas.core.common • pandas.core.indexing • pandas.io.clipboard • pandas.io.formats.format • pandas.io.formats.style • pandas.io.pytables • pandas.io.sql • pandas.plotting._matplotlib.converter • pandas.plotting._misc • pandas.util._exceptions • pdb • plotly.basedatatypes • plotly.io._orca • pyparsing.testing • pyparsing.util • setuptools._distutils.command.build_ext • setuptools._distutils.command.check • setuptools._distutils.compilers.C.msvc • setuptools._distutils.dist • setuptools._distutils.version • setuptools._path • setuptools._vendor.importlib_metadata • setuptools._vendor.jaraco.context • setuptools._vendor.packaging._manylinux • setuptools._vendor.packaging._tokenizer • setuptools._vendor.typing_extensions • setuptools._vendor.wheel.vendored.packaging._manylinux • setuptools._vendor.wheel.vendored.packaging._tokenizer • setuptools._vendor.zipp • setuptools.archive_util • setuptools.command.sdist • setuptools.config._validate_pyproject.error_reporting • setuptools.config.pyprojecttoml • setuptools.config.setupcfg • setuptools.depends • setuptools.msvc • setuptools.wheel • subprocess • traceback • typing • unittest.case • unittest.mock • urllib.request • xml.etree.ElementTree • zipfile._path

contextvars SourceModule

imports: _contextvars

imported by: _pydecimal • asyncio.events • asyncio.futures • asyncio.runners • asyncio.tasks • asyncio.threads • numpy._core.printoptions • unittest.async_case

contourpy Package

imports: __future__ • contourpy._contourpy • contourpy._version • contourpy.chunk • contourpy.convert • contourpy.dechunk • contourpy.enum_util • numpy • numpy.typing • typing

imported by: contourpy._contourpy • contourpy._version • contourpy.array • contourpy.chunk • contourpy.convert • contourpy.dechunk • contourpy.enum_util • contourpy.typecheck • contourpy.types • matplotlib.contour

contourpy._contourpy C:\HTL\HTL 5\Diplomarbeit\Zeiterfassung\TimeTracker\.venv\Lib\site-packages\contourpy\_contourpy.cp313-win_amd64.pyd

imports: contourpy • contourpy._contourpy • numpy • numpy.typing • typing

imported by: contourpy • contourpy._contourpy • contourpy.array • contourpy.convert • contourpy.dechunk • contourpy.enum_util • contourpy.typecheck

contourpy._version SourceModule

imports: contourpy

imported by: contourpy

contourpy.array SourceModule

imports: __future__ • contourpy • contourpy._contourpy • contourpy.typecheck • contourpy.types • itertools • numpy • typing

imported by: contourpy.convert • contourpy.dechunk

contourpy.chunk SourceModule

imports: __future__ • contourpy • math

imported by: contourpy

contourpy.convert SourceModule

imports: __future__ • contourpy • contourpy._contourpy • contourpy.array • contourpy.enum_util • contourpy.typecheck • contourpy.types • itertools • numpy • typing

imported by: contourpy

contourpy.dechunk SourceModule

imports: __future__ • contourpy • contourpy._contourpy • contourpy.array • contourpy.enum_util • contourpy.typecheck • typing

imported by: contourpy

contourpy.enum_util SourceModule

imports: __future__ • contourpy • contourpy._contourpy

imported by: contourpy • contourpy.convert • contourpy.dechunk • contourpy.typecheck

contourpy.typecheck SourceModule

imports: __future__ • contourpy • contourpy._contourpy • contourpy.enum_util • contourpy.types • numpy • typing

imported by: contourpy.array • contourpy.convert • contourpy.dechunk

contourpy.types SourceModule

imports: __future__ • contourpy • numpy

imported by: contourpy.array • contourpy.convert • contourpy.typecheck

copy SourceModule

imports: copyreg • types • weakref

imported by: PIL.GifImagePlugin • _plotly_utils.basevalidators • _pytest.config • _sre • argparse • collections • cycler • dataclasses • email.generator • gettext • http.cookiejar • http.server • matplotlib._mathtext • matplotlib.font_manager • matplotlib.gridspec • matplotlib.lines • matplotlib.mar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

copyreg SourceModule

imports: functools • operator

imported by: _pickle • copy • multiprocessing.reduction • numpy._core • pickle • re • time_tracker_working.py • typing

csv SourceModule

imports: _csv • io • re • types

imported by: importlib.metadata • pandas._testing.contexts • pandas.core.arrays.categorical • pandas.io.formats.csvs • pandas.io.formats.format • pandas.io.parsers.base_parser • pandas.io.parsers.python_parser • pandas.io.parsers.readers • setuptools._vendor.importlib_metadata • setuptools._vendor.wheel.wheelfile • time_tracker_working.py

ctags MissingModule

imported by: pygments.formatters.html

ctypes Package

imports: _ctypes • ctypes._endian • ctypes.util • nt • os • struct • sys • types • warnings

imported by: _ios_support • _pyi_rth_utils._win32 • _pyrepl._minimal_curses • _pyrepl.windows_console • colorama.win32 • ctypes._aix • ctypes._endian • ctypes.macholib • ctypes.util • ctypes.wintypes • dateutil.tz.win • multiprocessing.sharedctypes • numpy._core._dtype_ctypes • numpy._core._internal • numpy.ctypeslib._ctypeslib • packaging._manylinux • pandas.core.interchange.from_dataframe • pandas.errors • pandas.io.clipboard • platform • setuptools._vendor.packaging._manylinux • setuptools._vendor.platformdirs.windows • setuptools._vendor.wheel.macosx_libfile • setuptools._vendor.wheel.vendored.packaging._manylinux • setuptools.windows_support • webbrowser

ctypes._aix SourceModule

imports: ctypes • os • re • subprocess • sys

imported by: ctypes.util

ctypes._endian SourceModule

imports: ctypes • sys

imported by: ctypes

ctypes.macholib Package

imports: ctypes

imported by: ctypes.macholib.dyld • ctypes.macholib.dylib • ctypes.macholib.framework

ctypes.macholib.dyld SourceModule

imports: _ctypes • ctypes.macholib • ctypes.macholib.dylib • ctypes.macholib.framework • itertools • os

imported by: ctypes.util

ctypes.macholib.dylib SourceModule

imports: ctypes.macholib • re

imported by: ctypes.macholib.dyld

ctypes.macholib.framework SourceModule

imports: ctypes.macholib • re

imported by: ctypes.macholib.dyld

ctypes.util SourceModule

imports: ctypes • ctypes._aix • ctypes.macholib.dyld • importlib.machinery • os • re • shutil • struct • subprocess • sys • tempfile

imported by: _ios_support • _pyrepl._minimal_curses • ctypes

ctypes.wintypes SourceModule

imports: ctypes

imported by: _pyi_rth_utils._win32 • _pyrepl.windows_console • colorama.win32 • dateutil.tz.win • pandas.io.clipboard • setuptools.windows_support

cudf MissingModule

imported by: narwhals.dependencies • narwhals.stable.v1.dependencies

cupy MissingModule

imported by: narwhals._pandas_like.dataframe • narwhals._pandas_like.series

curses Package

imports: _curses • curses • curses.has_key • os • sys

imported by: _curses • _pyrepl.curses • curses • curses.has_key

curses.has_key SourceModule

imports: _curses • curses

imported by: curses

cycler Package

imports: 'collections.abc' • __future__ • copy • functools • itertools • operator • typing

imported by: matplotlib.pyplot • matplotlib.rcsetup • matplotlib.widgets

dask MissingModule

imported by: narwhals._arrow.dataframe • narwhals._pandas_like.dataframe • narwhals._polars.dataframe • narwhals._utils • narwhals.dependencies

dask_expr MissingModule

imported by: narwhals._dask.group_by • narwhals._dask.utils

dataclasses SourceModule

imports: abc • copy • inspect • itertools • keyword • re • reprlib • sys • types

imported by: _pyrepl._threading_handler • _pyrepl.completing_reader • _pyrepl.console • _pyrepl.historical_reader • _pyrepl.reader • _pyrepl.readline • _pytest._code.code • _pytest._io.pprint • _pytest.assertion.util • _pytest.cacheprovider • _pytest.config • _pytest.fixtures • _pytest.legacypath • _pytest.main • _pytest.mark • _pytest.mark.expression • _pytest.mark.structures • _pytest.python • _pytest.reports • _pytest.runner • _pytest.skipping • _pytest.stepwise • _pytest.terminal • _pytest.timing • _pytest.tmpdir • _pytest.warning_types • matplotlib._text_helpers • matplotlib.font_manager • packaging._tokenizer • pandas.core.dtypes.inference • pandas.core.groupby.base • pandas.core.internals.construction • pandas.io.common • pprint • pyparsing.diagram • setuptools._vendor.packaging._tokenizer • setuptools._vendor.wheel.vendored.packaging._tokenizer

datetime SourceModule

imports: _datetime • _pydatetime • time

imported by: PIL._imagingcms • _pytest.logging • _pytest.stepwise • _pytest.terminal • _pytest.timing • _strptime • calendar • dateutil.easter • dateutil.parser._parser • dateutil.parser.isoparser • dateutil.relativedelta • dateutil.rrule • dateutil.tz._common • dateutil.tz._factories • dateutil.tz.tz • dateutil.tz.win • email.utils • http.cookiejar • http.server • matplotlib.axis • matplotlib.backends.backend_webagg_core • matplotlib.dates • matplotlib.pylab • matplotlib.pyplot • narwhals._compliant.selectors • narwhals._polars.namespace • narwhals._utils • narwhals.dtypes • narwhals.selectors • narwhals.stable.v1._dtypes • narwhals.translate • narwhals.typing • pandas._libs.tslib • pandas._libs.tslibs.conversion • pandas._libs.tslibs.nattype • pandas._libs.tslibs.offsets • pandas._libs.tslibs.parsing • pandas._libs.tslibs.period • pandas._libs.tslibs.timedeltas • pandas._libs.tslibs.timestamps • pandas._libs.tslibs.timezones • pandas._libs.tslibs.tzconversion • pandas._libs.tslibs.vectorized • pandas._typing • pandas.core.arrays.datetimelike • pandas.core.arrays.datetimes • pandas.core.arrays.period • pandas.core.arrays.timedeltas • pandas.core.computation.ops • pandas.core.computation.scope • pandas.core.dtypes.cast • pandas.core.dtypes.dtypes • pandas.core.frame • pandas.core.generic • pandas.core.groupby.groupby • pandas.core.indexers.objects • pandas.core.indexes.base • pandas.core.indexes.datetimelike • pandas.core.indexes.datetimes • pandas.core.indexes.period • pandas.core.indexes.range • pandas.core.ops.array_ops • pandas.core.reshape.merge • pandas.core.tools.datetimes • pandas.core.tools.timedeltas • pandas.core.tools.times • pandas.core.window.ewm • pandas.core.window.rolling • pandas.io.excel._base • pandas.io.excel._calamine • pandas.io.excel._odswriter • pandas.io.excel._xlrd • pandas.io.parsers.base_parser • pandas.io.pytables • pandas.io.sas.sas7bdat • pandas.io.sas.sas_xport • pandas.io.sql • pandas.io.stata • pandas.plotting._matplotlib.converter • pandas.plotting._matplotlib.timeseries • pandas.tseries.holiday • plistlib • plotly.io._json • pyparsing.common • pytz • pytz.tzfile • pytz.tzinfo • setuptools._vendor.tomli._re • setuptools.warnings • sqlite3.dbapi2 • time_tracker_working.py • tomllib._re • xmlrpc.client

dateutil Package

imports: dateutil • dateutil._version • dateutil.easter • dateutil.relativedelta • dateutil.rrule • dateutil.tz • importlib • sys

imported by: dateutil • dateutil._common • dateutil._version • dateutil.easter • dateutil.parser • dateutil.parser._parser • dateutil.parser.isoparser • dateutil.relativedelta • dateutil.rrule • dateutil.tz • dateutil.tz.tz • dateutil.zoneinfo

dateutil._common SourceModule

imports: dateutil

imported by: dateutil.relativedelta • dateutil.rrule

dateutil._version SourceModule

imports: dateutil

imported by: dateutil

dateutil.easter SourceModule

imports: datetime • dateutil

imported by: dateutil • dateutil.rrule

dateutil.parser Package

imports: dateutil • dateutil.parser._parser • dateutil.parser.isoparser • functools • warnings

imported by: dateutil.parser._parser • dateutil.parser.isoparser • dateutil.rrule • dateutil.tz.tz • matplotlib.category • matplotlib.dates • pandas.core.indexes.datetimes

dateutil.parser._parser SourceModule

imports: __future__ • calendar • datetime • dateutil • dateutil.parser • dateutil.relativedelta • dateutil.tz • decimal • io • re • six • string • time • warnings

imported by: dateutil.parser • dateutil.tz.tz

dateutil.parser.isoparser SourceModule

imports: calendar • datetime • dateutil • dateutil.parser • dateutil.tz • functools • re • six

imported by: dateutil.parser

dateutil.relativedelta SourceModule

imports: calendar • datetime • dateutil • dateutil._common • math • operator • six • warnings

imported by: dateutil • dateutil.parser._parser • dateutil.tz.tz • matplotlib.dates • pandas.tseries.holiday

dateutil.rrule SourceModule

imports: calendar • datetime • dateutil • dateutil._common • dateutil.easter • dateutil.parser • dateutil.tz • fractions • functools • heapq • itertools • math • re • six • six.moves • six.moves._thread • six.moves.range • sys • warnings

imported by: dateutil • dateutil.tz.tz • matplotlib.dates

dateutil.tz Package

imports: dateutil • dateutil.tz.tz • dateutil.tz.tzfile

imported by: dateutil • dateutil.parser._parser • dateutil.parser.isoparser • dateutil.rrule • dateutil.tz._common • dateutil.tz._factories • dateutil.tz.tz • dateutil.tz.win • dateutil.zoneinfo • matplotlib.axis • matplotlib.dates

dateutil.tz._common SourceModule

imports: datetime • dateutil.tz • functools • six

imported by: dateutil.tz.tz • dateutil.tz.win

dateutil.tz._factories SourceModule

imports: collections • datetime • dateutil.tz • six.moves • six.moves._thread • weakref

imported by: dateutil.tz.tz

dateutil.tz.tz SourceModule

imports: bisect • collections • contextlib • datetime • dateutil • dateutil.parser • dateutil.parser._parser • dateutil.relativedelta • dateutil.rrule • dateutil.tz • dateutil.tz._common • dateutil.tz._factories • dateutil.tz.win • dateutil.zoneinfo • os • six • six.moves • six.moves._thread • struct • sys • time • warnings • weakref

imported by: dateutil.tz

dateutil.tz.tzfile MissingModule

imported by: dateutil.tz • dateutil.zoneinfo

dateutil.tz.win SourceModule

imports: ctypes • ctypes.wintypes • datetime • dateutil.tz • dateutil.tz._common • six • six.moves • six.moves.winreg • struct

imported by: dateutil.tz.tz

dateutil.zoneinfo Package

imports: dateutil • dateutil.tz • dateutil.tz.tzfile • io • json • pkgutil • tarfile • warnings

imported by: dateutil.tz.tz

decimal SourceModule

imports: _decimal • _pydecimal • sys

imported by: _plotly_utils.colors • _plotly_utils.utils • _pytest.python_api • dateutil.parser._parser • fractions • matplotlib.units • narwhals.translate • narwhals.typing • pandas._libs.lib • pandas._testing • pandas.core.algorithms • pandas.core.computation.pytables • pandas.core.dtypes.dtypes • pandas.core.dtypes.missing • pandas.io.formats.format • plotly.io._json • setuptools.config._validate_pyproject.fastjsonschema_validations • statistics • xmlrpc.client

defusedxml MissingModule

imported by: PIL.Image

difflib SourceModule

imports: collections • difflib • heapq • re • types

imported by: _pytest.assertion.util • difflib • doctest • numpy.testing._private.utils • unittest.case

dis SourceModule

imports: _opcode • argparse • collections • io • opcode • sys • types

imported by: inspect • pdb • setuptools.depends

distutils AliasNode

imports: setuptools._distutils • setuptools._distutils.sysconfig

imported by: setuptools._distutils._log • setuptools._distutils._modified • setuptools._distutils.cmd • setuptools._distutils.command • setuptools._distutils.command.build_ext • setuptools._distutils.command.sdist • setuptools._distutils.core • setuptools._distutils.debug • setuptools._distutils.dir_util • setuptools._distutils.dist • setuptools._distutils.errors • setuptools._distutils.extension • setuptools._distutils.fancy_getopt • setuptools._distutils.filelist • setuptools._distutils.log • setuptools._distutils.spawn • setuptools._distutils.sysconfig • setuptools._distutils.text_file • setuptools._distutils.util • setuptools._distutils.versionpredicate • setuptools._shutil • setuptools.command.bdist_egg • setuptools.command.bdist_wheel • setuptools.command.egg_info • setuptools.command.sdist • setuptools.command.setopt • setuptools.discovery • setuptools.errors • setuptools.installer • setuptools.wheel

doctest SourceModule

imports: __future__ • _colorize • argparse • builtins • collections • difflib • inspect • io • linecache • os • pdb • re • sys • traceback • unittest

imported by: _pytest.debugging • _pytest.doctest • numpy.testing._private.utils • pickletools • pytz

duckdb MissingModule

imported by: narwhals._arrow.dataframe • narwhals._duckdb.dataframe • narwhals._duckdb.expr • narwhals._duckdb.expr_dt • narwhals._duckdb.expr_list • narwhals._duckdb.expr_str • narwhals._duckdb.expr_struct • narwhals._duckdb.group_by • narwhals._duckdb.namespace • narwhals._duckdb.selectors • narwhals._duckdb.series • narwhals._duckdb.utils • narwhals._namespace • narwhals._pandas_like.dataframe • narwhals._polars.dataframe • narwhals.dependencies

email Package

imports: email._header_value_parser • email.charset • email.errors • email.header • email.parser

imported by: email._encoded_words • email._header_value_parser • email._parseaddr • email._policybase • email.base64mime • email.charset • email.contentmanager • email.encoders • email.errors • email.feedparser • email.generator • email.header • email.headerregistry • email.iterators • email.message • email.parser • email.policy • email.quoprimime • email.utils • importlib.metadata • setuptools._core_metadata • setuptools._distutils.dist • setuptools._vendor.importlib_metadata • setuptools.wheel • urllib.request

email._encoded_words SourceModule

imports: base64 • binascii • email • email.errors • functools • re • string

imported by: email._header_value_parser • email.message

email._header_value_parser SourceModule

imports: email • email._encoded_words • email.errors • email.utils • operator • re • string • sys • urllib

imported by: email • email.headerregistry

email._parseaddr SourceModule

imports: calendar • email • time

imported by: email.utils

email._policybase SourceModule

imports: abc • email • email.charset • email.header • email.utils

imported by: email.feedparser • email.message • email.parser • email.policy

email.base64mime SourceModule

imports: base64 • binascii • email

imported by: email.charset • email.header

email.charset SourceModule

imports: email • email.base64mime • email.encoders • email.errors • email.quoprimime • functools

imported by: email • email._policybase • email.contentmanager • email.header • email.message • email.utils

email.contentmanager SourceModule

imports: binascii • email • email.charset • email.errors • email.message • email.quoprimime

imported by: email.policy

email.encoders SourceModule

imports: base64 • email • quopri

imported by: email.charset

email.errors SourceModule

imports: email

imported by: email • email._encoded_words • email._header_value_parser • email.charset • email.contentmanager • email.feedparser • email.generator • email.header • email.headerregistry • email.message

email.feedparser SourceModule

imports: collections • email • email._policybase • email.errors • email.message • io • re

imported by: email.parser • packaging.metadata

email.generator SourceModule

imports: copy • email • email.errors • email.utils • io • random • re • sys • time

imported by: email.message • setuptools._vendor.wheel.cli.pack • setuptools.command.bdist_wheel

email.header SourceModule

imports: binascii • email • email.base64mime • email.charset • email.errors • email.quoprimime • re

imported by: email • email._policybase • packaging.metadata

email.headerregistry SourceModule

imports: email • email._header_value_parser • email.errors • email.utils • types

imported by: email.policy • setuptools.config._apply_pyprojecttoml

email.iterators SourceModule

imports: email • io • sys

imported by: email.message

email.message SourceModule

imports: binascii • email • email._encoded_words • email._policybase • email.charset • email.errors • email.generator • email.iterators • email.policy • email.utils • io • quopri • re

imported by: email.contentmanager • email.feedparser • email.policy • http.client • importlib.metadata._adapters • packaging.metadata • pydoc • setuptools._core_metadata • setuptools._vendor.importlib_metadata._adapters • setuptools._vendor.wheel.cli.convert • setuptools._vendor.wheel.metadata • setuptools.command.bdist_wheel • setuptools.config._validate_pyproject.formats

email.parser SourceModule

imports: email • email._policybase • email.feedparser • io

imported by: email • http.client • packaging.metadata • pkg_resources • setuptools._vendor.wheel.cli.convert • setuptools._vendor.wheel.cli.pack • setuptools._vendor.wheel.cli.tags • setuptools._vendor.wheel.metadata

email.policy SourceModule

imports: email • email._policybase • email.contentmanager • email.headerregistry • email.message • email.utils • re • sys

imported by: email.message • packaging.metadata • setuptools._vendor.wheel.cli.convert • setuptools._vendor.wheel.cli.pack • setuptools._vendor.wheel.cli.tags

email.quoprimime SourceModule

imports: email • re • string

imported by: email.charset • email.contentmanager • email.header

email.utils SourceModule

imports: datetime • email • email._parseaddr • email.charset • os • random • re • socket • time • urllib.parse • warnings

imported by: email._header_value_parser • email._policybase • email.generator • email.headerregistry • email.message • email.policy • http.server • urllib.request

encodings Package

imports: _winapi • codecs • encodings • encodings.aliases • encodings.ascii • encodings.base64_codec • encodings.big5 • encodings.big5hkscs • encodings.bz2_codec • encodings.charmap • encodings.cp037 • encodings.cp1006 • encodings.cp1026 • encodings.cp1125 • encodings.cp1140 • encodings.cp1250 • encodings.cp1251 • encodings.cp1252 • encodings.cp1253 • encodings.cp1254 • encodings.cp1255 • encodings.cp1256 • encodings.cp1257 • encodings.cp1258 • encodings.cp273 • encodings.cp424 • encodings.cp437 • encodings.cp500 • encodings.cp720 • encodings.cp737 • encodings.cp775 • encodings.cp850 • encodings.cp852 • encodings.cp855 • encodings.cp856 • encodings.cp857 • encodings.cp858 • encodings.cp860 • encodings.cp861 • encodings.cp862 • encodings.cp863 • encodings.cp864 • encodings.cp865 • encodings.cp866 • encodings.cp869 • encodings.cp874 • encodings.cp875 • encodings.cp932 • encodings.cp949 • encodings.cp950 • encodings.euc_jis_2004 • encodings.euc_jisx0213 • encodings.euc_jp • encodings.euc_kr • encodings.gb18030 • encodings.gb2312 • encodings.gbk • encodings.hex_codec • encodings.hp_roman8 • encodings.hz • encodings.idna • encodings.iso2022_jp • encodings.iso2022_jp_1 • encodings.iso2022_jp_2 • encodings.iso2022_jp_2004 • encodings.iso2022_jp_3 • encodings.iso2022_jp_ext • encodings.iso2022_kr • encodings.iso8859_1 • encodings.iso8859_10 • encodings.iso8859_11 • encodings.iso8859_13 • encodings.iso8859_14 • encodings.iso8859_15 • encodings.iso8859_16 • encodings.iso8859_2 • encodings.iso8859_3 • encodings.iso8859_4 • encodings.iso8859_5 • encodings.iso8859_6 • encodings.iso8859_7 • encodings.iso8859_8 • encodings.iso8859_9 • encodings.johab • encodings.koi8_r • encodings.koi8_t • encodings.koi8_u • encodings.kz1048 • encodings.latin_1 • encodings.mac_arabic • encodings.mac_croatian • encodings.mac_cyrillic • encodings.mac_farsi • encodings.mac_greek • encodings.mac_iceland • encodings.mac_latin2 • encodings.mac_roman • encodings.mac_romanian • encodings.mac_turkish • encodings.mbcs • encodings.oem • encodings.palmos • encodings.ptcp154 • encodings.punycode • encodings.quopri_codec • encodings.raw_unicode_escape • encodings.rot_13 • encodings.shift_jis • encodings.shift_jis_2004 • encodings.shift_jisx0213 • encodings.tis_620 • encodings.undefined • encodings.unicode_escape • encodings.utf_16 • encodings.utf_16_be • encodings.utf_16_le • encodings.utf_32 • encodings.utf_32_be • encodings.utf_32_le • encodings.utf_7 • encodings.utf_8 • encodings.utf_8_sig • encodings.uu_codec • encodings.zlib_codec • sys

imported by: codecs • encodings • encodings.aliases • encodings.ascii • encodings.base64_codec • encodings.big5 • encodings.big5hkscs • encodings.bz2_codec • encodings.charmap • encodings.cp037 • encodings.cp1006 • encodings.cp1026 • encodings.cp1125 • encodings.cp1140 • encodings.cp1250 • encodings.cp1251 • encodings.cp1252 • encodings.cp1253 • encodings.cp1254 • encodings.cp1255 • encodings.cp1256 • encodings.cp1257 • encodings.cp1258 • encodings.cp273 • encodings.cp424 • encodings.cp437 • encodings.cp500 • encodings.cp720 • encodings.cp737 • encodings.cp775 • encodings.cp850 • encodings.cp852 • encodings.cp855 • encodings.cp856 • encodings.cp857 • encodings.cp858 • encodings.cp860 • encodings.cp861 • encodings.cp862 • encodings.cp863 • encodings.cp864 • encodings.cp865 • encodings.cp866 • encodings.cp869 • encodings.cp874 • encodings.cp875 • encodings.cp932 • encodings.cp949 • encodings.cp950 • encodings.euc_jis_2004 • encodings.euc_jisx0213 • encodings.euc_jp • encodings.euc_kr • encodings.gb18030 • encodings.gb2312 • encodings.gbk • encodings.hex_codec • encodings.hp_roman8 • encodings.hz • encodings.idna • encodings.iso2022_jp • encodings.iso2022_jp_1 • encodings.iso2022_jp_2 • encodings.iso2022_jp_2004 • encodings.iso2022_jp_3 • encodings.iso2022_jp_ext • encodings.iso2022_kr • encodings.iso8859_1 • encodings.iso8859_10 • encodings.iso8859_11 • encodings.iso8859_13 • encodings.iso8859_14 • encodings.iso8859_15 • encodings.iso8859_16 • encodings.iso8859_2 • encodings.iso8859_3 • encodings.iso8859_4 • encodings.iso8859_5 • encodings.iso8859_6 • encodings.iso8859_7 • encodings.iso8859_8 • encodings.iso8859_9 • encodings.johab • encodings.koi8_r • encodings.koi8_t • encodings.koi8_u • encodings.kz1048 • encodings.latin_1 • encodings.mac_arabic • encodings.mac_croatian • encodings.mac_cyrillic • encodings.mac_farsi • encodings.mac_greek • encodings.mac_iceland • encodings.mac_latin2 • encodings.mac_roman • encodings.mac_romanian • encodings.mac_turkish • encodings.mbcs • encodings.oem • encodings.palmos • encodings.ptcp154 • encodings.punycode • encodings.quopri_codec • encodings.raw_unicode_escape • encodings.rot_13 • encodings.shift_jis • encodings.shift_jis_2004 • encodings.shift_jisx0213 • encodings.tis_620 • encodings.undefined • encodings.unicode_escape • encodings.utf_16 • encodings.utf_16_be • encodings.utf_16_le • encodings.utf_32 • encodings.utf_32_be • encodings.utf_32_le • encodings.utf_7 • encodings.utf_8 • encodings.utf_8_sig • encodings.uu_codec • encodings.zlib_codec • locale • time_tracker_working.py

encodings.aliases SourceModule

imports: encodings

imported by: encodings • locale • time_tracker_working.py

encodings.ascii SourceModule

imports: codecs • encodings

imported by: encodings • time_tracker_working.py

encodings.base64_codec SourceModule

imports: base64 • codecs • encodings

imported by: encodings • time_tracker_working.py

encodings.big5 SourceModule

imports: _codecs_tw • _multibytecodec • codecs • encodings

imported by: encodings • time_tracker_working.py

encodings.big5hkscs SourceModule

imports: _codecs_hk • _multibytecodec • codecs • encodings

imported by: encodings • time_tracker_working.py

encodings.bz2_codec SourceModule

imports: bz2 • codecs • encodings

imported by: encodings • time_tracker_working.py

encodings.charmap SourceModule

imports: codecs • encodings

imported by: encodings • time_tracker_working.py

encodings.cp037 SourceModule

imports: codecs • encodings

imported by: encodings • time_tracker_working.py

encodings.cp1006 SourceModule

imports: codecs • encodings

imported by: encodings • time_tracker_working.py

encodings.cp1026 SourceModule

imports: codecs • encodings

imported by: encodings • time_tracker_working.py

encodings.cp1125 SourceModule

imports: codecs • encodings

imported by: encodings • time_tracker_working.py

encodings.cp1140 SourceModule

imports: codecs • encodings

imported by: encodings • time_tracker_working.py

encodings.cp1250 SourceModule

imports: codecs • encodings

imported by: encodings • time_tracker_working.py

encodings.cp1251 SourceModule

imports: codecs • encodings

imported by: encodings • time_tracker_working.py

encodings.cp1252 SourceModule

imports: codecs • encodings

imported by: encodings • time_tracker_working.py

encodings.cp1253 SourceModule

imports: codecs • encodings

imported by: encodings • time_tracker_working.py

encodings.cp1254 SourceModule

imports: codecs • encodings

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

imported by: encodings • time_tracker_working.py

encodings.raw_unicode_escape SourceModule

imports: codecs • encodings

imported by: encodings • time_tracker_working.py

encodings.rot_13 SourceModule

imports: codecs • encodings • sys

imported by: encodings • time_tracker_working.py

encodings.shift_jis SourceModule

imports: _codecs_jp • _multibytecodec • codecs • encodings

imported by: encodings • time_tracker_working.py

encodings.shift_jis_2004 SourceModule

imports: _codecs_jp • _multibytecodec • codecs • encodings

imported by: encodings • time_tracker_working.py

encodings.shift_jisx0213 SourceModule

imports: _codecs_jp • _multibytecodec • codecs • encodings

imported by: encodings • time_tracker_working.py

encodings.tis_620 SourceModule

imports: codecs • encodings

imported by: encodings • time_tracker_working.py

encodings.undefined SourceModule

imports: codecs • encodings

imported by: encodings • time_tracker_working.py

encodings.unicode_escape SourceModule

imports: codecs • encodings

imported by: encodings • time_tracker_working.py

encodings.utf_16 SourceModule

imports: codecs • encodings • sys

imported by: encodings • time_tracker_working.py

encodings.utf_16_be SourceModule

imports: codecs • encodings

imported by: encodings • time_tracker_working.py

encodings.utf_16_le SourceModule

imports: codecs • encodings

imported by: encodings • time_tracker_working.py

encodings.utf_32 SourceModule

imports: codecs • encodings • sys

imported by: encodings • time_tracker_working.py

encodings.utf_32_be SourceModule

imports: codecs • encodings

imported by: encodings • time_tracker_working.py

encodings.utf_32_le SourceModule

imports: codecs • encodings

imported by: encodings • time_tracker_working.py

encodings.utf_7 SourceModule

imports: codecs • encodings

imported by: encodings • time_tracker_working.py

encodings.utf_8 SourceModule

imports: codecs • encodings

imported by: encodings • time_tracker_working.py

encodings.utf_8_sig SourceModule

imports: codecs • encodings

imported by: encodings • time_tracker_working.py

encodings.uu_codec SourceModule

imports: binascii • codecs • encodings • io

imported by: encodings • time_tracker_working.py

encodings.zlib_codec SourceModule

imports: codecs • encodings • zlib

imported by: encodings • time_tracker_working.py

enum SourceModule

imports: builtins • functools • sys • types • warnings

imported by: PIL.BlpImagePlugin • PIL.DdsImagePlugin • PIL.ExifTags • PIL.FtexImagePlugin • PIL.GifImagePlugin • PIL.Image • PIL.ImageCms • PIL.ImageFont • PIL.PngImagePlugin • _pytest.compat • _pytest.config • _pytest.mark.expression • _pytest.mark.structures • _pytest.pathlib • _pytest.python • _pytest.scope • _pytest.unittest • ast • asyncio.constants • asyncio.locks • asyncio.runners • asyncio.sslproto • asyncio.timeouts • calendar • http • inspect • matplotlib._enums • matplotlib._mathtext • matplotlib.backend_bases • matplotlib.backend_tools • matplotlib.backends.registry • matplotlib.dviread • matplotlib.ft2font • matplotlib.pyplot • narwhals._enum • narwhals._expression_parsing • narwhals._interchange.dataframe • narwhals._utils • narwhals.dtypes • numpy.__config__ • numpy._globals • numpy.f2py.symbolic • packaging._elffile • pandas._libs.lib • pandas._libs.tslibs.dtypes • pandas.core.arrays.sparse.array • pandas.core.interchange.dataframe_protocol • pandas.io.parsers.base_parser • plistlib • py_compile • pyparsing.core • re • setuptools._vendor.packaging._elffile • setuptools._vendor.wheel.vendored.packaging._elffile • signal • socket • ssl • time_tracker_working.py • tkinter • uuid

errno (builtin module)

imported by: _pyi_rth_utils.tempfile • _pyrepl.main • _pyrepl.unix_console • _pytest._py.error • _pytest.assertion.rewrite • _pytest.cacheprovider • _pytest.pathlib • asyncio.base_events • asyncio.selector_events • asyncio.unix_events • asyncio.windows_events • gettext • gzip • http.client • matplotlib.backends.backend_webagg • multiprocessing.connection • multiprocessing.forkserver • multiprocessing.queues • multiprocessing.shared_memory • numpy.f2py._backends._meson • pandas._version • pathlib._abc • pkg_resources • posixpath • setuptools._distutils.file_util • shutil • site • socket • ssl • subprocess • tempfile • xmlrpc.client

exceptiongroup MissingModule

imported by: _pytest._code.code • _pytest.fixtures • _pytest.raises • _pytest.runner • _pytest.threadexception • _pytest.unittest • _pytest.unraisableexception

faulthandler (builtin module)

imported by: _pytest.faulthandler

fcntl MissingModule

imported by: _pyrepl.unix_console • subprocess

fileinput SourceModule

imports: bz2 • getopt • gzip • io • os • sys • types • warnings

imported by: numpy.f2py.crackfortran

fnmatch SourceModule

imports: functools • os • posixpath • re

imported by: _pytest._py.path • _pytest.main • _pytest.pathlib • _pytest.pytester • _pytest.python • bdb • glob • pygments.formatters • pygments.lexers • setuptools._distutils.filelist • setuptools.discovery • setuptools.glob • shutil • tkinter.filedialog • tracemalloc • unittest.loader • urllib.request

fractions SourceModule

imports: decimal • functools • math • numbers • operator • re • sys

imported by: PIL.TiffImagePlugin • dateutil.rrule • plotly.io._templates • statistics

fsspec MissingModule

imported by: pandas.io.orc

ftplib SourceModule

imports: netrc • re • socket • ssl • sys

imported by: urllib.request

functools SourceModule

imports: _functools • _thread • abc • collections • reprlib • types • typing • warnings • weakref

imported by: PIL.GifImagePlugin • PIL.ImageCms • PIL.ImageColor • PIL.ImageFilter • PIL.ImageMode • PIL.ImageOps • PIL.PsdImagePlugin • _plotly_utils.utils • _pyrepl.simple_interact • _pyrepl.utils • _pytest._io.wcwidth • _pytest.assertion.rewrite • _pytest.compat • _pytest.config • _pytest.config.compat • _pytest.debugging • _pytest.doctest • _pytest.fixtures • _pytest.junitxml • _pytest.main • _pytest.nodes • _pytest.pathlib • _pytest.python • _pytest.scope • _pytest.terminal • _pytest.threadexception • _pytest.unraisableexception • asyncio.format_helpers • asyncio.runners • asyncio.selector_events • asyncio.tasks • asyncio.threads • asyncio.windows_events • concurrent.futures.process • configparser • contextlib • copyreg • cycler • dateutil.parser • dateutil.parser.isoparser • dateutil.rrule • dateutil.tz._common • email._encoded_words • email.charset • enum • fnmatch • fractions • glob • importlib.metadata • importlib.metadata._adapters • importlib.metadata._functools • importlib.resources._common • inspect • ipaddress • locale • matplotlib • matplotlib._api • matplotlib._api.deprecation • matplotlib._cm • matplotlib._fontconfig_pattern • matplotlib._mathtext • matplotlib.artist • matplotlib.axes._axes • matplotlib.axes._base • matplotlib.axis • matplotlib.backend_bases • matplotlib.backend_tools • matplotlib.bezier • matplotlib.cbook • matplotlib.collections • matplotlib.colorizer • matplotlib.colors • matplotlib.contour • matplotlib.dates • matplotlib.dviread • matplotlib.figure • matplotlib.font_manager • matplotlib.mathtext • matplotlib.mlab • matplotlib.offsetbox • matplotlib.patches • matplotlib.path • matplotlib.pyplot • matplotlib.rcsetup • matplotlib.spines • matplotlib.texmanager • matplotlib.text • matplotlib.transforms • multiprocessing.reduction • multiprocessing.shared_memory • narwhals._arrow.dataframe • narwhals._arrow.namespace • narwhals._arrow.utils • narwhals._compliant.expr • narwhals._compliant.namespace • narwhals._compliant.selectors • narwhals._dask.group_by • narwhals._dask.namespace • narwhals._duckdb.dataframe • narwhals._duckdb.namespace • narwhals._duckdb.utils • narwhals._ibis.expr • narwhals._ibis.namespace • narwhals._ibis.utils • narwhals._pandas_like.namespace • narwhals._pandas_like.utils • narwhals._polars.utils • narwhals._spark_like.dataframe • narwhals._spark_like.expr_str • narwhals._spark_like.namespace • narwhals._spark_like.utils • narwhals._utils • narwhals.schema • narwhals.stable.v1 • narwhals.translate • numpy._core._ufunc_config • numpy._core.arrayprint • numpy._core.defchararray • numpy._core.fromnumeric • numpy._core.function_base • numpy._core.multiarray • numpy._core.numeric • numpy._core.overrides • numpy._core.shape_base • numpy._core.strings • numpy._utils • numpy.f2py.auxfuncs • numpy.fft._pocketfft • numpy.lib._arraysetops_impl • numpy.lib._arrayterator_impl • numpy.lib._function_base_impl • numpy.lib._histograms_impl • numpy.lib._index_tricks_impl • numpy.lib._nanfunctions_impl • numpy.lib._npyio_impl • numpy.lib._polynomial_impl • numpy.lib._shape_base_impl • numpy.lib._twodim_base_impl • numpy.lib._type_check_impl • numpy.lib._utils_impl • numpy.linalg._linalg • numpy.ma.core • numpy.polynomial.polyutils • numpy.testing._private.utils • operator • packaging._manylinux • packaging._musllinux • packaging.utils • pandas._version • pandas.core._numba.executor • pandas.core.apply • pandas.core.array_algos.take • pandas.core.arrays._arrow_string_mixins • pandas.core.arrays._mixins • pandas.core.arrays.arrow.array • pandas.core.arrays.categorical • pandas.core.arrays.datetimelike • pandas.core.arrays.string_ • pandas.core.common • pandas.core.computation.align • pandas.core.computation.common • pandas.core.computation.expr • pandas.core.computation.ops • pandas.core.computation.pytables • pandas.core.dtypes.cast • pandas.core.dtypes.missing • pandas.core.frame • pandas.core.generic • pandas.core.groupby.generic • pandas.core.groupby.groupby • pandas.core.groupby.numba_ • pandas.core.groupby.ops • pandas.core.indexes.base • pandas.core.indexes.multi • pandas.core.internals.blocks • pandas.core.missing • pandas.core.nanops • pandas.core.ops.array_ops • pandas.core.ops.common • pandas.core.reshape.merge • pandas.core.strings.accessor • pandas.core.strings.object_array • pandas.core.tools.datetimes • pandas.core.window.ewm • pandas.core.window.numba_ • pandas.core.window.rolling • pandas.io.common • pandas.io.excel._base • pandas.io.formats.excel • pandas.io.formats.format • pandas.io.formats.style • pandas.io.formats.style_render • pandas.io.sql • pandas.plotting._matplotlib.converter • pandas.plotting._matplotlib.timeseries • pandas.util._decorators • pathlib._abc • pickle • pkg_resources • pkgutil • platform • plotly.basedatatypes • plotly.io._orca • plotly.io._templates • pygments.formatters.html • pyparsing.core • pyparsing.exceptions • pyparsing.util • re • setuptools • setuptools._discovery • setuptools._distutils._modified • setuptools._distutils.compat.py39 • setuptools._distutils.dir_util • setuptools._distutils.filelist • setuptools._distutils.sysconfig • setuptools._distutils.util • setuptools._entry_points • setuptools._reqs • setuptools._static • setuptools._vendor.importlib_metadata • setuptools._vendor.importlib_metadata._functools • setuptools._vendor.jaraco.context • setuptools._vendor.jaraco.functools • setuptools._vendor.jaraco.text • setuptools._vendor.more_itertools.more • setuptools._vendor.more_itertools.recipes • setuptools._vendor.packaging._manylinux • setuptools._vendor.packaging._musllinux • setuptools._vendor.packaging.utils • setuptools._vendor.platformdirs.android • setuptools._vendor.platformdirs.windows • setuptools._vendor.tomli._re • setuptools._vendor.typing_extensions • setuptools._vendor.wheel.metadata • setuptools._vendor.wheel.vendored.packaging._manylinux • setuptools._vendor.wheel.vendored.packaging._musllinux • setuptools.command.egg_info • setuptools.config • setuptools.config._apply_pyprojecttoml • setuptools.config._validate_pyproject • setuptools.config.pyprojecttoml • setuptools.config.setupcfg • setuptools.dist • setuptools.extension • setuptools.wheel • six • statistics • tempfile • time_tracker_working.py • tokenize • tomllib._re • tracemalloc • types • typing • unittest.case • unittest.loader • unittest.mock • unittest.result • unittest.signals • urllib.parse • warnings

gc (builtin module)

imports: time

imported by: _posixsubprocess • _pytest.pytester • _pytest.unraisableexception • matplotlib.cbook • numpy.testing._private.utils • pandas.core.generic • weakref

genericpath SourceModule

imports: os • stat

imported by: ntpath • posixpath • time_tracker_working.py

getopt SourceModule

imports: gettext • os • sys

imported by: base64 • fileinput • mimetypes • pydoc • quopri • setuptools._distutils.fancy_getopt

getpass SourceModule

imports: contextlib • io • msvcrt • os • pwd • sys • termios • warnings

imported by: _pytest.tmpdir • urllib.request

gettext SourceModule

imports: builtins • copy • errno • locale • operator • os • re • struct • sys • warnings

imported by: argparse • getopt

gi MissingModule

imported by: matplotlib.cbook

glob SourceModule

imports: contextlib • fnmatch • functools • itertools • operator • os • re • stat • sys • warnings

imported by: _pytest._argcomplete • _pytest.config • pathlib._abc • pathlib._local • pdb • pygments.lexers._php_builtins • setuptools._distutils.command.sdist • setuptools._vendor.wheel.cli.convert • setuptools.command.bdist_wheel • setuptools.config.expand • setuptools.discovery • setuptools.dist • setuptools.installer

google MissingModule

imported by: pandas.io.gbq

grp MissingModule

imported by: _pytest._py.path • pathlib._local • setuptools._distutils.archive_util • setuptools._vendor.backports.tarfile • shutil • subprocess • tarfile

gzip SourceModule

imports: _compression • argparse • builtins • errno • io • os • struct • sys • time • warnings • weakref • zlib

imported by: PIL.FitsImagePlugin • fileinput • matplotlib.cbook • numpy.lib._datasource • pandas._testing._io • pandas.io.common • plotly.data • pygments.formatters.other • pygments.lexers.special • setuptools._vendor.backports.tarfile • tarfile • xmlrpc.client

hashlib SourceModule

imports: _blake2 • _hashlib • _md5 • _sha1 • _sha2 • _sha3 • logging

imported by: _pytest._py.path • hmac • matplotlib.texmanager • plotly.io._html • random • setuptools._vendor.wheel.wheelfile • urllib.request • uuid

heapq SourceModule

imports: _heapq

imported by: asyncio.base_events • asyncio.queues • collections • dateutil.rrule • difflib • queue • setuptools._vendor.more_itertools.more • time_tracker_working.py

hmac SourceModule

imports: _hashlib • _operator • hashlib • warnings

imported by: multiprocessing.connection • secrets

html Package

imports: html.entities • re

imported by: html.entities • http.server

html.entities SourceModule

imports: html

imported by: html • pyparsing.helpers

http Package

imports: enum

imported by: http.client • http.cookiejar • http.server

http.client SourceModule

imports: 'collections.abc' • email.message • email.parser • errno • http • io • re • socket • ssl • sys • urllib.parse

imported by: http.cookiejar • http.server • urllib.request • xmlrpc.client

http.cookiejar SourceModule

imports: calendar • copy • datetime • http • http.client • io • logging • os • re • threading • time • traceback • urllib.parse • urllib.request • warnings

imported by: urllib.request

http.server SourceModule

imports: argparse • base64 • binascii • contextlib • copy • datetime • email.utils • html • http • http.client • io • itertools • mimetypes • os • posixpath • pwd • select • shutil • socket • socketserver • subprocess • sys • time • urllib.parse • warnings

imported by: plotly.io._base_renderers • pydoc

ibis MissingModule

imported by: narwhals._ibis.dataframe • narwhals._ibis.expr • narwhals._ibis.expr_str • narwhals._ibis.namespace • narwhals._ibis.utils • narwhals.dependencies • narwhals.stable.v1.dependencies

importlib Package

imports: _frozen_importlib • _frozen_importlib_external • _imp • importlib • importlib._bootstrap • importlib._bootstrap_external • sys

imported by: _distutils_hack • _plotly_utils.basevalidators • _plotly_utils.importers • _plotly_utils.optional_imports • _pytest.main • _pytest.monkeypatch • _pytest.pytester • dateutil • importlib • importlib._abc • importlib._bootstrap • importlib._bootstrap_external • importlib.abc • importlib.machinery • importlib.metadata • importlib.readers • importlib.resources • importlib.resources._common • importlib.util • inspect • matplotlib • matplotlib.backend_bases • matplotlib.backends.registry • matplotlib.colors • matplotlib.pyplot • narwhals • narwhals._spark_like.utils • narwhals._utils • pandas.compat._optional • pandas.plotting._core • pkg_resources • pkgutil • plotly.data • setuptools._distutils • setuptools._vendor.importlib_metadata • setuptools.config.expand

importlib._abc SourceModule

imports: abc • importlib • importlib._bootstrap

imported by: importlib.abc • importlib.util

importlib._bootstrap SourceModule

imports: _frozen_importlib_external • importlib

imported by: importlib • importlib._abc • importlib.machinery • importlib.util • pydoc

importlib._bootstrap_external SourceModule

imports: _imp • _io • _warnings • importlib • importlib.metadata • importlib.readers • marshal • nt • posix • sys • tokenize • winreg

imported by: _pytest.pathlib • importlib • importlib.abc • importlib.machinery • importlib.util • py_compile • pydoc

importlib.abc SourceModule

imports: _frozen_importlib • _frozen_importlib_external • abc • importlib • importlib._abc • importlib._bootstrap_external • importlib.machinery • importlib.resources • importlib.resources.abc • warnings

imported by: _distutils_hack • _pytest.assertion.rewrite • importlib.metadata • pkg_resources • setuptools._vendor.importlib_metadata

importlib.machinery SourceModule

imports: importlib • importlib._bootstrap • importlib._bootstrap_external

imported by: _pytest.assertion.rewrite • _pytest.pathlib • ctypes.util • importlib.abc • inspect • packaging.tags • pkg_resources • pkgutil • py_compile • pydoc • runpy • setuptools._imp • setuptools._vendor.packaging.tags • setuptools._vendor.wheel.vendored.packaging.tags • setuptools.config.expand • sysconfig

importlib.metadata Package

imports: __future__ • abc • collections • contextlib • csv • email • functools • importlib • importlib.abc • importlib.metadata • importlib.metadata._adapters • importlib.metadata._collections • importlib.metadata._functools • importlib.metadata._itertools • importlib.metadata._meta • inspect • itertools • json • operator • os • pathlib • posixpath • re • sys • textwrap • types • typing • warnings • zipfile

imported by: _pytest.config • _pytest.unittest • importlib._bootstrap_external • importlib.metadata • importlib.metadata._adapters • importlib.metadata._collections • importlib.metadata._functools • importlib.metadata._itertools • importlib.metadata._meta • importlib.metadata._text • matplotlib.backends.registry • matplotlib.pyplot • narwhals • narwhals.functions • numpy.testing._private.utils • pandas.plotting._core • plotly • plotly.io._kaleido • pluggy._manager • pygments.plugin • setuptools._importlib

importlib.metadata._adapters SourceModule

imports: email.message • functools • importlib.metadata • importlib.metadata._text • re • textwrap • warnings

imported by: importlib.metadata

importlib.metadata._collections SourceModule

imports: collections • importlib.metadata

imported by: importlib.metadata

importlib.metadata._functools SourceModule

imports: functools • importlib.metadata • types

imported by: importlib.metadata • importlib.metadata._text

importlib.metadata._itertools SourceModule

imports: importlib.metadata • itertools

imported by: importlib.metadata

importlib.metadata._meta SourceModule

imports: __future__ • importlib.metadata • os • typing

imported by: importlib.metadata

importlib.metadata._text SourceModule

imports: importlib.metadata • importlib.metadata._functools • re

imported by: importlib.metadata._adapters

importlib.readers SourceModule

imports: importlib • importlib.resources.readers

imported by: _pytest.assertion.rewrite • importlib._bootstrap_external • zipimport

importlib.resources Package

imports: importlib • importlib.resources • importlib.resources._common • importlib.resources._functional • importlib.resources.abc

imported by: importlib.abc • importlib.resources • importlib.resources._adapters • importlib.resources._common • importlib.resources._functional • importlib.resources._itertools • importlib.resources.abc • importlib.resources.readers • matplotlib.style.core • setuptools._importlib • setuptools._vendor.jaraco.text

importlib.resources._adapters SourceModule

imports: contextlib • importlib.resources • importlib.resources.abc • io

imported by: importlib.resources._common

importlib.resources._common SourceModule

imports: contextlib • functools • importlib • importlib.resources • importlib.resources._adapters • importlib.resources.abc • inspect • itertools • os • pathlib • tempfile • types • typing • warnings

imported by: importlib.resources • importlib.resources._functional

importlib.resources._functional SourceModule

imports: importlib.resources • importlib.resources._common • warnings

imported by: importlib.resources

importlib.resources._itertools SourceModule

imports: importlib.resources

imported by: importlib.resources.readers

importlib.resources.abc SourceModule

imports: abc • importlib.resources • io • itertools • os • pathlib • typing

imported by: _pytest.assertion.rewrite • importlib.abc • importlib.resources • importlib.resources._adapters • importlib.resources._common • importlib.resources.readers

importlib.resources.readers SourceModule

imports: 'collections.abc' • __future__ • collections • contextlib • importlib.resources • importlib.resources._itertools • importlib.resources.abc • itertools • operator • pathlib • re • warnings • zipfile

imported by: _pytest.assertion.rewrite • importlib.readers

importlib.util SourceModule

imports: _imp • importlib • importlib._abc • importlib._bootstrap • importlib._bootstrap_external • sys • threading • types

imported by: _distutils_hack • _pytest._py.path • _pytest.assertion.rewrite • _pytest.main • _pytest.pathlib • narwhals._utils • numpy.testing._private.extbuild • pkgutil • py_compile • pydoc • runpy • setuptools._distutils.util • setuptools._imp • six • sysconfig • zipfile

importlib_metadata AliasNode

imports: setuptools._vendor.importlib_metadata

imported by: setuptools._importlib

importlib_resources MissingModule

imported by: setuptools._vendor.jaraco.text

iniconfig Package

imports: __future__ • iniconfig • iniconfig._parse • iniconfig.exceptions • os • typing

imported by: _pytest.config.findpaths • _pytest.legacypath • _pytest.pytester • iniconfig • iniconfig._parse • iniconfig.exceptions

iniconfig._parse SourceModule

imports: __future__ • iniconfig • iniconfig.exceptions • typing

imported by: iniconfig

iniconfig.exceptions SourceModule

imports: __future__ • iniconfig • typing

imported by: iniconfig • iniconfig._parse

inspect SourceModule

imports: 'collections.abc' • abc • argparse • ast • builtins • collections • dis • enum • functools • importlib • importlib.machinery • itertools • keyword • linecache • operator • os • re • sys • token • tokenize • types • weakref

imported by: _plotly_utils.basevalidators • _pytest._code.code • _pytest._code.source • _pytest.compat • _pytest.config • _pytest.doctest • _pytest.fixtures • _pytest.mark.structures • _pytest.monkeypatch • _pytest.nodes • _pytest.python • _pytest.terminal • _pytest.unittest • _pytest.warning_types • ast • asyncio.coroutines • asyncio.format_helpers • asyncio.tasks • bdb • cmd • dataclasses • doctest • importlib.metadata • importlib.resources._common • matplotlib • matplotlib._api.deprecation • matplotlib._docstring • matplotlib.artist • matplotlib.axes._base • matplotlib.backend_bases • matplotlib.colors • matplotlib.figure • matplotlib.patches • matplotlib.pyplot • matplotlib.scale • mpl_toolkits.mplot3d.axis3d • narwhals._utils • numpy.lib._utils_impl • numpy.ma.core • numpy.testing._private.utils • pandas._testing._warnings • pandas.core.apply • pandas.core.common • pandas.core.computation.scope • pandas.core.dtypes.astype • pandas.core.frame • pandas.core.groupby.groupby • pandas.core.groupby.numba_ • pandas.core.internals.blocks • pandas.core.window.rolling • pandas.util._decorators • pandas.util._exceptions • pdb • pkg_resources • pkgutil • plotly.express._doc • plotly.io._base_renderers • pluggy._hooks • pluggy._manager • pydoc • pyi_rth_inspect.py • pyparsing.diagram • pyparsing.exceptions • pyparsing.util • rlcompleter • setuptools._vendor.importlib_metadata • setuptools._vendor.jaraco.functools • setuptools._vendor.typing_extensions • setuptools.config._apply_pyprojecttoml • setuptools.config._validate_pyproject.extra_validations • setuptools.discovery • setuptools.logging • setuptools.monkey • setuptools.warnings • typing • unittest.async_case • unittest.mock • warnings

io SourceModule

imports: _io • abc

imported by: PIL.AvifImagePlugin • PIL.BlpImagePlugin • PIL.DdsImagePlugin • PIL.EpsImagePlugin • PIL.FtexImagePlugin • PIL.GifImagePlugin • PIL.GimpPaletteFile • PIL.IcnsImagePlugin • PIL.IcoImagePlugin • PIL.Image • PIL.ImageFile • PIL.ImageFont • PIL.ImageQt • PIL.ImageTk • PIL.IptcImagePlugin • PIL.Jpeg2KImagePlugin • PIL.JpegImagePlugin • PIL.MspImagePlugin • PIL.PcxImagePlugin • PIL.PdfImagePlugin • PIL.PngImagePlugin • PIL.PsdImagePlugin • PIL.TiffImagePlugin • PIL.WebPImagePlugin • _colorize • _compression • _plotly_utils.basevalidators • _plotly_utils.data_utils • _plotly_utils.png • _pyrepl.pager • _pyrepl.windows_console • _pytest._code.code • _pytest._io.pprint • _pytest._py.path • _pytest.assertion.rewrite • _pytest.capture • _pytest.logging • _pytest.pastebin • _pytest.pytester • _pytest.reports • asyncio.proactor_events • asyncio.unix_events • bz2 • configparser • csv • dateutil.parser._parser • dateutil.zoneinfo • dis • doctest • email.feedparser • email.generator • email.iterators • email.message • email.parser • encodings.quopri_codec • encodings.uu_codec • fileinput • getpass • gzip • http.client • http.cookiejar • http.server • importlib.resources._adapters • importlib.resources.abc • logging • lzma • matplotlib.backend_bases • matplotlib.backends.backend_webagg • matplotlib.backends.backend_webagg_core • matplotlib.colors • matplotlib.font_manager • multiprocessing.connection • multiprocessing.popen_forkserver • multiprocessing.popen_spawn_posix • multiprocessing.reduction • narwhals._arrow.dataframe • narwhals._compliant.dataframe • narwhals._pandas_like.dataframe • narwhals.dataframe • numpy.lib._format_impl • numpy.testing._private.utils • os • pandas._testing._io • pandas.compat.pickle_compat • pandas.core.arrays.arrow.extension_types • pandas.core.computation.parsing • pandas.core.computation.scope • pandas.core.frame • pandas.io.clipboards • pandas.io.common • pandas.io.excel._base • pandas.io.formats.format • pandas.io.formats.xml • pandas.io.json._json • pandas.io.orc • pandas.io.parquet • pandas.io.parsers.python_parser • pandas.io.stata • pandas.io.xml • pathlib._local • pdb • pickle • pickletools • pkg_resources • plistlib • plotly.figure_factory._county_choropleth • pprint • pydoc • pygments • pygments.formatters.html • pygments.formatters.latex • pygments.util • pyparsing.diagram • quopri • runpy • setuptools._vendor.backports.tarfile • setuptools._vendor.wheel.macosx_libfile • setuptools._vendor.wheel.wheelfile • setuptools._vendor.zipp • setuptools._vendor.zipp.compat.py310 • setuptools.command._requirestxt • setuptools.config._validate_pyproject.error_reporting • setuptools.dist • shlex • site • six • socket • socketserver • subprocess • tarfile • tempfile • time_tracker_working.py • tokenize • unittest.mock • unittest.result • urllib.error • urllib.request • uuid • xml.dom.minidom • xml.dom.pulldom • xml.etree.ElementTree • xml.sax • xml.sax.saxutils • xmlrpc.client • zipfile • zipfile._path

ipaddress SourceModule

imports: functools • re

imported by: urllib.parse • urllib.request

ipywidgets MissingModule

imported by: plotly.graph_objects • plotly.graph_objs

itertools (builtin module)

imported by: PIL.GifImagePlugin • PIL.ImageFile • PIL.MpoImagePlugin • PIL.PngImagePlugin • PIL.TiffImagePlugin • _plotly_utils.basevalidators • _plotly_utils.png • _pydecimal • _pytest.assertion.rewrite • _pytest.pathlib • _pytest.python • _pytest.python_api • asyncio.base_events • asyncio.selector_events • asyncio.tasks • asyncio.unix_events • asyncio.windows_utils • calendar • collections • concurrent.futures.process • concurrent.futures.thread • configparser • contourpy.array • contourpy.convert • ctypes.macholib.dyld • cycler • dataclasses • dateutil.rrule • glob • http.server • importlib.metadata • importlib.metadata._itertools • importlib.resources._common • importlib.resources.abc • importlib.resources.readers • inspect • matplotlib._api • matplotlib._layoutgrid • matplotlib.axes._axes • matplotlib.backend_bases • matplotlib.category • matplotlib.cbook • matplotlib.collections • matplotlib.colors • matplotlib.dviread • matplotlib.figure • matplotlib.legend • matplotlib.legend_handler • matplotlib.stackplot • matplotlib.ticker • matplotlib.transforms • matplotlib.widgets • mpl_toolkits.mplot3d.axes3d • multiprocessing.connection • multiprocessing.pool • multiprocessing.process • multiprocessing.util • narwhals._arrow.namespace • narwhals._compliant.dataframe • narwhals._duckdb.group_by • narwhals._duckdb.namespace • narwhals._expression_parsing • narwhals._ibis.namespace • narwhals._pandas_like.dataframe • narwhals._pandas_like.namespace • narwhals.dataframe • narwhals.dtypes • narwhals.schema • numpy._core.einsumfunc • numpy._core.numeric • numpy._core.shape_base • numpy.f2py._backends._meson • numpy.lib._iotools • numpy.lib._npyio_impl • numpy.lib.recfunctions • numpy.ma.extras • packaging.specifiers • packaging.version • pandas._config.config • pandas.core.computation.scope • pandas.core.frame • pandas.core.indexes.base • pandas.core.internals.array_manager • pandas.core.internals.managers • pandas.core.nanops • pandas.core.reshape.encoding • pandas.core.reshape.reshape • pandas.core.tools.datetimes • pandas.core.util.hashing • pandas.io.formats.excel • pandas.io.json._json • pandas.io.parsers.base_parser • pandas.io.pytables • pandas.plotting._matplotlib.style • pandas.util.version • pathlib._local • pdb • pickle • platform • plistlib • plotly.basedatatypes • plotly.express._imshow • pygments.regexopt • pyparsing.diagram • pyparsing.unicode • pyparsing.util • random • reprlib • setuptools._distutils.command.sdist • setuptools._distutils.compat.py39 • setuptools._distutils.compilers.C.msvc • setuptools._distutils.dir_util • setuptools._entry_points • setuptools._vendor.importlib_metadata • setuptools._vendor.importlib_metadata._itertools • setuptools._vendor.jaraco.functools • setuptools._vendor.jaraco.text • setuptools._vendor.more_itertools.more • setuptools._vendor.more_itertools.recipes • setuptools._vendor.packaging.specifiers • setuptools._vendor.packaging.version • setuptools._vendor.wheel.cli.tags • setuptools._vendor.wheel.metadata • setuptools._vendor.wheel.vendored.packaging.specifiers • setuptools._vendor.wheel.vendored.packaging.version • setuptools._vendor.zipp • setuptools.command._requirestxt • setuptools.command.sdist • setuptools.config._apply_pyprojecttoml • setuptools.config._validate_pyproject.formats • setuptools.config.expand • setuptools.discovery • setuptools.dist • setuptools.installer • setuptools.msvc • setuptools.wheel • six • statistics • threading • tkinter.font • tokenize • traceback • weakref • zipfile._path

jaraco NamespacePackage

imported by: jaraco.context • jaraco.functools • jaraco.text

jaraco.context AliasNode

imports: jaraco • setuptools._vendor.jaraco.context

imported by: setuptools._vendor.jaraco.text

jaraco.functools AliasNode

imports: jaraco • setuptools._vendor.jaraco.functools

imported by: setuptools._distutils._modified • setuptools._distutils.sysconfig • setuptools._distutils.util • setuptools._entry_points • setuptools._vendor.jaraco.text

jaraco.text AliasNode

imports: jaraco • setuptools._vendor.jaraco.text

imported by: pkg_resources • setuptools._entry_points • setuptools._reqs • setuptools.command._requirestxt

java MissingModule

imported by: platform

jinja2 MissingModule

imported by: pandas.io.formats.style • pyparsing.diagram

jnius MissingModule

imported by: setuptools._vendor.platformdirs.android

json Package

imports: codecs • json.decoder • json.encoder • json.scanner

imported by: _plotly_utils.utils • _pytest.cacheprovider • dateutil.zoneinfo • importlib.metadata • json.decoder • json.encoder • json.scanner • matplotlib.backends.backend_webagg • matplotlib.backends.backend_webagg_core • matplotlib.font_manager • numpy.__config__ • numpy.testing._private.utils • pandas.core.arrays.arrow.extension_types • pandas.core.generic • pandas.io.excel._odswriter • pandas.io.excel._xlsxwriter • pandas.io.parquet • pandas.util._print_versions • plotly.data • plotly.io._base_renderers • plotly.io._json • plotly.io._kaleido • plotly.io._orca • plotly.io._templates • plotly.tools • plotly.validator_cache • setuptools._vendor.importlib_metadata • setuptools.config._validate_pyproject.error_reporting • setuptools.msvc • time_tracker_working.py

json.decoder SourceModule

imports: _json • json • json.scanner • re

imported by: _json • json

json.encoder SourceModule

imports: _json • json • re

imported by: json

json.scanner SourceModule

imports: _json • json • re

imported by: json • json.decoder

kaleido MissingModule

imported by: plotly.io._kaleido

keyword SourceModule

imported by: _pytest.mark.expression • collections • dataclasses • inspect • pandas._config.config • pandas.core.computation.expr • pandas.core.computation.parsing • pygments.lexers.mojo • pygments.lexers.python • rlcompleter • time_tracker_working.py

kiwisolver Package

imports: kiwisolver._cext • kiwisolver.exceptions

imported by: kiwisolver._cext • kiwisolver.exceptions • matplotlib._layoutgrid

kiwisolver._cext C:\HTL\HTL 5\Diplomarbeit\Zeiterfassung\TimeTracker\.venv\Lib\site-packages\kiwisolver\_cext.cp313-win_amd64.pyd

imports: kiwisolver • typing • typing_extensions

imported by: kiwisolver

kiwisolver.exceptions SourceModule

imports: kiwisolver

imported by: kiwisolver

linecache SourceModule

imports: os • sys • tokenize

imported by: _pyrepl.console • asyncio.base_tasks • bdb • doctest • inspect • pdb • pkg_resources • time_tracker_working.py • traceback • tracemalloc • warnings

locale SourceModule

imports: _collections_abc • _locale • builtins • encodings • encodings.aliases • functools • os • re • sys • warnings

imported by: _pydecimal • _pytest.pytester • _strptime • calendar • gettext • matplotlib • matplotlib.ticker • pandas._config.display • pandas._config.localization • pandas.util._print_versions • pygments.util • site • subprocess • time_tracker_working.py • tkinter.filedialog

logging Package

imports: 'collections.abc' • atexit • io • os • pickle • re • string • sys • threading • time • traceback • types • warnings • weakref

imported by: PIL.Image • PIL.ImageFile • PIL.PcxImagePlugin • PIL.PngImagePlugin • PIL.TiffImagePlugin • _plotly_utils.optional_imports • _pytest.logging • asyncio.futures • asyncio.log • concurrent.futures._base • hashlib • http.cookiejar • matplotlib • matplotlib._afm • matplotlib._constrained_layout • matplotlib._layoutgrid • matplotlib._mathtext • matplotlib.artist • matplotlib.axes._axes • matplotlib.axes._base • matplotlib.axis • matplotlib.backend_bases • matplotlib.backends._backend_tk • matplotlib.backends.backend_webagg_core • matplotlib.category • matplotlib.colorbar • matplotlib.dates • matplotlib.dviread • matplotlib.figure • matplotlib.font_manager • matplotlib.gridspec • matplotlib.image • matplotlib.legend • matplotlib.lines • matplotlib.mathtext • matplotlib.pyplot • matplotlib.style.core • matplotlib.texmanager • matplotlib.text • matplotlib.textpath • matplotlib.ticker • multiprocessing.util • packaging.tags • setuptools._distutils._log • setuptools._distutils.cmd • setuptools._distutils.dist • setuptools._distutils.log • setuptools._vendor.packaging.tags • setuptools._vendor.wheel.util • setuptools._vendor.wheel.vendored.packaging.tags • setuptools.config._apply_pyprojecttoml • setuptools.config._validate_pyproject.error_reporting • setuptools.config._validate_pyproject.formats • setuptools.config.pyprojecttoml • setuptools.logging • unittest._log

lxml MissingModule

imported by: pandas.io.xml

lzma SourceModule

imports: _compression • _lzma • builtins • io • os

imported by: numpy.lib._datasource • pandas.compat.compressors • setuptools._vendor.backports.tarfile • shutil • tarfile • zipfile

markupsafe MissingModule

imported by: pandas.io.formats.style_render

marshal (builtin module)

imported by: _pytest.assertion.rewrite • importlib._bootstrap_external • pkgutil • setuptools.command.bdist_egg • setuptools.depends • zipimport

math (builtin module)

imported by: PIL.FitsImagePlugin • PIL.GifImagePlugin • PIL.GimpGradientFile • PIL.IcoImagePlugin • PIL.Image • PIL.ImageDraw • PIL.JpegImagePlugin • PIL.PdfImagePlugin • PIL.PpmImagePlugin • PIL.TiffImagePlugin • _plotly_utils.png • _pydatetime • _pydecimal • _pytest.python_api • asyncio.tasks • asyncio.windows_events • contourpy.chunk • dateutil.relativedelta • dateutil.rrule • fractions • matplotlib._api.deprecation • matplotlib.axes._axes • matplotlib.backends._backend_tk • matplotlib.backends.backend_agg • matplotlib.bezier • matplotlib.cbook • matplotlib.collections • matplotlib.contour • matplotlib.image • matplotlib.patches • matplotlib.projections.polar • matplotlib.quiver • matplotlib.text • matplotlib.ticker • matplotlib.transforms • mpl_toolkits.mplot3d.art3d • mpl_toolkits.mplot3d.axes3d • narwhals.expr • narwhals.series • numpy._core._internal • numpy._core._machar • numpy._core.numeric • numpy.f2py.symbolic • numpy.lib • numpy.lib._index_tricks_impl • pandas.io.excel._xlrd • pandas.io.formats.format • pandas.plotting._matplotlib.tools • plotly.express._core • plotly.figure_factory._bullet • plotly.figure_factory._county_choropleth • plotly.figure_factory._facet_grid • plotly.figure_factory._quiver • plotly.figure_factory._streamline • plotly.io._templates • pygments.formatters.groff • random • selectors • setuptools._vendor.more_itertools.more • setuptools._vendor.more_itertools.recipes • statistics • urllib.parse

matplotlib Package

imports: 'collections.abc' • atexit • certifi • collections • contextlib • functools • importlib • inspect • locale • logging • matplotlib • matplotlib._afm • matplotlib._api • matplotlib._blocking_input • matplotlib._c_internal_utils • matplotlib._cm • matplotlib._docstring • matplotlib._image • matplotlib._mathtext • matplotlib._path • matplotlib._qhull • matplotlib._text_helpers • matplotlib._tight_bbox • matplotlib._tight_layout • matplotlib._tri • matplotlib._version • matplotlib.axes • matplotlib.backend_tools • matplotlib.cbook • matplotlib.cm • matplotlib.collections • matplotlib.colorizer • matplotlib.colors • matplotlib.dviread • matplotlib.figure • matplotlib.font_manager • matplotlib.ft2font • matplotlib.legend_handler • matplotlib.lines • matplotlib.offsetbox • matplotlib.patches • matplotlib.projections • matplotlib.pylab • matplotlib.pyplot • matplotlib.rcsetup • matplotlib.scale • matplotlib.style • matplotlib.style.core • os • packaging.version • pathlib • pprint • re • setuptools_scm • shutil • ssl • subprocess • sys • tempfile • urllib.request • winreg

imported by: matplotlib • matplotlib._afm • matplotlib._api • matplotlib._blocking_input • matplotlib._c_internal_utils • matplotlib._cm • matplotlib._cm_bivar • matplotlib._cm_listed • matplotlib._cm_multivar • matplotlib._color_data • matplotlib._constrained_layout • matplotlib._docstring • matplotlib._enums • matplotlib._fontconfig_pattern • matplotlib._image • matplotlib._layoutgrid • matplotlib._mathtext • matplotlib._mathtext_data • matplotlib._path • matplotlib._pylab_helpers • matplotlib._qhull • matplotlib._text_helpers • matplotlib._tight_bbox • matplotlib._tight_layout • matplotlib._tri • matplotlib._version • matplotlib.artist • matplotlib.axes • matplotlib.axes._axes • matplotlib.axes._base • matplotlib.axes._secondary_axes • matplotlib.axis • matplotlib.backend_bases • matplotlib.backend_managers • matplotlib.backend_tools • matplotlib.backends • matplotlib.backends._backend_tk • matplotlib.backends.backend_agg • matplotlib.backends.backend_webagg • matplotlib.backends.backend_webagg_core • matplotlib.backends.registry • matplotlib.bezier • matplotlib.category • matplotlib.cbook • matplotlib.cm • matplotlib.collections • matplotlib.colorbar • matplotlib.colorizer • matplotlib.colors • matplotlib.container • matplotlib.contour • matplotlib.dates • matplotlib.dviread • matplotlib.figure • matplotlib.font_manager • matplotlib.ft2font • matplotlib.gridspec • matplotlib.hatch • matplotlib.image • matplotlib.inset • matplotlib.layout_engine • matplotlib.legend • matplotlib.legend_handler • matplotlib.lines • matplotlib.markers • matplotlib.mathtext • matplotlib.mlab • matplotlib.offsetbox • matplotlib.patches • matplotlib.path • matplotlib.patheffects • matplotlib.projections • matplotlib.projections.geo • matplotlib.projections.polar • matplotlib.pylab • matplotlib.pyplot • matplotlib.quiver • matplotlib.rcsetup • matplotlib.scale • matplotlib.spines • matplotlib.stackplot • matplotlib.streamplot • matplotlib.style • matplotlib.style.core • matplotlib.table • matplotlib.texmanager • matplotlib.text • matplotlib.textpath • matplotlib.ticker • matplotlib.transforms • matplotlib.tri • matplotlib.tri._triangulation • matplotlib.tri._tricontour • matplotlib.tri._trifinder • matplotlib.tri._triinterpolate • matplotlib.tri._tripcolor • matplotlib.tri._trirefine • matplotlib.tri._tritools • matplotlib.typing • matplotlib.units • matplotlib.widgets • mpl_toolkits.mplot3d.art3d • mpl_toolkits.mplot3d.axes3d • mpl_toolkits.mplot3d.axis3d • mpl_toolkits.mplot3d.proj3d • pandas.io.formats.style • pandas.plotting._matplotlib.boxplot • pandas.plotting._matplotlib.core • pandas.plotting._matplotlib.misc • pandas.plotting._matplotlib.style • pandas.plotting._matplotlib.timeseries • pandas.plotting._matplotlib.tools

matplotlib._afm SourceModule

imports: collections • logging • matplotlib • matplotlib._mathtext_data • re

imported by: matplotlib • matplotlib.font_manager

matplotlib._api Package

imports: functools • itertools • matplotlib • matplotlib._api • matplotlib._api.deprecation • pathlib • re • sys • warnings

imported by: matplotlib • matplotlib._api • matplotlib._api.deprecation • matplotlib._constrained_layout • matplotlib._docstring • matplotlib._text_helpers • matplotlib._tight_layout • matplotlib.artist • matplotlib.axes._axes • matplotlib.axes._base • matplotlib.axes._secondary_axes • matplotlib.axis • matplotlib.backend_bases • matplotlib.backend_managers • matplotlib.backend_tools • matplotlib.backends._backend_tk • matplotlib.backends.backend_agg • matplotlib.backends.backend_webagg_core • matplotlib.bezier • matplotlib.category • matplotlib.cbook • matplotlib.cm • matplotlib.collections • matplotlib.colorbar • matplotlib.colorizer • matplotlib.colors • matplotlib.contour • matplotlib.dates • matplotlib.dviread • matplotlib.figure • matplotlib.font_manager • matplotlib.gridspec • matplotlib.hatch • matplotlib.image • matplotlib.inset • matplotlib.legend • matplotlib.lines • matplotlib.markers • matplotlib.mathtext • matplotlib.mlab • matplotlib.offsetbox • matplotlib.patches • matplotlib.path • matplotlib.projections.geo • matplotlib.projections.polar • matplotlib.pyplot • matplotlib.quiver • matplotlib.rcsetup • matplotlib.scale • matplotlib.spines • matplotlib.stackplot • matplotlib.streamplot • matplotlib.style.core • matplotlib.table • matplotlib.text • matplotlib.ticker • matplotlib.transforms • matplotlib.tri._triangulation • matplotlib.tri._trifinder • matplotlib.tri._triinterpolate • matplotlib.tri._tripcolor • matplotlib.tri._trirefine • matplotlib.tri._tritools • matplotlib.widgets • mpl_toolkits.mplot3d.art3d • mpl_toolkits.mplot3d.axes3d • mpl_toolkits.mplot3d.axis3d • mpl_toolkits.mplot3d.proj3d

matplotlib._api.deprecation SourceModule

imports: contextlib • functools • inspect • math • matplotlib._api • warnings

imported by: matplotlib._api

matplotlib._blocking_input SourceModule

imports: matplotlib

imported by: matplotlib • matplotlib.figure

matplotlib._c_internal_utils C:\HTL\HTL 5\Diplomarbeit\Zeiterfassung\TimeTracker\.venv\Lib\site-packages\matplotlib\_c_internal_utils.cp313-win_amd64.pyd

imports: matplotlib

imported by: matplotlib • matplotlib.backends._backend_tk • matplotlib.cbook

matplotlib._cm SourceModule

imports: functools • matplotlib • numpy

imported by: matplotlib • matplotlib.cm • matplotlib.colors

matplotlib._cm_bivar SourceModule

imports: matplotlib • matplotlib.colors • numpy

imported by: matplotlib.cm

matplotlib._cm_listed SourceModule

imports: matplotlib • matplotlib.colors

imported by: matplotlib.cm

matplotlib._cm_multivar SourceModule

imports: matplotlib • matplotlib.colors

imported by: matplotlib.cm

matplotlib._color_data SourceModule

imports: matplotlib

imported by: matplotlib.colors

matplotlib._constrained_layout SourceModule

imports: logging • matplotlib • matplotlib._api • matplotlib._layoutgrid • matplotlib.artist • matplotlib.transforms • numpy

imported by: matplotlib.layout_engine

matplotlib._docstring SourceModule

imports: inspect • matplotlib • matplotlib._api • matplotlib.artist

imported by: matplotlib • matplotlib._enums • matplotlib.axes._axes • matplotlib.axes._base • matplotlib.axes._secondary_axes • matplotlib.backend_bases • matplotlib.collections • matplotlib.colorbar • matplotlib.contour • matplotlib.figure • matplotlib.legend • matplotlib.lines • matplotlib.mlab • matplotlib.offsetbox • matplotlib.patches • matplotlib.projections • matplotlib.pyplot • matplotlib.quiver • matplotlib.scale • matplotlib.spines • matplotlib.style.core • matplotlib.table • matplotlib.text • matplotlib.tri._tricontour • matplotlib.tri._tripcolor • matplotlib.widgets • mpl_toolkits.mplot3d.axes3d

matplotlib._enums SourceModule

imports: enum • matplotlib • matplotlib._docstring • matplotlib.pyplot • numpy

imported by: matplotlib.backend_bases • matplotlib.collections • matplotlib.lines • matplotlib.markers • matplotlib.patches • matplotlib.rcsetup • matplotlib.typing

matplotlib._fontconfig_pattern SourceModule

imports: functools • matplotlib • pyparsing • re

imported by: matplotlib.font_manager • matplotlib.rcsetup

matplotlib._image C:\HTL\HTL 5\Diplomarbeit\Zeiterfassung\TimeTracker\.venv\Lib\site-packages\matplotlib\_image.cp313-win_amd64.pyd

imports: matplotlib

imported by: matplotlib • matplotlib.colors • matplotlib.image

matplotlib._layoutgrid SourceModule

imports: itertools • kiwisolver • logging • matplotlib • matplotlib.patches • matplotlib.transforms • numpy

imported by: matplotlib._constrained_layout

matplotlib._mathtext SourceModule

imports: 'collections.abc' • __future__ • abc • copy • enum • functools • logging • matplotlib • matplotlib._mathtext_data • matplotlib.cbook • matplotlib.font_manager • matplotlib.ft2font • numpy • os • packaging.version • pyparsing • re • string • types • typing • unicodedata

imported by: matplotlib • matplotlib.mathtext

matplotlib._mathtext_data SourceModule

imports: __future__ • matplotlib • typing

imported by: matplotlib._afm • matplotlib._mathtext

matplotlib._path C:\HTL\HTL 5\Diplomarbeit\Zeiterfassung\TimeTracker\.venv\Lib\site-packages\matplotlib\_path.cp313-win_amd64.pyd

imports: 'collections.abc' • matplotlib • matplotlib.transforms • numpy

imported by: matplotlib • matplotlib.collections • matplotlib.lines • matplotlib.path • matplotlib.transforms

matplotlib._pylab_helpers SourceModule

imports: atexit • collections • matplotlib

imported by: matplotlib.backend_bases • matplotlib.backend_tools • matplotlib.backends._backend_tk • matplotlib.backends.backend_webagg • matplotlib.figure • matplotlib.gridspec • matplotlib.pyplot

matplotlib._qhull C:\HTL\HTL 5\Diplomarbeit\Zeiterfassung\TimeTracker\.venv\Lib\site-packages\matplotlib\_qhull.cp313-win_amd64.pyd

imports: matplotlib

imported by: matplotlib • matplotlib.tri._triangulation

matplotlib._text_helpers SourceModule

imports: __future__ • dataclasses • matplotlib • matplotlib._api • matplotlib.ft2font

imported by: matplotlib • matplotlib.textpath

matplotlib._tight_bbox SourceModule

imports: matplotlib • matplotlib.transforms

imported by: matplotlib • matplotlib.backend_bases

matplotlib._tight_layout SourceModule

imports: matplotlib • matplotlib._api • matplotlib.artist • matplotlib.font_manager • matplotlib.transforms • numpy

imported by: matplotlib • matplotlib.gridspec • matplotlib.layout_engine

matplotlib._tri C:\HTL\HTL 5\Diplomarbeit\Zeiterfassung\TimeTracker\.venv\Lib\site-packages\matplotlib\_tri.cp313-win_amd64.pyd

imports: matplotlib • numpy • numpy.typing • typing

imported by: matplotlib • matplotlib.tri._triangulation • matplotlib.tri._tricontour • matplotlib.tri._trifinder

matplotlib._version SourceModule

imports: matplotlib

imported by: matplotlib

matplotlib.artist SourceModule

imports: collections • contextlib • functools • inspect • logging • matplotlib • matplotlib._api • matplotlib.backend_bases • matplotlib.cbook • matplotlib.patches • matplotlib.path • matplotlib.transforms • numbers • numpy • operator • re • warnings

imported by: matplotlib._constrained_layout • matplotlib._docstring • matplotlib._tight_layout • matplotlib.axes._base • matplotlib.axis • matplotlib.cbook • matplotlib.collections • matplotlib.colorbar • matplotlib.colorizer • matplotlib.container • matplotlib.figure • matplotlib.image • matplotlib.inset • matplotlib.legend • matplotlib.lines • matplotlib.offsetbox • matplotlib.patches • matplotlib.pyplot • matplotlib.quiver • matplotlib.spines • matplotlib.table • matplotlib.text • matplotlib.typing • mpl_toolkits.mplot3d.art3d • mpl_toolkits.mplot3d.axes3d • mpl_toolkits.mplot3d.axis3d • pandas._testing.asserters • pandas.plotting._matplotlib.boxplot • pandas.plotting._matplotlib.core

matplotlib.axes Package

imports: matplotlib • matplotlib.axes • matplotlib.axes._axes • matplotlib.axes._base

imported by: matplotlib • matplotlib.axes • matplotlib.axes._axes • matplotlib.axes._base • matplotlib.axes._secondary_axes • matplotlib.figure • matplotlib.legend • matplotlib.projections • matplotlib.projections.geo • matplotlib.projections.polar • matplotlib.pyplot • matplotlib.tri._triplot • mpl_toolkits.mplot3d.axes3d • pandas._testing.asserters • pandas.plotting._core • pandas.plotting._matplotlib.boxplot • pandas.plotting._matplotlib.core • pandas.plotting._matplotlib.hist • pandas.plotting._matplotlib.misc • pandas.plotting._matplotlib.timeseries • pandas.plotting._matplotlib.tools • pandas.plotting._misc

matplotlib.axes._axes SourceModule

imports: builtins • functools • itertools • logging • math • matplotlib • matplotlib._api • matplotlib._docstring • matplotlib.axes • matplotlib.axes._base • matplotlib.axes._secondary_axes • matplotlib.category • matplotlib.cbook • matplotlib.collections • matplotlib.colorizer • matplotlib.colors • matplotlib.container • matplotlib.contour • matplotlib.dates • matplotlib.image • matplotlib.inset • matplotlib.legend • matplotlib.lines • matplotlib.markers • matplotlib.mlab • matplotlib.patches • matplotlib.path • matplotlib.quiver • matplotlib.stackplot • matplotlib.streamplot • matplotlib.table • matplotlib.text • matplotlib.ticker • matplotlib.transforms • matplotlib.tri • matplotlib.units • numbers • numpy • re

imported by: matplotlib.axes

matplotlib.axes._base SourceModule

imports: 'collections.abc' • contextlib • functools • inspect • logging • matplotlib • matplotlib._api • matplotlib._docstring • matplotlib.artist • matplotlib.axes • matplotlib.axis • matplotlib.cbook • matplotlib.collections • matplotlib.colors • matplotlib.font_manager • matplotlib.gridspec • matplotlib.image • matplotlib.lines • matplotlib.offsetbox • matplotlib.patches • matplotlib.rcsetup • matplotlib.spines • matplotlib.table • matplotlib.text • matplotlib.ticker • matplotlib.transforms • numbers • numpy • operator • re • types

imported by: matplotlib.axes • matplotlib.axes._axes • matplotlib.axes._secondary_axes • matplotlib.pyplot • mpl_toolkits.mplot3d.axes3d

matplotlib.axes._secondary_axes SourceModule

imports: matplotlib • matplotlib._api • matplotlib._docstring • matplotlib.axes • matplotlib.axes._base • matplotlib.axis • matplotlib.ticker • matplotlib.transforms • numbers • numpy

imported by: matplotlib.axes._axes

matplotlib.axis SourceModule

imports: datetime • dateutil.tz • functools • logging • matplotlib • matplotlib._api • matplotlib.artist • matplotlib.cbook • matplotlib.colors • matplotlib.lines • matplotlib.scale • matplotlib.text • matplotlib.ticker • matplotlib.transforms • matplotlib.units • numbers • numpy • warnings

imported by: matplotlib.axes._base • matplotlib.axes._secondary_axes • matplotlib.projections.geo • matplotlib.projections.polar • matplotlib.pyplot • mpl_toolkits.mplot3d.axis3d • pandas.plotting._matplotlib.converter • pandas.plotting._matplotlib.core • pandas.plotting._matplotlib.tools

matplotlib.backend_bases SourceModule

imports: collections • contextlib • enum • functools • importlib • inspect • io • itertools • logging • matplotlib • matplotlib._api • matplotlib._docstring • matplotlib._enums • matplotlib._pylab_helpers • matplotlib._tight_bbox • matplotlib.backend_managers • matplotlib.backend_tools • matplotlib.backends.registry • matplotlib.cbook • matplotlib.collections • matplotlib.colors • matplotlib.figure • matplotlib.layout_engine • matplotlib.path • matplotlib.texmanager • matplotlib.text • matplotlib.transforms • matplotlib.widgets • numpy • os • pathlib • signal • socket • sys • time • weakref

imported by: matplotlib.artist • matplotlib.backend_tools • matplotlib.backends._backend_tk • matplotlib.backends.backend_agg • matplotlib.backends.backend_webagg • matplotlib.backends.backend_webagg_core • matplotlib.contour • matplotlib.figure • matplotlib.image • matplotlib.patheffects • matplotlib.pyplot • matplotlib.typing

matplotlib.backend_managers SourceModule

imports: matplotlib • matplotlib._api • matplotlib.backend_tools • matplotlib.cbook • matplotlib.widgets

imported by: matplotlib.backend_bases

matplotlib.backend_tools SourceModule

imports: enum • functools • matplotlib • matplotlib._api • matplotlib._pylab_helpers • matplotlib.backend_bases • matplotlib.cbook • numpy • re • time • types • uuid • weakref

imported by: matplotlib • matplotlib.backend_bases • matplotlib.backend_managers • matplotlib.backends._backend_tk • matplotlib.backends.backend_webagg_core • matplotlib.widgets

matplotlib.backends Package

imports: matplotlib • matplotlib.backends • matplotlib.backends._backend_tk • matplotlib.backends._tkagg • matplotlib.backends.backend_agg • matplotlib.backends.backend_tkagg • matplotlib.backends.backend_webagg • matplotlib.backends.backend_webagg_core • matplotlib.backends.registry

imported by: matplotlib.backends • matplotlib.backends._backend_agg • matplotlib.backends._backend_tk • matplotlib.backends._tkagg • matplotlib.backends.backend_agg • matplotlib.backends.backend_tkagg • matplotlib.backends.backend_webagg • matplotlib.backends.backend_webagg_core • matplotlib.backends.registry • matplotlib.figure • matplotlib.mathtext • matplotlib.pyplot • matplotlib.rcsetup

matplotlib.backends._backend_agg C:\HTL\HTL 5\Diplomarbeit\Zeiterfassung\TimeTracker\.venv\Lib\site-packages\matplotlib\backends\_backend_agg.cp313-win_amd64.pyd

imports: matplotlib.backends

imported by: matplotlib.backends.backend_agg

matplotlib.backends._backend_tk SourceModule

imports: PIL • PIL.Image • PIL.ImageTk • contextlib • logging • math • matplotlib • matplotlib._api • matplotlib._c_internal_utils • matplotlib._pylab_helpers • matplotlib.backend_bases • matplotlib.backend_tools • matplotlib.backends • matplotlib.backends._tkagg • matplotlib.cbook • numpy • os.path • pathlib • sys • tkinter • tkinter.filedialog • tkinter.font • tkinter.messagebox • tkinter.simpledialog • uuid • weakref

imported by: matplotlib.backends • matplotlib.backends.backend_tkagg

matplotlib.backends._tkagg C:\HTL\HTL 5\Diplomarbeit\Zeiterfassung\TimeTracker\.venv\Lib\site-packages\matplotlib\backends\_tkagg.cp313-win_amd64.pyd

imports: matplotlib.backends • numpy • numpy.typing

imported by: matplotlib.backends • matplotlib.backends._backend_tk

matplotlib.backends.backend_agg SourceModule

imports: contextlib • math • matplotlib • matplotlib._api • matplotlib.backend_bases • matplotlib.backends • matplotlib.backends._backend_agg • matplotlib.cbook • matplotlib.font_manager • matplotlib.ft2font • matplotlib.mathtext • matplotlib.path • matplotlib.transforms • numpy

imported by: matplotlib.backends • matplotlib.backends.backend_tkagg • matplotlib.backends.backend_webagg_core • matplotlib.mathtext

matplotlib.backends.backend_tkagg SourceModule

imports: matplotlib.backends • matplotlib.backends._backend_tk • matplotlib.backends.backend_agg

imported by: matplotlib.backends

matplotlib.backends.backend_webagg SourceModule

imports: 'tornado.ioloop' • 'tornado.template' • 'tornado.web' • 'tornado.websocket' • asyncio • contextlib • errno • io • json • matplotlib • matplotlib._pylab_helpers • matplotlib.backend_bases • matplotlib.backends • matplotlib.backends.backend_webagg_core • mimetypes • pathlib • random • signal • sys • threading • tornado • webbrowser

imported by: matplotlib.backends • matplotlib.figure

matplotlib.backends.backend_webagg_core SourceModule

imports: PIL • PIL.Image • asyncio • datetime • io • json • logging • matplotlib • matplotlib._api • matplotlib.backend_bases • matplotlib.backend_tools • matplotlib.backends • matplotlib.backends.backend_agg • matplotlib.pyplot • numpy • os • pathlib • tornado

imported by: matplotlib.backends • matplotlib.backends.backend_webagg

matplotlib.backends.registry SourceModule

imports: enum • importlib • importlib.metadata • matplotlib • matplotlib.backends

imported by: matplotlib.backend_bases • matplotlib.backends

matplotlib.bezier SourceModule

imports: functools • math • matplotlib • matplotlib._api • matplotlib.path • numpy • warnings

imported by: matplotlib.patches • matplotlib.path

matplotlib.category SourceModule

imports: collections • dateutil.parser • itertools • logging • matplotlib • matplotlib._api • matplotlib.cbook • matplotlib.ticker • matplotlib.units • numpy

imported by: matplotlib.axes._axes

matplotlib.cbook SourceModule

imports: 'collections.abc' • bz2 • collections • contextlib • functools • gc • gi • gzip • itertools • math • matplotlib • matplotlib._api • matplotlib._c_internal_utils • matplotlib.artist • numpy • numpy.VisibleDeprecationWarning • numpy.exceptions • operator • os • pathlib • shlex • subprocess • sys • time • traceback • types • weakref

imported by: matplotlib • matplotlib._mathtext • matplotlib.artist • matplotlib.axes._axes • matplotlib.axes._base • matplotlib.axis • matplotlib.backend_bases • matplotlib.backend_managers • matplotlib.backend_tools • matplotlib.backends._backend_tk • matplotlib.backends.backend_agg • matplotlib.category • matplotlib.collections • matplotlib.colorbar • matplotlib.colorizer • matplotlib.colors • matplotlib.container • matplotlib.contour • matplotlib.dates • matplotlib.dviread • matplotlib.figure • matplotlib.font_manager • matplotlib.image • matplotlib.legend • matplotlib.legend_handler • matplotlib.lines • matplotlib.markers • matplotlib.mlab • matplotlib.patches • matplotlib.path • matplotlib.projections.polar • matplotlib.pylab • matplotlib.pyplot • matplotlib.quiver • matplotlib.rcsetup • matplotlib.table • matplotlib.texmanager • matplotlib.text • matplotlib.ticker • matplotlib.tri._triplot • matplotlib.units • matplotlib.widgets • mpl_toolkits.mplot3d.art3d • mpl_toolkits.mplot3d.axes3d

matplotlib.cm SourceModule

imports: 'collections.abc' • matplotlib • matplotlib._api • matplotlib._cm • matplotlib._cm_bivar • matplotlib._cm_listed • matplotlib._cm_multivar • matplotlib.colorizer • matplotlib.colors

imported by: matplotlib • matplotlib.colorbar • matplotlib.colorizer • matplotlib.contour • matplotlib.pyplot • matplotlib.streamplot

matplotlib.collections SourceModule

imports: functools • itertools • math • matplotlib • matplotlib._api • matplotlib._docstring • matplotlib._enums • matplotlib._path • matplotlib.artist • matplotlib.cbook • matplotlib.colorizer • matplotlib.colors • matplotlib.hatch • matplotlib.lines • matplotlib.path • matplotlib.patheffects • matplotlib.transforms • numbers • numpy • warnings

imported by: matplotlib • matplotlib.axes._axes • matplotlib.axes._base • matplotlib.backend_bases • matplotlib.colorbar • matplotlib.contour • matplotlib.legend • matplotlib.legend_handler • matplotlib.pyplot • matplotlib.quiver • matplotlib.streamplot • matplotlib.tri._tripcolor • matplotlib.widgets • mpl_toolkits.mplot3d.art3d • mpl_toolkits.mplot3d.axes3d

matplotlib.colorbar SourceModule

imports: logging • matplotlib • matplotlib._api • matplotlib._docstring • matplotlib.artist • matplotlib.cbook • matplotlib.cm • matplotlib.collections • matplotlib.colors • matplotlib.contour • matplotlib.patches • matplotlib.path • matplotlib.spines • matplotlib.ticker • matplotlib.transforms • numpy

imported by: matplotlib.figure • matplotlib.pyplot

matplotlib.colorizer SourceModule

imports: functools • matplotlib • matplotlib._api • matplotlib.artist • matplotlib.cbook • matplotlib.cm • matplotlib.colors • matplotlib.scale • numpy • numpy.ma

imported by: matplotlib • matplotlib.axes._axes • matplotlib.cm • matplotlib.collections • matplotlib.image • matplotlib.pyplot

matplotlib.colors SourceModule

imports: 'collections.abc' • PIL • PIL.Image • PIL.PngImagePlugin • base64 • functools • importlib • inspect • io • itertools • matplotlib • matplotlib._api • matplotlib._cm • matplotlib._color_data • matplotlib._image • matplotlib.cbook • matplotlib.scale • numbers • numpy • re

imported by: matplotlib • matplotlib._cm_bivar • matplotlib._cm_listed • matplotlib._cm_multivar • matplotlib.axes._axes • matplotlib.axes._base • matplotlib.axis • matplotlib.backend_bases • matplotlib.cm • matplotlib.collections • matplotlib.colorbar • matplotlib.colorizer • matplotlib.contour • matplotlib.image • matplotlib.legend • matplotlib.lines • matplotlib.patches • matplotlib.patheffects • matplotlib.pyplot • matplotlib.rcsetup • matplotlib.streamplot • matplotlib.widgets • mpl_toolkits.mplot3d.art3d • mpl_toolkits.mplot3d.axes3d • mpl_toolkits.mplot3d.axis3d • pandas.io.formats.style • pandas.plotting._matplotlib.core • pandas.plotting._matplotlib.style • pandas.plotting._misc

matplotlib.container SourceModule

imports: matplotlib • matplotlib.artist • matplotlib.cbook

imported by: matplotlib.axes._axes • matplotlib.legend • matplotlib.pyplot • mpl_toolkits.mplot3d.axes3d

matplotlib.contour SourceModule

imports: contextlib • contourpy • functools • math • matplotlib • matplotlib._api • matplotlib._docstring • matplotlib.backend_bases • matplotlib.cbook • matplotlib.cm • matplotlib.collections • matplotlib.colors • matplotlib.font_manager • matplotlib.lines • matplotlib.patches • matplotlib.path • matplotlib.text • matplotlib.ticker • matplotlib.transforms • numbers • numpy • numpy.ma

imported by: matplotlib.axes._axes • matplotlib.colorbar • matplotlib.pyplot • matplotlib.tri._tricontour

matplotlib.dates SourceModule

imports: datetime • dateutil.parser • dateutil.relativedelta • dateutil.rrule • dateutil.tz • functools • logging • matplotlib • matplotlib._api • matplotlib.cbook • matplotlib.ticker • matplotlib.units • numpy • re

imported by: matplotlib.axes._axes • matplotlib.pylab • pandas.plotting._matplotlib.converter

matplotlib.dviread SourceModule

imports: argparse • collections • enum • functools • itertools • logging • matplotlib • matplotlib._api • matplotlib.cbook • numpy • os • pathlib • re • struct • subprocess • sys

imported by: matplotlib • matplotlib.texmanager • matplotlib.textpath

matplotlib.figure SourceModule

imports: contextlib • functools • inspect • itertools • logging • matplotlib • matplotlib._api • matplotlib._blocking_input • matplotlib._docstring • matplotlib._pylab_helpers • matplotlib.artist • matplotlib.axes • matplotlib.backend_bases • matplotlib.backends • matplotlib.backends.backend_webagg • matplotlib.cbook • matplotlib.colorbar • matplotlib.gridspec • matplotlib.image • matplotlib.layout_engine • matplotlib.legend • matplotlib.patches • matplotlib.projections • matplotlib.pyplot • matplotlib.text • matplotlib.transforms • numbers • numpy • threading

imported by: matplotlib • matplotlib.backend_bases • matplotlib.font_manager • matplotlib.image • matplotlib.legend • matplotlib.mathtext • matplotlib.pyplot • pandas.plotting._matplotlib.boxplot • pandas.plotting._matplotlib.core • pandas.plotting._matplotlib.hist • pandas.plotting._matplotlib.misc • pandas.plotting._matplotlib.tools • pandas.plotting._misc

matplotlib.font_manager SourceModule

imports: __future__ • base64 • copy • dataclasses • functools • io • json • logging • matplotlib • matplotlib._afm • matplotlib._api • matplotlib._fontconfig_pattern • matplotlib.cbook • matplotlib.figure • matplotlib.ft2font • matplotlib.rcsetup • numbers • os • pathlib • plistlib • re • subprocess • sys • threading • winreg

imported by: matplotlib • matplotlib._mathtext • matplotlib._tight_layout • matplotlib.axes._base • matplotlib.backends.backend_agg • matplotlib.contour • matplotlib.legend • matplotlib.mathtext • matplotlib.offsetbox • matplotlib.text • matplotlib.textpath • matplotlib.ticker

matplotlib.ft2font C:\HTL\HTL 5\Diplomarbeit\Zeiterfassung\TimeTracker\.venv\Lib\site-packages\matplotlib\ft2font.cp313-win_amd64.pyd

imports: enum • matplotlib • numpy • numpy.typing • sys • typing • typing_extensions

imported by: matplotlib • matplotlib._mathtext • matplotlib._text_helpers • matplotlib.backends.backend_agg • matplotlib.font_manager • matplotlib.mathtext • matplotlib.textpath

matplotlib.gridspec SourceModule

imports: copy • logging • matplotlib • matplotlib._api • matplotlib._pylab_helpers • matplotlib._tight_layout • matplotlib.transforms • numbers • numpy

imported by: matplotlib.axes._base • matplotlib.figure • matplotlib.pyplot

matplotlib.hatch SourceModule

imports: matplotlib • matplotlib._api • matplotlib.path • numpy

imported by: matplotlib.collections • matplotlib.patches • matplotlib.path

matplotlib.image SourceModule

imports: PIL.Image • PIL.PngImagePlugin • logging • math • matplotlib • matplotlib._api • matplotlib._image • matplotlib.artist • matplotlib.backend_bases • matplotlib.cbook • matplotlib.colorizer • matplotlib.colors • matplotlib.figure • matplotlib.pyplot • matplotlib.transforms • numpy • os • pathlib • urllib • urllib.parse • warnings

imported by: matplotlib.axes._axes • matplotlib.axes._base • matplotlib.figure • matplotlib.offsetbox • matplotlib.pyplot • mpl_toolkits.mplot3d.axes3d

matplotlib.inset SourceModule

imports: matplotlib • matplotlib._api • matplotlib.artist • matplotlib.patches • matplotlib.path • matplotlib.transforms

imported by: matplotlib.axes._axes

matplotlib.layout_engine SourceModule

imports: contextlib • matplotlib • matplotlib._constrained_layout • matplotlib._tight_layout

imported by: matplotlib.backend_bases • matplotlib.figure

matplotlib.legend SourceModule

imports: itertools • logging • matplotlib • matplotlib._api • matplotlib._docstring • matplotlib.artist • matplotlib.axes • matplotlib.cbook • matplotlib.collections • matplotlib.colors • matplotlib.container • matplotlib.figure • matplotlib.font_manager • matplotlib.legend_handler • matplotlib.lines • matplotlib.offsetbox • matplotlib.patches • matplotlib.text • matplotlib.transforms • numbers • numpy • time

imported by: matplotlib.axes._axes • matplotlib.figure • matplotlib.pyplot

matplotlib.legend_handler SourceModule

imports: itertools • matplotlib • matplotlib.cbook • matplotlib.collections • matplotlib.lines • matplotlib.patches • numpy

imported by: matplotlib • matplotlib.legend

matplotlib.lines SourceModule

imports: copy • logging • matplotlib • matplotlib._api • matplotlib._docstring • matplotlib._enums • matplotlib._path • matplotlib.artist • matplotlib.cbook • matplotlib.colors • matplotlib.markers • matplotlib.path • matplotlib.patheffects • matplotlib.transforms • numbers • numpy

imported by: matplotlib • matplotlib.axes._axes • matplotlib.axes._base • matplotlib.axis • matplotlib.collections • matplotlib.contour • matplotlib.legend • matplotlib.legend_handler • matplotlib.patches • matplotlib.pyplot • matplotlib.streamplot • matplotlib.tri._triplot • matplotlib.widgets • mpl_toolkits.mplot3d.art3d • mpl_toolkits.mplot3d.axes3d • mpl_toolkits.mplot3d.axis3d • pandas.plotting._matplotlib.boxplot • pandas.plotting._matplotlib.misc • pandas.plotting._matplotlib.tools

matplotlib.markers SourceModule

imports: 'collections.abc' • copy • matplotlib • matplotlib._api • matplotlib._enums • matplotlib.cbook • matplotlib.path • matplotlib.text • matplotlib.transforms • numpy

imported by: matplotlib.axes._axes • matplotlib.lines • matplotlib.projections.polar • matplotlib.typing

matplotlib.mathtext SourceModule

imports: functools • logging • matplotlib • matplotlib._api • matplotlib._mathtext • matplotlib.backends • matplotlib.backends.backend_agg • matplotlib.figure • matplotlib.font_manager • matplotlib.ft2font

imported by: matplotlib.backends.backend_agg • matplotlib.textpath

matplotlib.mlab SourceModule

imports: functools • matplotlib • matplotlib._api • matplotlib._docstring • matplotlib.cbook • numbers • numpy

imported by: matplotlib.axes._axes • matplotlib.pylab • matplotlib.pyplot

matplotlib.offsetbox SourceModule

imports: functools • matplotlib • matplotlib._api • matplotlib._docstring • matplotlib.artist • matplotlib.font_manager • matplotlib.image • matplotlib.patches • matplotlib.path • matplotlib.text • matplotlib.transforms • numpy

imported by: matplotlib • matplotlib.axes._base • matplotlib.legend • matplotlib.text

matplotlib.patches SourceModule

imports: collections • functools • inspect • math • matplotlib • matplotlib._api • matplotlib._docstring • matplotlib._enums • matplotlib.artist • matplotlib.bezier • matplotlib.cbook • matplotlib.colors • matplotlib.hatch • matplotlib.lines • matplotlib.path • matplotlib.patheffects • matplotlib.transforms • numbers • numpy • textwrap • types

imported by: matplotlib • matplotlib._layoutgrid • matplotlib.artist • matplotlib.axes._axes • matplotlib.axes._base • matplotlib.colorbar • matplotlib.contour • matplotlib.figure • matplotlib.inset • matplotlib.legend • matplotlib.legend_handler • matplotlib.offsetbox • matplotlib.patheffects • matplotlib.projections.geo • matplotlib.projections.polar • matplotlib.pyplot • matplotlib.quiver • matplotlib.spines • matplotlib.streamplot • matplotlib.table • matplotlib.text • matplotlib.widgets • mpl_toolkits.mplot3d.art3d • mpl_toolkits.mplot3d.axes3d • mpl_toolkits.mplot3d.axis3d • pandas.plotting._matplotlib.misc

matplotlib.path SourceModule

imports: copy • functools • matplotlib • matplotlib._api • matplotlib._path • matplotlib.bezier • matplotlib.cbook • matplotlib.hatch • matplotlib.transforms • numpy • weakref

imported by: matplotlib.artist • matplotlib.axes._axes • matplotlib.backend_bases • matplotlib.backends.backend_agg • matplotlib.bezier • matplotlib.collections • matplotlib.colorbar • matplotlib.contour • matplotlib.hatch • matplotlib.inset • matplotlib.lines • matplotlib.markers • matplotlib.offsetbox • matplotlib.patches • matplotlib.patheffects • matplotlib.projections.geo • matplotlib.projections.polar • matplotlib.spines • matplotlib.table • matplotlib.textpath • matplotlib.transforms • matplotlib.typing • mpl_toolkits.mplot3d.art3d

matplotlib.patheffects SourceModule

imports: matplotlib • matplotlib.backend_bases • matplotlib.colors • matplotlib.patches • matplotlib.path • matplotlib.transforms • numpy

imported by: matplotlib.collections • matplotlib.lines • matplotlib.patches • matplotlib.pyplot • matplotlib.text

matplotlib.projections Package

imports: matplotlib • matplotlib._docstring • matplotlib.axes • matplotlib.projections.geo • matplotlib.projections.polar • mpl_toolkits.mplot3d • warnings

imported by: matplotlib • matplotlib.figure • matplotlib.projections.geo • matplotlib.projections.polar • matplotlib.pyplot • matplotlib.text

matplotlib.projections.geo SourceModule

imports: matplotlib • matplotlib._api • matplotlib.axes • matplotlib.axis • matplotlib.patches • matplotlib.path • matplotlib.projections • matplotlib.spines • matplotlib.ticker • matplotlib.transforms • numpy

imported by: matplotlib.projections

matplotlib.projections.polar SourceModule

imports: math • matplotlib • matplotlib._api • matplotlib.axes • matplotlib.axis • matplotlib.cbook • matplotlib.markers • matplotlib.patches • matplotlib.path • matplotlib.projections • matplotlib.spines • matplotlib.ticker • matplotlib.transforms • numpy • types

imported by: matplotlib.projections

matplotlib.pylab SourceModule

imports: datetime • matplotlib • matplotlib.cbook • matplotlib.dates • matplotlib.mlab • matplotlib.pyplot • numpy • numpy.fft • numpy.linalg • numpy.ma • numpy.random

imported by: matplotlib • pandas.plotting._matplotlib.timeseries

matplotlib.pyplot SourceModule

imports: 'collections.abc' • PIL.Image • __future__ • contextlib • cycler • datetime • enum • functools • importlib • importlib.metadata • inspect • logging • matplotlib • matplotlib._api • matplotlib._docstring • matplotlib._pylab_helpers • matplotlib.artist • matplotlib.axes • matplotlib.axes._base • matplotlib.axis • matplotlib.backend_bases • matplotlib.backends • matplotlib.cbook • matplotlib.cm • matplotlib.collections • matplotlib.colorbar • matplotlib.colorizer • matplotlib.colors • matplotlib.container • matplotlib.contour • matplotlib.figure • matplotlib.gridspec • matplotlib.image • matplotlib.legend • matplotlib.lines • matplotlib.mlab • matplotlib.patches • matplotlib.patheffects • matplotlib.projections • matplotlib.quiver • matplotlib.rcsetup • matplotlib.scale • matplotlib.style • matplotlib.text • matplotlib.ticker • matplotlib.typing • matplotlib.widgets • numpy • numpy.typing • os • pathlib • sys • threading • time • typing • typing_extensions

imported by: matplotlib • matplotlib._enums • matplotlib.backends.backend_webagg_core • matplotlib.figure • matplotlib.image • matplotlib.pylab • pandas.io.formats.style • pandas.plotting._matplotlib • pandas.plotting._matplotlib.boxplot • pandas.plotting._matplotlib.core • pandas.plotting._matplotlib.hist • pandas.plotting._matplotlib.misc • pandas.plotting._matplotlib.style • pandas.plotting._matplotlib.tools

matplotlib.quiver SourceModule

imports: math • matplotlib • matplotlib._api • matplotlib._docstring • matplotlib.artist • matplotlib.cbook • matplotlib.collections • matplotlib.patches • matplotlib.text • matplotlib.transforms • numpy • numpy.ma

imported by: matplotlib.axes._axes • matplotlib.pyplot

matplotlib.rcsetup SourceModule

imports: ast • cycler • functools • matplotlib • matplotlib._api • matplotlib._enums • matplotlib._fontconfig_pattern • matplotlib.backends • matplotlib.cbook • matplotlib.colors • numbers • numpy • operator • os • re

imported by: matplotlib • matplotlib.axes._base • matplotlib.font_manager • matplotlib.pyplot

matplotlib.scale SourceModule

imports: inspect • matplotlib • matplotlib._api • matplotlib._docstring • matplotlib.ticker • matplotlib.transforms • numpy • textwrap

imported by: matplotlib • matplotlib.axis • matplotlib.colorizer • matplotlib.colors • matplotlib.pyplot

matplotlib.spines SourceModule

imports: 'collections.abc' • functools • matplotlib • matplotlib._api • matplotlib._docstring • matplotlib.artist • matplotlib.patches • matplotlib.path • matplotlib.transforms • numpy

imported by: matplotlib.axes._base • matplotlib.colorbar • matplotlib.projections.geo • matplotlib.projections.polar

matplotlib.stackplot SourceModule

imports: itertools • matplotlib • matplotlib._api • numpy

imported by: matplotlib.axes._axes

matplotlib.streamplot SourceModule

imports: matplotlib • matplotlib._api • matplotlib.cm • matplotlib.collections • matplotlib.colors • matplotlib.lines • matplotlib.patches • numpy

imported by: matplotlib.axes._axes

matplotlib.style Package

imports: matplotlib • matplotlib.style.core

imported by: matplotlib • matplotlib.pyplot • matplotlib.style.core

matplotlib.style.core SourceModule

imports: contextlib • importlib.resources • logging • matplotlib • matplotlib._api • matplotlib._docstring • matplotlib.style • os • pathlib • warnings

imported by: matplotlib • matplotlib.style

matplotlib.table SourceModule

imports: matplotlib • matplotlib._api • matplotlib._docstring • matplotlib.artist • matplotlib.cbook • matplotlib.patches • matplotlib.path • matplotlib.text • matplotlib.transforms • numpy

imported by: matplotlib.axes._axes • matplotlib.axes._base • pandas.plotting._matplotlib.tools • pandas.plotting._misc

matplotlib.texmanager SourceModule

imports: functools • hashlib • logging • matplotlib • matplotlib.cbook • matplotlib.dviread • numpy • os • pathlib • subprocess • tempfile

imported by: matplotlib.backend_bases • matplotlib.textpath

matplotlib.text SourceModule

imports: functools • logging • math • matplotlib • matplotlib._api • matplotlib._docstring • matplotlib.artist • matplotlib.cbook • matplotlib.font_manager • matplotlib.offsetbox • matplotlib.patches • matplotlib.patheffects • matplotlib.projections • matplotlib.textpath • matplotlib.transforms • numbers • numpy • weakref

imported by: matplotlib.axes._axes • matplotlib.axes._base • matplotlib.axis • matplotlib.backend_bases • matplotlib.contour • matplotlib.figure • matplotlib.legend • matplotlib.markers • matplotlib.offsetbox • matplotlib.pyplot • matplotlib.quiver • matplotlib.table • matplotlib.textpath • matplotlib.widgets • mpl_toolkits.mplot3d.art3d

matplotlib.textpath SourceModule

imports: collections • logging • matplotlib • matplotlib._text_helpers • matplotlib.dviread • matplotlib.font_manager • matplotlib.ft2font • matplotlib.mathtext • matplotlib.path • matplotlib.texmanager • matplotlib.text • matplotlib.transforms • numpy • urllib.parse

imported by: matplotlib.text

matplotlib.ticker SourceModule

imports: itertools • locale • logging • math • matplotlib • matplotlib._api • matplotlib.cbook • matplotlib.font_manager • matplotlib.transforms • numbers • numpy • string

imported by: matplotlib.axes._axes • matplotlib.axes._base • matplotlib.axes._secondary_axes • matplotlib.axis • matplotlib.category • matplotlib.colorbar • matplotlib.contour • matplotlib.dates • matplotlib.projections.geo • matplotlib.projections.polar • matplotlib.pyplot • matplotlib.scale • matplotlib.widgets • pandas.plotting._matplotlib.converter • pandas.plotting._matplotlib.core • pandas.plotting._matplotlib.tools

matplotlib.transforms SourceModule

imports: copy • functools • itertools • math • matplotlib • matplotlib._api • matplotlib._path • matplotlib.path • numpy • numpy.linalg • textwrap • weakref

imported by: matplotlib._constrained_layout • matplotlib._layoutgrid • matplotlib._path • matplotlib._tight_bbox • matplotlib._tight_layout • matplotlib.artist • matplotlib.axes._axes • matplotlib.axes._base • matplotlib.axes._secondary_axes • matplotlib.axis • matplotlib.backend_bases • matplotlib.backends.backend_agg • matplotlib.collections • matplotlib.colorbar • matplotlib.contour • matplotlib.figure • matplotlib.gridspec • matplotlib.image • matplotlib.inset • matplotlib.legend • matplotlib.lines • matplotlib.markers • matplotlib.offsetbox • matplotlib.patches • matplotlib.path • matplotlib.patheffects • matplotlib.projections.geo • matplotlib.projections.polar • matplotlib.quiver • matplotlib.scale • matplotlib.spines • matplotlib.table • matplotlib.text • matplotlib.textpath • matplotlib.ticker • matplotlib.typing • matplotlib.widgets • mpl_toolkits.mplot3d.axes3d • mpl_toolkits.mplot3d.axis3d • pandas.plotting._matplotlib.converter

matplotlib.tri Package

imports: matplotlib • matplotlib.tri._triangulation • matplotlib.tri._tricontour • matplotlib.tri._trifinder • matplotlib.tri._triinterpolate • matplotlib.tri._tripcolor • matplotlib.tri._triplot • matplotlib.tri._trirefine • matplotlib.tri._tritools

imported by: matplotlib.axes._axes • matplotlib.tri._triangulation • matplotlib.tri._tricontour • matplotlib.tri._trifinder • matplotlib.tri._triinterpolate • matplotlib.tri._tripcolor • matplotlib.tri._triplot • matplotlib.tri._trirefine • matplotlib.tri._tritools

matplotlib.tri._triangulation SourceModule

imports: matplotlib • matplotlib._api • matplotlib._qhull • matplotlib._tri • matplotlib.tri • matplotlib.tri._trifinder • numpy • sys

imported by: matplotlib.tri • matplotlib.tri._tricontour • matplotlib.tri._tripcolor • matplotlib.tri._triplot • matplotlib.tri._trirefine • mpl_toolkits.mplot3d.axes3d

matplotlib.tri._tricontour SourceModule

imports: matplotlib • matplotlib._docstring • matplotlib._tri • matplotlib.contour • matplotlib.tri • matplotlib.tri._triangulation • numpy

imported by: matplotlib.tri

matplotlib.tri._trifinder SourceModule

imports: matplotlib • matplotlib._api • matplotlib._tri • matplotlib.tri • numpy

imported by: matplotlib.tri • matplotlib.tri._triangulation • matplotlib.tri._triinterpolate

matplotlib.tri._triinterpolate SourceModule

imports: matplotlib • matplotlib._api • matplotlib.tri • matplotlib.tri._trifinder • matplotlib.tri._tritools • numpy

imported by: matplotlib.tri • matplotlib.tri._trirefine

matplotlib.tri._tripcolor SourceModule

imports: matplotlib • matplotlib._api • matplotlib._docstring • matplotlib.collections • matplotlib.tri • matplotlib.tri._triangulation • numpy

imported by: matplotlib.tri

matplotlib.tri._triplot SourceModule

imports: matplotlib.axes • matplotlib.cbook • matplotlib.lines • matplotlib.tri • matplotlib.tri._triangulation • numpy

imported by: matplotlib.tri

matplotlib.tri._trirefine SourceModule

imports: matplotlib • matplotlib._api • matplotlib.tri • matplotlib.tri._triangulation • matplotlib.tri._triinterpolate • numpy

imported by: matplotlib.tri

matplotlib.tri._tritools SourceModule

imports: matplotlib • matplotlib._api • matplotlib.tri • numpy

imported by: matplotlib.tri • matplotlib.tri._triinterpolate

matplotlib.typing SourceModule

imports: 'collections.abc' • matplotlib • matplotlib._enums • matplotlib.artist • matplotlib.backend_bases • matplotlib.markers • matplotlib.path • matplotlib.transforms • pathlib • typing

imported by: matplotlib.pyplot

matplotlib.units SourceModule

imports: decimal • matplotlib • matplotlib.cbook • numbers • numpy • numpy.ma

imported by: matplotlib.axes._axes • matplotlib.axis • matplotlib.category • matplotlib.dates • pandas.plotting._matplotlib.converter

matplotlib.widgets SourceModule

imports: contextlib • copy • cycler • itertools • matplotlib • matplotlib._api • matplotlib._docstring • matplotlib.backend_tools • matplotlib.cbook • matplotlib.collections • matplotlib.colors • matplotlib.lines • matplotlib.patches • matplotlib.text • matplotlib.ticker • matplotlib.transforms • numbers • numpy

imported by: matplotlib.backend_bases • matplotlib.backend_managers • matplotlib.pyplot

mimetypes SourceModule

imports: _winapi • getopt • os • posixpath • sys • urllib.parse • winreg

imported by: http.server • matplotlib.backends.backend_webagg • urllib.request

mmap (builtin module)

imported by: PIL.Image • PIL.ImageFile • PIL.PdfParser • multiprocessing.heap • multiprocessing.shared_memory • numpy._core.memmap • pandas.io.common • pandas.io.excel._openpyxl

modin MissingModule

imported by: narwhals.dependencies

more_itertools AliasNode

imports: setuptools._vendor.more_itertools

imported by: setuptools._distutils.compilers.C.base • setuptools._entry_points • setuptools._itertools • setuptools._path • setuptools._vendor.jaraco.functools • setuptools.config.expand • setuptools.config.pyprojecttoml • setuptools.dist • setuptools.msvc

mpl_toolkits NamespacePackage

imported by: mpl_toolkits.mplot3d

mpl_toolkits.mplot3d Package

imports: mpl_toolkits • mpl_toolkits.mplot3d • mpl_toolkits.mplot3d.art3d • mpl_toolkits.mplot3d.axes3d • mpl_toolkits.mplot3d.axis3d • mpl_toolkits.mplot3d.proj3d

imported by: matplotlib.projections • mpl_toolkits.mplot3d • mpl_toolkits.mplot3d.art3d • mpl_toolkits.mplot3d.axes3d • mpl_toolkits.mplot3d.axis3d • mpl_toolkits.mplot3d.proj3d

mpl_toolkits.mplot3d.art3d SourceModule

imports: contextlib • math • matplotlib • matplotlib._api • matplotlib.artist • matplotlib.cbook • matplotlib.collections • matplotlib.colors • matplotlib.lines • matplotlib.patches • matplotlib.path • matplotlib.text • mpl_toolkits.mplot3d • mpl_toolkits.mplot3d.proj3d • numpy

imported by: mpl_toolkits.mplot3d • mpl_toolkits.mplot3d.axes3d • mpl_toolkits.mplot3d.axis3d

mpl_toolkits.mplot3d.axes3d SourceModule

imports: collections • itertools • math • matplotlib • matplotlib._api • matplotlib._docstring • matplotlib.artist • matplotlib.axes • matplotlib.axes._base • matplotlib.cbook • matplotlib.collections • matplotlib.colors • matplotlib.container • matplotlib.image • matplotlib.lines • matplotlib.patches • matplotlib.transforms • matplotlib.tri._triangulation • mpl_toolkits.mplot3d • mpl_toolkits.mplot3d.art3d • mpl_toolkits.mplot3d.axis3d • mpl_toolkits.mplot3d.proj3d • numpy • textwrap • warnings

imported by: mpl_toolkits.mplot3d

mpl_toolkits.mplot3d.axis3d SourceModule

imports: inspect • matplotlib • matplotlib._api • matplotlib.artist • matplotlib.axis • matplotlib.colors • matplotlib.lines • matplotlib.patches • matplotlib.transforms • mpl_toolkits.mplot3d • mpl_toolkits.mplot3d.art3d • mpl_toolkits.mplot3d.proj3d • numpy

imported by: mpl_toolkits.mplot3d • mpl_toolkits.mplot3d.axes3d

mpl_toolkits.mplot3d.proj3d SourceModule

imports: matplotlib • matplotlib._api • mpl_toolkits.mplot3d • numpy

imported by: mpl_toolkits.mplot3d • mpl_toolkits.mplot3d.art3d • mpl_toolkits.mplot3d.axes3d • mpl_toolkits.mplot3d.axis3d

msvcrt (builtin module)

imported by: _plotly_utils.png • _pyrepl.windows_console • asyncio.windows_events • asyncio.windows_utils • colorama.winterm • getpass • multiprocessing.popen_spawn_win32 • multiprocessing.spawn • subprocess

multiprocessing Package

imports: multiprocessing • multiprocessing.AuthenticationError • multiprocessing.BufferTooShort • multiprocessing.TimeoutError • multiprocessing.connection • multiprocessing.context • multiprocessing.forkserver • multiprocessing.get_context • multiprocessing.get_start_method • multiprocessing.pool • multiprocessing.process • multiprocessing.reduction • multiprocessing.resource_sharer • multiprocessing.resource_tracker • multiprocessing.set_start_method • multiprocessing.shared_memory • multiprocessing.spawn • multiprocessing.util • sys

imported by: concurrent.futures.process • multiprocessing • multiprocessing.connection • multiprocessing.context • multiprocessing.dummy • multiprocessing.forkserver • multiprocessing.heap • multiprocessing.managers • multiprocessing.pool • multiprocessing.popen_fork • multiprocessing.popen_forkserver • multiprocessing.popen_spawn_posix • multiprocessing.popen_spawn_win32 • multiprocessing.process • multiprocessing.queues • multiprocessing.reduction • multiprocessing.resource_sharer • multiprocessing.resource_tracker • multiprocessing.shared_memory • multiprocessing.sharedctypes • multiprocessing.spawn • multiprocessing.synchronize • multiprocessing.util • pyi_rth_multiprocessing.py

multiprocessing.AuthenticationError MissingModule

imported by: multiprocessing • multiprocessing.connection

multiprocessing.BufferTooShort MissingModule

imported by: multiprocessing • multiprocessing.connection

multiprocessing.TimeoutError MissingModule

imported by: multiprocessing • multiprocessing.pool

multiprocessing.connection SourceModule

imports: _multiprocessing • _winapi • errno • hmac • io • itertools • multiprocessing • multiprocessing.AuthenticationError • multiprocessing.BufferTooShort • multiprocessing.context • multiprocessing.resource_sharer • multiprocessing.util • os • selectors • socket • struct • sys • tempfile • time • xmlrpc.client

imported by: concurrent.futures.process • multiprocessing • multiprocessing.context • multiprocessing.forkserver • multiprocessing.managers • multiprocessing.pool • multiprocessing.popen_fork • multiprocessing.popen_forkserver • multiprocessing.process • multiprocessing.queues • multiprocessing.resource_sharer

multiprocessing.context SourceModule

imports: multiprocessing • multiprocessing.connection • multiprocessing.forkserver • multiprocessing.managers • multiprocessing.pool • multiprocessing.popen_fork • multiprocessing.popen_forkserver • multiprocessing.popen_spawn_posix • multiprocessing.popen_spawn_win32 • multiprocessing.process • multiprocessing.queues • multiprocessing.reduction • multiprocessing.sharedctypes • multiprocessing.spawn • multiprocessing.synchronize • multiprocessing.util • os • sys • threading

imported by: multiprocessing • multiprocessing.connection • multiprocessing.forkserver • multiprocessing.heap • multiprocessing.managers • multiprocessing.popen_forkserver • multiprocessing.popen_spawn_posix • multiprocessing.popen_spawn_win32 • multiprocessing.process • multiprocessing.queues • multiprocessing.reduction • multiprocessing.resource_sharer • multiprocessing.sharedctypes • multiprocessing.spawn • multiprocessing.synchronize

multiprocessing.dummy Package

imports: array • multiprocessing • multiprocessing.dummy.connection • multiprocessing.pool • queue • sys • threading • weakref

imported by: multiprocessing.dummy.connection • multiprocessing.pool

multiprocessing.dummy.connection SourceModule

imports: multiprocessing.dummy • queue

imported by: multiprocessing.dummy

multiprocessing.forkserver SourceModule

imports: atexit • errno • multiprocessing • multiprocessing.connection • multiprocessing.context • multiprocessing.process • multiprocessing.resource_tracker • multiprocessing.spawn • multiprocessing.util • os • selectors • signal • socket • struct • sys • threading • warnings

imported by: multiprocessing • multiprocessing.context • multiprocessing.popen_forkserver • multiprocessing.util

multiprocessing.get_context MissingModule

imported by: multiprocessing • multiprocessing.managers • multiprocessing.pool • multiprocessing.sharedctypes

multiprocessing.get_start_method MissingModule

imported by: multiprocessing • multiprocessing.spawn

multiprocessing.heap SourceModule

imports: _winapi • bisect • collections • mmap • multiprocessing • multiprocessing.context • multiprocessing.util • os • sys • tempfile • threading

imported by: multiprocessing.sharedctypes • multiprocessing.synchronize

multiprocessing.managers SourceModule

imports: array • multiprocessing • multiprocessing.connection • multiprocessing.context • multiprocessing.get_context • multiprocessing.pool • multiprocessing.process • multiprocessing.resource_tracker • multiprocessing.shared_memory • multiprocessing.util • os • queue • signal • sys • threading • time • traceback • types

imported by: multiprocessing.context

multiprocessing.pool SourceModule

imports: collections • itertools • multiprocessing • multiprocessing.TimeoutError • multiprocessing.connection • multiprocessing.dummy • multiprocessing.get_context • multiprocessing.util • os • queue • threading • time • traceback • types • warnings

imported by: multiprocessing • multiprocessing.context • multiprocessing.dummy • multiprocessing.managers

multiprocessing.popen_fork SourceModule

imports: atexit • multiprocessing • multiprocessing.connection • multiprocessing.util • os • signal

imported by: multiprocessing.context • multiprocessing.popen_forkserver • multiprocessing.popen_spawn_posix

multiprocessing.popen_forkserver SourceModule

imports: io • multiprocessing • multiprocessing.connection • multiprocessing.context • multiprocessing.forkserver • multiprocessing.popen_fork • multiprocessing.spawn • multiprocessing.util • os

imported by: multiprocessing.context

multiprocessing.popen_spawn_posix SourceModule

imports: io • multiprocessing • multiprocessing.context • multiprocessing.popen_fork • multiprocessing.resource_tracker • multiprocessing.spawn • multiprocessing.util • os

imported by: multiprocessing.context

multiprocessing.popen_spawn_win32 SourceModule

imports: _winapi • msvcrt • multiprocessing • multiprocessing.context • multiprocessing.spawn • multiprocessing.util • os • signal • subprocess • sys

imported by: multiprocessing.context

multiprocessing.process SourceModule

imports: _weakrefset • itertools • multiprocessing • multiprocessing.connection • multiprocessing.context • multiprocessing.util • os • signal • sys • threading • traceback

imported by: multiprocessing • multiprocessing.context • multiprocessing.forkserver • multiprocessing.managers • multiprocessing.resource_sharer • multiprocessing.spawn • multiprocessing.synchronize • multiprocessing.util

multiprocessing.queues SourceModule

imports: collections • errno • multiprocessing • multiprocessing.connection • multiprocessing.context • multiprocessing.synchronize • multiprocessing.util • os • queue • sys • threading • time • traceback • types • weakref

imported by: concurrent.futures.process • multiprocessing.context

multiprocessing.reduction SourceModule

imports: _winapi • abc • array • copyreg • functools • io • multiprocessing • multiprocessing.context • multiprocessing.resource_sharer • os • pickle • socket • sys

imported by: multiprocessing • multiprocessing.context

multiprocessing.resource_sharer SourceModule

imports: multiprocessing • multiprocessing.connection • multiprocessing.context • multiprocessing.process • multiprocessing.util • os • signal • socket • sys • threading

imported by: multiprocessing • multiprocessing.connection • multiprocessing.reduction

multiprocessing.resource_tracker SourceModule

imports: _multiprocessing • _posixshmem • multiprocessing • multiprocessing.spawn • multiprocessing.util • os • signal • sys • threading • warnings

imported by: multiprocessing • multiprocessing.forkserver • multiprocessing.managers • multiprocessing.popen_spawn_posix • multiprocessing.shared_memory • multiprocessing.spawn • multiprocessing.synchronize • multiprocessing.util

multiprocessing.set_start_method MissingModule

imported by: multiprocessing • multiprocessing.spawn

multiprocessing.shared_memory SourceModule

imports: _posixshmem • _winapi • errno • functools • mmap • multiprocessing • multiprocessing.resource_tracker • os • secrets • struct • types

imported by: multiprocessing • multiprocessing.managers

multiprocessing.sharedctypes SourceModule

imports: ctypes • multiprocessing • multiprocessing.context • multiprocessing.get_context • multiprocessing.heap • weakref

imported by: multiprocessing.context

multiprocessing.spawn SourceModule

imports: _winapi • msvcrt • multiprocessing • multiprocessing.context • multiprocessing.get_start_method • multiprocessing.process • multiprocessing.resource_tracker • multiprocessing.set_start_method • multiprocessing.util • os • runpy • sys • types

imported by: multiprocessing • multiprocessing.context • multiprocessing.forkserver • multiprocessing.popen_forkserver • multiprocessing.popen_spawn_posix • multiprocessing.popen_spawn_win32 • multiprocessing.resource_tracker • pyi_rth_multiprocessing.py

multiprocessing.synchronize SourceModule

imports: _multiprocessing • multiprocessing • multiprocessing.context • multiprocessing.heap • multiprocessing.process • multiprocessing.resource_tracker • multiprocessing.util • struct • sys • tempfile • threading • time

imported by: concurrent.futures.process • multiprocessing.context • multiprocessing.queues

multiprocessing.util SourceModule

imports: _posixsubprocess • atexit • itertools • logging • multiprocessing • multiprocessing.forkserver • multiprocessing.process • multiprocessing.resource_tracker • os • shutil • subprocess • sys • tempfile • threading • traceback • weakref

imported by: multiprocessing • multiprocessing.connection • multiprocessing.context • multiprocessing.forkserver • multiprocessing.heap • multiprocessing.managers • multiprocessing.pool • multiprocessing.popen_fork • multiprocessing.popen_forkserver • multiprocessing.popen_spawn_posix • multiprocessing.popen_spawn_win32 • multiprocessing.process • multiprocessing.queues • multiprocessing.resource_sharer • multiprocessing.resource_tracker • multiprocessing.spawn • multiprocessing.synchronize

narwhals Package

imports: __future__ • importlib • importlib.metadata • narwhals • narwhals._utils • narwhals.dataframe • narwhals.dependencies • narwhals.dtypes • narwhals.exceptions • narwhals.expr • narwhals.functions • narwhals.schema • narwhals.selectors • narwhals.series • narwhals.translate • typing

imported by: narwhals • narwhals._arrow • narwhals._compliant • narwhals._dask • narwhals._duckdb • narwhals._duration • narwhals._enum • narwhals._expression_parsing • narwhals._ibis • narwhals._interchange • narwhals._namespace • narwhals._pandas_like • narwhals._polars • narwhals._spark_like • narwhals._translate • narwhals._typing_compat • narwhals._utils • narwhals.dataframe • narwhals.dependencies • narwhals.dtypes • narwhals.exceptions • narwhals.expr • narwhals.expr_cat • narwhals.expr_dt • narwhals.expr_list • narwhals.expr_name • narwhals.expr_str • narwhals.expr_struct • narwhals.functions • narwhals.group_by • narwhals.schema • narwhals.selectors • narwhals.series • narwhals.series_cat • narwhals.series_dt • narwhals.series_list • narwhals.series_str • narwhals.series_struct • narwhals.stable • narwhals.stable.v1 • narwhals.translate • narwhals.typing • narwhals.utils

narwhals._arrow Package

imports: narwhals

imported by: narwhals._arrow.dataframe • narwhals._arrow.expr • narwhals._arrow.group_by • narwhals._arrow.namespace • narwhals._arrow.selectors • narwhals._arrow.series • narwhals._arrow.series_cat • narwhals._arrow.series_dt • narwhals._arrow.series_list • narwhals._arrow.series_str • narwhals._arrow.series_struct • narwhals._arrow.typing • narwhals._arrow.utils

narwhals._arrow.dataframe SourceModule

imports: 'collections.abc' • 'dask.dataframe' • 'pyarrow.compute' • 'pyarrow.csv' • 'pyarrow.parquet' • __future__ • dask • duckdb • functools • io • narwhals._arrow • narwhals._arrow.dataframe • narwhals._arrow.expr • narwhals._arrow.group_by • narwhals._arrow.namespace • narwhals._arrow.series • narwhals._arrow.typing • narwhals._arrow.utils • narwhals._compliant • narwhals._compliant.typing • narwhals._dask.dataframe • narwhals._duckdb.dataframe • narwhals._expression_parsing • narwhals._pandas_like.dataframe • narwhals._polars.dataframe • narwhals._translate • narwhals._utils • narwhals.dependencies • narwhals.dtypes • narwhals.exceptions • narwhals.schema • narwhals.typing • numpy • pandas • pathlib • polars • pyarrow • types • typing • typing_extensions

imported by: narwhals._arrow.dataframe • narwhals._arrow.expr • narwhals._arrow.group_by • narwhals._arrow.namespace • narwhals._arrow.selectors • narwhals._arrow.series • narwhals._dask.dataframe • narwhals._duckdb.dataframe • narwhals._ibis.dataframe • narwhals._pandas_like.dataframe • narwhals._polars.dataframe • narwhals._spark_like.dataframe

narwhals._arrow.expr SourceModule

imports: 'collections.abc' • 'pyarrow.compute' • __future__ • narwhals._arrow • narwhals._arrow.dataframe • narwhals._arrow.namespace • narwhals._arrow.series • narwhals._compliant • narwhals._compliant.typing • narwhals._expression_parsing • narwhals._utils • narwhals.typing • typing • typing_extensions

imported by: narwhals._arrow.dataframe • narwhals._arrow.group_by • narwhals._arrow.namespace • narwhals._arrow.selectors • narwhals._arrow.typing

narwhals._arrow.group_by SourceModule

imports: 'collections.abc' • 'pyarrow.compute' • __future__ • collections • narwhals._arrow • narwhals._arrow.dataframe • narwhals._arrow.expr • narwhals._arrow.typing • narwhals._arrow.utils • narwhals._compliant • narwhals._compliant.group_by • narwhals._expression_parsing • narwhals._utils • narwhals.typing • pyarrow • typing

imported by: narwhals._arrow.dataframe

narwhals._arrow.namespace SourceModule

imports: 'collections.abc' • 'pyarrow.compute' • __future__ • functools • itertools • narwhals._arrow • narwhals._arrow.dataframe • narwhals._arrow.expr • narwhals._arrow.selectors • narwhals._arrow.series • narwhals._arrow.typing • narwhals._arrow.utils • narwhals._compliant • narwhals._expression_parsing • narwhals._utils • narwhals.typing • operator • pyarrow • typing

imported by: narwhals._arrow.dataframe • narwhals._arrow.expr • narwhals._arrow.series • narwhals._namespace • narwhals._utils

narwhals._arrow.selectors SourceModule

imports: __future__ • narwhals._arrow • narwhals._arrow.dataframe • narwhals._arrow.expr • narwhals._arrow.series • narwhals._compliant • typing

imported by: narwhals._arrow.namespace

narwhals._arrow.series SourceModule

imports: 'collections.abc' • 'pyarrow.compute' • __future__ • narwhals._arrow • narwhals._arrow.dataframe • narwhals._arrow.namespace • narwhals._arrow.series_cat • narwhals._arrow.series_dt • narwhals._arrow.series_list • narwhals._arrow.series_str • narwhals._arrow.series_struct • narwhals._arrow.typing • narwhals._arrow.utils • narwhals._compliant • narwhals._expression_parsing • narwhals._utils • narwhals.dependencies • narwhals.dtypes • narwhals.exceptions • narwhals.typing • numpy • pandas • polars • pyarrow • types • typing • typing_extensions

imported by: narwhals._arrow.dataframe • narwhals._arrow.expr • narwhals._arrow.namespace • narwhals._arrow.selectors • narwhals._arrow.series_cat • narwhals._arrow.series_dt • narwhals._arrow.series_list • narwhals._arrow.series_str • narwhals._arrow.series_struct • narwhals._arrow.typing • narwhals._arrow.utils

narwhals._arrow.series_cat SourceModule

imports: __future__ • narwhals._arrow • narwhals._arrow.series • narwhals._arrow.typing • narwhals._arrow.utils • pyarrow • typing

imported by: narwhals._arrow.series

narwhals._arrow.series_dt SourceModule

imports: 'collections.abc' • 'pyarrow.compute' • __future__ • narwhals._arrow • narwhals._arrow.series • narwhals._arrow.typing • narwhals._arrow.utils • narwhals._duration • narwhals.dtypes • narwhals.typing • pyarrow • typing • typing_extensions

imported by: narwhals._arrow.series

narwhals._arrow.series_list SourceModule

imports: 'pyarrow.compute' • __future__ • narwhals._arrow • narwhals._arrow.series • narwhals._arrow.utils • pyarrow • typing

imported by: narwhals._arrow.series

narwhals._arrow.series_str SourceModule

imports: 'pyarrow.compute' • __future__ • narwhals._arrow • narwhals._arrow.series • narwhals._arrow.typing • narwhals._arrow.utils • pyarrow • string • typing

imported by: narwhals._arrow.series

narwhals._arrow.series_struct SourceModule

imports: 'pyarrow.compute' • __future__ • narwhals._arrow • narwhals._arrow.series • narwhals._arrow.utils • typing

imported by: narwhals._arrow.series

narwhals._arrow.typing SourceModule

imports: 'pyarrow.__lib_pxi' • 'pyarrow._stubs_typing' • __future__ • narwhals._arrow • narwhals._arrow.expr • narwhals._arrow.series • pyarrow • sys • typing • typing_extensions

imported by: narwhals._arrow.dataframe • narwhals._arrow.group_by • narwhals._arrow.namespace • narwhals._arrow.series • narwhals._arrow.series_cat • narwhals._arrow.series_dt • narwhals._arrow.series_str • narwhals._arrow.utils • narwhals._pandas_like.series

narwhals._arrow.utils SourceModule

imports: 'collections.abc' • 'pyarrow.compute' • 'pyarrow.types' • __future__ • functools • narwhals._arrow • narwhals._arrow.series • narwhals._arrow.typing • narwhals._compliant.series • narwhals._duration • narwhals._utils • narwhals.dtypes • narwhals.typing • pyarrow • typing • typing_extensions

imported by: narwhals._arrow.dataframe • narwhals._arrow.group_by • narwhals._arrow.namespace • narwhals._arrow.series • narwhals._arrow.series_cat • narwhals._arrow.series_dt • narwhals._arrow.series_list • narwhals._arrow.series_str • narwhals._arrow.series_struct • narwhals._pandas_like.series • narwhals._pandas_like.series_dt • narwhals._pandas_like.utils • narwhals._spark_like.dataframe • narwhals._utils • narwhals.schema • narwhals.series

narwhals._compliant Package

imports: __future__ • narwhals • narwhals._compliant.dataframe • narwhals._compliant.expr • narwhals._compliant.group_by • narwhals._compliant.namespace • narwhals._compliant.selectors • narwhals._compliant.series • narwhals._compliant.typing • narwhals._compliant.when_then

imported by: narwhals._arrow.dataframe • narwhals._arrow.expr • narwhals._arrow.group_by • narwhals._arrow.namespace • narwhals._arrow.selectors • narwhals._arrow.series • narwhals._compliant.any_namespace • narwhals._compliant.dataframe • narwhals._compliant.expr • narwhals._compliant.group_by • narwhals._compliant.namespace • narwhals._compliant.selectors • narwhals._compliant.series • narwhals._compliant.typing • narwhals._compliant.when_then • narwhals._compliant.window • narwhals._dask.expr • narwhals._dask.group_by • narwhals._dask.namespace • narwhals._dask.selectors • narwhals._duckdb.expr • narwhals._duckdb.group_by • narwhals._duckdb.namespace • narwhals._duckdb.selectors • narwhals._expression_parsing • narwhals._ibis.expr • narwhals._ibis.group_by • narwhals._ibis.namespace • narwhals._ibis.selectors • narwhals._pandas_like.dataframe • narwhals._pandas_like.expr • narwhals._pandas_like.group_by • narwhals._pandas_like.namespace • narwhals._pandas_like.selectors • narwhals._pandas_like.series • narwhals._polars.namespace • narwhals._spark_like.expr • narwhals._spark_like.group_by • narwhals._spark_like.namespace • narwhals._spark_like.selectors • narwhals._utils • narwhals.dataframe • narwhals.expr • narwhals.functions • narwhals.series • narwhals.typing

narwhals._compliant.any_namespace SourceModule

imports: __future__ • narwhals._compliant • narwhals._utils • narwhals.typing • typing

imported by: narwhals._compliant.expr • narwhals._compliant.series • narwhals._pandas_like.series_cat • narwhals._pandas_like.series_dt • narwhals._pandas_like.series_list • narwhals._pandas_like.series_str • narwhals._pandas_like.series_struct

narwhals._compliant.dataframe SourceModule

imports: 'collections.abc' • __future__ • io • itertools • narwhals._compliant • narwhals._compliant.expr • narwhals._compliant.group_by • narwhals._compliant.namespace • narwhals._compliant.typing • narwhals._compliant.window • narwhals._translate • narwhals._typing_compat • narwhals._utils • narwhals.dataframe • narwhals.dtypes • narwhals.exceptions • narwhals.schema • narwhals.typing • pandas • pathlib • polars • pyarrow • typing • typing_extensions

imported by: narwhals._compliant • narwhals._compliant.series • narwhals._compliant.typing

narwhals._compliant.expr SourceModule

imports: 'collections.abc' • __future__ • functools • narwhals._compliant • narwhals._compliant.any_namespace • narwhals._compliant.namespace • narwhals._compliant.series • narwhals._compliant.typing • narwhals._expression_parsing • narwhals._typing_compat • narwhals._utils • narwhals.dependencies • narwhals.typing • operator • typing • typing_extensions

imported by: narwhals._compliant • narwhals._compliant.dataframe • narwhals._compliant.selectors • narwhals._compliant.series • narwhals._compliant.typing • narwhals._compliant.when_then • narwhals._dask.expr

narwhals._compliant.group_by SourceModule

imports: 'collections.abc' • __future__ • narwhals._compliant • narwhals._compliant.typing • narwhals._typing_compat • narwhals._utils • re • typing • typing_extensions

imported by: narwhals._arrow.group_by • narwhals._compliant • narwhals._compliant.dataframe • narwhals._dask.group_by • narwhals._pandas_like.group_by

narwhals._compliant.namespace SourceModule

imports: 'collections.abc' • __future__ • functools • narwhals._compliant • narwhals._compliant.selectors • narwhals._compliant.typing • narwhals._compliant.when_then • narwhals._utils • narwhals.dependencies • narwhals.dtypes • narwhals.schema • narwhals.typing • typing • typing_extensions

imported by: narwhals._compliant • narwhals._compliant.dataframe • narwhals._compliant.expr • narwhals._compliant.series • narwhals._compliant.typing • narwhals._dask.namespace

narwhals._compliant.selectors SourceModule

imports: 'collections.abc' • __future__ • datetime • functools • narwhals._compliant • narwhals._compliant.expr • narwhals._compliant.typing • narwhals._typing_compat • narwhals._utils • narwhals.dtypes • narwhals.typing • re • typing • typing_extensions

imported by: narwhals._compliant • narwhals._compliant.namespace

narwhals._compliant.series SourceModule

imports: 'collections.abc' • __future__ • narwhals._compliant • narwhals._compliant.any_namespace • narwhals._compliant.dataframe • narwhals._compliant.expr • narwhals._compliant.namespace • narwhals._compliant.typing • narwhals._translate • narwhals._utils • narwhals.dtypes • narwhals.series • narwhals.typing • pandas • polars • pyarrow • types • typing • typing_extensions

imported by: narwhals._arrow.utils • narwhals._compliant • narwhals._compliant.expr • narwhals._compliant.typing • narwhals._pandas_like.utils

narwhals._compliant.typing SourceModule

imports: 'collections.abc' • __future__ • narwhals._compliant • narwhals._compliant.dataframe • narwhals._compliant.expr • narwhals._compliant.namespace • narwhals._compliant.series • narwhals._compliant.window • narwhals.typing • typing • typing_extensions

imported by: narwhals._arrow.dataframe • narwhals._arrow.expr • narwhals._compliant • narwhals._compliant.dataframe • narwhals._compliant.expr • narwhals._compliant.group_by • narwhals._compliant.namespace • narwhals._compliant.selectors • narwhals._compliant.series • narwhals._compliant.when_then • narwhals._compliant.window • narwhals._dask.dataframe • narwhals._dask.expr • narwhals._duckdb.dataframe • narwhals._duckdb.expr • narwhals._expression_parsing • narwhals._ibis.dataframe • narwhals._ibis.expr • narwhals._namespace • narwhals._pandas_like.dataframe • narwhals._pandas_like.expr • narwhals._polars.dataframe • narwhals._spark_like.dataframe • narwhals._spark_like.expr • narwhals._utils • narwhals.dataframe • narwhals.group_by • narwhals.stable.v1._namespace

narwhals._compliant.when_then SourceModule

imports: 'collections.abc' • __future__ • narwhals._compliant • narwhals._compliant.expr • narwhals._compliant.typing • narwhals._compliant.window • narwhals._typing_compat • narwhals._utils • narwhals.typing • typing • typing_extensions

imported by: narwhals._compliant • narwhals._compliant.namespace

narwhals._compliant.window SourceModule

imports: 'collections.abc' • __future__ • narwhals._compliant • narwhals._compliant.typing • typing

imported by: narwhals._compliant.dataframe • narwhals._compliant.typing • narwhals._compliant.when_then • narwhals._duckdb.expr • narwhals._ibis.expr • narwhals._spark_like.expr

narwhals._dask Package

imports: narwhals

imported by: narwhals._dask.dataframe • narwhals._dask.expr • narwhals._dask.expr_dt • narwhals._dask.expr_str • narwhals._dask.group_by • narwhals._dask.namespace • narwhals._dask.selectors • narwhals._dask.utils

narwhals._dask.dataframe SourceModule

imports: 'collections.abc' • 'dask.dataframe' • __future__ • narwhals._arrow.dataframe • narwhals._compliant.typing • narwhals._dask • narwhals._dask.expr • narwhals._dask.group_by • narwhals._dask.namespace • narwhals._dask.utils • narwhals._pandas_like.dataframe • narwhals._pandas_like.utils • narwhals._polars.dataframe • narwhals._utils • narwhals.dataframe • narwhals.dtypes • narwhals.typing • pandas • polars • pyarrow • types • typing • typing_extensions

imported by: narwhals._arrow.dataframe • narwhals._dask.expr • narwhals._dask.group_by • narwhals._dask.namespace • narwhals._dask.selectors • narwhals._dask.utils • narwhals._pandas_like.dataframe • narwhals._polars.dataframe

narwhals._dask.expr SourceModule

imports: 'collections.abc' • 'dask.array' • 'dask.dataframe' • __future__ • narwhals._compliant • narwhals._compliant.expr • narwhals._compliant.typing • narwhals._dask • narwhals._dask.dataframe • narwhals._dask.expr_dt • narwhals._dask.expr_str • narwhals._dask.namespace • narwhals._dask.utils • narwhals._expression_parsing • narwhals._pandas_like.group_by • narwhals._pandas_like.utils • narwhals._utils • narwhals.exceptions • narwhals.typing • typing • typing_extensions • warnings

imported by: narwhals._dask.dataframe • narwhals._dask.expr_dt • narwhals._dask.expr_str • narwhals._dask.group_by • narwhals._dask.namespace • narwhals._dask.selectors • narwhals._dask.utils

narwhals._dask.expr_dt SourceModule

imports: 'dask.dataframe' • __future__ • narwhals._dask • narwhals._dask.expr • narwhals._duration • narwhals._pandas_like.utils • narwhals._utils • narwhals.typing • typing

imported by: narwhals._dask.expr

narwhals._dask.expr_str SourceModule

imports: 'dask.dataframe' • __future__ • narwhals._dask • narwhals._dask.expr • typing

imported by: narwhals._dask.expr

narwhals._dask.group_by SourceModule

imports: 'collections.abc' • 'dask.dataframe' • __future__ • dask_expr • functools • narwhals._compliant • narwhals._compliant.group_by • narwhals._dask • narwhals._dask.dataframe • narwhals._dask.expr • narwhals._expression_parsing • pandas • pandas.core.groupby • typing • typing_extensions

imported by: narwhals._dask.dataframe

narwhals._dask.namespace SourceModule

imports: 'collections.abc' • 'dask.dataframe' • __future__ • functools • narwhals._compliant • narwhals._compliant.namespace • narwhals._dask • narwhals._dask.dataframe • narwhals._dask.expr • narwhals._dask.selectors • narwhals._dask.utils • narwhals._expression_parsing • narwhals._utils • narwhals.typing • operator • pandas • typing

imported by: narwhals._dask.dataframe • narwhals._dask.expr • narwhals._namespace • narwhals.translate

narwhals._dask.selectors SourceModule

imports: 'dask.dataframe' • __future__ • narwhals._compliant • narwhals._dask • narwhals._dask.dataframe • narwhals._dask.expr • typing

imported by: narwhals._dask.namespace

narwhals._dask.utils SourceModule

imports: 'collections.abc' • 'dask.dataframe' • __future__ • dask_expr • narwhals._dask • narwhals._dask.dataframe • narwhals._dask.expr • narwhals._pandas_like.utils • narwhals._utils • narwhals.dependencies • narwhals.typing • pandas • typing

imported by: narwhals._dask.dataframe • narwhals._dask.expr • narwhals._dask.namespace

narwhals._duckdb Package

imports: narwhals

imported by: narwhals._duckdb.dataframe • narwhals._duckdb.expr • narwhals._duckdb.expr_dt • narwhals._duckdb.expr_list • narwhals._duckdb.expr_str • narwhals._duckdb.expr_struct • narwhals._duckdb.group_by • narwhals._duckdb.namespace • narwhals._duckdb.selectors • narwhals._duckdb.series • narwhals._duckdb.utils

narwhals._duckdb.dataframe SourceModule

imports: 'collections.abc' • 'duckdb.typing' • __future__ • contextlib • duckdb • functools • narwhals._arrow.dataframe • narwhals._compliant.typing • narwhals._duckdb • narwhals._duckdb.expr • narwhals._duckdb.group_by • narwhals._duckdb.namespace • narwhals._duckdb.series • narwhals._duckdb.utils • narwhals._pandas_like.dataframe • narwhals._polars.dataframe • narwhals._utils • narwhals.dataframe • narwhals.dependencies • narwhals.dtypes • narwhals.exceptions • narwhals.stable.v1 • narwhals.typing • operator • pandas • polars • pyarrow • types • typing • typing_extensions

imported by: narwhals._arrow.dataframe • narwhals._duckdb.expr • narwhals._duckdb.expr_dt • narwhals._duckdb.group_by • narwhals._duckdb.namespace • narwhals._duckdb.selectors • narwhals._duckdb.utils • narwhals._pandas_like.dataframe • narwhals._polars.dataframe

narwhals._duckdb.expr SourceModule

imports: 'collections.abc' • 'duckdb.typing' • __future__ • contextlib • duckdb • narwhals._compliant • narwhals._compliant.typing • narwhals._compliant.window • narwhals._duckdb • narwhals._duckdb.dataframe • narwhals._duckdb.expr_dt • narwhals._duckdb.expr_list • narwhals._duckdb.expr_str • narwhals._duckdb.expr_struct • narwhals._duckdb.namespace • narwhals._duckdb.utils • narwhals._expression_parsing • narwhals._utils • narwhals.typing • operator • typing • typing_extensions

imported by: narwhals._duckdb.dataframe • narwhals._duckdb.expr_dt • narwhals._duckdb.expr_list • narwhals._duckdb.expr_str • narwhals._duckdb.expr_struct • narwhals._duckdb.group_by • narwhals._duckdb.namespace • narwhals._duckdb.selectors • narwhals._duckdb.utils

narwhals._duckdb.expr_dt SourceModule

imports: 'collections.abc' • __future__ • duckdb • narwhals._duckdb • narwhals._duckdb.dataframe • narwhals._duckdb.expr • narwhals._duckdb.utils • narwhals._duration • narwhals._utils • typing

imported by: narwhals._duckdb.expr

narwhals._duckdb.expr_list SourceModule

imports: __future__ • duckdb • narwhals._duckdb • narwhals._duckdb.expr • typing

imported by: narwhals._duckdb.expr

narwhals._duckdb.expr_str SourceModule

imports: __future__ • duckdb • narwhals._duckdb • narwhals._duckdb.expr • narwhals._duckdb.utils • narwhals._utils • string • typing

imported by: narwhals._duckdb.expr

narwhals._duckdb.expr_struct SourceModule

imports: __future__ • duckdb • narwhals._duckdb • narwhals._duckdb.expr • narwhals._duckdb.utils • typing

imported by: narwhals._duckdb.expr

narwhals._duckdb.group_by SourceModule

imports: 'collections.abc' • __future__ • duckdb • itertools • narwhals._compliant • narwhals._duckdb • narwhals._duckdb.dataframe • narwhals._duckdb.expr • typing

imported by: narwhals._duckdb.dataframe

narwhals._duckdb.namespace SourceModule

imports: 'collections.abc' • 'duckdb.typing' • __future__ • duckdb • functools • itertools • narwhals._compliant • narwhals._duckdb • narwhals._duckdb.dataframe • narwhals._duckdb.expr • narwhals._duckdb.selectors • narwhals._duckdb.utils • narwhals._expression_parsing • narwhals._utils • narwhals.typing • operator • typing

imported by: narwhals._duckdb.dataframe • narwhals._duckdb.expr • narwhals._namespace

narwhals._duckdb.selectors SourceModule

imports: __future__ • duckdb • narwhals._compliant • narwhals._duckdb • narwhals._duckdb.dataframe • narwhals._duckdb.expr • typing

imported by: narwhals._duckdb.namespace

narwhals._duckdb.series SourceModule

imports: __future__ • duckdb • narwhals._duckdb • narwhals._duckdb.utils • narwhals._utils • narwhals.dependencies • narwhals.dtypes • types • typing • typing_extensions

imported by: narwhals._duckdb.dataframe

narwhals._duckdb.utils SourceModule

imports: 'duckdb.typing' • __future__ • duckdb • functools • narwhals._duckdb • narwhals._duckdb.dataframe • narwhals._duckdb.expr • narwhals._utils • narwhals.dtypes • narwhals.typing • typing

imported by: narwhals._duckdb.dataframe • narwhals._duckdb.expr • narwhals._duckdb.expr_dt • narwhals._duckdb.expr_str • narwhals._duckdb.expr_struct • narwhals._duckdb.namespace • narwhals._duckdb.series

narwhals._duration SourceModule

imports: __future__ • narwhals • re • typing • typing_extensions

imported by: narwhals._arrow.series_dt • narwhals._arrow.utils • narwhals._dask.expr_dt • narwhals._duckdb.expr_dt • narwhals._ibis.expr_dt • narwhals._ibis.utils • narwhals._pandas_like.series_dt • narwhals._polars.expr • narwhals._spark_like.expr_dt

narwhals._enum SourceModule

imports: __future__ • enum • narwhals • typing

imported by: narwhals._utils

narwhals._expression_parsing SourceModule

imports: 'collections.abc' • __future__ • enum • itertools • narwhals • narwhals._compliant • narwhals._compliant.typing • narwhals._utils • narwhals.dependencies • narwhals.exceptions • narwhals.expr • narwhals.series • narwhals.typing • typing • typing_extensions

imported by: narwhals._arrow.dataframe • narwhals._arrow.expr • narwhals._arrow.group_by • narwhals._arrow.namespace • narwhals._arrow.series • narwhals._compliant.expr • narwhals._dask.expr • narwhals._dask.group_by • narwhals._dask.namespace • narwhals._duckdb.expr • narwhals._duckdb.namespace • narwhals._ibis.expr • narwhals._ibis.namespace • narwhals._pandas_like.expr • narwhals._pandas_like.group_by • narwhals._pandas_like.namespace • narwhals._polars.expr • narwhals._spark_like.expr • narwhals._spark_like.namespace • narwhals.dataframe • narwhals.expr • narwhals.functions • narwhals.group_by • narwhals.selectors

narwhals._ibis Package

imports: narwhals

imported by: narwhals._ibis.dataframe • narwhals._ibis.expr • narwhals._ibis.expr_dt • narwhals._ibis.expr_list • narwhals._ibis.expr_str • narwhals._ibis.expr_struct • narwhals._ibis.group_by • narwhals._ibis.namespace • narwhals._ibis.selectors • narwhals._ibis.series • narwhals._ibis.utils

narwhals._ibis.dataframe SourceModule

imports: 'collections.abc' • 'ibis.expr' • 'ibis.selectors' • __future__ • ibis • narwhals._arrow.dataframe • narwhals._compliant.typing • narwhals._ibis • narwhals._ibis.expr • narwhals._ibis.group_by • narwhals._ibis.namespace • narwhals._ibis.series • narwhals._ibis.utils • narwhals._pandas_like.dataframe • narwhals._polars.dataframe • narwhals._utils • narwhals.dataframe • narwhals.dtypes • narwhals.exceptions • narwhals.stable.v1 • narwhals.typing • operator • pandas • polars • pyarrow • types • typing • typing_extensions

imported by: narwhals._ibis.expr • narwhals._ibis.group_by • narwhals._ibis.namespace • narwhals._ibis.selectors • narwhals._ibis.utils

narwhals._ibis.expr SourceModule

imports: 'collections.abc' • 'ibis.expr' • __future__ • functools • ibis • narwhals._compliant • narwhals._compliant.typing • narwhals._compliant.window • narwhals._expression_parsing • narwhals._ibis • narwhals._ibis.dataframe • narwhals._ibis.expr_dt • narwhals._ibis.expr_list • narwhals._ibis.expr_str • narwhals._ibis.expr_struct • narwhals._ibis.namespace • narwhals._ibis.utils • narwhals._utils • narwhals.typing • operator • typing • typing_extensions

imported by: narwhals._ibis.dataframe • narwhals._ibis.expr_dt • narwhals._ibis.expr_list • narwhals._ibis.expr_str • narwhals._ibis.expr_struct • narwhals._ibis.group_by • narwhals._ibis.namespace • narwhals._ibis.selectors • narwhals._ibis.utils

narwhals._ibis.expr_dt SourceModule

imports: 'ibis.expr' • __future__ • narwhals._duration • narwhals._ibis • narwhals._ibis.expr • narwhals._ibis.utils • narwhals._utils • typing

imported by: narwhals._ibis.expr

narwhals._ibis.expr_list SourceModule

imports: __future__ • narwhals._ibis • narwhals._ibis.expr • typing

imported by: narwhals._ibis.expr

narwhals._ibis.expr_str SourceModule

imports: 'ibis.expr' • __future__ • ibis • narwhals._ibis • narwhals._ibis.expr • narwhals._ibis.utils • narwhals._utils • typing

imported by: narwhals._ibis.expr

narwhals._ibis.expr_struct SourceModule

imports: 'ibis.expr' • __future__ • narwhals._ibis • narwhals._ibis.expr • typing

imported by: narwhals._ibis.expr

narwhals._ibis.group_by SourceModule

imports: 'collections.abc' • 'ibis.expr' • __future__ • narwhals._compliant • narwhals._ibis • narwhals._ibis.dataframe • narwhals._ibis.expr • typing

imported by: narwhals._ibis.dataframe

narwhals._ibis.namespace SourceModule

imports: 'collections.abc' • 'ibis.expr' • __future__ • functools • ibis • itertools • narwhals._compliant • narwhals._expression_parsing • narwhals._ibis • narwhals._ibis.dataframe • narwhals._ibis.expr • narwhals._ibis.selectors • narwhals._ibis.utils • narwhals._utils • narwhals.typing • operator • typing

imported by: narwhals._ibis.dataframe • narwhals._ibis.expr • narwhals._namespace

narwhals._ibis.selectors SourceModule

imports: 'ibis.expr' • __future__ • narwhals._compliant • narwhals._ibis • narwhals._ibis.dataframe • narwhals._ibis.expr • typing

imported by: narwhals._ibis.namespace

narwhals._ibis.series SourceModule

imports: __future__ • narwhals._ibis • narwhals._ibis.utils • narwhals._utils • narwhals.dependencies • narwhals.dtypes • types • typing • typing_extensions

imported by: narwhals._ibis.dataframe

narwhals._ibis.utils SourceModule

imports: 'collections.abc' • 'ibis.common' • 'ibis.expr' • __future__ • functools • ibis • narwhals._duration • narwhals._ibis • narwhals._ibis.dataframe • narwhals._ibis.expr • narwhals._utils • narwhals.dtypes • narwhals.typing • typing • typing_extensions

imported by: narwhals._ibis.dataframe • narwhals._ibis.expr • narwhals._ibis.expr_dt • narwhals._ibis.expr_str • narwhals._ibis.namespace • narwhals._ibis.series

narwhals._interchange Package

imports: narwhals

imported by: narwhals._interchange.dataframe • narwhals._interchange.series

narwhals._interchange.dataframe SourceModule

imports: 'pyarrow.interchange' • __future__ • enum • narwhals._interchange • narwhals._interchange.series • narwhals._utils • narwhals.dtypes • narwhals.typing • pandas • pyarrow • typing • typing_extensions

imported by: narwhals._interchange.series • narwhals.translate

narwhals._interchange.series SourceModule

imports: __future__ • narwhals._interchange • narwhals._interchange.dataframe • narwhals._utils • narwhals.dtypes • typing • typing_extensions

imported by: narwhals._interchange.dataframe • narwhals._utils

narwhals._namespace SourceModule

imports: 'pyspark.sql' • __future__ • duckdb • narwhals • narwhals._arrow.namespace • narwhals._compliant.typing • narwhals._dask.namespace • narwhals._duckdb.namespace • narwhals._ibis.namespace • narwhals._pandas_like.namespace • narwhals._polars.namespace • narwhals._spark_like.dataframe • narwhals._spark_like.namespace • narwhals._utils • narwhals.dependencies • narwhals.typing • pandas • polars • pyarrow • types • typing • typing_extensions

imported by: narwhals._pandas_like.typing • narwhals._spark_like.dataframe • narwhals._utils • narwhals.stable.v1._namespace • narwhals.translate

narwhals._pandas_like Package

imports: narwhals

imported by: narwhals._pandas_like.dataframe • narwhals._pandas_like.expr • narwhals._pandas_like.group_by • narwhals._pandas_like.namespace • narwhals._pandas_like.selectors • narwhals._pandas_like.series • narwhals._pandas_like.series_cat • narwhals._pandas_like.series_dt • narwhals._pandas_like.series_list • narwhals._pandas_like.series_str • narwhals._pandas_like.series_struct • narwhals._pandas_like.typing • narwhals._pandas_like.utils

narwhals._pandas_like.dataframe SourceModule

imports: 'collections.abc' • 'dask.dataframe' • 'modin.pandas' • __future__ • cupy • dask • duckdb • io • itertools • narwhals._arrow.dataframe • narwhals._compliant • narwhals._compliant.typing • narwhals._dask.dataframe • narwhals._duckdb.dataframe • narwhals._pandas_like • narwhals._pandas_like.expr • narwhals._pandas_like.group_by • narwhals._pandas_like.namespace • narwhals._pandas_like.series • narwhals._pandas_like.utils • narwhals._polars.dataframe • narwhals._translate • narwhals._utils • narwhals.dependencies • narwhals.dtypes • narwhals.exceptions • narwhals.schema • narwhals.typing • narwhals.utils • numpy • pandas • pathlib • polars • pyarrow • types • typing • typing_extensions

imported by: narwhals._arrow.dataframe • narwhals._dask.dataframe • narwhals._duckdb.dataframe • narwhals._ibis.dataframe • narwhals._pandas_like.expr • narwhals._pandas_like.group_by • narwhals._pandas_like.namespace • narwhals._pandas_like.selectors • narwhals._pandas_like.series • narwhals._polars.dataframe • narwhals._spark_like.dataframe • narwhals._utils

narwhals._pandas_like.expr SourceModule

imports: 'collections.abc' • __future__ • narwhals._compliant • narwhals._compliant.typing • narwhals._expression_parsing • narwhals._pandas_like • narwhals._pandas_like.dataframe • narwhals._pandas_like.group_by • narwhals._pandas_like.namespace • narwhals._pandas_like.series • narwhals._utils • narwhals.typing • typing • typing_extensions

imported by: narwhals._pandas_like.dataframe • narwhals._pandas_like.group_by • narwhals._pandas_like.namespace • narwhals._pandas_like.selectors • narwhals._pandas_like.typing • narwhals._pandas_like.utils

narwhals._pandas_like.group_by SourceModule

imports: 'collections.abc' • __future__ • collections • narwhals._compliant • narwhals._compliant.group_by • narwhals._expression_parsing • narwhals._pandas_like • narwhals._pandas_like.dataframe • narwhals._pandas_like.expr • narwhals._pandas_like.utils • narwhals._utils • typing • warnings

imported by: narwhals._dask.expr • narwhals._pandas_like.dataframe • narwhals._pandas_like.expr

narwhals._pandas_like.namespace SourceModule

imports: 'collections.abc' • __future__ • functools • itertools • narwhals._compliant • narwhals._expression_parsing • narwhals._pandas_like • narwhals._pandas_like.dataframe • narwhals._pandas_like.expr • narwhals._pandas_like.selectors • narwhals._pandas_like.series • narwhals._pandas_like.typing • narwhals._utils • narwhals.typing • operator • typing • typing_extensions • warnings

imported by: narwhals._namespace • narwhals._pandas_like.dataframe • narwhals._pandas_like.expr • narwhals._pandas_like.series

narwhals._pandas_like.selectors SourceModule

imports: __future__ • narwhals._compliant • narwhals._pandas_like • narwhals._pandas_like.dataframe • narwhals._pandas_like.expr • narwhals._pandas_like.series • typing

imported by: narwhals._pandas_like.namespace

narwhals._pandas_like.series SourceModule

imports: 'collections.abc' • 'pyarrow.compute' • __future__ • cupy • narwhals._arrow.typing • narwhals._arrow.utils • narwhals._compliant • narwhals._pandas_like • narwhals._pandas_like.dataframe • narwhals._pandas_like.namespace • narwhals._pandas_like.series_cat • narwhals._pandas_like.series_dt • narwhals._pandas_like.series_list • narwhals._pandas_like.series_str • narwhals._pandas_like.series_struct • narwhals._pandas_like.utils • narwhals._utils • narwhals.dependencies • narwhals.dtypes • narwhals.exceptions • narwhals.typing • numpy • pandas • polars • pyarrow • types • typing • typing_extensions

imported by: narwhals._pandas_like.dataframe • narwhals._pandas_like.expr • narwhals._pandas_like.namespace • narwhals._pandas_like.selectors • narwhals._pandas_like.series_cat • narwhals._pandas_like.series_dt • narwhals._pandas_like.series_list • narwhals._pandas_like.series_str • narwhals._pandas_like.series_struct • narwhals._pandas_like.typing • narwhals._pandas_like.utils • narwhals._utils

narwhals._pandas_like.series_cat SourceModule

imports: __future__ • narwhals._compliant.any_namespace • narwhals._pandas_like • narwhals._pandas_like.series • narwhals._pandas_like.utils • typing

imported by: narwhals._pandas_like.series

narwhals._pandas_like.series_dt SourceModule

imports: 'pyarrow.compute' • __future__ • narwhals._arrow.utils • narwhals._compliant.any_namespace • narwhals._duration • narwhals._pandas_like • narwhals._pandas_like.series • narwhals._pandas_like.utils • narwhals.typing • typing

imported by: narwhals._pandas_like.series

narwhals._pandas_like.series_list SourceModule

imports: __future__ • narwhals._compliant.any_namespace • narwhals._pandas_like • narwhals._pandas_like.series • narwhals._pandas_like.utils • typing

imported by: narwhals._pandas_like.series

narwhals._pandas_like.series_str SourceModule

imports: __future__ • narwhals._compliant.any_namespace • narwhals._pandas_like • narwhals._pandas_like.series • narwhals._pandas_like.utils • typing

imported by: narwhals._pandas_like.series

narwhals._pandas_like.series_struct SourceModule

imports: __future__ • narwhals._compliant.any_namespace • narwhals._pandas_like • narwhals._pandas_like.series • narwhals._pandas_like.utils • typing

imported by: narwhals._pandas_like.series

narwhals._pandas_like.typing SourceModule

imports: __future__ • narwhals._namespace • narwhals._pandas_like • narwhals._pandas_like.expr • narwhals._pandas_like.series • narwhals._typing_compat • pandas • typing • typing_extensions

imported by: narwhals._pandas_like.namespace

narwhals._pandas_like.utils SourceModule

imports: 'collections.abc' • __future__ • collections • contextlib • functools • narwhals._arrow.utils • narwhals._compliant.series • narwhals._pandas_like • narwhals._pandas_like.expr • narwhals._pandas_like.series • narwhals._utils • narwhals.dtypes • narwhals.exceptions • narwhals.typing • pandas • pandas._typing • pyarrow • re • typing

imported by: narwhals._dask.dataframe • narwhals._dask.expr • narwhals._dask.expr_dt • narwhals._dask.utils • narwhals._pandas_like.dataframe • narwhals._pandas_like.group_by • narwhals._pandas_like.series • narwhals._pandas_like.series_cat • narwhals._pandas_like.series_dt • narwhals._pandas_like.series_list • narwhals._pandas_like.series_str • narwhals._pandas_like.series_struct • narwhals._utils • narwhals.schema

narwhals._polars Package

imports: narwhals

imported by: narwhals._polars.dataframe • narwhals._polars.expr • narwhals._polars.group_by • narwhals._polars.namespace • narwhals._polars.series • narwhals._polars.typing • narwhals._polars.utils

narwhals._polars.dataframe SourceModule

imports: 'collections.abc' • 'dask.dataframe' • __future__ • dask • duckdb • narwhals._arrow.dataframe • narwhals._compliant.typing • narwhals._dask.dataframe • narwhals._duckdb.dataframe • narwhals._pandas_like.dataframe • narwhals._polars • narwhals._polars.expr • narwhals._polars.group_by • narwhals._polars.namespace • narwhals._polars.series • narwhals._polars.utils • narwhals._translate • narwhals._utils • narwhals.dataframe • narwhals.dependencies • narwhals.dtypes • narwhals.exceptions • narwhals.schema • narwhals.typing • pandas • polars • pyarrow • types • typing • typing_extensions

imported by: narwhals._arrow.dataframe • narwhals._dask.dataframe • narwhals._duckdb.dataframe • narwhals._ibis.dataframe • narwhals._pandas_like.dataframe • narwhals._polars.expr • narwhals._polars.group_by • narwhals._polars.namespace • narwhals._polars.series • narwhals._polars.typing • narwhals._polars.utils • narwhals._spark_like.dataframe

narwhals._polars.expr SourceModule

imports: 'collections.abc' • __future__ • narwhals._duration • narwhals._expression_parsing • narwhals._polars • narwhals._polars.dataframe • narwhals._polars.namespace • narwhals._polars.utils • narwhals._utils • narwhals.typing • polars • typing • typing_extensions

imported by: narwhals._polars.dataframe • narwhals._polars.group_by • narwhals._polars.namespace • narwhals._polars.series • narwhals._polars.typing • narwhals._polars.utils

narwhals._polars.group_by SourceModule

imports: 'collections.abc' • 'polars.dataframe' • 'polars.lazyframe' • __future__ • narwhals._polars • narwhals._polars.dataframe • narwhals._polars.expr • narwhals._utils • typing

imported by: narwhals._polars.dataframe

narwhals._polars.namespace SourceModule

imports: 'collections.abc' • __future__ • datetime • narwhals._compliant • narwhals._polars • narwhals._polars.dataframe • narwhals._polars.expr • narwhals._polars.series • narwhals._polars.typing • narwhals._polars.utils • narwhals._utils • narwhals.dependencies • narwhals.dtypes • narwhals.schema • narwhals.typing • operator • polars • typing

imported by: narwhals._namespace • narwhals._polars.dataframe • narwhals._polars.expr • narwhals._polars.series

narwhals._polars.series SourceModule

imports: 'collections.abc' • __future__ • narwhals._polars • narwhals._polars.dataframe • narwhals._polars.expr • narwhals._polars.namespace • narwhals._polars.utils • narwhals._utils • narwhals.dependencies • narwhals.dtypes • narwhals.exceptions • narwhals.series • narwhals.typing • pandas • polars • pyarrow • types • typing • typing_extensions

imported by: narwhals._polars.dataframe • narwhals._polars.namespace • narwhals._polars.typing • narwhals._polars.utils

narwhals._polars.typing SourceModule

imports: __future__ • narwhals._polars • narwhals._polars.dataframe • narwhals._polars.expr • narwhals._polars.series • sys • typing • typing_extensions

imported by: narwhals._polars.namespace

narwhals._polars.utils SourceModule

imports: 'collections.abc' • __future__ • functools • narwhals._polars • narwhals._polars.dataframe • narwhals._polars.expr • narwhals._polars.series • narwhals._utils • narwhals.dtypes • narwhals.exceptions • narwhals.typing • polars • typing • typing_extensions

imported by: narwhals._polars.dataframe • narwhals._polars.expr • narwhals._polars.namespace • narwhals._polars.series • narwhals.schema

narwhals._spark_like Package

imports: narwhals

imported by: narwhals._spark_like.dataframe • narwhals._spark_like.expr • narwhals._spark_like.expr_dt • narwhals._spark_like.expr_list • narwhals._spark_like.expr_str • narwhals._spark_like.expr_struct • narwhals._spark_like.group_by • narwhals._spark_like.namespace • narwhals._spark_like.selectors • narwhals._spark_like.utils

narwhals._spark_like.dataframe SourceModule

imports: 'collections.abc' • 'sqlframe.base' • __future__ • functools • narwhals._arrow.dataframe • narwhals._arrow.utils • narwhals._compliant.typing • narwhals._namespace • narwhals._pandas_like.dataframe • narwhals._polars.dataframe • narwhals._spark_like • narwhals._spark_like.expr • narwhals._spark_like.group_by • narwhals._spark_like.namespace • narwhals._spark_like.utils • narwhals._utils • narwhals.dataframe • narwhals.dtypes • narwhals.exceptions • narwhals.typing • operator • pandas • polars • pyarrow • types • typing • typing_extensions • warnings

imported by: narwhals._namespace • narwhals._spark_like.expr • narwhals._spark_like.expr_dt • narwhals._spark_like.group_by • narwhals._spark_like.namespace • narwhals._spark_like.selectors • narwhals._spark_like.utils • narwhals.dependencies

narwhals._spark_like.expr SourceModule

imports: 'collections.abc' • 'sqlframe.base' • __future__ • narwhals._compliant • narwhals._compliant.typing • narwhals._compliant.window • narwhals._expression_parsing • narwhals._spark_like • narwhals._spark_like.dataframe • narwhals._spark_like.expr_dt • narwhals._spark_like.expr_list • narwhals._spark_like.expr_str • narwhals._spark_like.expr_struct • narwhals._spark_like.namespace • narwhals._spark_like.utils • narwhals._utils • narwhals.dependencies • narwhals.typing • operator • typing • typing_extensions

imported by: narwhals._spark_like.dataframe • narwhals._spark_like.expr_dt • narwhals._spark_like.expr_list • narwhals._spark_like.expr_str • narwhals._spark_like.expr_struct • narwhals._spark_like.group_by • narwhals._spark_like.namespace • narwhals._spark_like.selectors • narwhals._spark_like.utils

narwhals._spark_like.expr_dt SourceModule

imports: 'collections.abc' • 'sqlframe.base' • __future__ • narwhals._duration • narwhals._spark_like • narwhals._spark_like.dataframe • narwhals._spark_like.expr • narwhals._spark_like.utils • re • typing

imported by: narwhals._spark_like.expr

narwhals._spark_like.expr_list SourceModule

imports: __future__ • narwhals._spark_like • narwhals._spark_like.expr • typing

imported by: narwhals._spark_like.expr

narwhals._spark_like.expr_str SourceModule

imports: 'sqlframe.base' • __future__ • functools • narwhals._spark_like • narwhals._spark_like.expr • narwhals._spark_like.utils • narwhals._utils • string • typing

imported by: narwhals._spark_like.expr

narwhals._spark_like.expr_struct SourceModule

imports: 'sqlframe.base' • __future__ • narwhals._spark_like • narwhals._spark_like.expr • typing

imported by: narwhals._spark_like.expr

narwhals._spark_like.group_by SourceModule

imports: 'collections.abc' • 'sqlframe.base' • __future__ • narwhals._compliant • narwhals._spark_like • narwhals._spark_like.dataframe • narwhals._spark_like.expr • typing

imported by: narwhals._spark_like.dataframe

narwhals._spark_like.namespace SourceModule

imports: 'collections.abc' • 'sqlframe.base' • __future__ • functools • narwhals._compliant • narwhals._expression_parsing • narwhals._spark_like • narwhals._spark_like.dataframe • narwhals._spark_like.expr • narwhals._spark_like.selectors • narwhals._spark_like.utils • narwhals._utils • narwhals.typing • operator • typing

imported by: narwhals._namespace • narwhals._spark_like.dataframe • narwhals._spark_like.expr

narwhals._spark_like.selectors SourceModule

imports: 'sqlframe.base' • __future__ • narwhals._compliant • narwhals._spark_like • narwhals._spark_like.dataframe • narwhals._spark_like.expr • typing

imported by: narwhals._spark_like.namespace

narwhals._spark_like.utils SourceModule

imports: 'pyspark.sql' • 'sqlframe.base' • __future__ • functools • importlib • narwhals._spark_like • narwhals._spark_like.dataframe • narwhals._spark_like.expr • narwhals._utils • narwhals.dtypes • narwhals.exceptions • narwhals.typing • types • typing • typing_extensions

imported by: narwhals._spark_like.dataframe • narwhals._spark_like.expr • narwhals._spark_like.expr_dt • narwhals._spark_like.expr_str • narwhals._spark_like.namespace

narwhals._translate SourceModule

imports: 'collections.abc' • __future__ • narwhals • narwhals._typing_compat • pyarrow • typing • typing_extensions

imported by: narwhals._arrow.dataframe • narwhals._compliant.dataframe • narwhals._compliant.series • narwhals._pandas_like.dataframe • narwhals._polars.dataframe • narwhals._utils • narwhals.functions • narwhals.stable.v1

narwhals._typing_compat SourceModule

imports: __future__ • narwhals • sys • typing • typing_extensions • warnings

imported by: narwhals._compliant.dataframe • narwhals._compliant.expr • narwhals._compliant.group_by • narwhals._compliant.selectors • narwhals._compliant.when_then • narwhals._pandas_like.typing • narwhals._translate • narwhals._utils • narwhals.functions • narwhals.stable.v1

narwhals._utils SourceModule

imports: 'collections.abc' • __future__ • collections • dask • datetime • enum • functools • importlib • importlib.util • inspect • narwhals • narwhals._arrow.namespace • narwhals._arrow.utils • narwhals._compliant • narwhals._compliant.typing • narwhals._enum • narwhals._interchange.series • narwhals._namespace • narwhals._pandas_like.dataframe • narwhals._pandas_like.series • narwhals._pandas_like.utils • narwhals._translate • narwhals._typing_compat • narwhals.dataframe • narwhals.dependencies • narwhals.dtypes • narwhals.exceptions • narwhals.series • narwhals.stable.v1 • narwhals.stable.v1._namespace • narwhals.stable.v1.dtypes • narwhals.translate • narwhals.typing • os • pandas • pathlib • polars • pyarrow • pyspark • re • secrets • sqlframe • types • typing • typing_extensions • warnings

imported by: narwhals • narwhals._arrow.dataframe • narwhals._arrow.expr • narwhals._arrow.group_by • narwhals._arrow.namespace • narwhals._arrow.series • narwhals._arrow.utils • narwhals._compliant.any_namespace • narwhals._compliant.dataframe • narwhals._compliant.expr • narwhals._compliant.group_by • narwhals._compliant.namespace • narwhals._compliant.selectors • narwhals._compliant.series • narwhals._compliant.when_then • narwhals._dask.dataframe • narwhals._dask.expr • narwhals._dask.expr_dt • narwhals._dask.namespace • narwhals._dask.utils • narwhals._duckdb.dataframe • narwhals._duckdb.expr • narwhals._duckdb.expr_dt • narwhals._duckdb.expr_str • narwhals._duckdb.namespace • narwhals._duckdb.series • narwhals._duckdb.utils • narwhals._expression_parsing • narwhals._ibis.dataframe • narwhals._ibis.expr • narwhals._ibis.expr_dt • narwhals._ibis.expr_str • narwhals._ibis.namespace • narwhals._ibis.series • narwhals._ibis.utils • narwhals._interchange.dataframe • narwhals._interchange.series • narwhals._namespace • narwhals._pandas_like.dataframe • narwhals._pandas_like.expr • narwhals._pandas_like.group_by • narwhals._pandas_like.namespace • narwhals._pandas_like.series • narwhals._pandas_like.utils • narwhals._polars.dataframe • narwhals._polars.expr • narwhals._polars.group_by • narwhals._polars.namespace • narwhals._polars.series • narwhals._polars.utils • narwhals._spark_like.dataframe • narwhals._spark_like.expr • narwhals._spark_like.expr_str • narwhals._spark_like.namespace • narwhals._spark_like.utils • narwhals.dataframe • narwhals.dtypes • narwhals.expr • narwhals.functions • narwhals.group_by • narwhals.schema • narwhals.selectors • narwhals.series • narwhals.stable.v1 • narwhals.stable.v1._dtypes • narwhals.stable.v1._namespace • narwhals.translate • narwhals.utils

narwhals.dataframe SourceModule

imports: 'collections.abc' • __future__ • abc • io • itertools • narwhals • narwhals._compliant • narwhals._compliant.typing • narwhals._expression_parsing • narwhals._utils • narwhals.dependencies • narwhals.exceptions • narwhals.expr • narwhals.functions • narwhals.group_by • narwhals.schema • narwhals.series • narwhals.translate • narwhals.typing • pandas • pathlib • polars • pyarrow • types • typing • typing_extensions • warnings

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
