baumann06/Diplomarbeit_Sicherung_Privat/Diplomarbeit/9_Datenblaetter/09_WJ2EDGK-5-08-XXP-1YY-00A.pdf

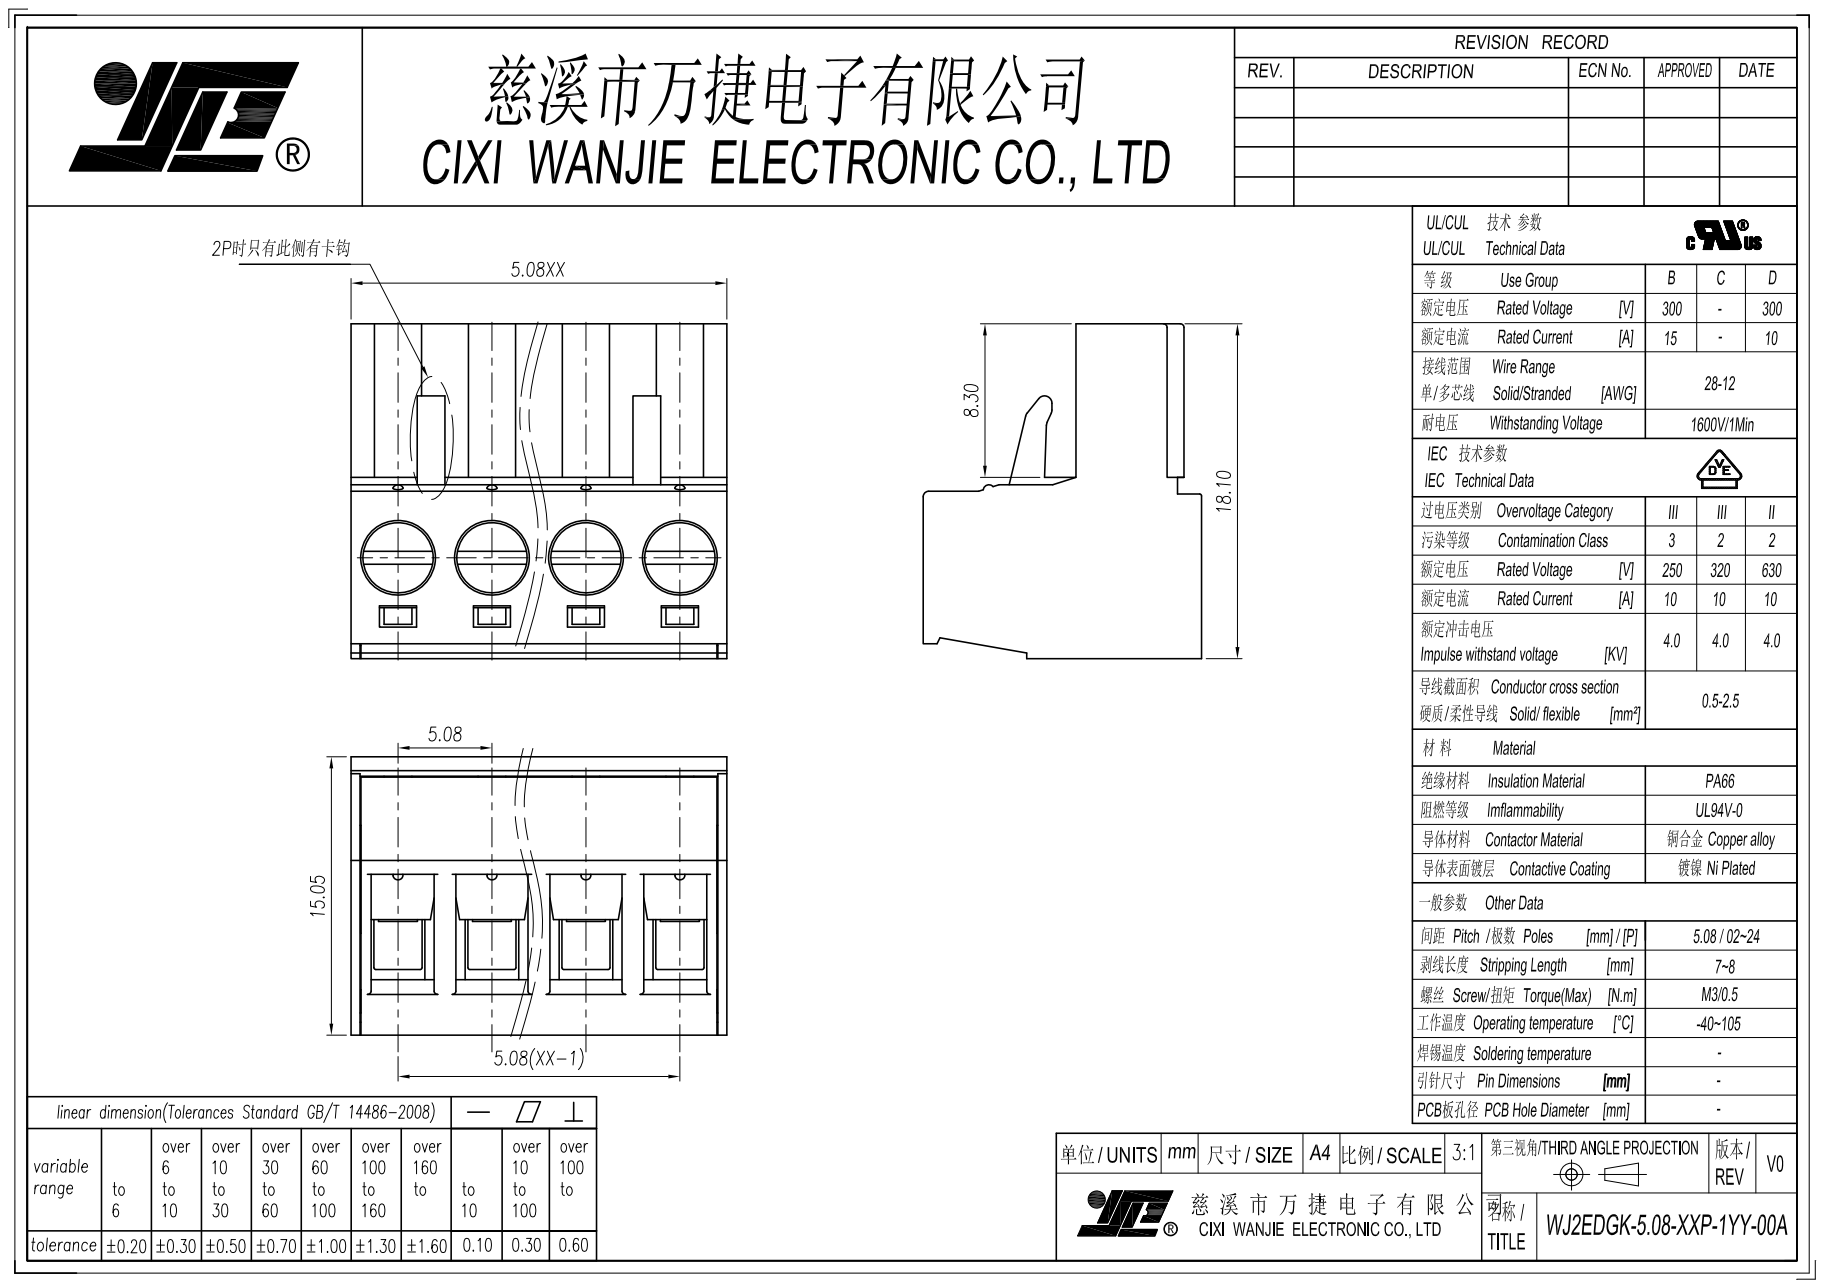
[picture p37: page 1]
