baumann06/Diplomarbeit_Sicherung_Privat/(commit log)

2026-01-08 Struktur und Schreiben
    [Einkaufsliste.xlsx, Komponenten_0.xlsx, Komponentenliste.xlsx]
2026-01-20 Überarbeitung
    Kapitel 4.1 und 4.2
2026-01-30 Aufgaben Sponsor
    Buchsen Auswahl
    Überlegungen Spannungen, Abstände
    [Buchsen.xlsx]
2026-02-06 Kapitel 4.2
    [Komponentenliste.xlsx]
2026-02-18 K4.9 und K4.6
2026-02-22 Ueberarbeitet und kontrolliert
2026-02-23 K4.8 und K4.9
